Madina1219/ConnectGuinea/docs/Madina Diallo CE Exhibition Text.docx

CE Exhibition Text

Name: Madina Diallo

Project Title: Smart Solar Community Totem: (Lighting and Flood Communication for Rural Guinea)

The Smart Solar Community Totem is a solar-powered light designed for communities in Guinea, West Africa, who often lack reliable power or internet. During the day, a solar panel charges a battery. At night, a light sensor switches the totem on automatically. It also listens for flood warnings sent over long-range radio, no internet needed, and changes colour to signal different conditions: white for normal lighting, and a flashing blue alert if flood risk is detected. The project explores how simple, connected technology can support safety and daily life in remote communities.

Attributions

- MSc Connected Environments, The Bartlett Centre for Advanced Spatial Analysis (CASA), UCL
- Dissertation Supervisor: Duncan Wilson
- Technical support: CE Lab, University College London
- Project developed as part of the MSc Connected Environments programme

QR code:

Work in progress

Keywords (for referencing/promotion):

- Smart Cities
- Connected Environments
- Solar Energy
- Off-Grid Communities
- Flood Warning Systems
- LoRa Communication
- Community Resilience
- Ambient Interfaces
- Human-Centred Design
- Sustainable Infrastructure
