Madina1219/ConnectGuinea/docs/Smart Street Guinea Reference List.odt

Smart Street Guinea Reference List

- https://www.mdpi.com/1424-8220/25/17/5579
- https://www.smartbrighten.com/news/how-the-solar-smart-street-light-improves-the-old-city-district-infrastructure/
- https://www.dusuniot.com/blog/how-to-using-iot-in-smart-lighting/
- https://iot.tatacommunications.com/product/Smart-Light-Controller
- https://www.bimblesolar.com/solar/small-panels
- LoRaWAN® Weather Station | Solar-powered IoT Weather Station | Milesight (https://www.milesight.com/iot/product/lorawan-sensor/wts506?hsa_acc=8292105947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)
- https://www.decentlab.com/products/tipping-bucket-rain-gauge-for-lorawan
- https://envira.global/flood-monitoring-warning-system/
