Madina1219/ConnectGuinea/docs/SmartStreet Guinea Project Narrative.pdf

## Smart Guinea Solar Community Lampost:

Project narrative
In many parts of Guinea, especially informal settlements and rural communities, darkness is still part of daily life after sunset. Many streets are not connected to a reliable grid, and families often depend on torchlights, candles, or oil lamps, which are costly, unsafe, and sometimes deadly because they can cause fires and accidents. At the same time, recent floods in Guinea have shown how quickly heavy rainfall can destroy homes, displace families, flood health facilities, and disrupt everyday life. This project responds to both problems at once:
1. the need for safe light
2. the need for clear weather warning.
The idea is a smart solar streetlight totem that works as more than a lamp. It gives light to the community, but it also becomes a weather awareness point, a social meeting place, a nighttime economy enabler, and a public environmental communicator. Because many communities are off-grid or underserved by stable electricity, solar is the most practical option: it avoids the high cost and complexity of grid extension while reducing dependence on wires, fuel, and inconsistent power supply. In this setting, the light itself is a basic public service, but the totem makes that service visible, shared, and meaningful.
The place and the problem
The project is meant for communities where people already live with unstable or absent electricity, where streets go dark for hours, and where public safety drops sharply at night. In these places, the streetlight is not just infrastructure; it becomes a point of life in the neighbourhood, where people can walk safely, wait for transport, talk, trade, or gather. Guinea’s recent flood events make the need even clearer: heavy rainfall has already caused severe damage in Siguiri and Conakry, affecting tens of thousands of people and destroying homes and services.
The weather problem is not only that rain falls; it is that people often do not receive timely, easyto-understand warnings. When flooding risk rises, many households have little visual communication to tell them what is coming or what to do next. That means people can be caught unprepared, delay evacuation, protect property too late, or move through dangerous flooded areas. A streetlight totem can fill that gap by turning weather information into something people see, hear, and act on immediately.
Meaning of the totem
The totem represents shared protection. It is a familiar object, placed in a place people already pass through, gather around, and trust. For the community, it means safe light at night, but it also means information, caution, and connection. In a cultural sense, it fits how people already use public space in African communities: as a place for conversation, informal meetings, children’s play, board games, transport waiting points, women’s group meetings, announcements, and small evening trade.
Because the totem is solar-powered, it keeps working even when the grid is down. That matters in Guinea, where many households still spend long hours in darkness and rely on unsafe lighting alternatives. The solar system also helps reduce operating costs and maintenance issues associated with conventional street lighting. In simple terms, it is a light that does not wait for the grid before helping the community.

Weather awareness function
The totem can carry a weather awareness system that uses light and sound to communicate heavy rainfall, flood risk, and urgency. For example, normal white light can indicate safe conditions, flashing amber can indicate caution, and red flashing with a sound alert can warn of dangerous rainfall or potential flooding. This makes the warning easy to understand even for people who may not read a text message or who are outside when the weather changes.
This matters because flood damage in Guinea has been severe and widespread, affecting neighbourhoods, households, and health facilities. A public warning system mounted on a streetlight can help people make faster decisions: moving vehicles, protecting goods, avoiding low-lying paths, checking on children, and preparing to evacuate if needed. It turns weather data into action at the community level.
Community value
A smart solar streetlight totem does not only serve emergencies. It can become the center of evening life: a place where people meet, vendors stay open longer, phone charging may be available, local notices can be shared, and children can play safely under light. For women’s groups, neighbourhood associations, and youth activities, it can create a reliable meeting point that does not depend on household electricity. That is important because light changes how a community uses space after dark.
It also supports the night economy. When a street is lit, small businesses can stay open longer, transport becomes easier to manage, and customers feel safer moving around. In this way, the totem is not only a utility object; it is a local economic asset and a sign that the community is seen, valued, and protected.
Closing idea
This project is about turning one point of light into many forms of support. It provides safety, gathering space, local economy, and clear weather communication in one place. In Guinea, where flooding risk is real and electricity remains unreliable in many areas, a smart solar streetlight totem can help communities live with more dignity, more safety, and more readiness. It is a simple idea with a powerful meaning: light that protects, informs, and brings people together.
