Madina1219/ConnectGuinea/Dissertation Support and Additional Information/Design/Figure 3.1-Overall system architecture of the Smart Community Totem.png

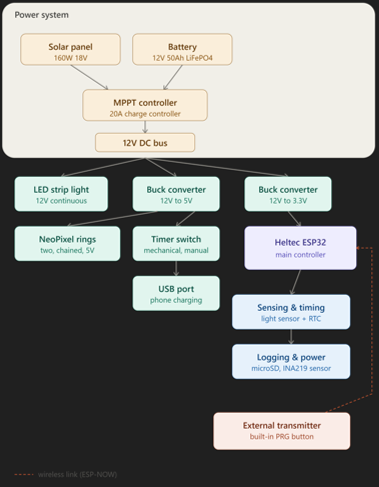
Dissertation Support and Additional Information/Design/Figure 3.1-Overall system architecture of the Smart Community Totem.png
