Madina1219/ConnectGuinea/Dissertation Support and Additional Information/Design/Figure 3.3-Prototype ESP-NOW communication architecture.png

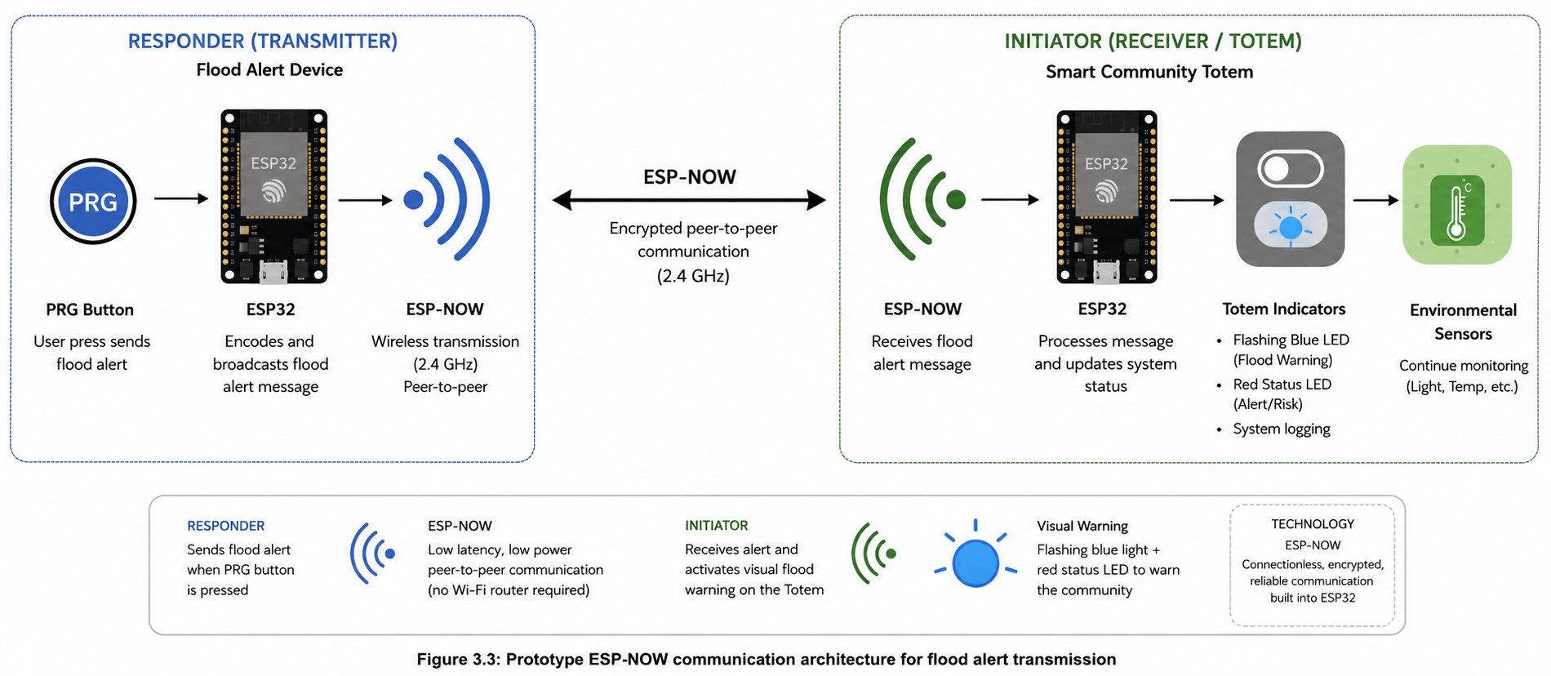
Dissertation Support and Additional Information/Design/Figure 3.3-Prototype ESP-NOW communication architecture.png
