Madina1219/ConnectGuinea/Dissertation Support and Additional Information/Design/Figure 3.4-Conceptual future communication architecture showing how flood warnings generated by meteorological and environmental monitor.png

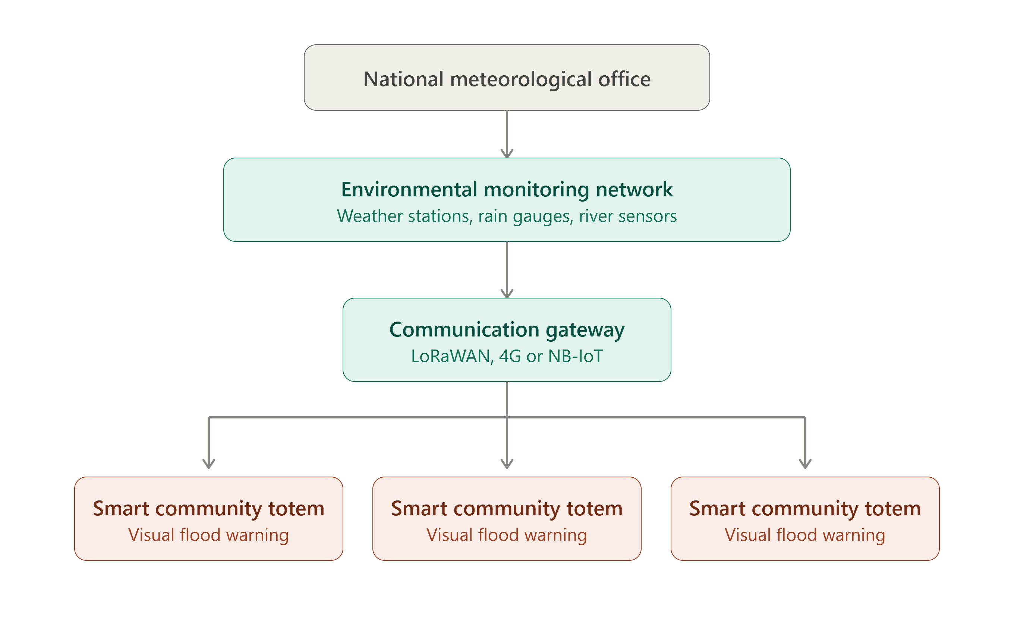
Dissertation Support and Additional Information/Design/Figure 3.4-Conceptual future communication architecture showing how flood warnings generated by meteorological and environmental monitor.png
