Madina1219/ConnectGuinea/Dissertation Support and Additional Information/Design/Figure 3.5-Electrical schematic of the Smart Community Totem.png

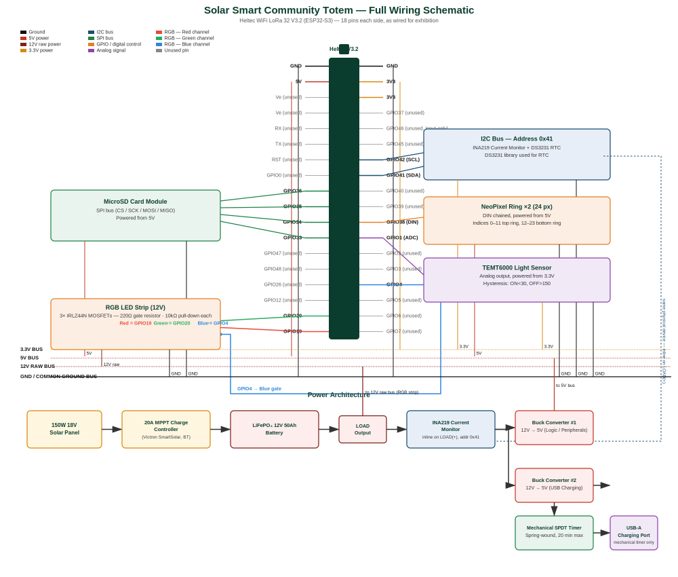
Dissertation Support and Additional Information/Design/Figure 3.5-Electrical schematic of the Smart Community Totem.png
