Madina1219/ConnectGuinea/Dissertation Support and Additional Information/Design/Table 3.1-Design requirements and corresponding implementation.png

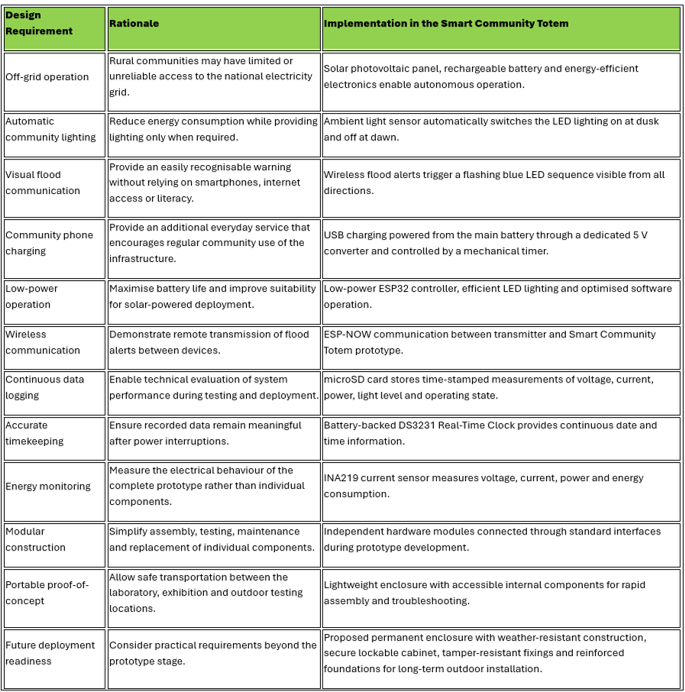
Dissertation Support and Additional Information/Design/Table 3.1-Design requirements and corresponding implementation.png
