Madina1219/ConnectGuinea/Dissertation Support and Additional Information/Design/Table 3.2-Energy Monitoring and Data Collection.png

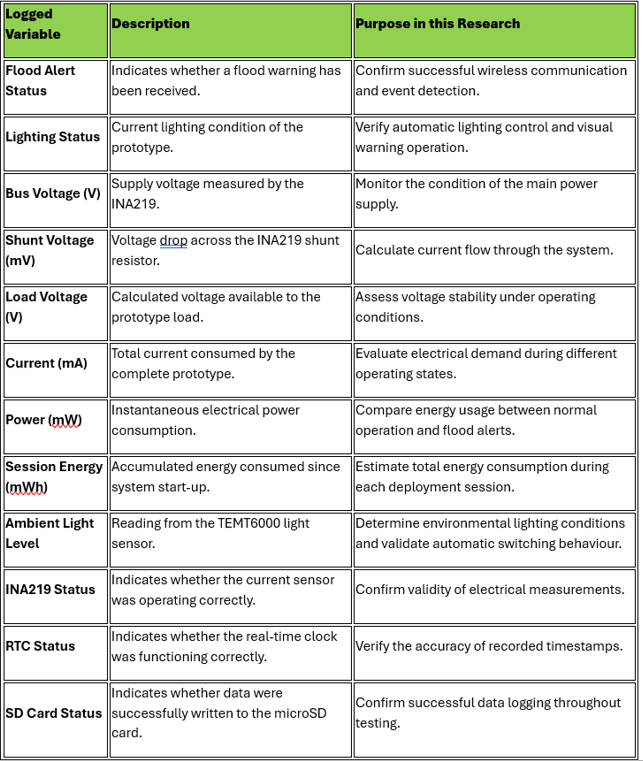
Dissertation Support and Additional Information/Design/Table 3.2-Energy Monitoring and Data Collection.png
