Madina1219/ConnectGuinea/Dissertation Support and Additional Information/Implementation/2 Locations Comparision Summary.png

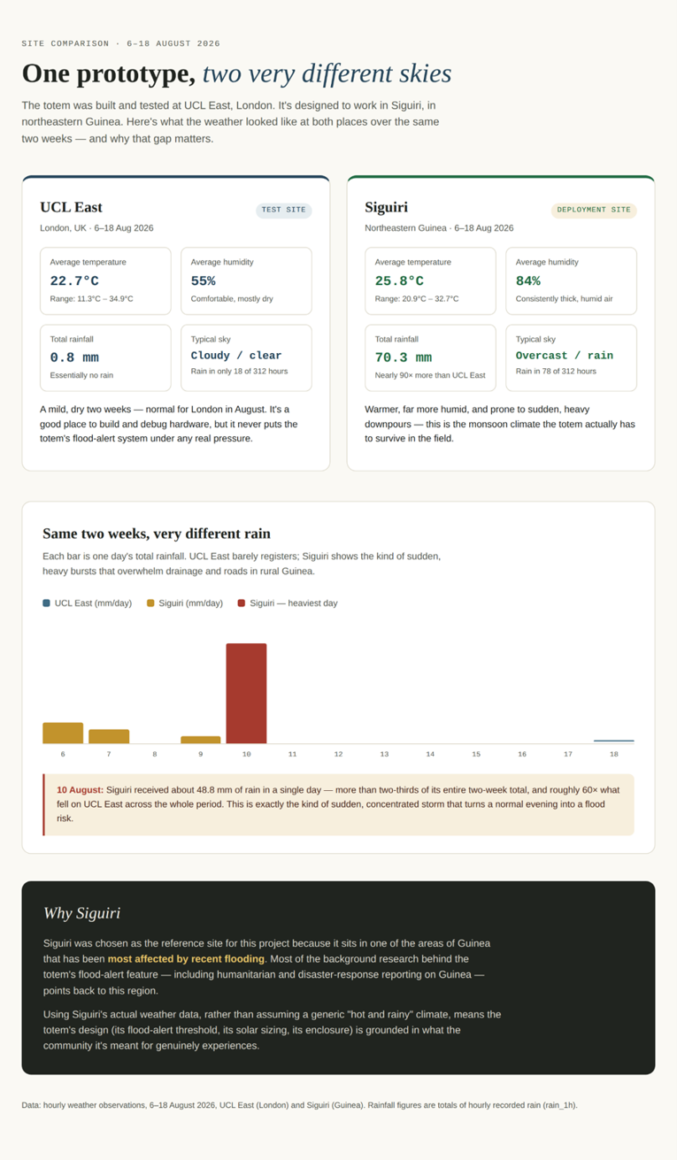
Dissertation Support and Additional Information/Implementation/2 Locations Comparision Summary.png
