Madina1219/ConnectGuinea/Dissertation Support and Additional Information/Implementation/Figure 4.1-Completed Smart Community Totem prototype.png

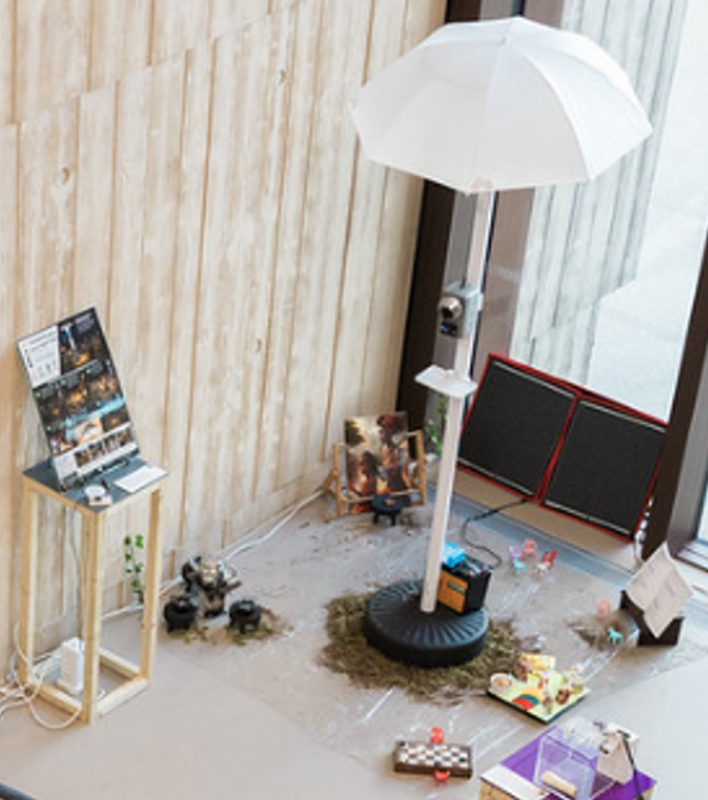
Dissertation Support and Additional Information/Implementation/Figure 4.1-Completed Smart Community Totem prototype.png
