Madina1219/ConnectGuinea/Dissertation Support and Additional Information/Implementation/Final Prototype 2.png

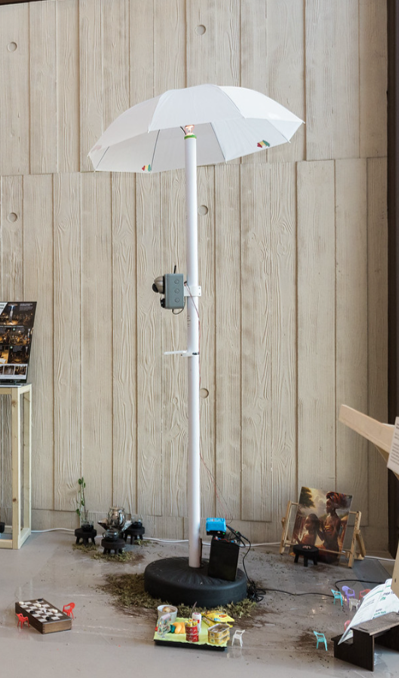
Dissertation Support and Additional Information/Implementation/Final Prototype 2.png
