Madina1219/ConnectGuinea/Dissertation Support and Additional Information/Implementation/Totem Software Detailed Flowchart.png

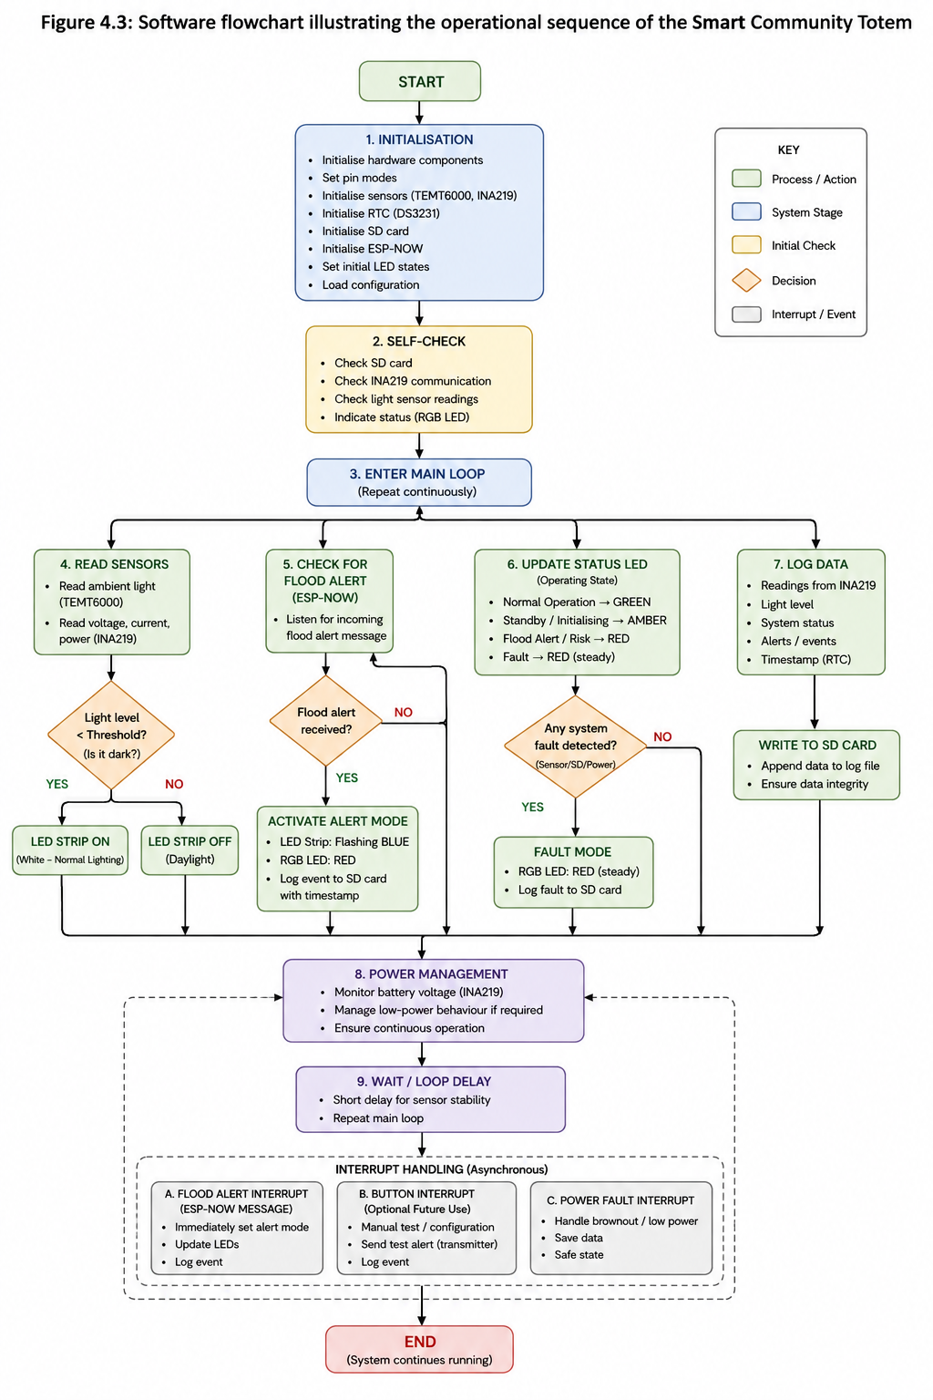
Dissertation Support and Additional Information/Implementation/Totem Software Detailed Flowchart.png
