Madina1219/ConnectGuinea/Dissertation Support and Additional Information/Introduction/Figure 1.1-National Context of Guinea Showing Regional Electricity Access and Flood-Prone Areas..jpg

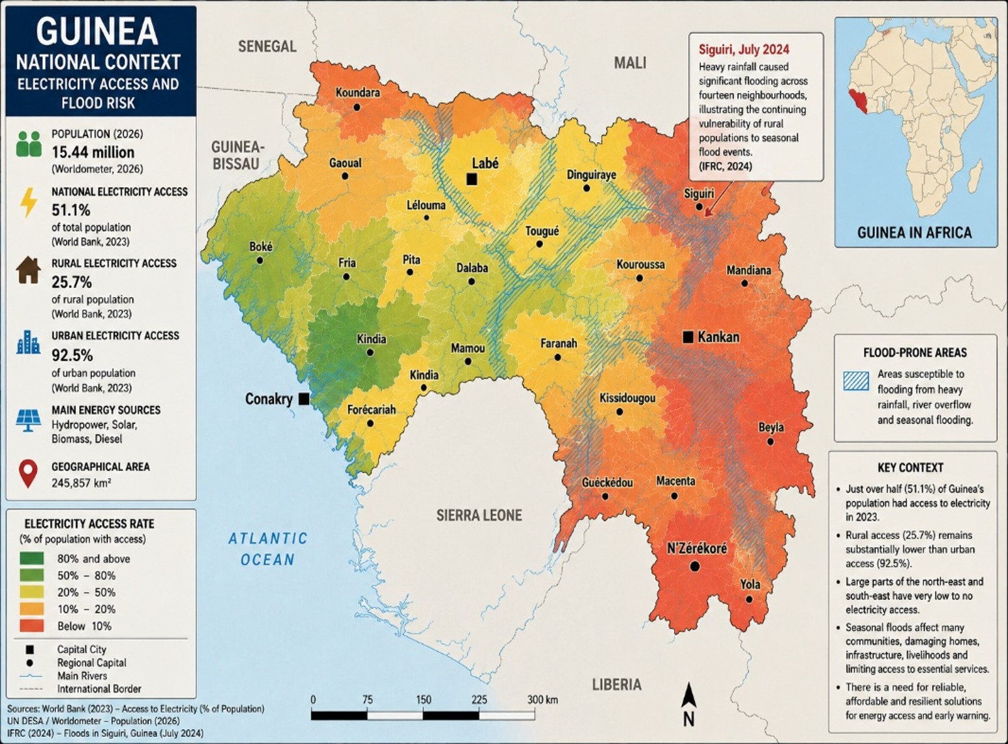
Dissertation Support and Additional Information/Introduction/Figure 1.1-National Context of Guinea Showing Regional Electricity Access and Flood-Prone Areas..jpg
