Madina1219/ConnectGuinea/Dissertation Support and Additional Information/Litterature Review/2.4-Smart Public Lighting from Chiradeja and Yoomak.png

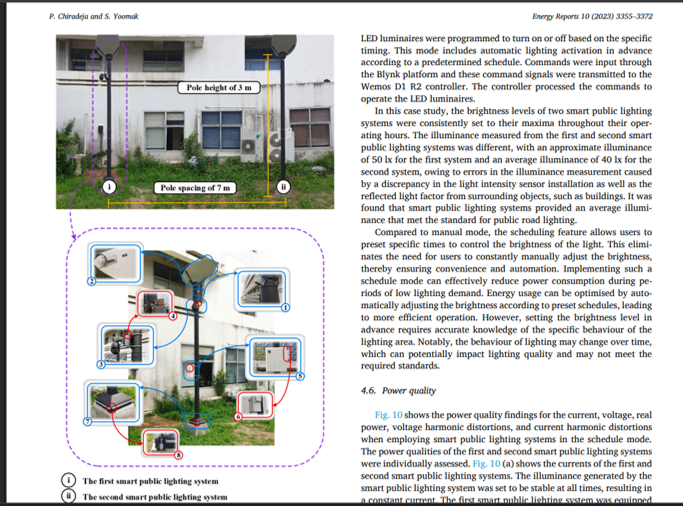
Dissertation Support and Additional Information/Litterature Review/2.4-Smart Public Lighting from Chiradeja and Yoomak.png
