Madina1219/ConnectGuinea/Dissertation Support and Additional Information/Litterature Review/Figure 2.1-Multifunctional lighting architecture LoRaCELL schematics for data collection and processing workflow.jpg

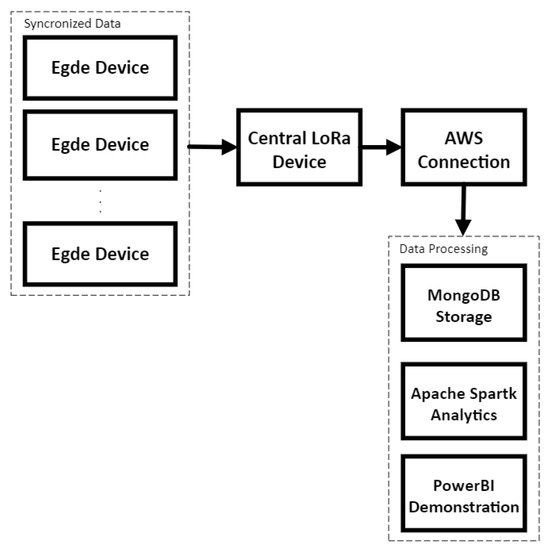
Dissertation Support and Additional Information/Litterature Review/Figure 2.1-Multifunctional lighting architecture LoRaCELL schematics for data collection and processing workflow.jpg
