Madina1219/ConnectGuinea/Dissertation Support and Additional Information/Litterature Review/Figure 2.2-Four-pillar early-warning framework adapted from the WMO..png

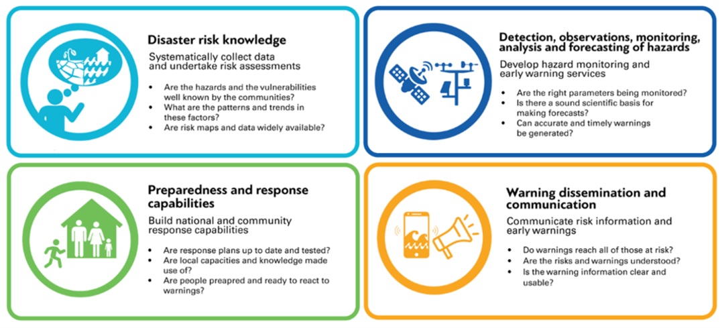
Dissertation Support and Additional Information/Litterature Review/Figure 2.2-Four-pillar early-warning framework adapted from the WMO..png
