Madina1219/ConnectGuinea/Dissertation Support and Additional Information/Litterature Review/Figure 2.3-Community-centred flood-warning framework adapted from Yasmin et al. (2023).png

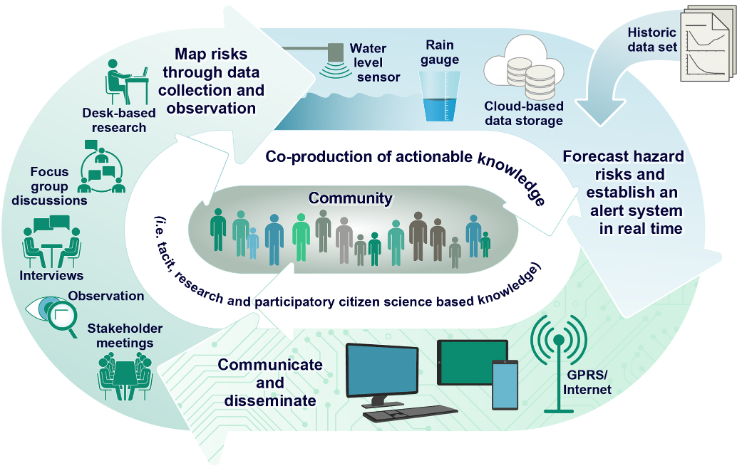
Dissertation Support and Additional Information/Litterature Review/Figure 2.3-Community-centred flood-warning framework adapted from Yasmin et al. (2023).png
