Madina1219/ConnectGuinea/Dissertation Support and Additional Information/Litterature Review/Figure 2.4-Example of a multifunctional smart public lighting system.png

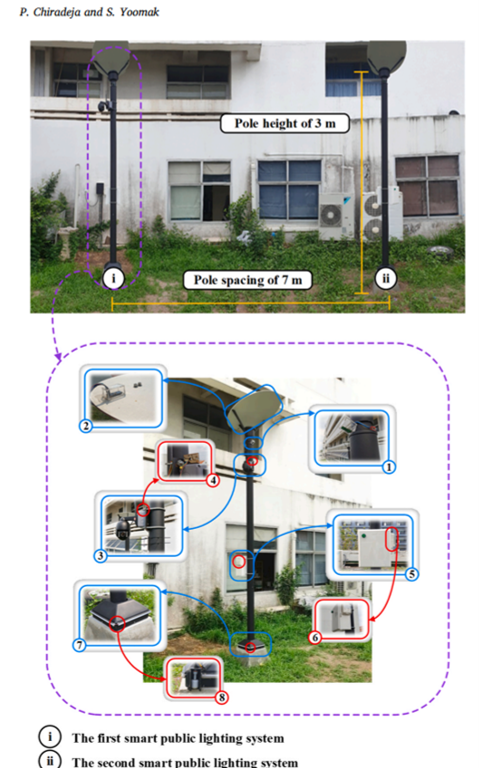
Dissertation Support and Additional Information/Litterature Review/Figure 2.4-Example of a multifunctional smart public lighting system.png
