Madina1219/ConnectGuinea/Dissertation Support and Additional Information/Litterature Review/Figure 2.5-MinebeaMitsumi's smart streetlight with wireless connectivity and environmental sensor module.png

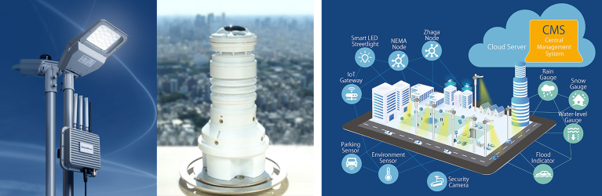
Dissertation Support and Additional Information/Litterature Review/Figure 2.5-MinebeaMitsumi's smart streetlight with wireless connectivity and environmental sensor module.png
