Madina1219/ConnectGuinea/Dissertation Support and Additional Information/Litterature Review/Figure 2.6-Solar-powered LED streetlight system from Gandhimathi et al. (2024)..png

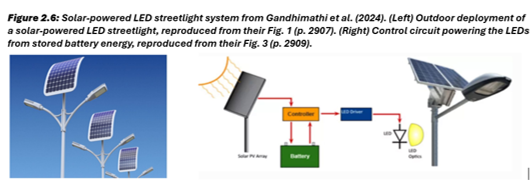
Dissertation Support and Additional Information/Litterature Review/Figure 2.6-Solar-powered LED streetlight system from Gandhimathi et al. (2024)..png
