Madina1219/ConnectGuinea/Dissertation Support and Additional Information/Litterature Review/Table 2.1-Comparison of Flood-Warning Communication Methods..png

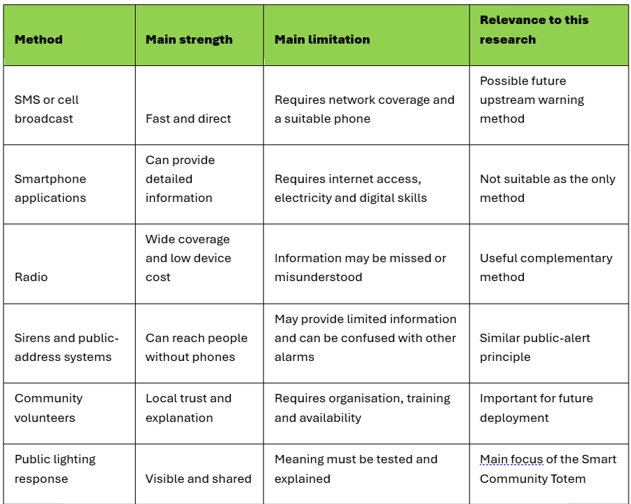
Dissertation Support and Additional Information/Litterature Review/Table 2.1-Comparison of Flood-Warning Communication Methods..png
