Madina1219/ConnectGuinea/Dissertation Support and Additional Information/Litterature Review/Table 2.2-Comparison of communication technologies..png

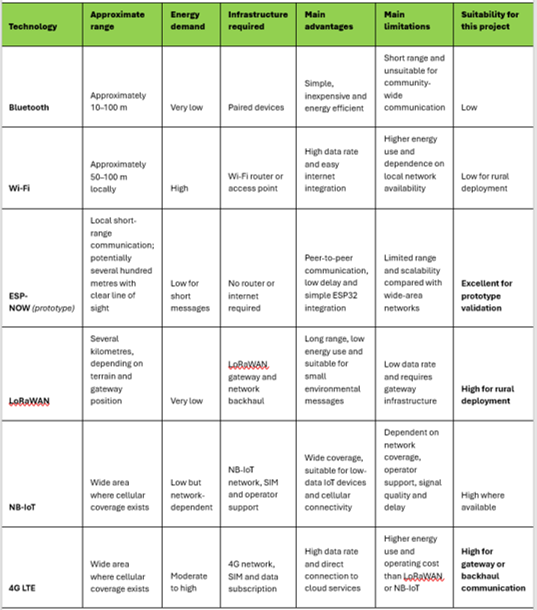
Dissertation Support and Additional Information/Litterature Review/Table 2.2-Comparison of communication technologies..png
