Madina1219/ConnectGuinea/Dissertation Support and Additional Information/Litterature Review/Table 2.3-Comparison of some existing smart public infrastructure approaches and the proposed Smart Community Totem references.png

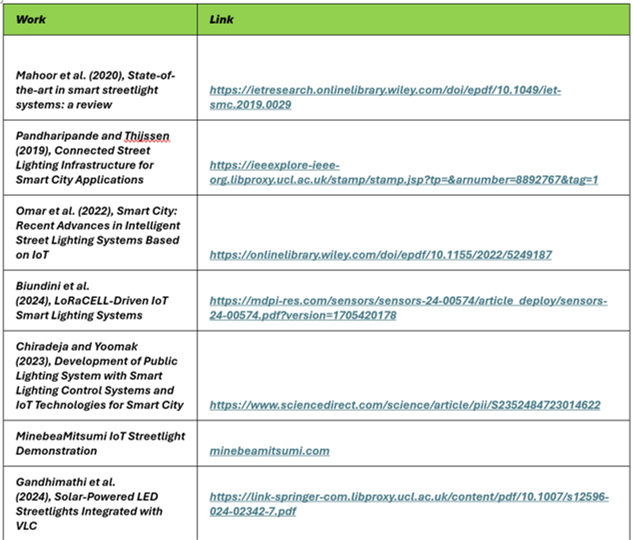
Dissertation Support and Additional Information/Litterature Review/Table 2.3-Comparison of some existing smart public infrastructure approaches and the proposed Smart Community Totem references.png
