Madina1219/ConnectGuinea/docs/Guinea Light Beacon Story Board.png

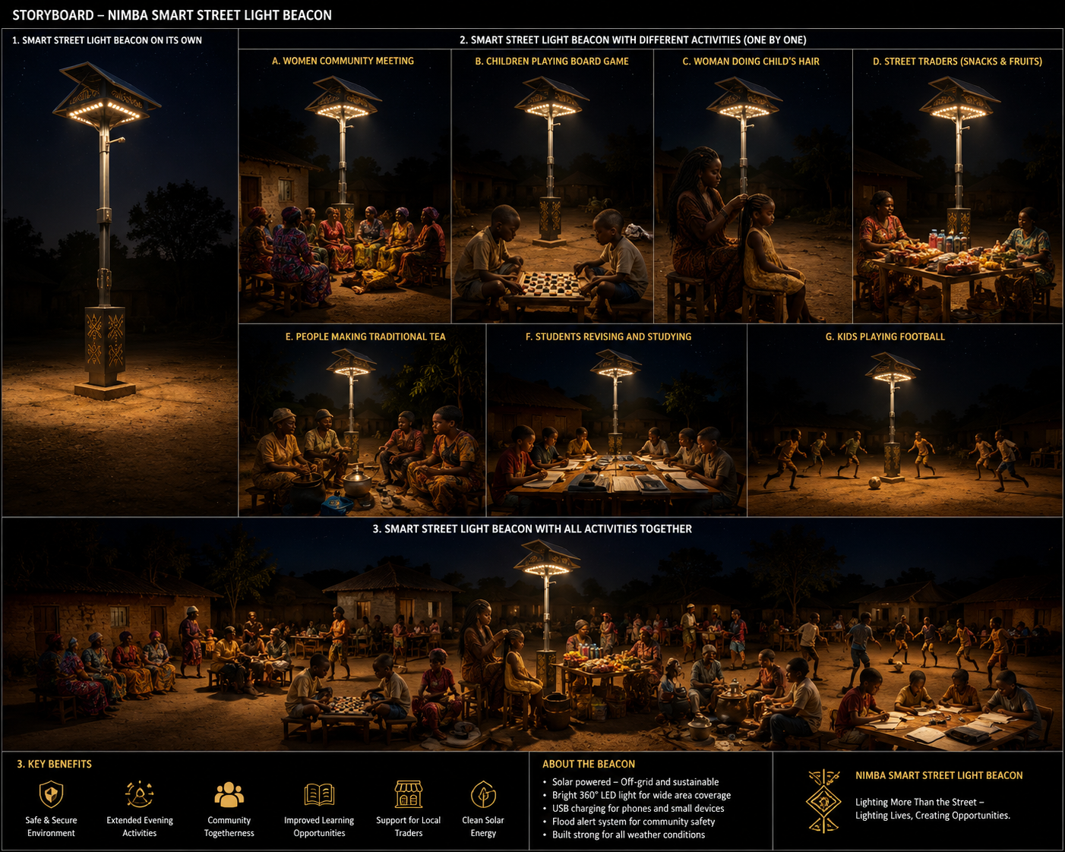
docs/Guinea Light Beacon Story Board.png
