Madina1219/ConnectGuinea/Docs/Images activities around Light and flood in Africa/1d6db9b5-cdf9-40cd-8955-02f7cf92a439.jpeg

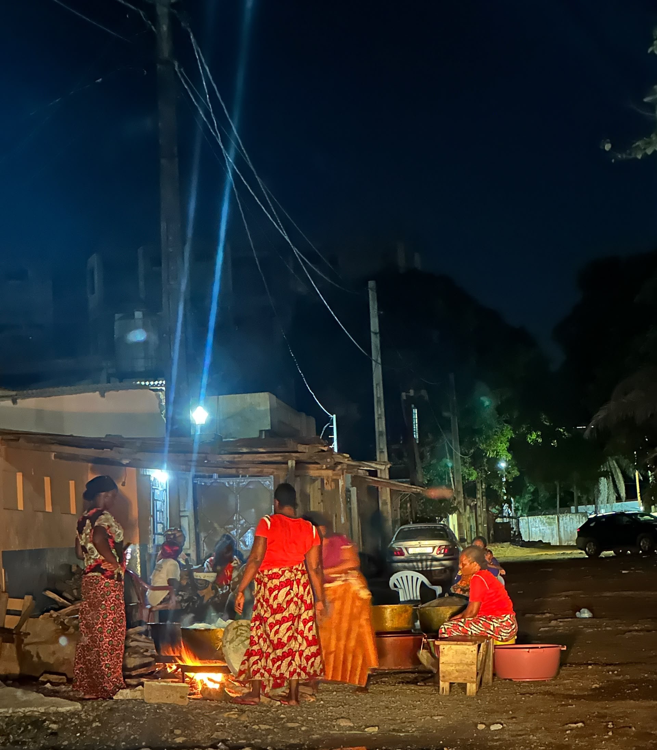
Docs/Images activities around Light and flood in Africa/1d6db9b5-cdf9-40cd-8955-02f7cf92a439.jpeg
