Madina1219/ConnectGuinea/Docs/Images activities around Light and flood in Africa/1e4fc215-ab63-423a-94a4-3ebc819668d7.jpeg

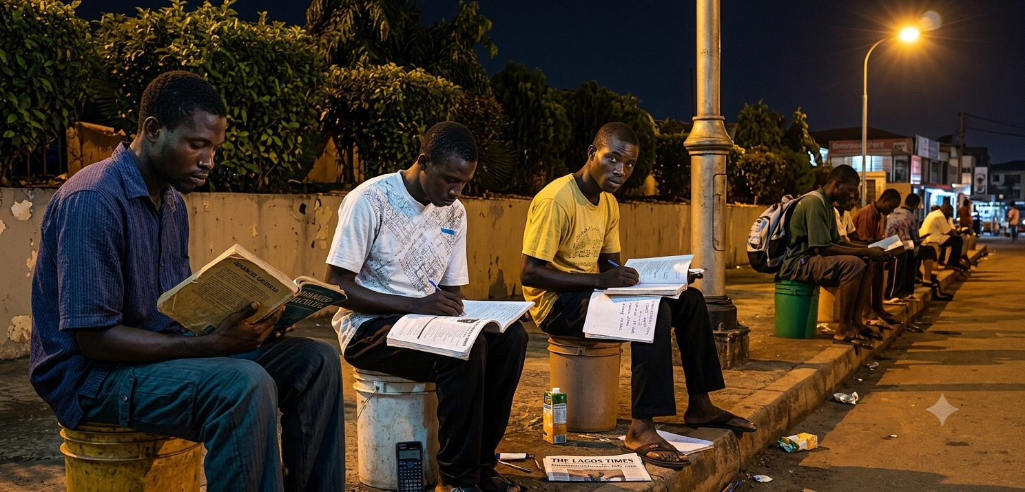
Docs/Images activities around Light and flood in Africa/1e4fc215-ab63-423a-94a4-3ebc819668d7.jpeg
