Madina1219/ConnectGuinea/Docs/Images activities around Light and flood in Africa/2d769b41-d59f-4d8b-b6eb-f62d14bc10e0.jpeg

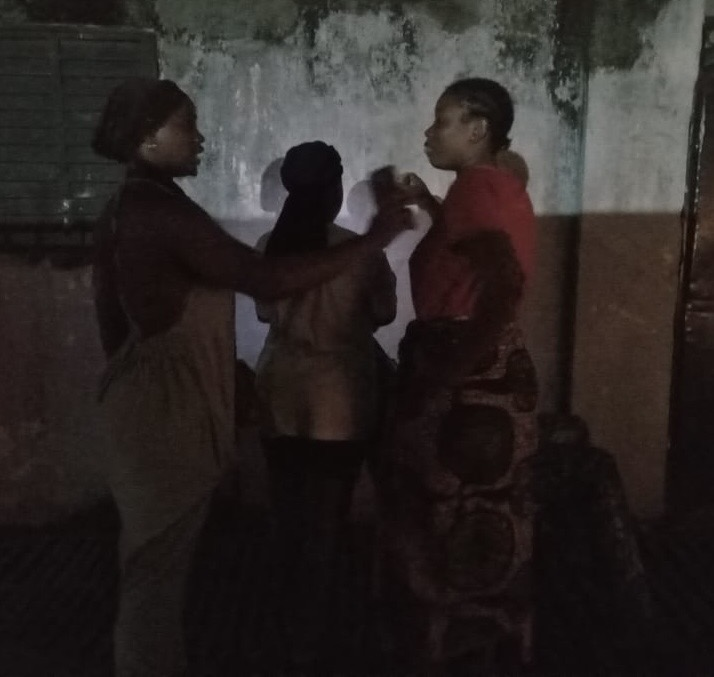
Docs/Images activities around Light and flood in Africa/2d769b41-d59f-4d8b-b6eb-f62d14bc10e0.jpeg
