Madina1219/ConnectGuinea/Docs/Images activities around Light and flood in Africa/2F320DCF-0008-40C8-98FC-AA390BA36029.jpeg

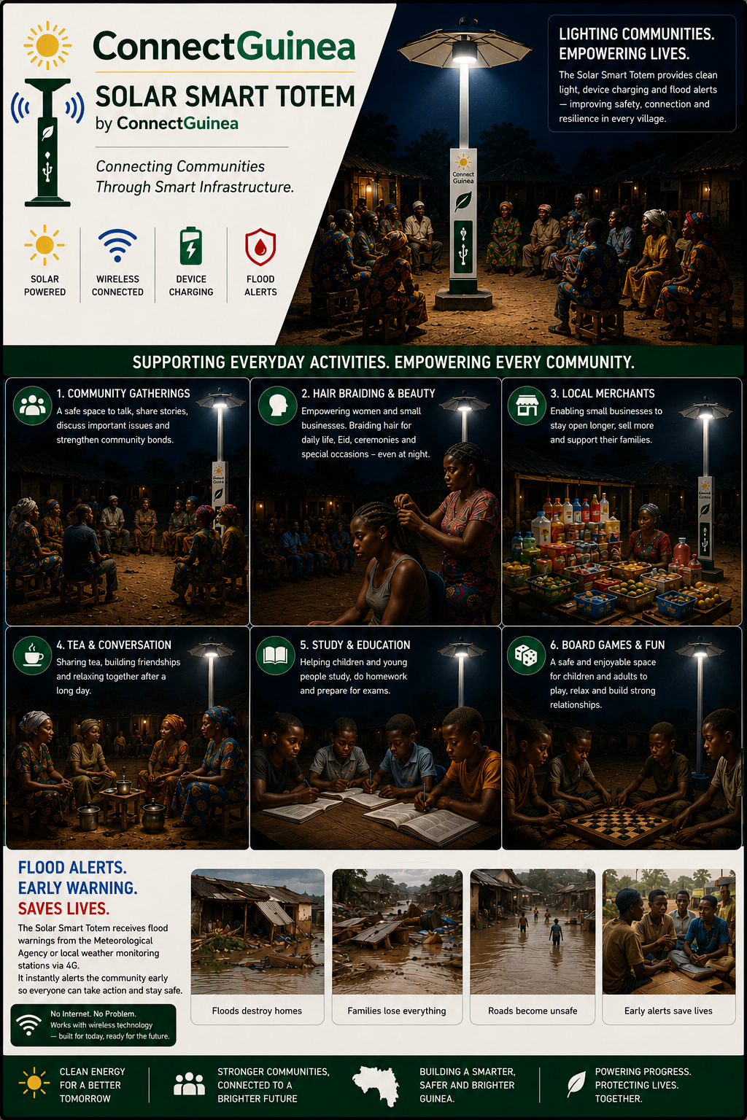
Docs/Images activities around Light and flood in Africa/2F320DCF-0008-40C8-98FC-AA390BA36029.jpeg
