Madina1219/ConnectGuinea/Docs/Images activities around Light and flood in Africa/2f36139e-39d8-4727-b974-38dccddaca19.jpeg

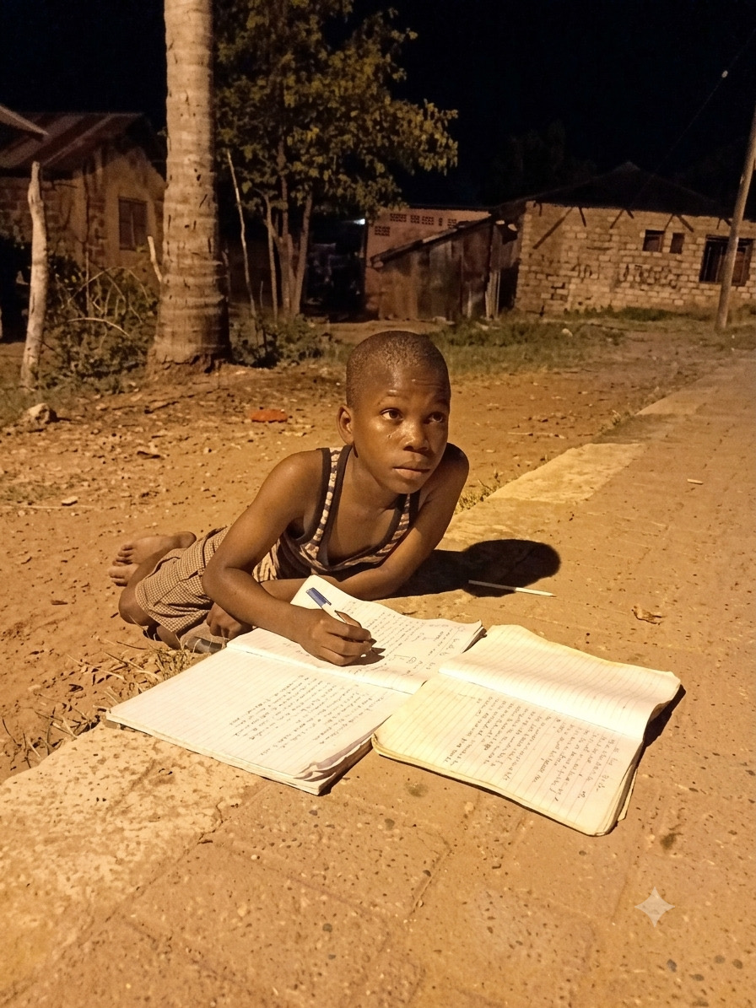
Docs/Images activities around Light and flood in Africa/2f36139e-39d8-4727-b974-38dccddaca19.jpeg
