Madina1219/ConnectGuinea/Docs/Images activities around Light and flood in Africa/3a455760-b7ef-41bf-94f5-ff502b3b23ac.jpeg

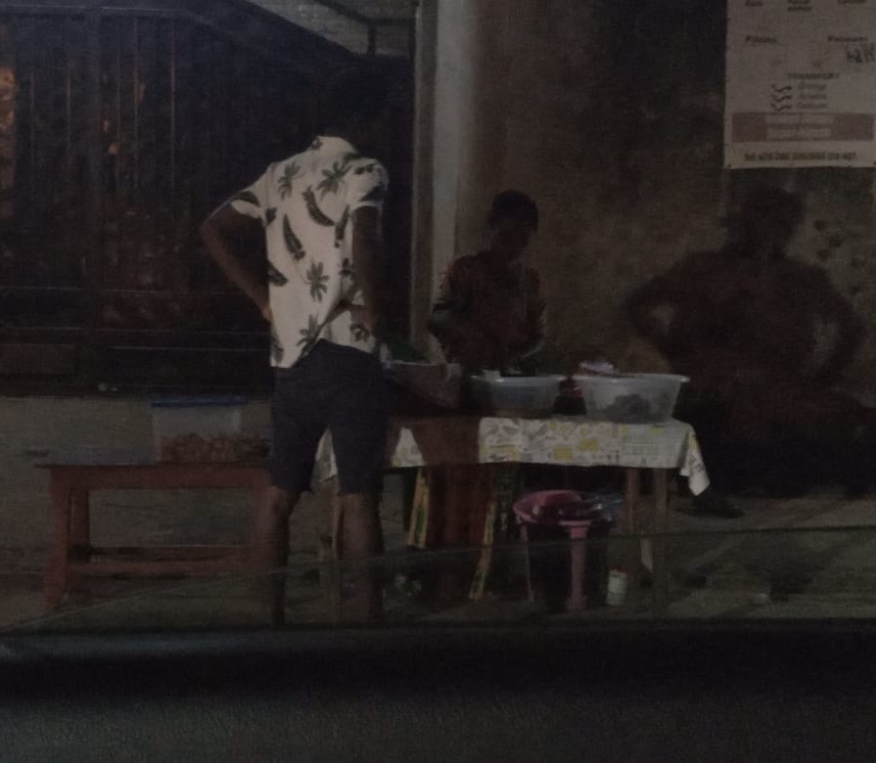
Docs/Images activities around Light and flood in Africa/3a455760-b7ef-41bf-94f5-ff502b3b23ac.jpeg
