Madina1219/ConnectGuinea/Docs/Images activities around Light and flood in Africa/6c3debed-7885-4816-8966-f9a82740eac7.jpeg

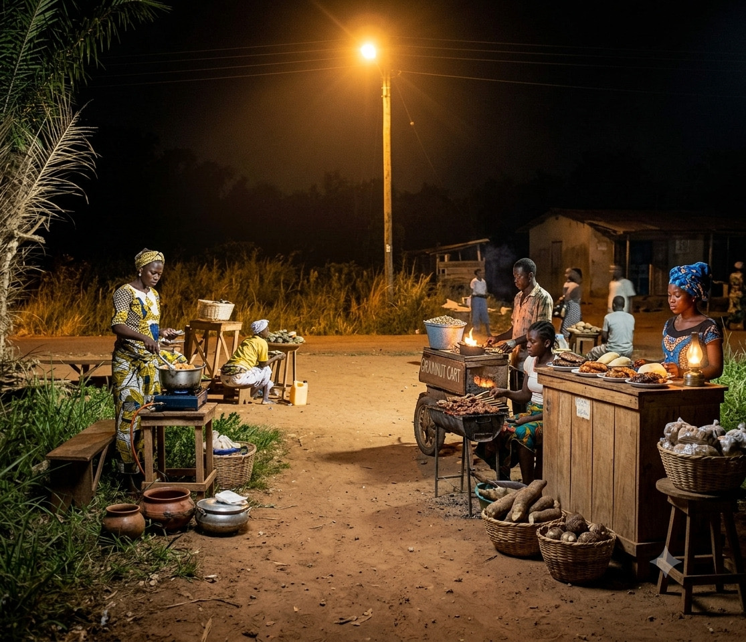
Docs/Images activities around Light and flood in Africa/6c3debed-7885-4816-8966-f9a82740eac7.jpeg
