Madina1219/ConnectGuinea/Docs/Images activities around Light and flood in Africa/61ba1543-ff26-4506-a8ce-71ede015ada2.jpeg

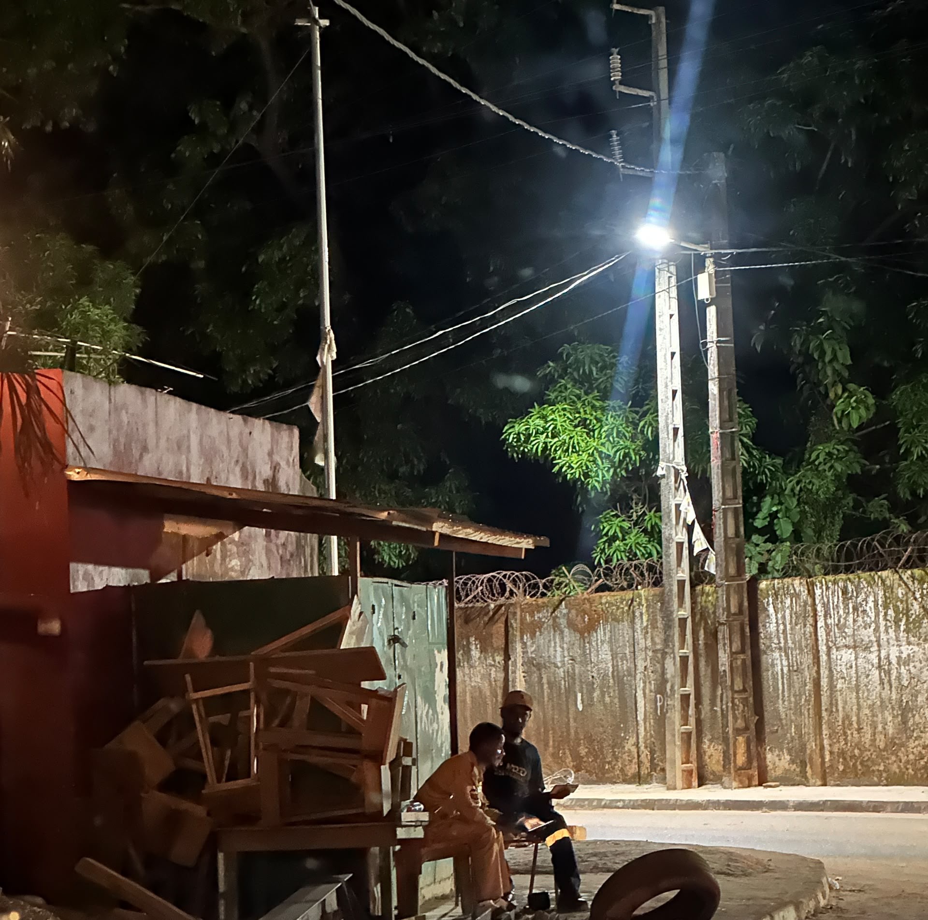
Docs/Images activities around Light and flood in Africa/61ba1543-ff26-4506-a8ce-71ede015ada2.jpeg
