Madina1219/ConnectGuinea/Docs/Images activities around Light and flood in Africa/82fd1342-5b22-4227-8be3-a6ea16fd619c.jpeg

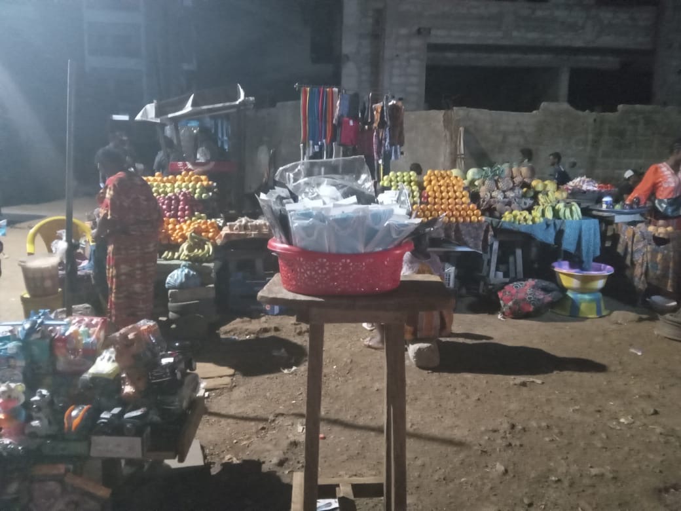
Docs/Images activities around Light and flood in Africa/82fd1342-5b22-4227-8be3-a6ea16fd619c.jpeg
