Madina1219/ConnectGuinea/Docs/Images activities around Light and flood in Africa/596cdd42-40c7-4db4-a2c8-0992c0a601c7.jpeg

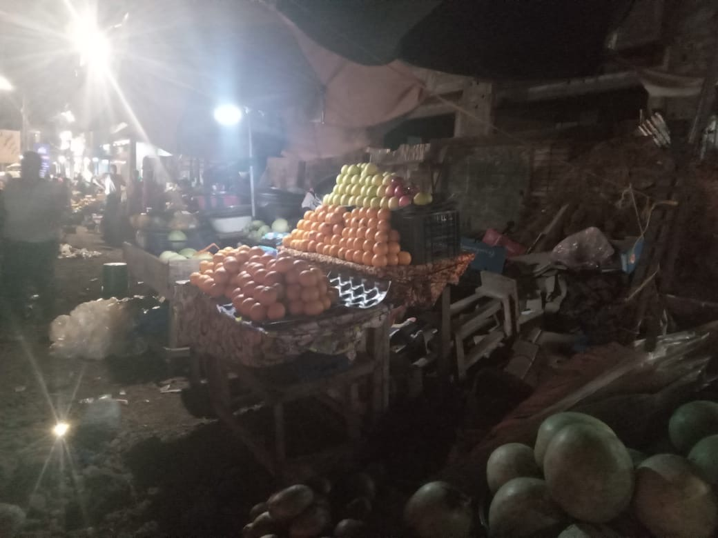
Docs/Images activities around Light and flood in Africa/596cdd42-40c7-4db4-a2c8-0992c0a601c7.jpeg
