Madina1219/ConnectGuinea/Docs/Images activities around Light and flood in Africa/774be893-710d-47c0-bfa4-2e0c8f74c482.jpeg

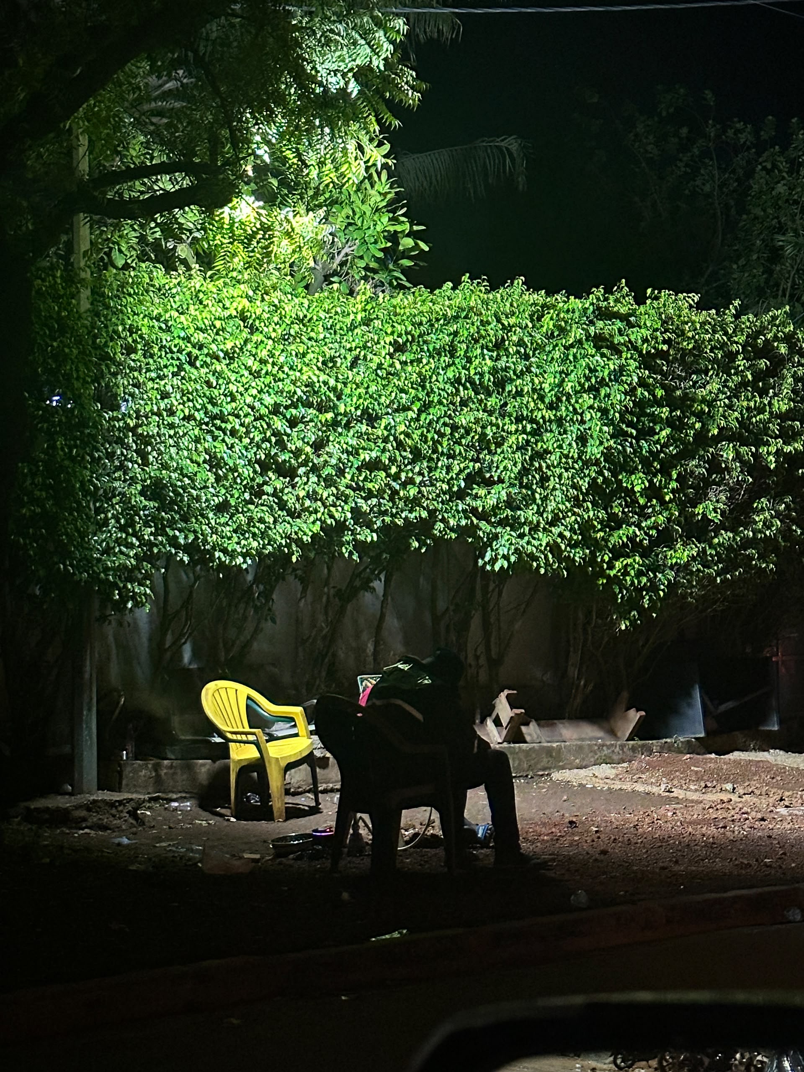
Docs/Images activities around Light and flood in Africa/774be893-710d-47c0-bfa4-2e0c8f74c482.jpeg
