Madina1219/ConnectGuinea/Docs/Images activities around Light and flood in Africa/36078f53-b5a4-4d5a-8d34-38b70161ff1b.jpeg

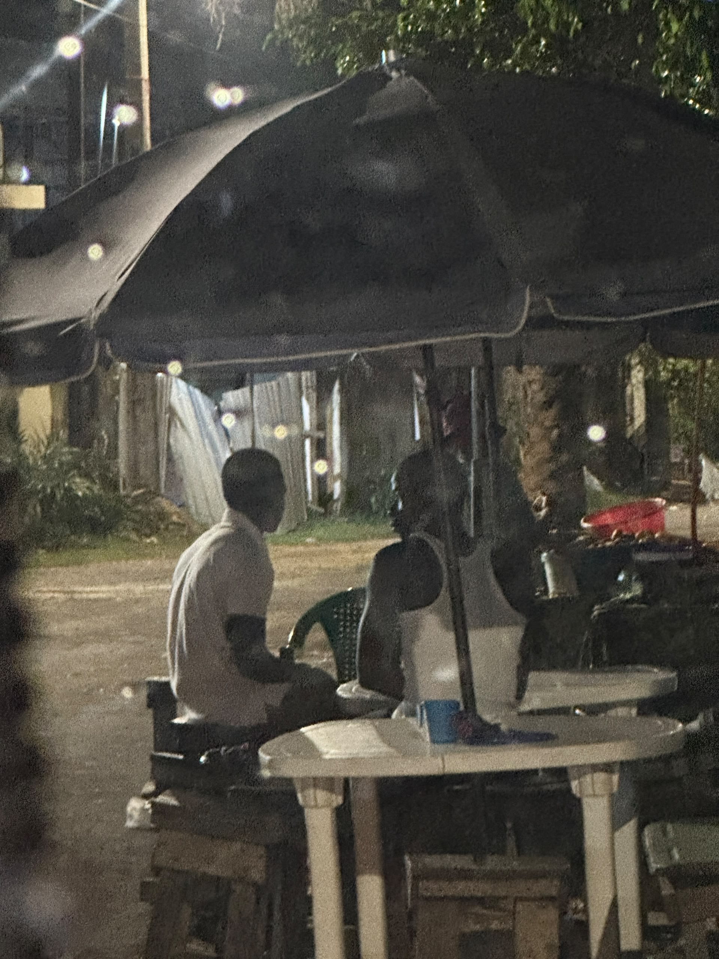
Docs/Images activities around Light and flood in Africa/36078f53-b5a4-4d5a-8d34-38b70161ff1b.jpeg
