Madina1219/ConnectGuinea/Docs/Images activities around Light and flood in Africa/Africa- Meeting.jpg

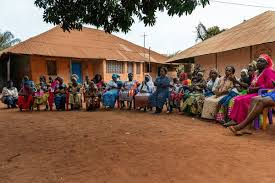
Docs/Images activities around Light and flood in Africa/Africa- Meeting.jpg
