Madina1219/ConnectGuinea/Docs/Images activities around Light and flood in Africa/ancient benin city.png

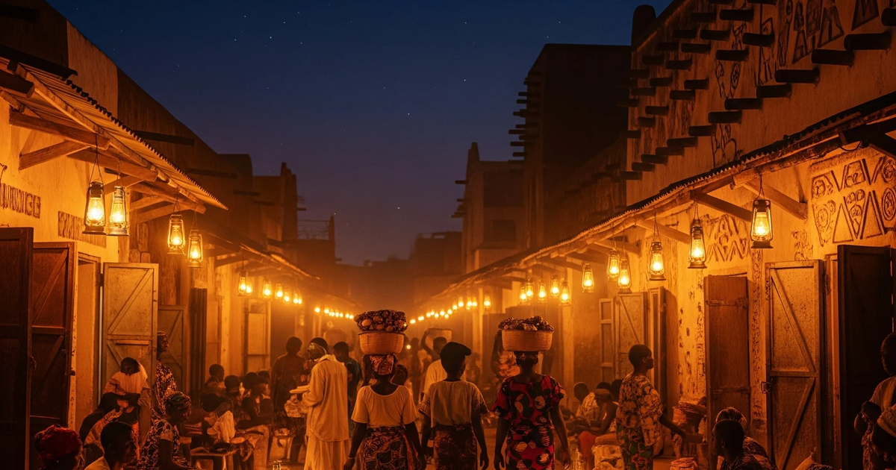
Docs/Images activities around Light and flood in Africa/ancient benin city.png
