Madina1219/ConnectGuinea/Docs/Images activities around Light and flood in Africa/baro-village-guinea-1st-may-2015-solar-powered-street-lighting-very-HFJDXH.jpg

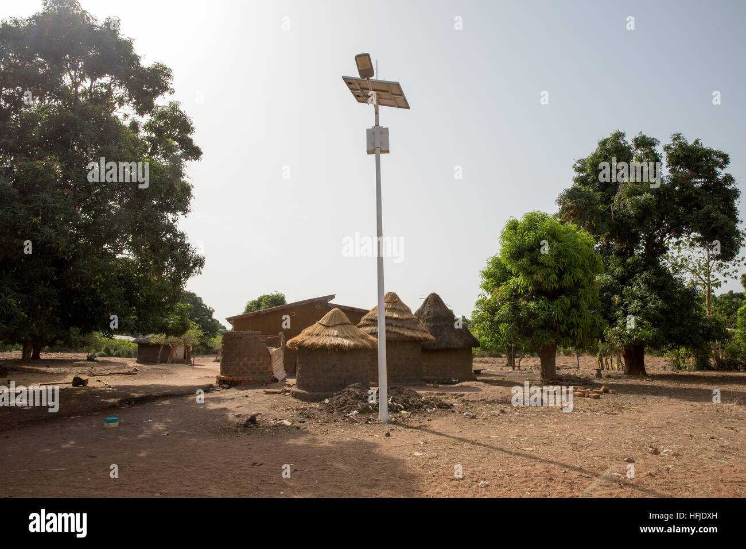
Docs/Images activities around Light and flood in Africa/baro-village-guinea-1st-may-2015-solar-powered-street-lighting-very-HFJDXH.jpg
