Madina1219/ConnectGuinea/Docs/Images activities around Light and flood in Africa/beacon_hope_celebration-10.jpg

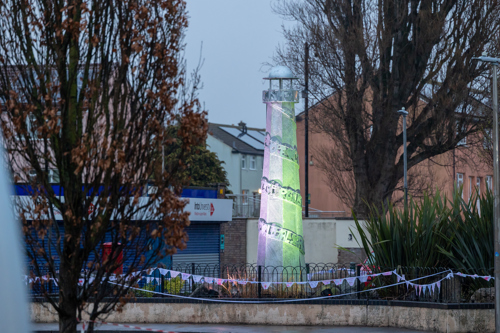
Docs/Images activities around Light and flood in Africa/beacon_hope_celebration-10.jpg
