Madina1219/ConnectGuinea/Docs/Images activities around Light and flood in Africa/cc9a9a20-ef2d-41a2-8da0-5b08c528a5b7.jpeg

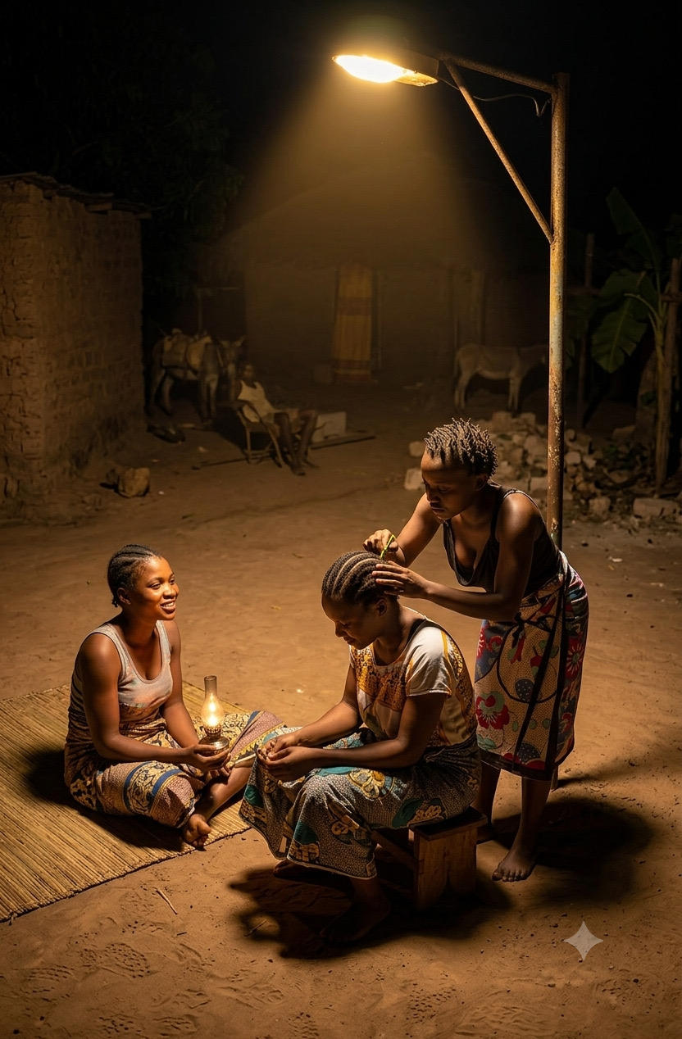
Docs/Images activities around Light and flood in Africa/cc9a9a20-ef2d-41a2-8da0-5b08c528a5b7.jpeg
