Madina1219/ConnectGuinea/Docs/Images activities around Light and flood in Africa/Community Streetlight in Guinea Bissau.jpg

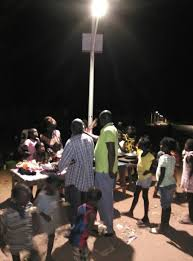
Docs/Images activities around Light and flood in Africa/Community Streetlight in Guinea Bissau.jpg
