Madina1219/ConnectGuinea/Docs/Images activities around Light and flood in Africa/d56e163e-9028-4112-8386-d6369d639b61.jpeg

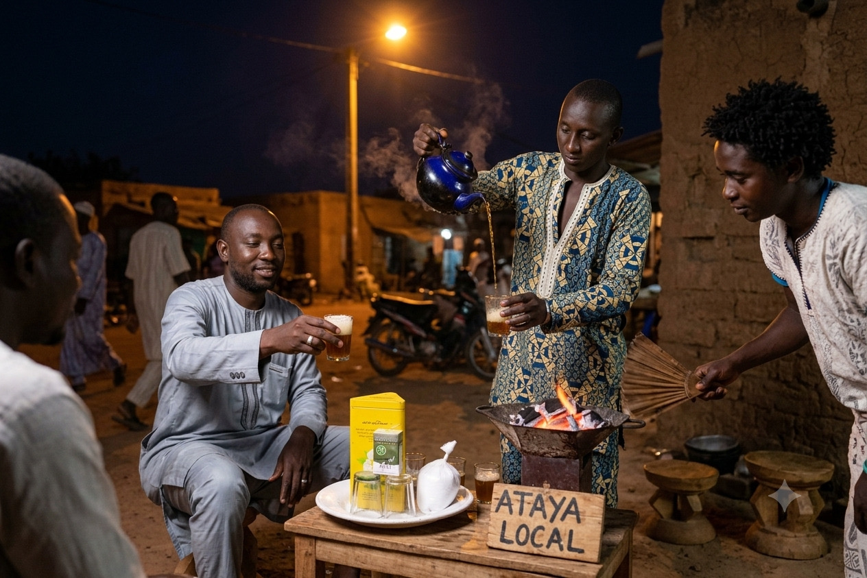
Docs/Images activities around Light and flood in Africa/d56e163e-9028-4112-8386-d6369d639b61.jpeg
