Madina1219/ConnectGuinea/Docs/Images activities around Light and flood in Africa/electricity4.jpg

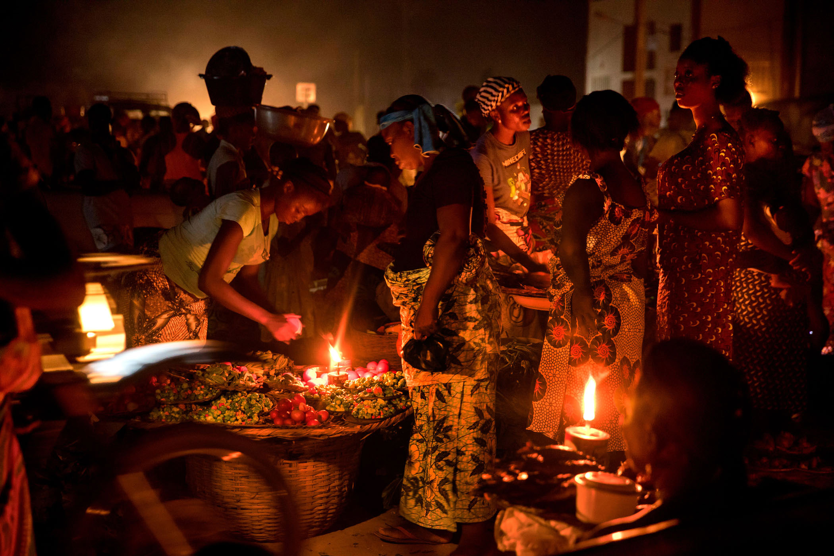
Docs/Images activities around Light and flood in Africa/electricity4.jpg
