Madina1219/ConnectGuinea/Docs/Images activities around Light and flood in Africa/fb815843-b1f0-40e1-8b14-04abdf92451a.jpeg

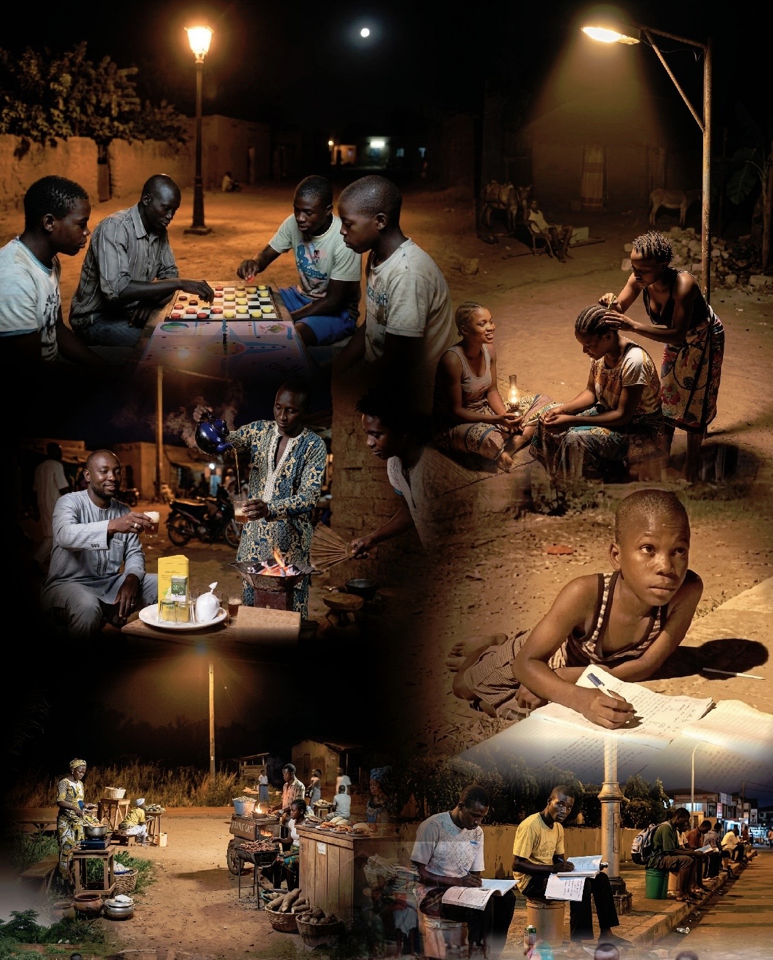
Docs/Images activities around Light and flood in Africa/fb815843-b1f0-40e1-8b14-04abdf92451a.jpeg
