Madina1219/ConnectGuinea/Docs/Images activities around Light and flood in Africa/fd02f179-1437-40e7-9ca2-8993442fec3b.jpeg

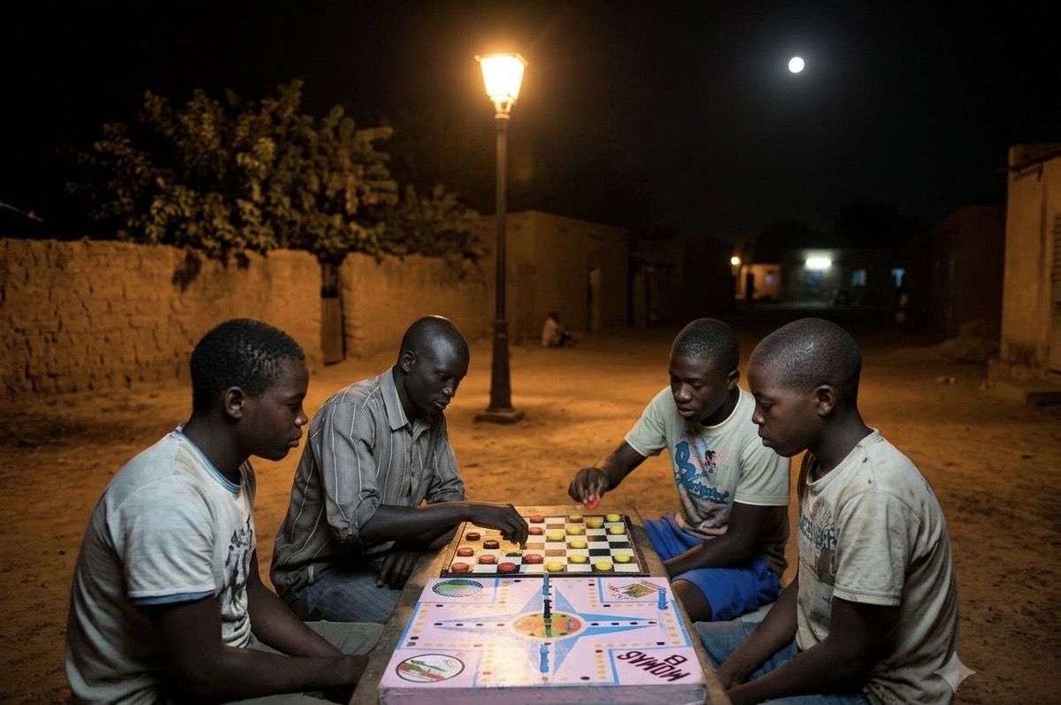
Docs/Images activities around Light and flood in Africa/fd02f179-1437-40e7-9ca2-8993442fec3b.jpeg
