Madina1219/ConnectGuinea/Docs/Images activities around Light and flood in Africa/ffe39a26-c8c4-4763-aad1-17dcdf1dcbb6.jpeg

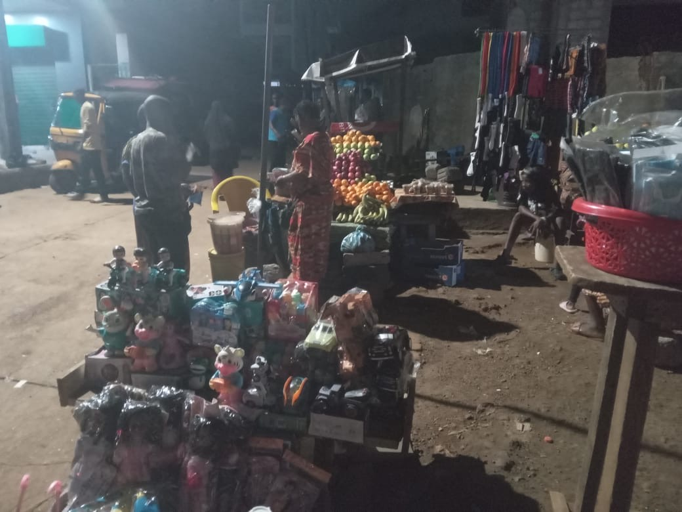
Docs/Images activities around Light and flood in Africa/ffe39a26-c8c4-4763-aad1-17dcdf1dcbb6.jpeg
