Madina1219/ConnectGuinea/Docs/Images activities around Light and flood in Africa/images.jpg

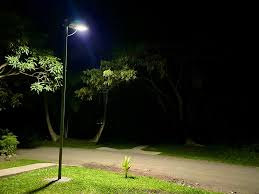
Docs/Images activities around Light and flood in Africa/images.jpg
