Madina1219/ConnectGuinea/Docs/Images activities around Light and flood in Africa/IMG_8392.jpeg

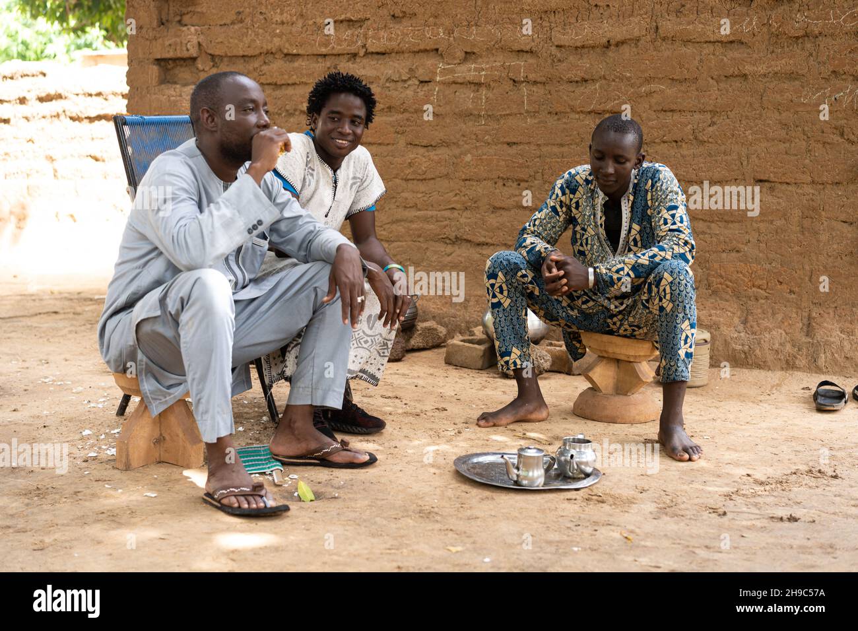
Docs/Images activities around Light and flood in Africa/IMG_8392.jpeg
