Madina1219/ConnectGuinea/Docs/Images activities around Light and flood in Africa/IMG_8408.jpeg

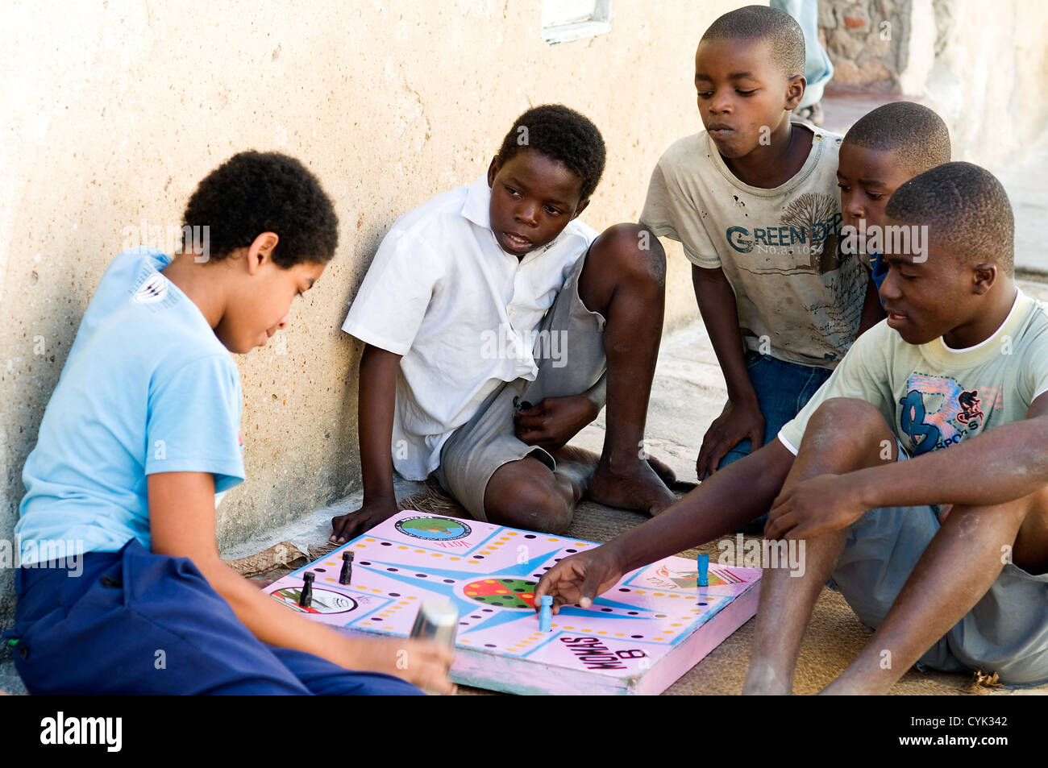
Docs/Images activities around Light and flood in Africa/IMG_8408.jpeg
