Madina1219/ConnectGuinea/Docs/Images activities around Light and flood in Africa/kids games.jpg

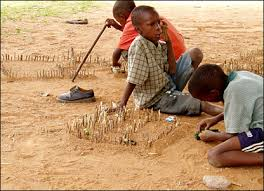
Docs/Images activities around Light and flood in Africa/kids games.jpg
