Madina1219/ConnectGuinea/Docs/Images activities around Light and flood in Africa/Lighting_Africa_Students-.jpg

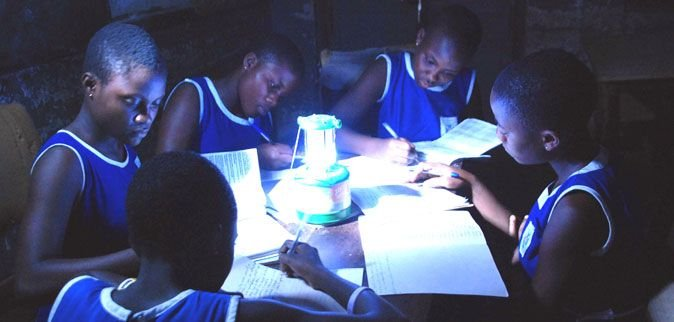
Docs/Images activities around Light and flood in Africa/Lighting_Africa_Students-.jpg
