Madina1219/ConnectGuinea/Docs/Images activities around Light and flood in Africa/national Guinea Symbol.jpg

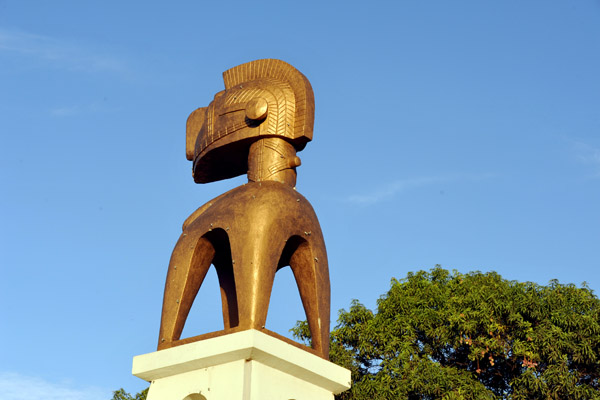
Docs/Images activities around Light and flood in Africa/national Guinea Symbol.jpg
