Madina1219/ConnectGuinea/Docs/Images activities around Light and flood in Africa/revision.jpg

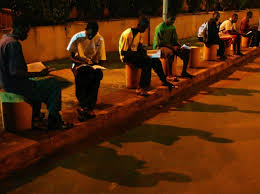
Docs/Images activities around Light and flood in Africa/revision.jpg
