Madina1219/ConnectGuinea/Docs/Images activities around Light and flood in Africa/Solar Powered Totem.jpg

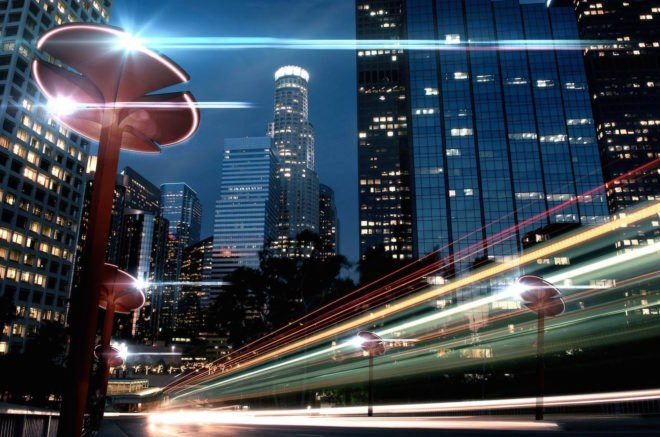
Docs/Images activities around Light and flood in Africa/Solar Powered Totem.jpg
