Madina1219/ConnectGuinea/Docs/Images activities around Light and flood in Africa/Traditional checkers outside.jpg

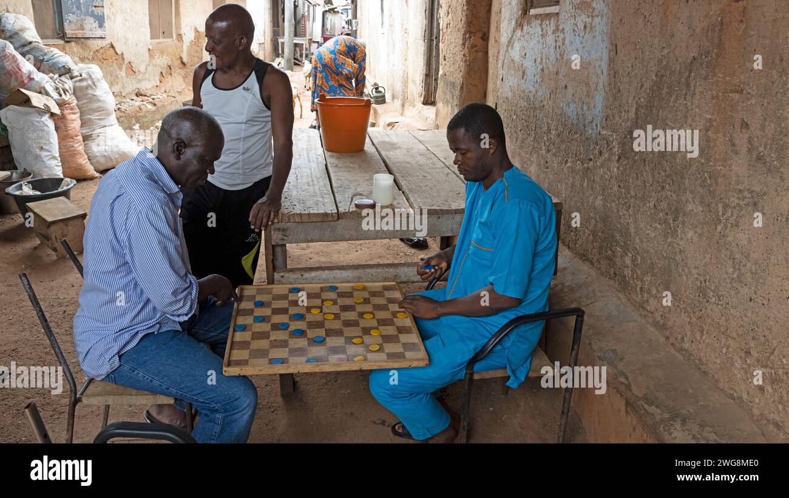
Docs/Images activities around Light and flood in Africa/Traditional checkers outside.jpg
