Madina1219/ConnectGuinea/Docs/Images activities around Light and flood in Africa/women meeting.jpg

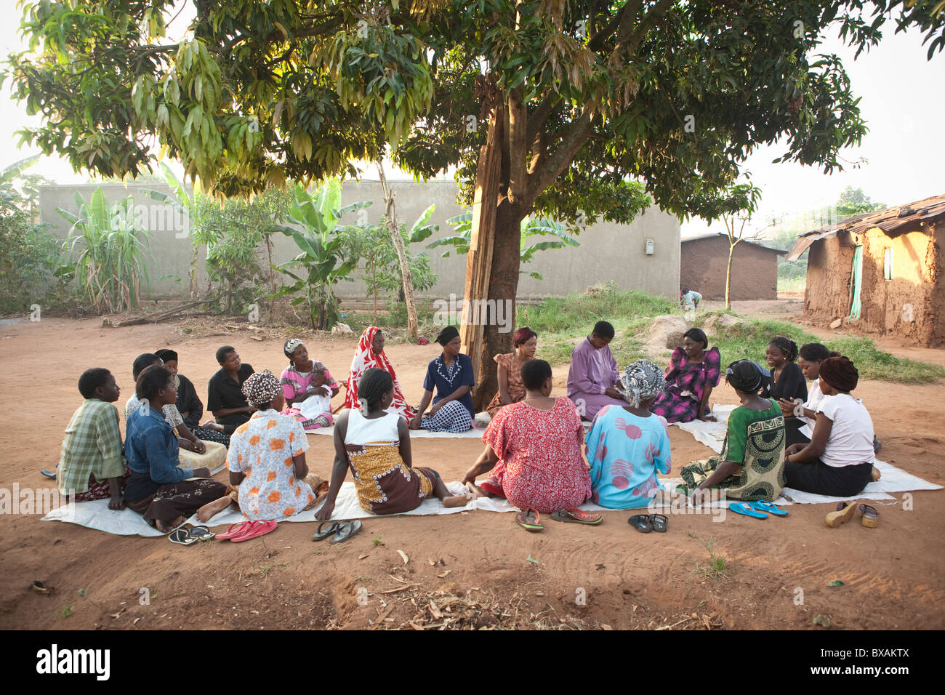
Docs/Images activities around Light and flood in Africa/women meeting.jpg
