Madina1219/ConnectGuinea/Docs/IMG_8451.jpeg

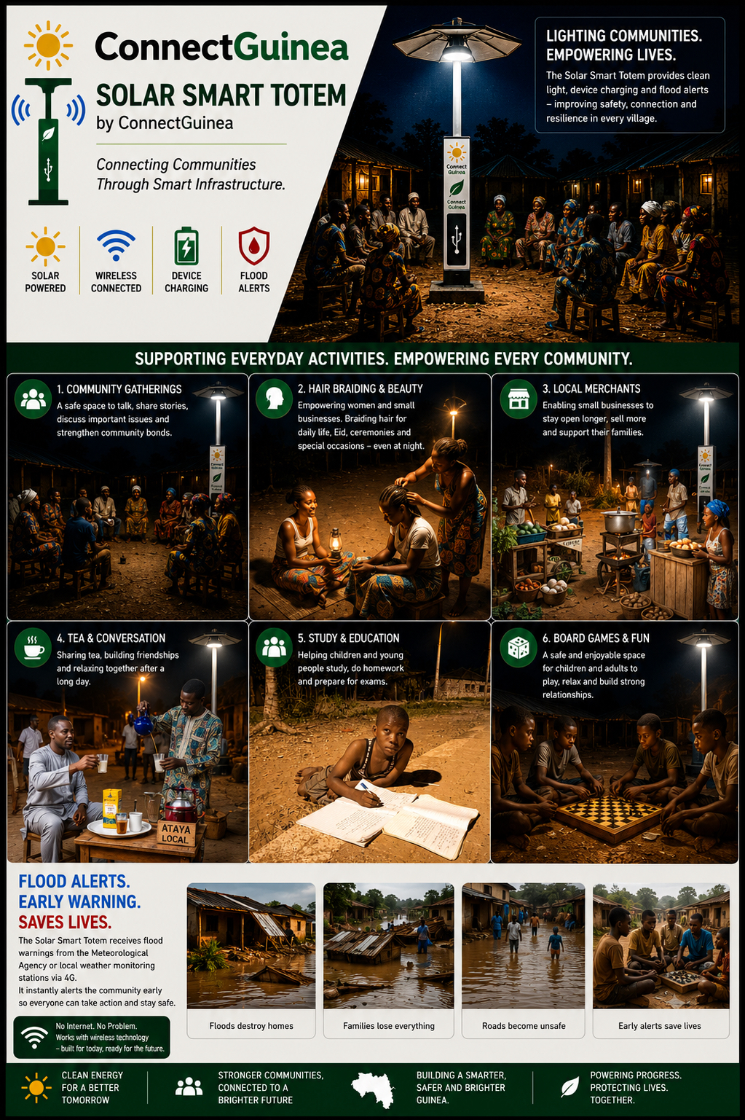
Docs/IMG_8451.jpeg
