Madina1219/ConnectGuinea/docs/smartlight_totem_system_diagram_v1.1.png

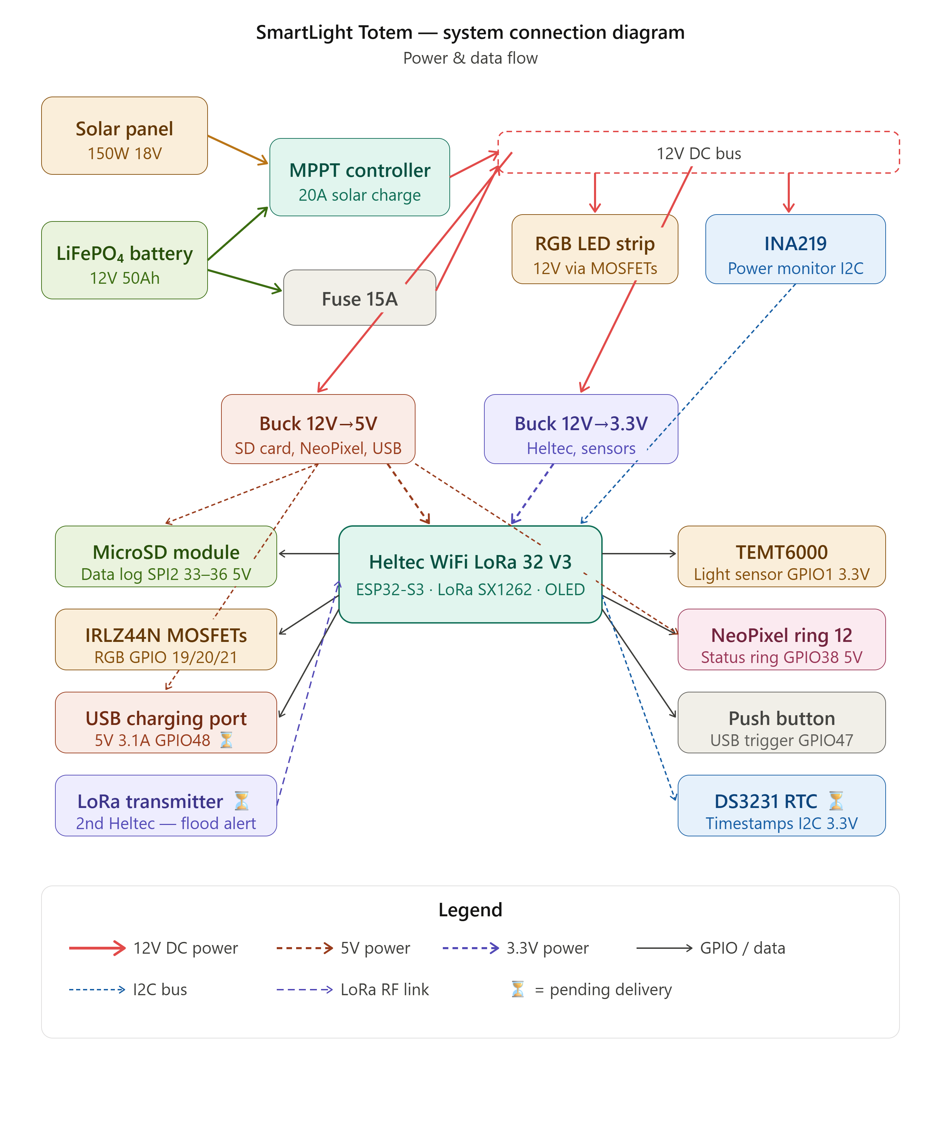
docs/smartlight_totem_system_diagram_v1.1.png
