Madina1219/ConnectGuinea/Docs/Totem Schematics/IMG_8894.jpeg

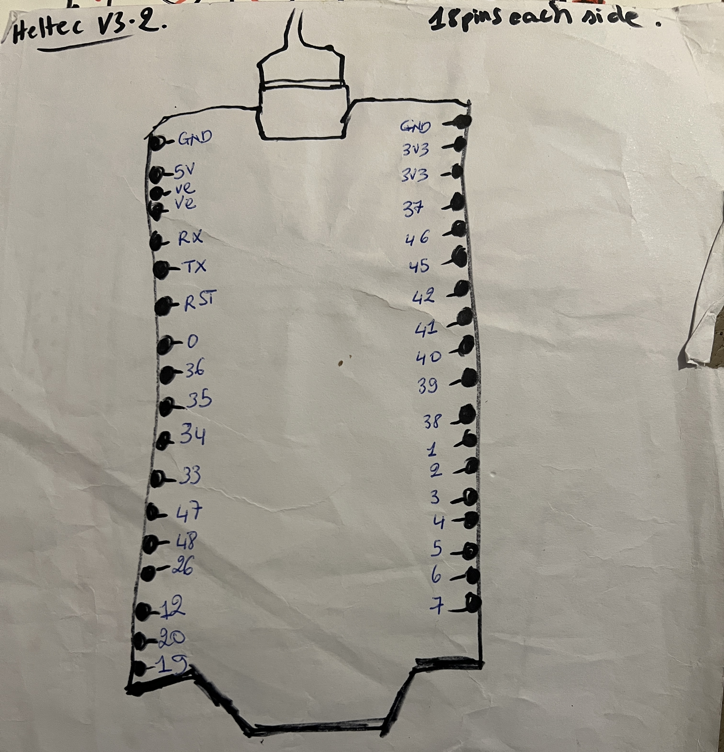
Docs/Totem Schematics/IMG_8894.jpeg
