Madina1219/ConnectGuinea/Docs/Totem Schematics/IMG_8895.jpeg

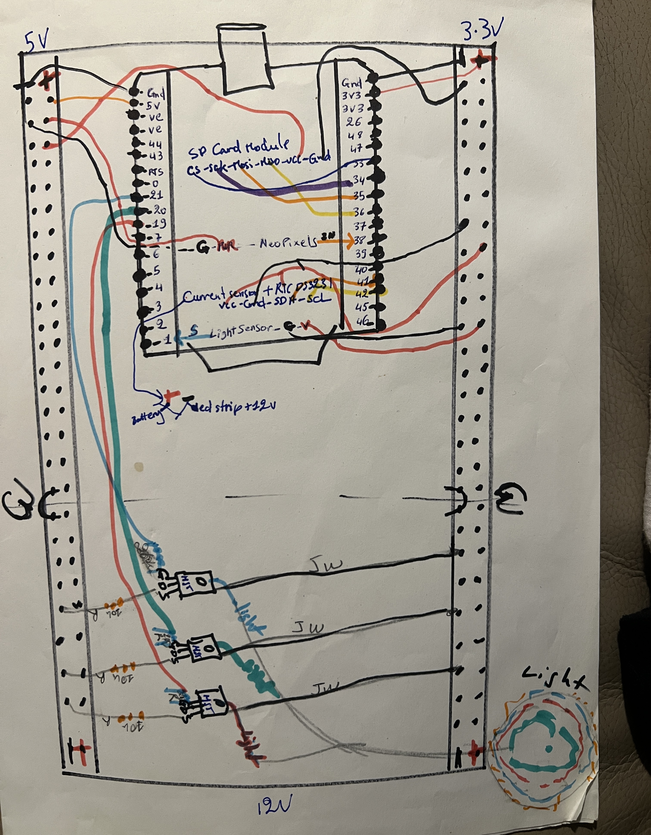
Docs/Totem Schematics/IMG_8895.jpeg
