Madina1219/ConnectGuinea/Final Prototype and Exhibition/IMG_8384.jpeg

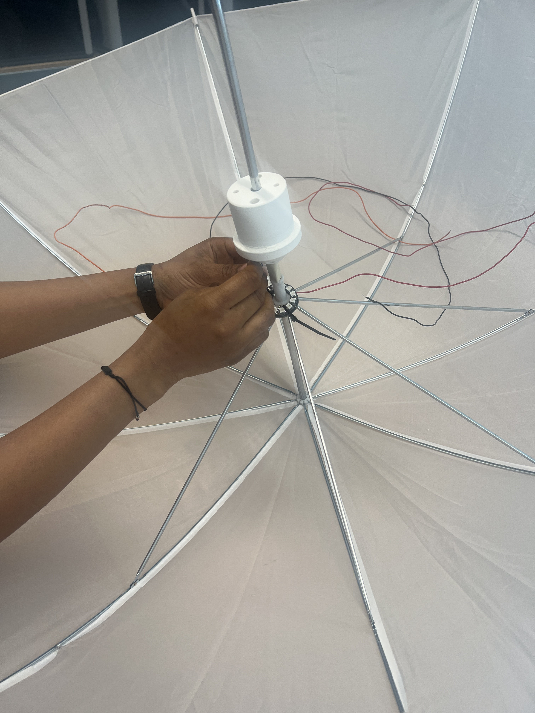
Final Prototype and Exhibition/IMG_8384.jpeg
