Madina1219/ConnectGuinea/Final Prototype and Exhibition/IMG_8727 (1).jpeg

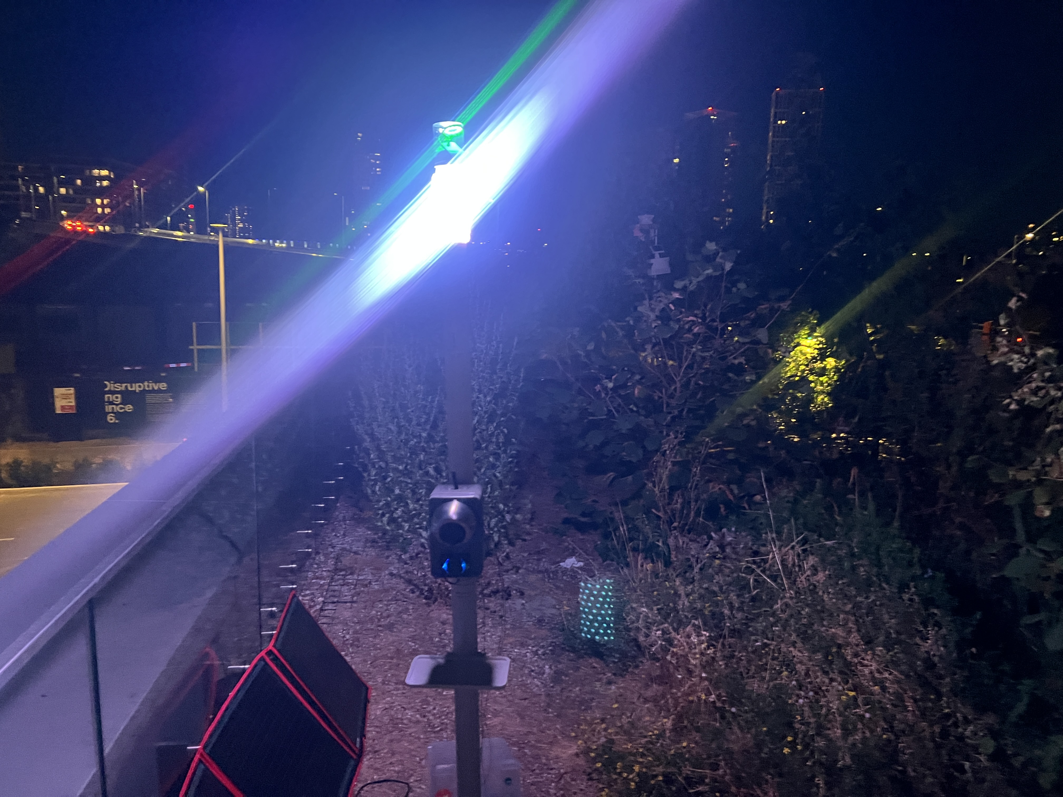
Final Prototype and Exhibition/IMG_8727 (1).jpeg
