Madina1219/ConnectGuinea/Final Prototype and Exhibition/IMG_8728.jpeg

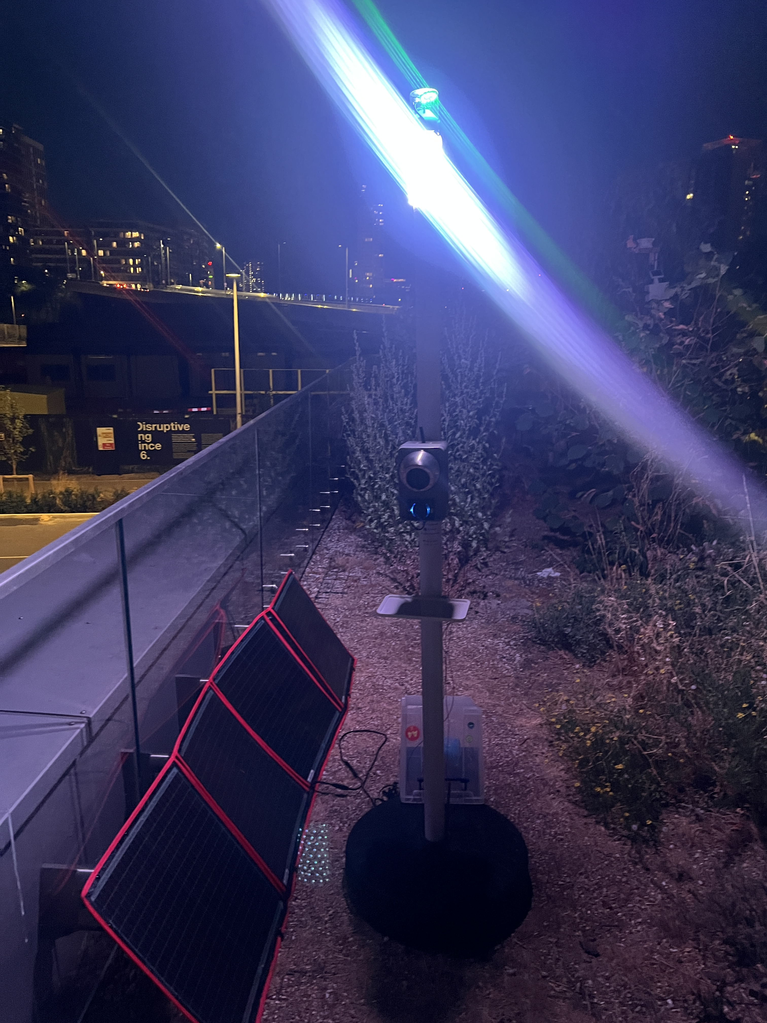
Final Prototype and Exhibition/IMG_8728.jpeg
