Madina1219/ConnectGuinea/Final Prototype and Exhibition/IMG_8729.jpeg

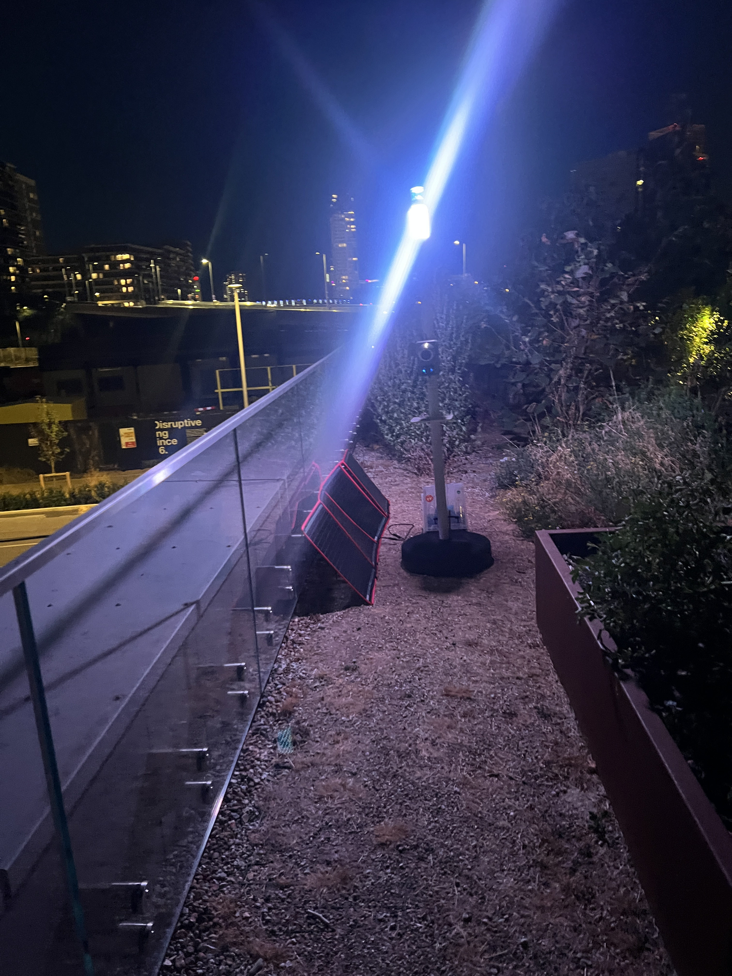
Final Prototype and Exhibition/IMG_8729.jpeg
