Madina1219/ConnectGuinea/Final Prototype and Exhibition/IMG_8730.jpeg

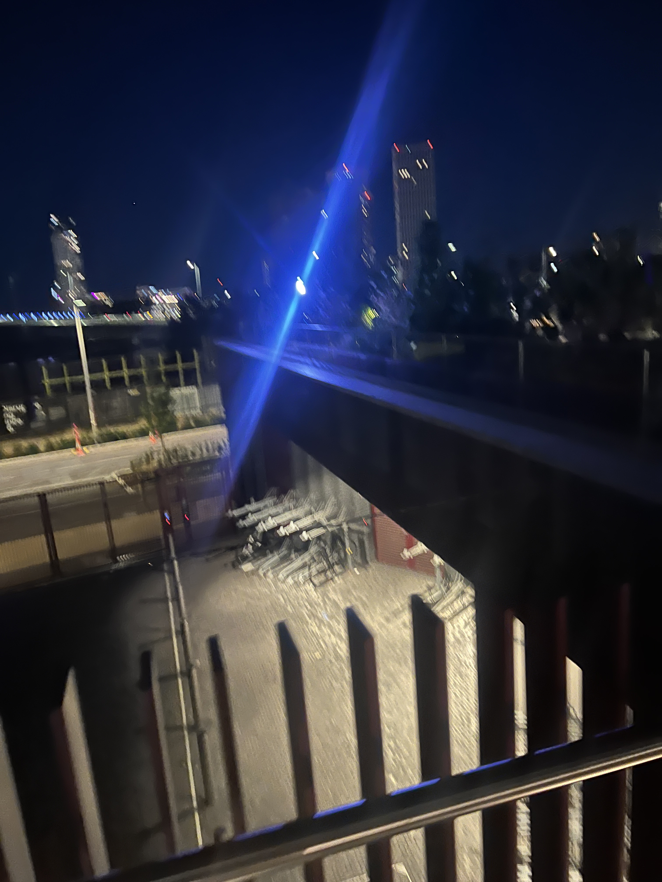
Final Prototype and Exhibition/IMG_8730.jpeg
