Madina1219/ConnectGuinea/Final Prototype and Exhibition/IMG_8731.jpeg

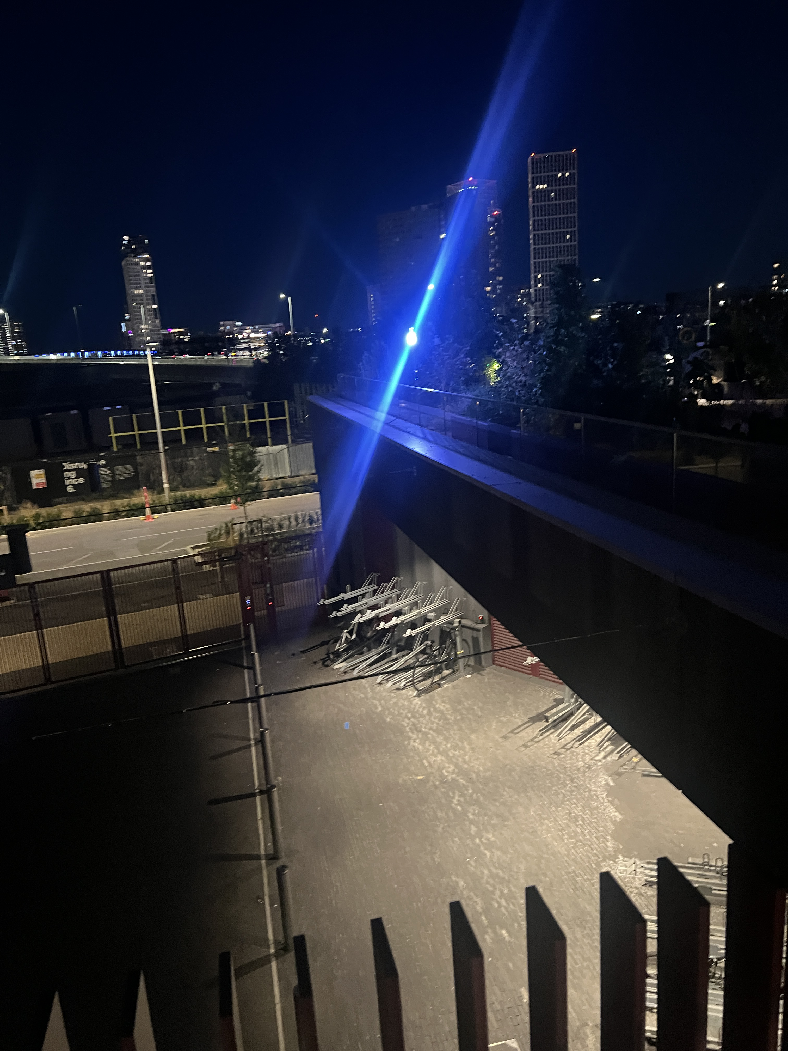
Final Prototype and Exhibition/IMG_8731.jpeg
