Madina1219/ConnectGuinea/Final Prototype and Exhibition/IMG_8739.jpeg

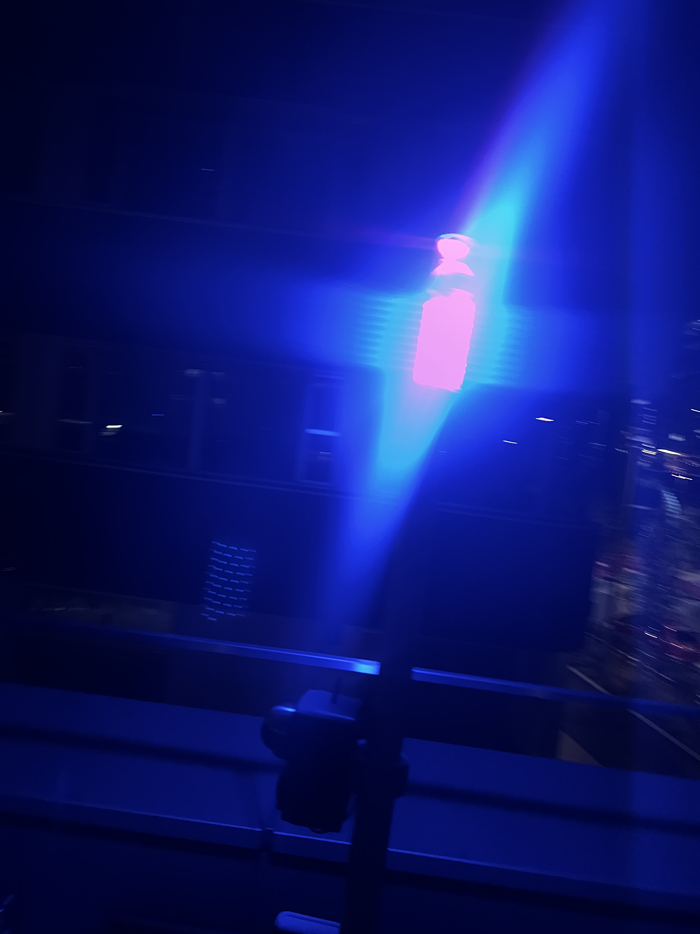
Final Prototype and Exhibition/IMG_8739.jpeg
