Madina1219/ConnectGuinea/Final Prototype and Exhibition/IMG_8740.jpeg

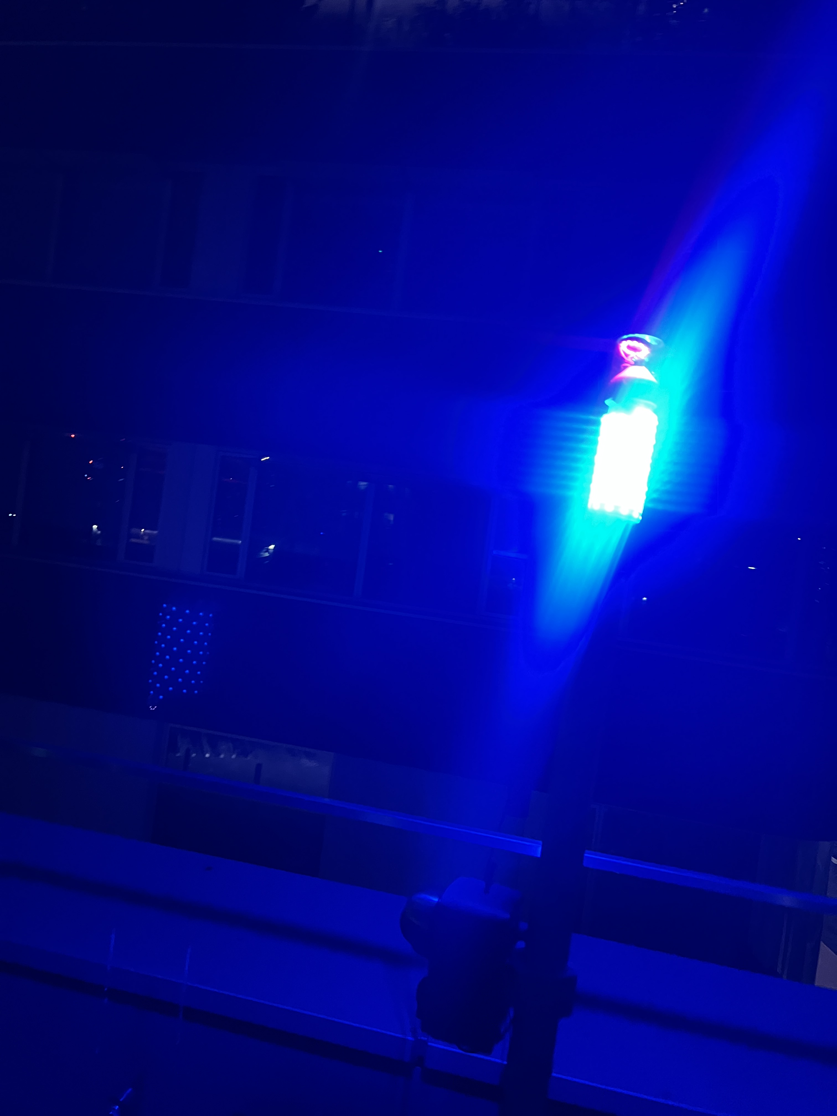
Final Prototype and Exhibition/IMG_8740.jpeg
