Madina1219/ConnectGuinea/Final Prototype and Exhibition/IMG_8846 (1).jpeg

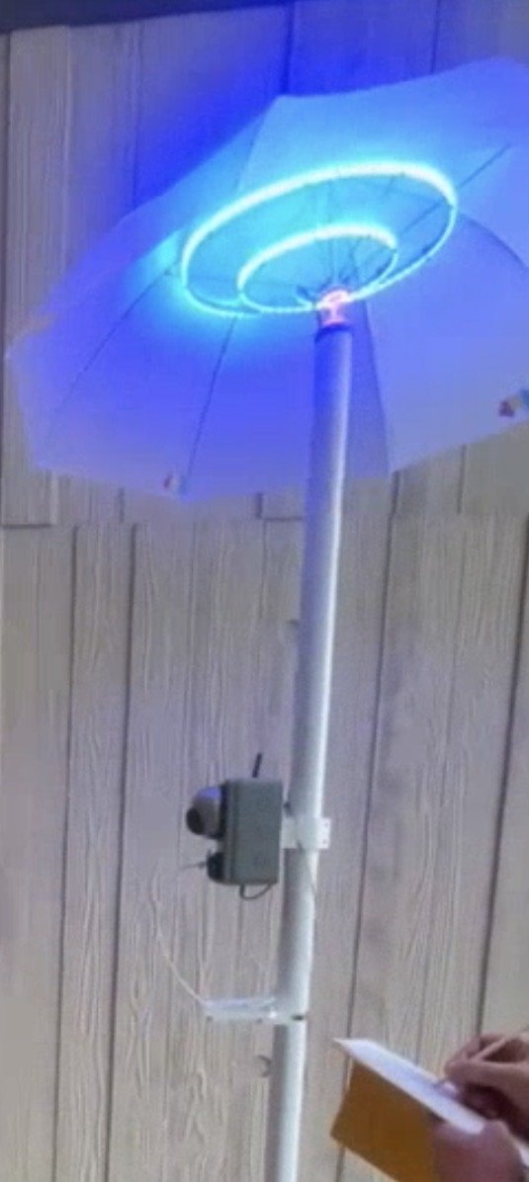
Final Prototype and Exhibition/IMG_8846 (1).jpeg
