Madina1219/ConnectGuinea/Final Prototype and Exhibition/IMG_8847 (1).jpeg

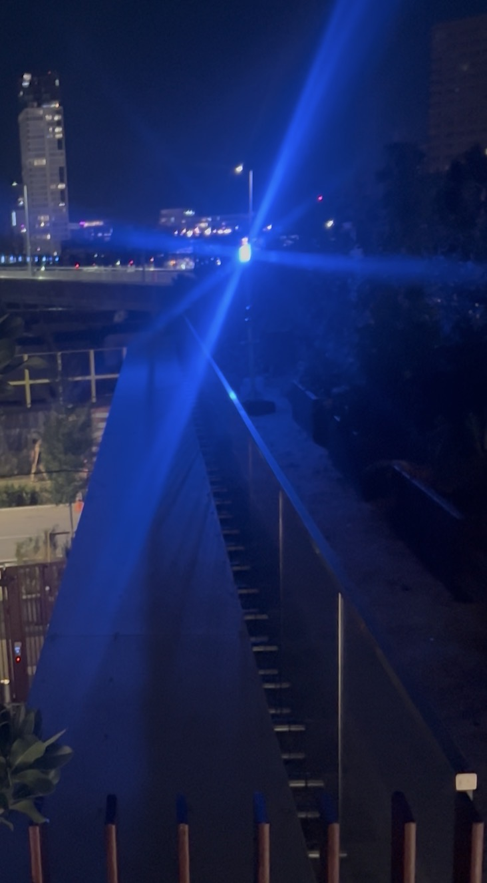
Final Prototype and Exhibition/IMG_8847 (1).jpeg
