Madina1219/ConnectGuinea/Final Prototype and Exhibition/IMG_8848 (1).jpeg

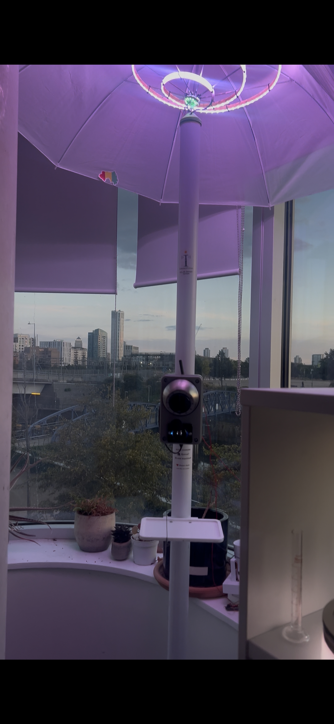
Final Prototype and Exhibition/IMG_8848 (1).jpeg
