Madina1219/ConnectGuinea/Final Prototype and Exhibition/IMG_8849.jpeg

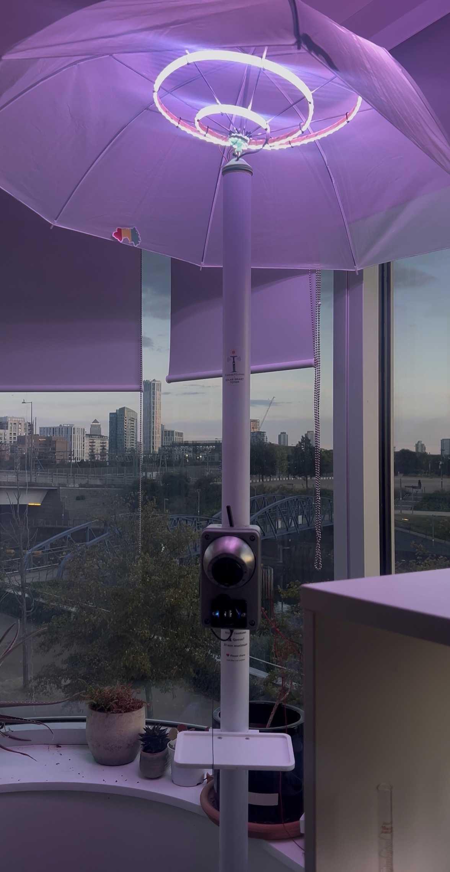
Final Prototype and Exhibition/IMG_8849.jpeg
