Madina1219/ConnectGuinea/Final Prototype and Exhibition/IMG_8850.jpeg

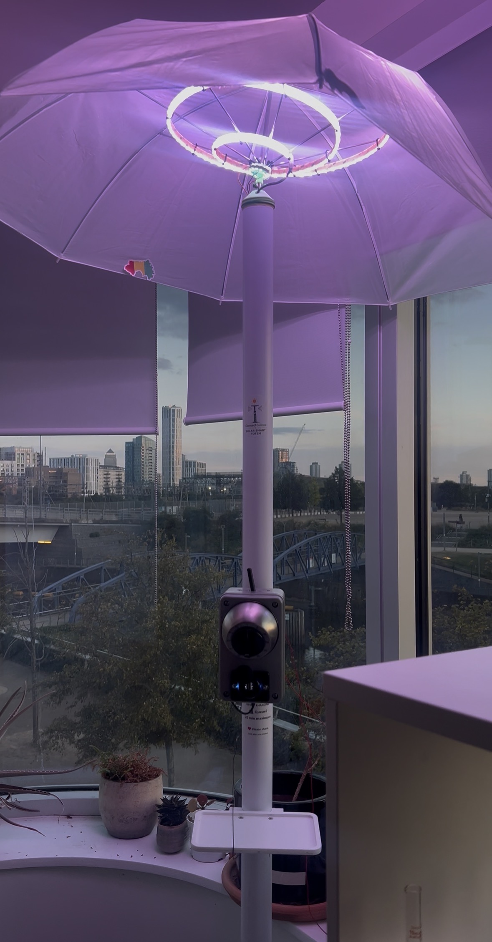
Final Prototype and Exhibition/IMG_8850.jpeg
