Madina1219/ConnectGuinea/Final Prototype and Exhibition/IMG_8851.jpeg

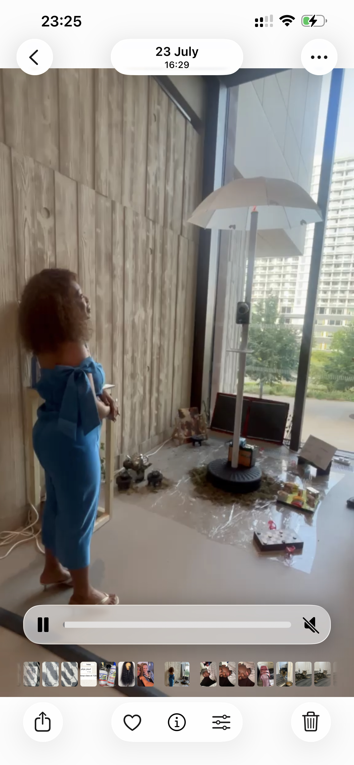
Final Prototype and Exhibition/IMG_8851.jpeg
