Madina1219/ConnectGuinea/Final Prototype and Exhibition/IMG_8852.jpeg

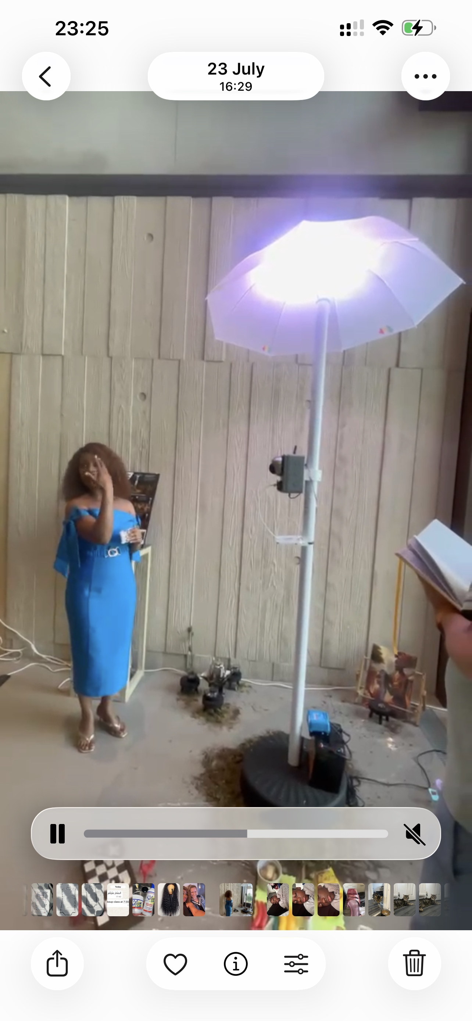
Final Prototype and Exhibition/IMG_8852.jpeg
