Madina1219/ConnectGuinea/Final Prototype and Exhibition/IMG_8853.jpeg

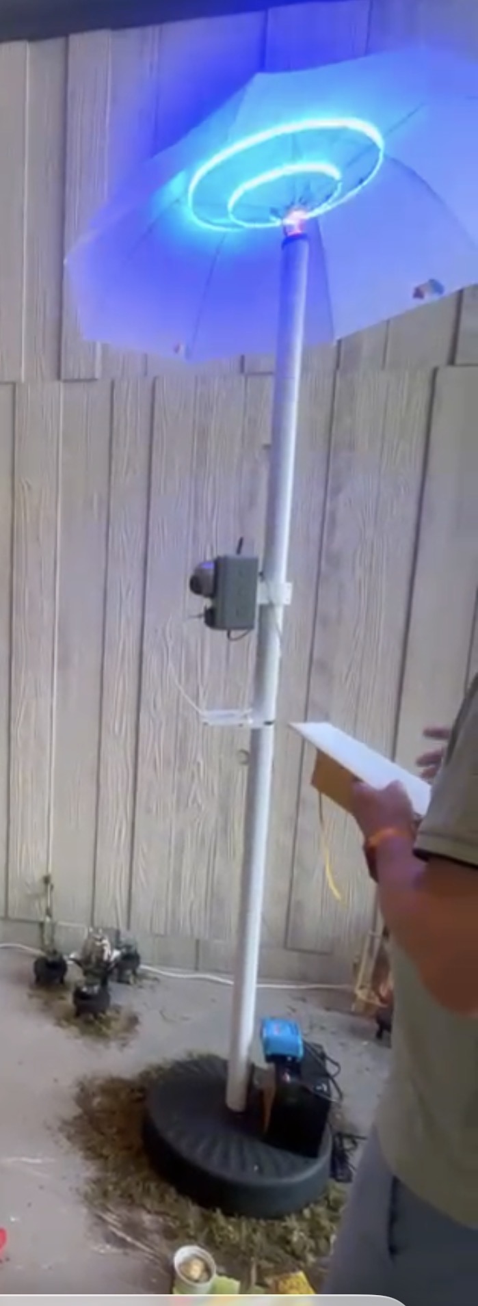
Final Prototype and Exhibition/IMG_8853.jpeg
