Madina1219/ConnectGuinea/Final Prototype and Exhibition/IMG_8855.jpeg

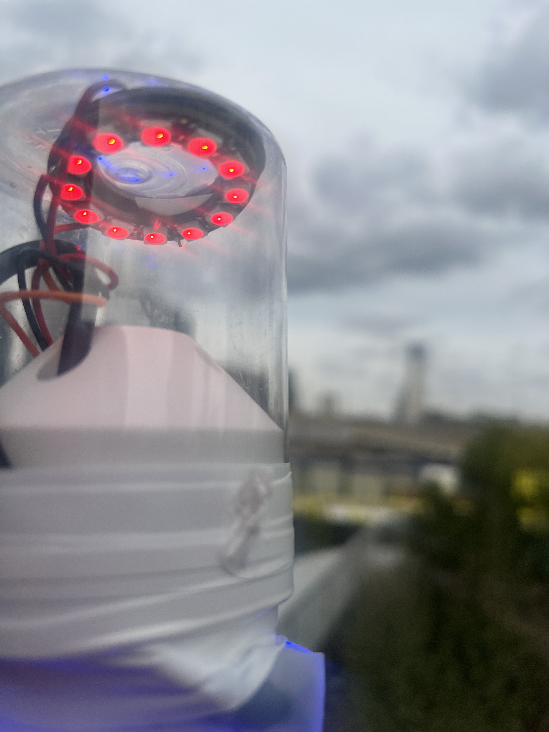
Final Prototype and Exhibition/IMG_8855.jpeg
