Madina1219/ConnectGuinea/Final Prototype and Exhibition/IMG_8856.jpeg

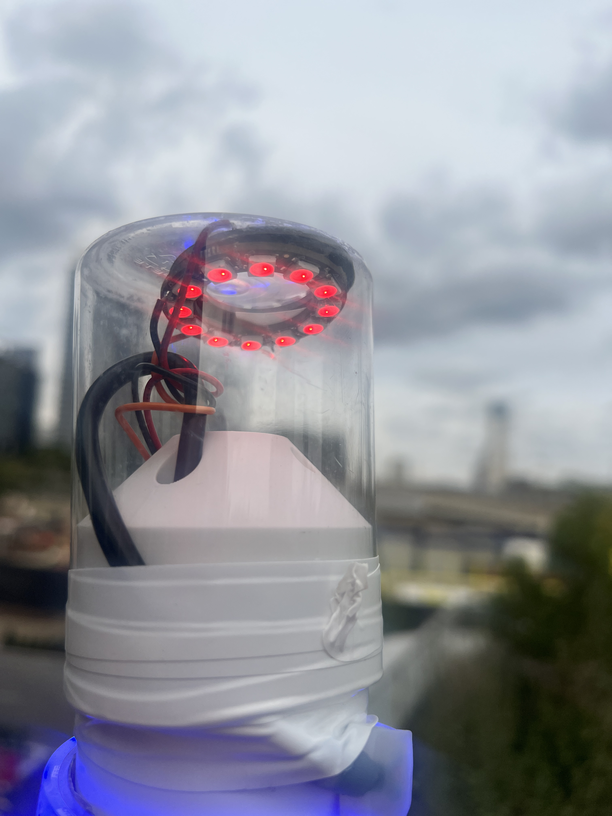
Final Prototype and Exhibition/IMG_8856.jpeg
