Madina1219/ConnectGuinea/Final Prototype and Exhibition/IMG_8857.jpeg

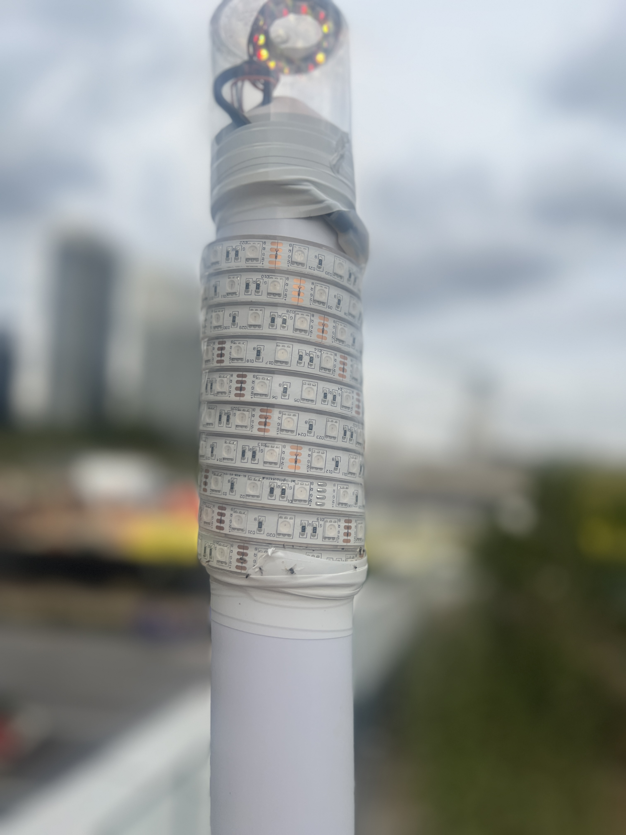
Final Prototype and Exhibition/IMG_8857.jpeg
