Madina1219/ConnectGuinea/Final Prototype and Exhibition/IMG_8858.jpeg

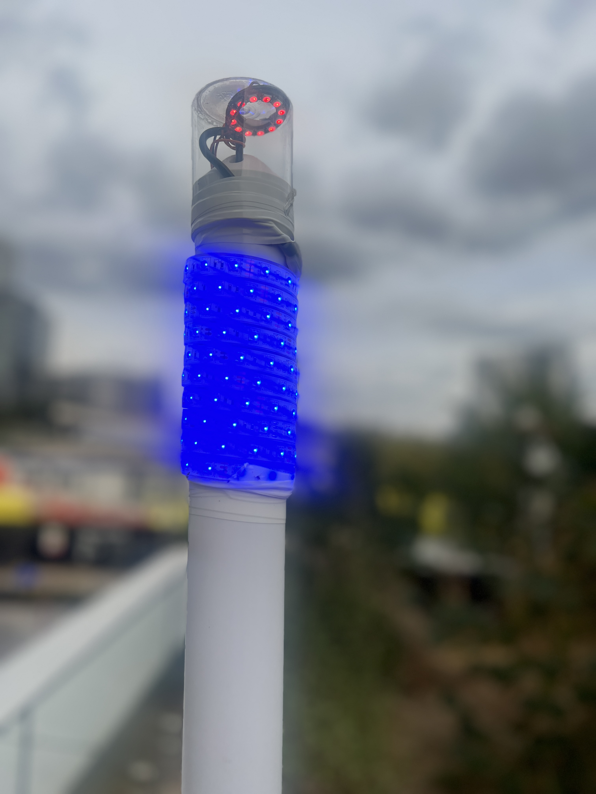
Final Prototype and Exhibition/IMG_8858.jpeg
