Madina1219/ConnectGuinea/Final Prototype and Exhibition/IMG_8859.jpeg

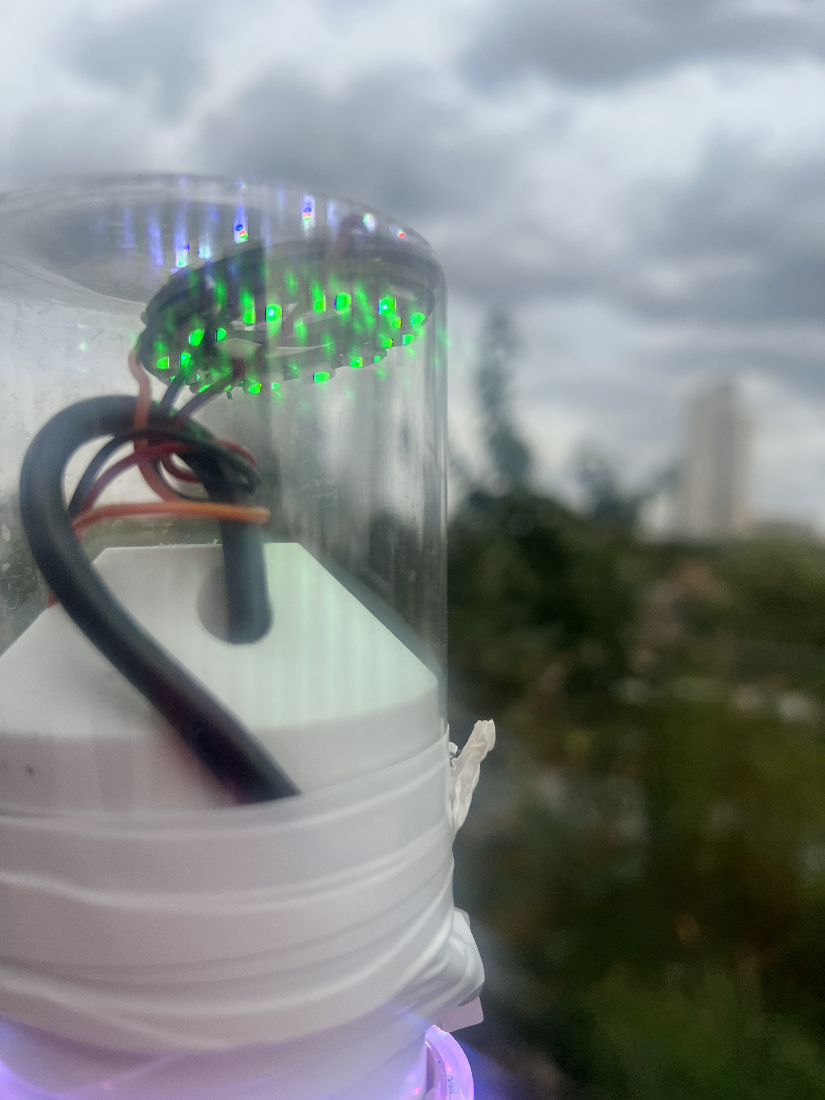
Final Prototype and Exhibition/IMG_8859.jpeg
