Madina1219/ConnectGuinea/Final Prototype and Exhibition/IMG_8860.jpeg

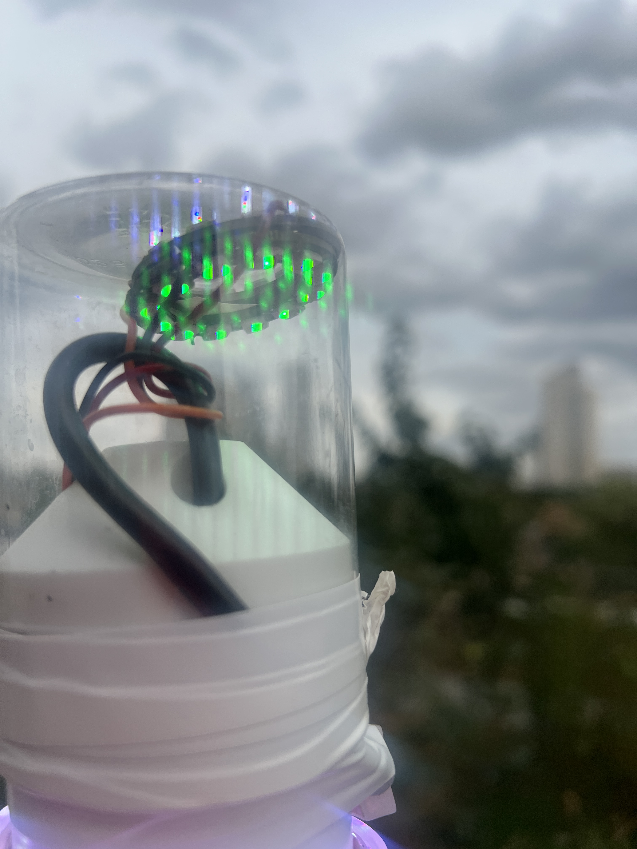
Final Prototype and Exhibition/IMG_8860.jpeg
