Madina1219/ConnectGuinea/Final Prototype and Exhibition/IMG_8861.jpeg

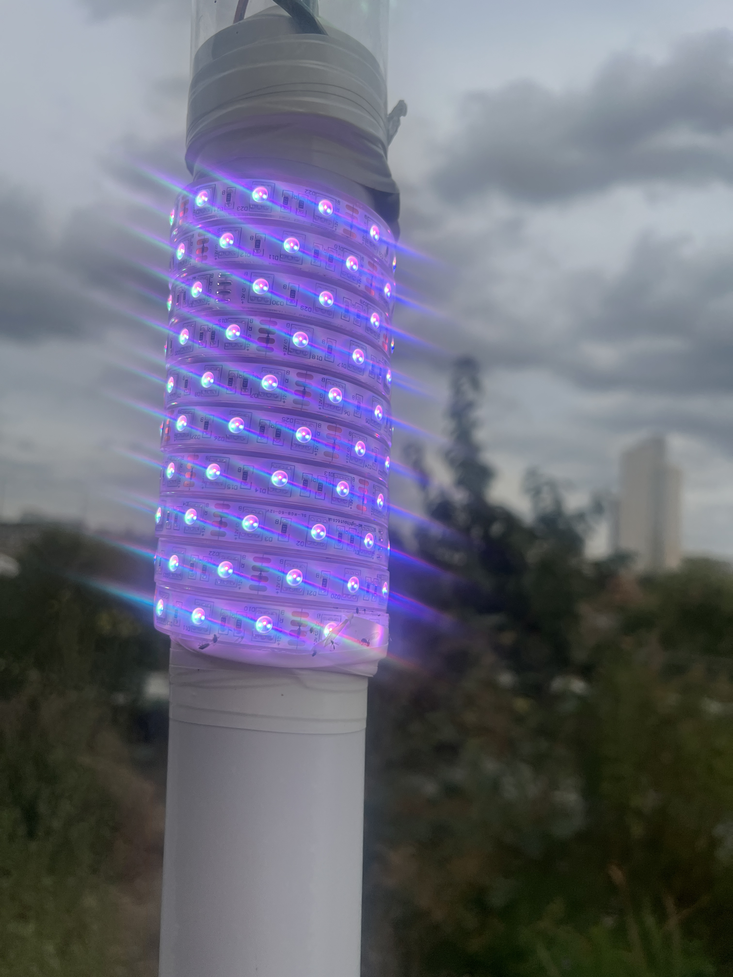
Final Prototype and Exhibition/IMG_8861.jpeg
