Madina1219/ConnectGuinea/Final Prototype and Exhibition/IMG_8862.jpeg

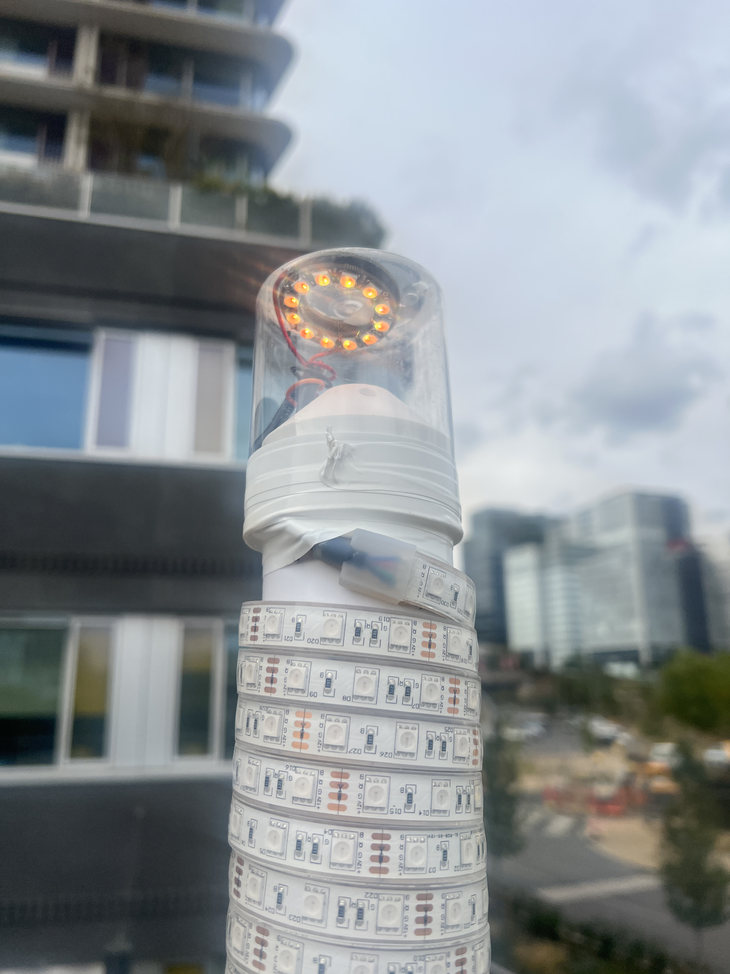
Final Prototype and Exhibition/IMG_8862.jpeg
