Madina1219/ConnectGuinea/Final Prototype and Exhibition/IMG_8879.jpeg

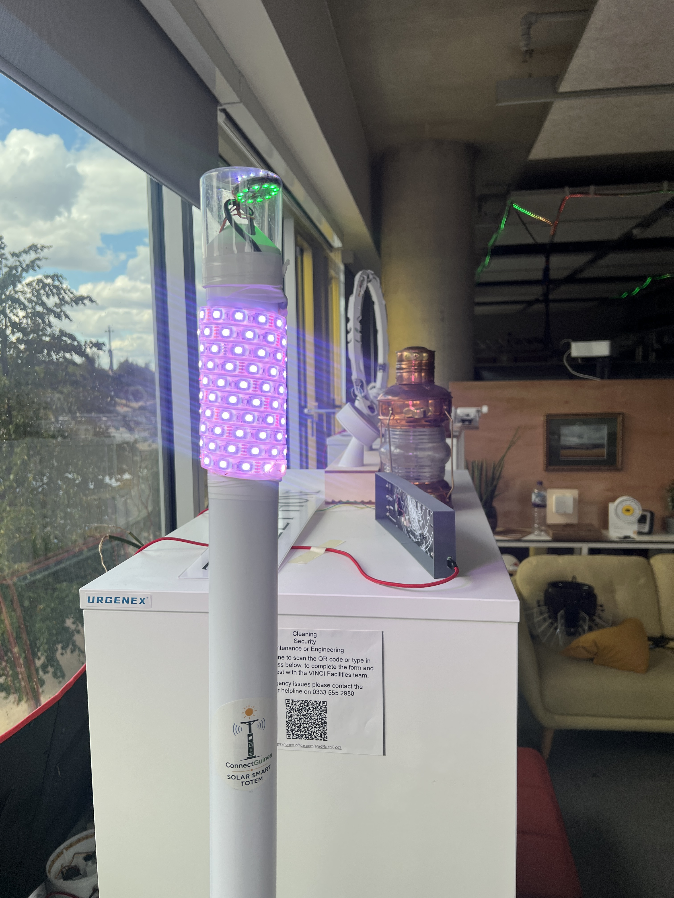
Final Prototype and Exhibition/IMG_8879.jpeg
