Madina1219/ConnectGuinea/Final Prototype and Exhibition/IMG_8882.jpeg

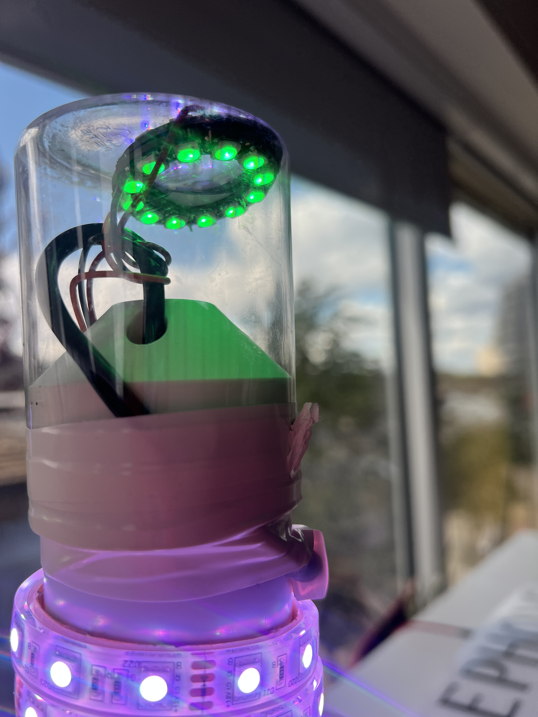
Final Prototype and Exhibition/IMG_8882.jpeg
