Madina1219/ConnectGuinea/Final Prototype and Exhibition/IMG_8884.jpeg

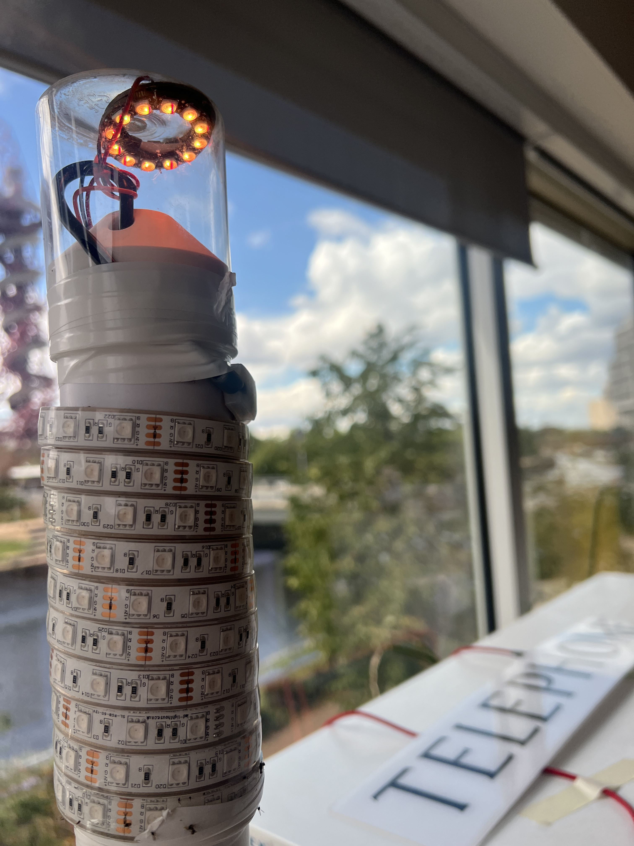
Final Prototype and Exhibition/IMG_8884.jpeg
