Madina1219/ConnectGuinea/Totem Components/Designer.png

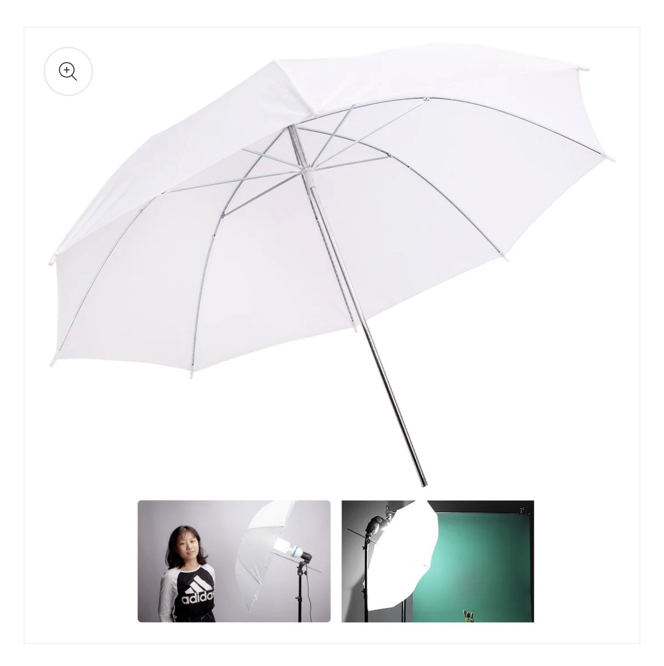
Totem Components/Designer.png
