Madina1219/ConnectGuinea/Totem Components/Mechanical Kitchen.jpg

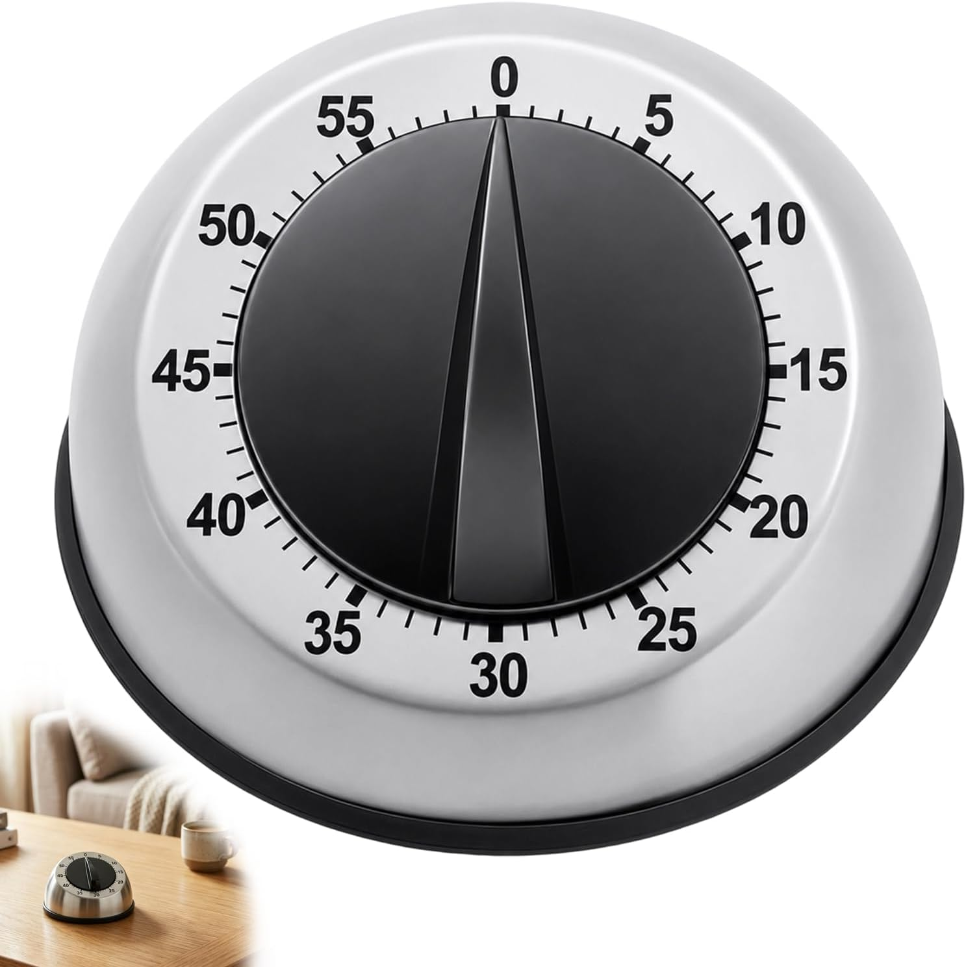
Totem Components/Mechanical Kitchen.jpg
