Madina1219/ConnectGuinea/docs/Solar-Battery-Components Interface.pptx

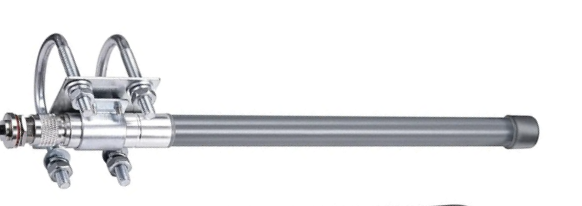
[picture p130: figure]
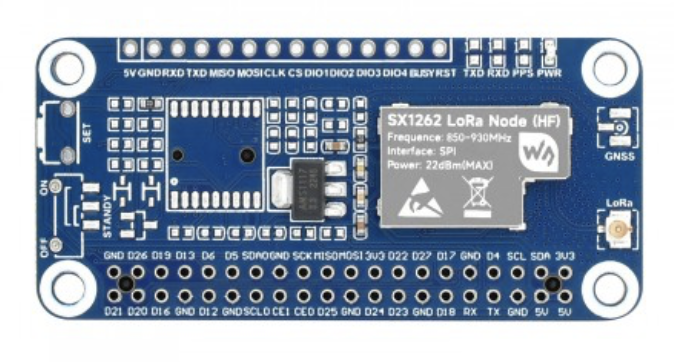
[picture p131: figure]
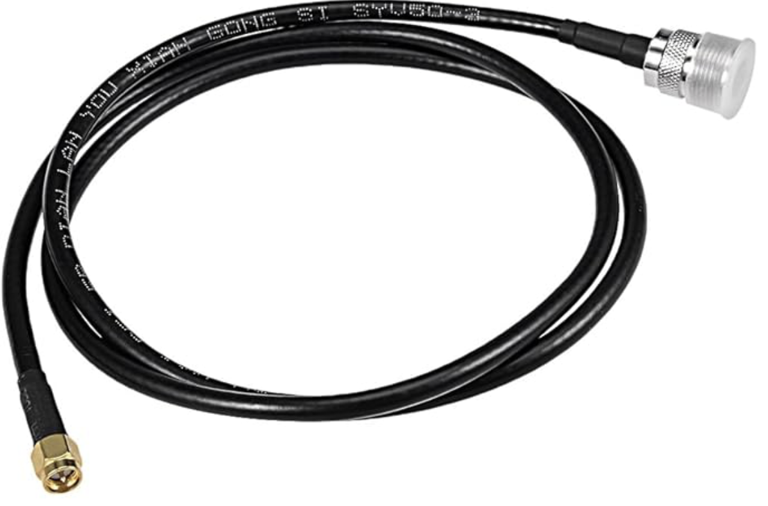
[picture p132: figure]
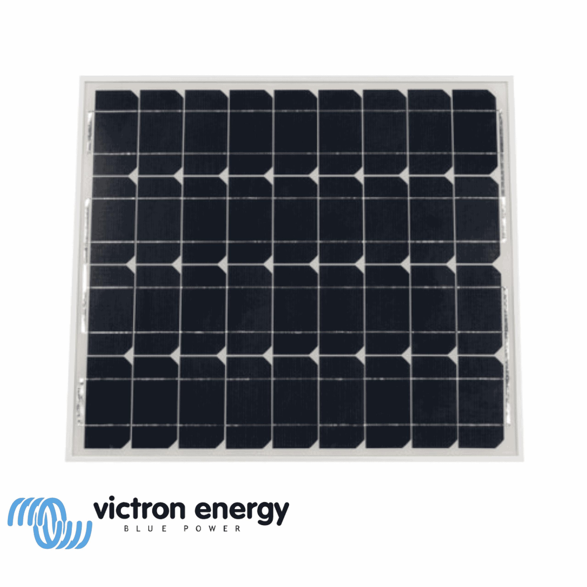
[picture p133: figure]
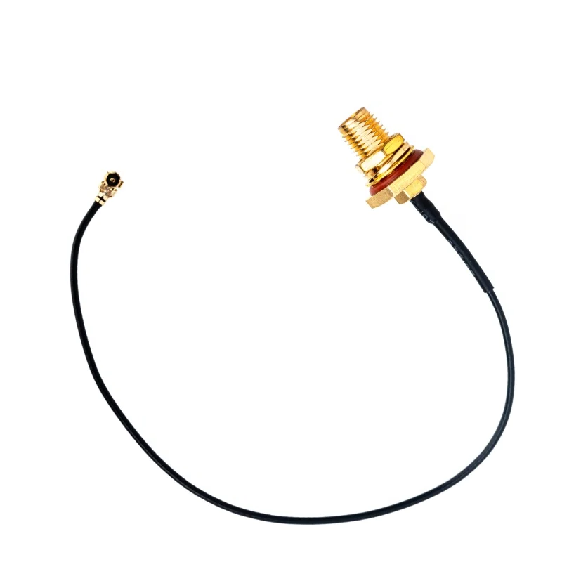
[picture p134: figure]
Sma Cable SMA To UFL/u.FL/IPX/IPEX RF Adapter Sma Adapter Kit
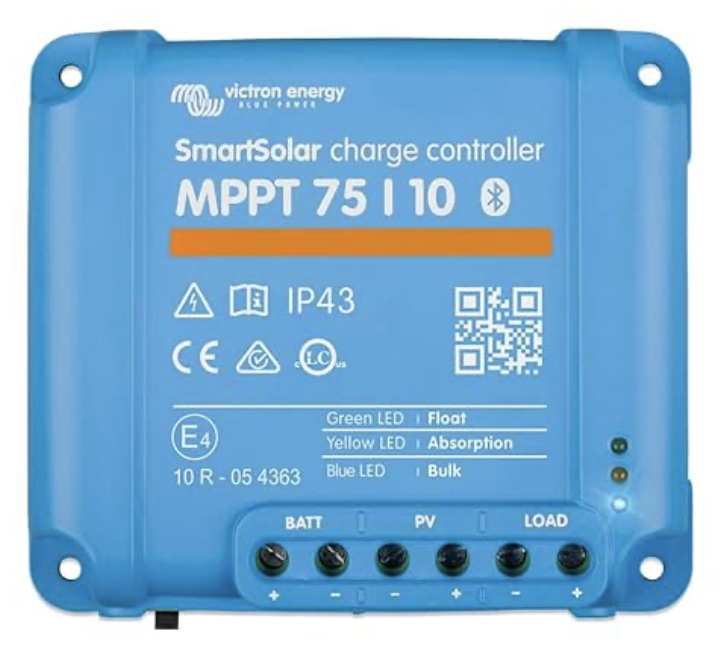
[picture p135: figure]
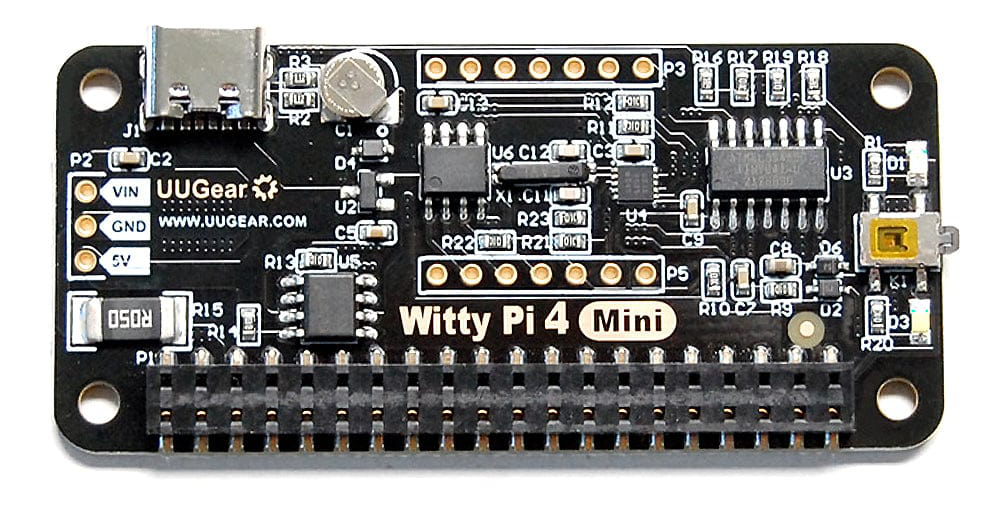
[picture p136: figure]
Witty Pi 4 Mini - Realtime Clock and Power Management for Raspberry Pi by UUGear - The Pi Hut
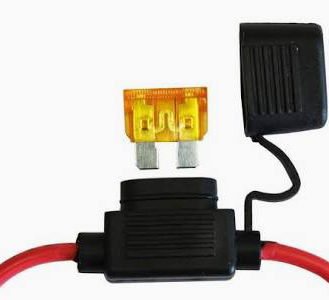
[picture p137: figure]
All Trade Direct Standard Blade Fuse Holder
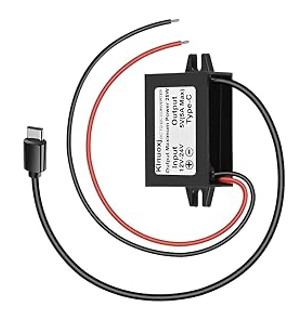
[picture p138: figure]
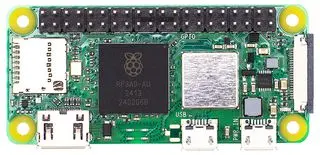
[picture p139: figure]
SC0721 - Raspberry Pi Zero 2 W (With Headers)
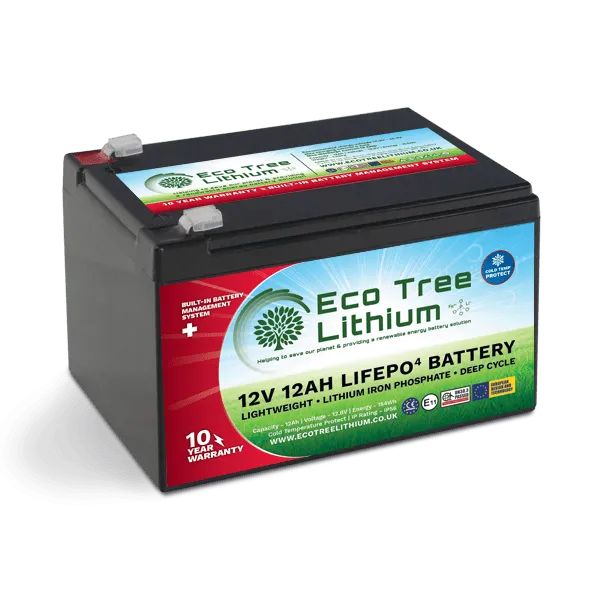
[picture p140: figure]

Cables
Panel to MPPT: 4mm² Solar Cable (for UV resistance)
MPPT to Battery: 6mm² or 10mm² (to minimize voltage drop)
Battery to DC Jack: 1.5mm² or 2.5mm² (standard thin wall auto wire)
Fuse
5A or 10A to protect board in case of short / cows chewing cables
Ensure all negative wires meet at the battery post or a common bus bar. This prevents ground loops which can interfere with LoRa radio.

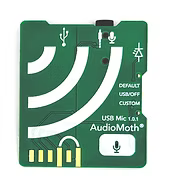
[picture p141: figure]
AudioMoth | Open Acoustic Devices
