Madina1219/ConnectGuinea/Dissertation Support and Additional Information/Implementation/Figure 4.2-Subsystem grouping of totem hardware components..png

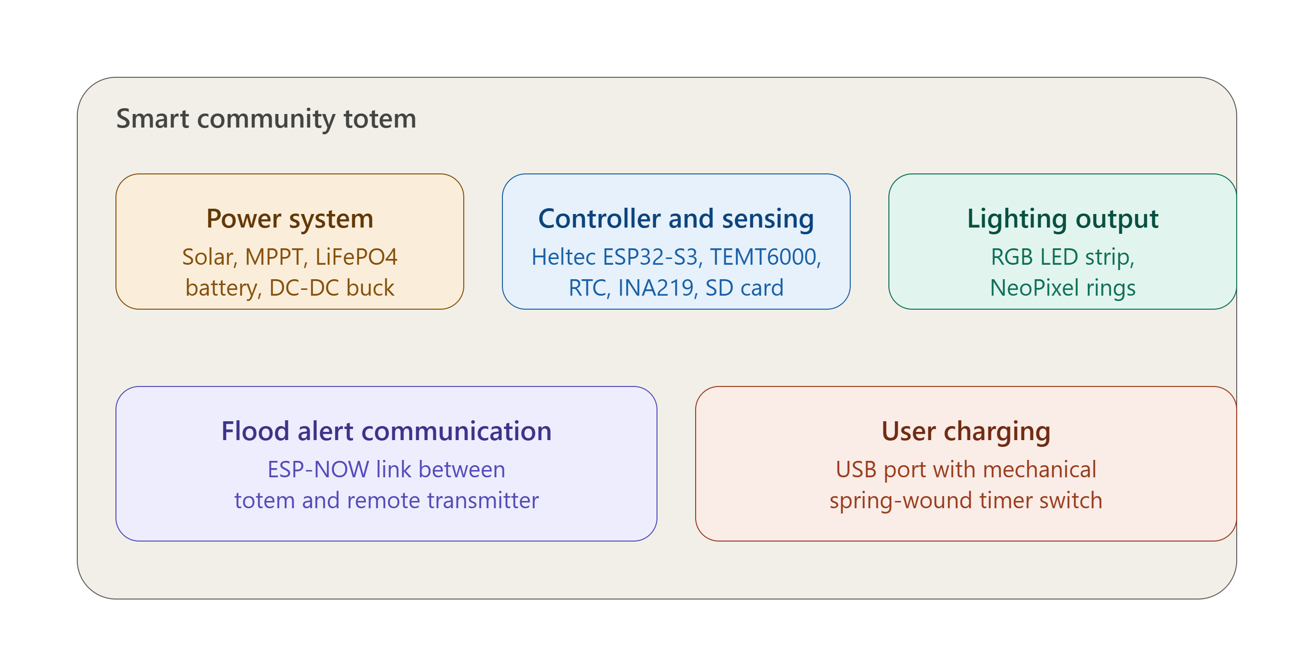
Dissertation Support and Additional Information/Implementation/Figure 4.2-Subsystem grouping of totem hardware components..png
