Madina1219/ConnectGuinea/Dissertation Support and Additional Information/Implementation/Rest of Integrated Hardware Components for the Prototype.png

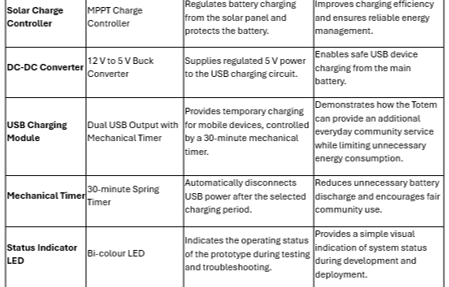
Dissertation Support and Additional Information/Implementation/Rest of Integrated Hardware Components for the Prototype.png
