Madina1219/ConnectGuinea/Dissertation Support and Additional Information/Implementation/Table 4.1-Hardware components integrated into the Smart Community Totem prototype..png

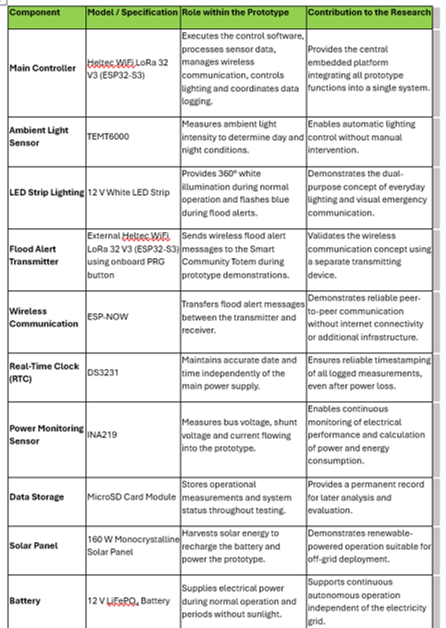
Dissertation Support and Additional Information/Implementation/Table 4.1-Hardware components integrated into the Smart Community Totem prototype..png
