Madina1219/ConnectGuinea/Totem Components/2 in 1 USB 3.0 Card Reader Micro TF sd card Reader usb adapter High Speed Reader.webp

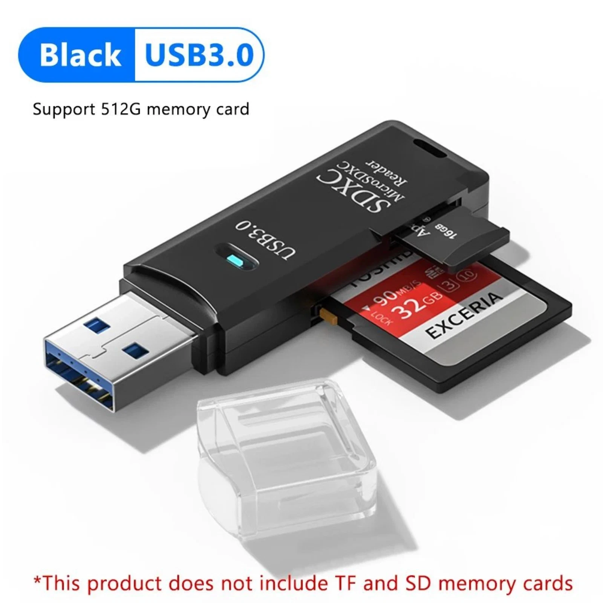
Totem Components/2 in 1 USB 3.0 Card Reader Micro TF sd card Reader usb adapter High Speed Reader.webp
