Madina1219/ConnectGuinea/Totem Components/12V 3.1A Dual USB Car Charger 2 Port Adapter Power Socket Charging Panel Mount.webp

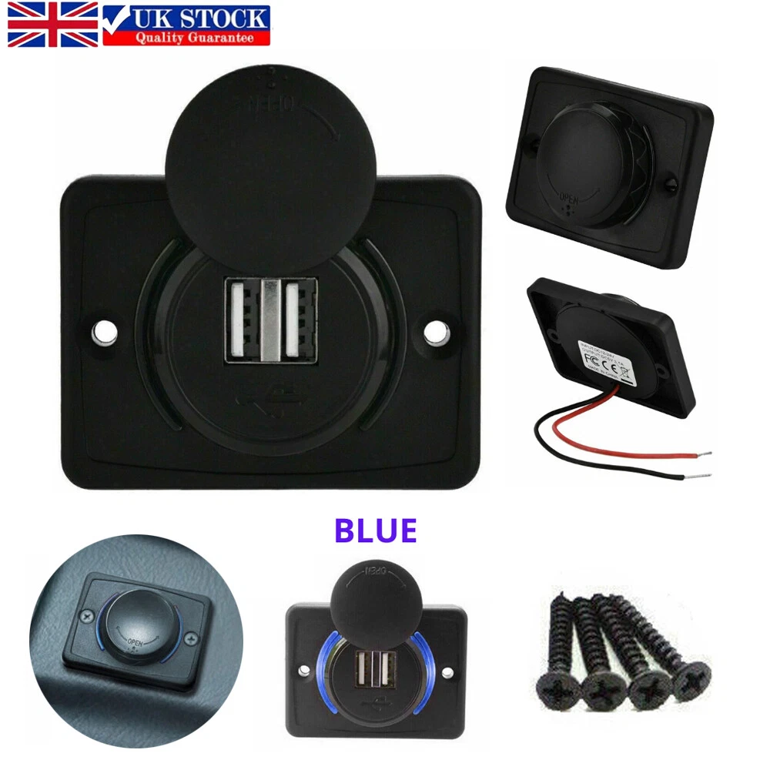
Totem Components/12V 3.1A Dual USB Car Charger 2 Port Adapter Power Socket Charging Panel Mount.webp
