Madina1219/ConnectGuinea/Totem Components/DC 12V24V to 5V 3A USB C Buck Converter Type-C.jpg

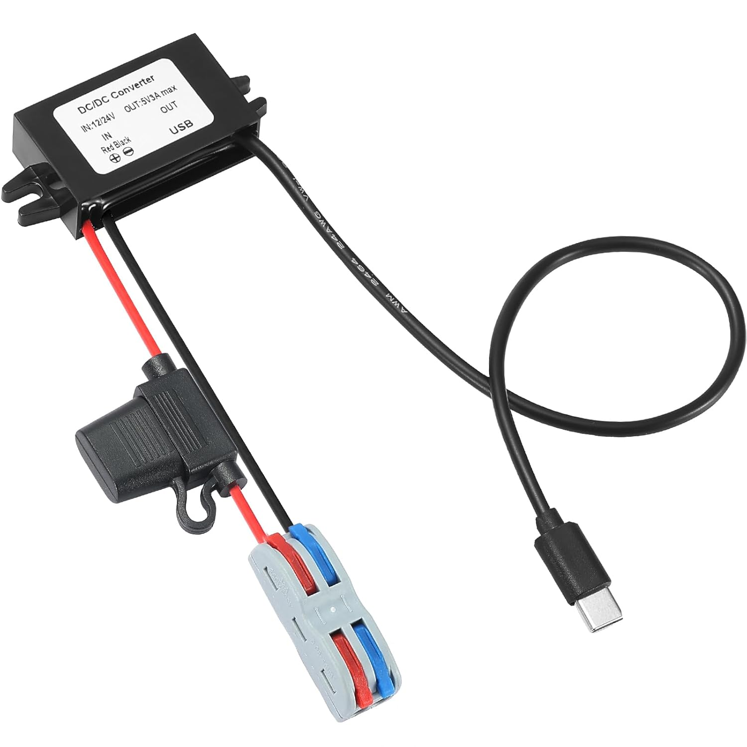
Totem Components/DC 12V24V to 5V 3A USB C Buck Converter Type-C.jpg
