Madina1219/ConnectGuinea/Totem Components/DOKIO Foldable 160W 18V Solar Panel for 12V Battery.webp

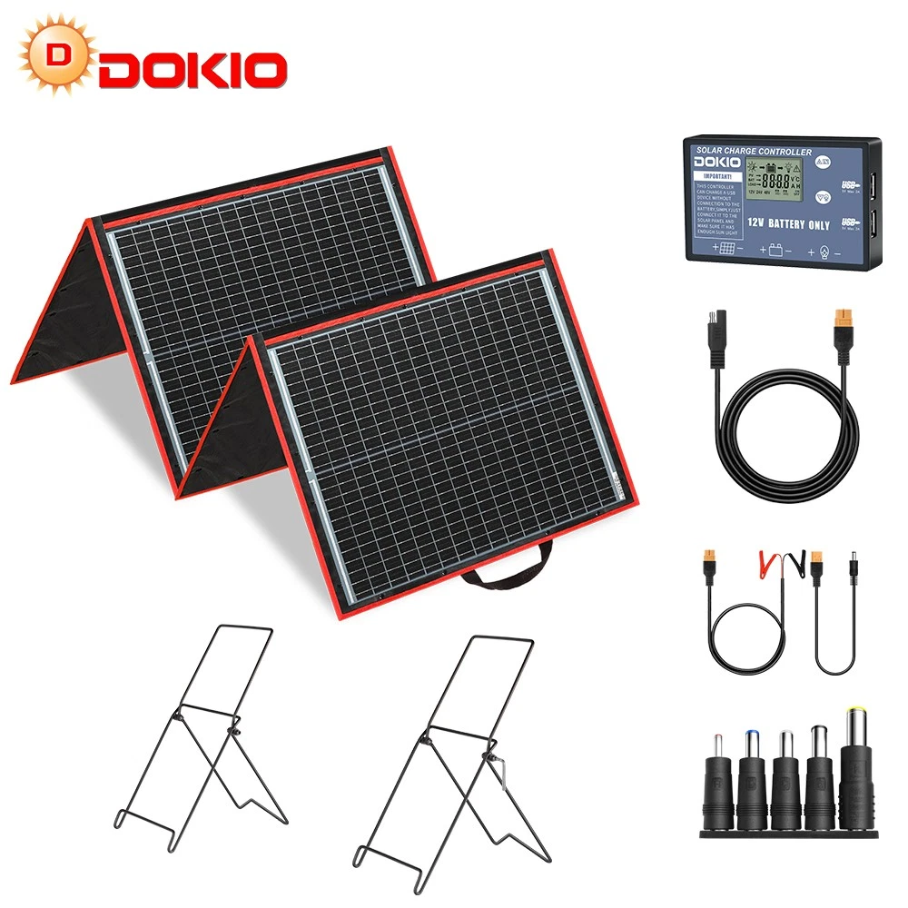
Totem Components/DOKIO Foldable 160W 18V Solar Panel for 12V Battery.webp
