Madina1219/ConnectGuinea/Totem Components/DS3231 AT24C32 I2C Module Precision Real Time Clock Module.jpg

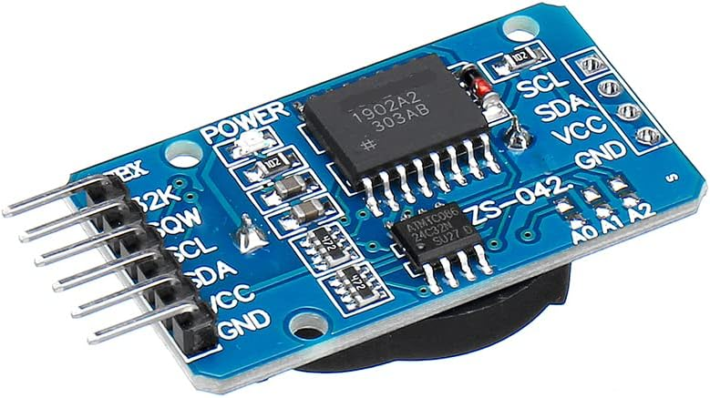
Totem Components/DS3231 AT24C32 I2C Module Precision Real Time Clock Module.jpg
