Madina1219/ConnectGuinea/Totem Components/DS3231 RTC AT24C32 IIC I2C Module Precision Real Time Clock & LIR2032 Battery.webp

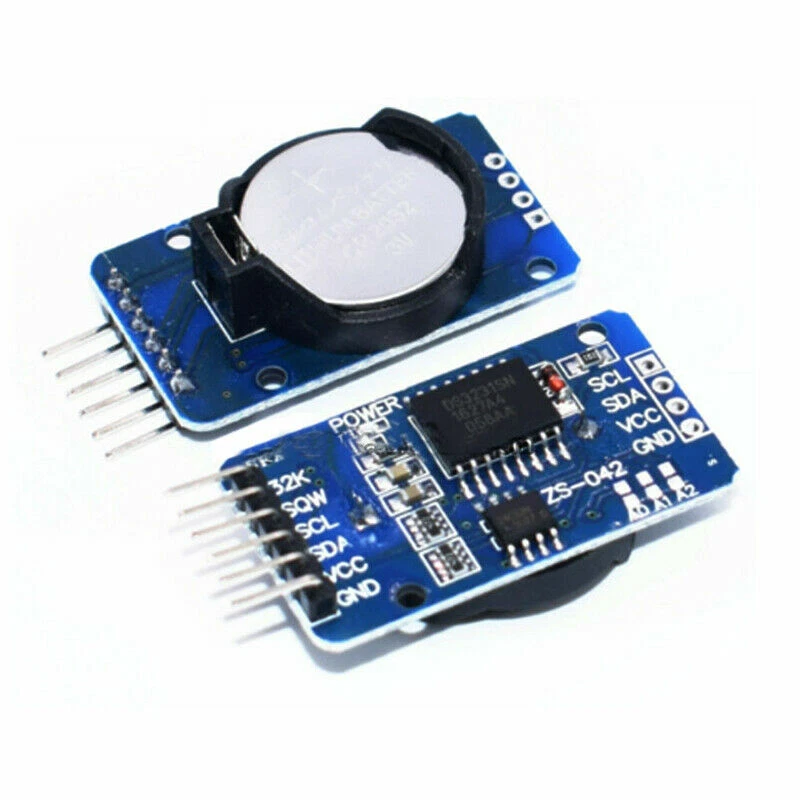
Totem Components/DS3231 RTC AT24C32 IIC I2C Module Precision Real Time Clock & LIR2032 Battery.webp
