Madina1219/ConnectGuinea/Totem Components/DS3231 RTC Module.jpg

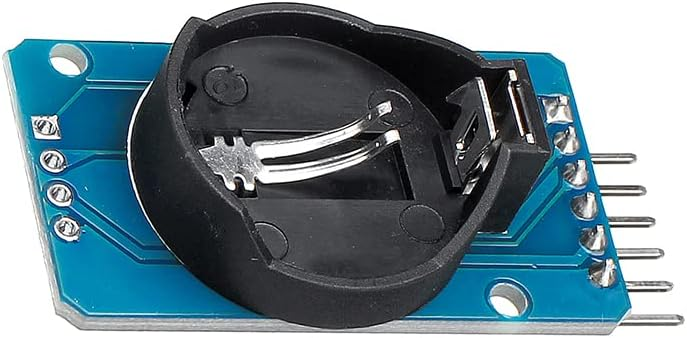
Totem Components/DS3231 RTC Module.jpg
