Madina1219/ConnectGuinea/Totem Components/ECO-WORTHY 12V 50Ah Lithium Battery LiFePO4 4000.webp

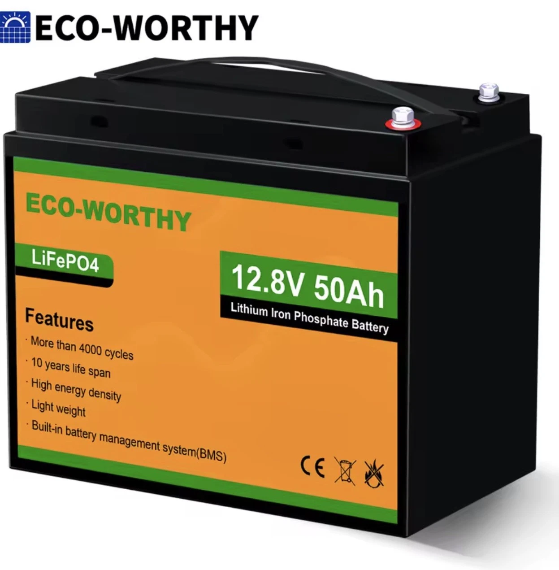
Totem Components/ECO-WORTHY 12V 50Ah Lithium Battery LiFePO4 4000.webp
