Madina1219/ConnectGuinea/Totem Components/Hailege 2Pcs INA226 I2C IIC Bi-Directional Current Monitoring Sensor Power.webp

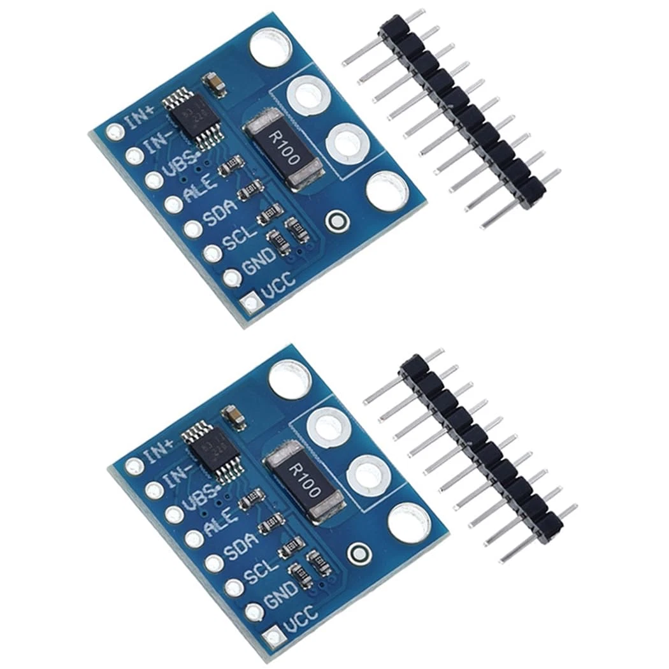
Totem Components/Hailege 2Pcs INA226 I2C IIC Bi-Directional Current Monitoring Sensor Power.webp
