Madina1219/ConnectGuinea/Totem Components/IMG_8061.jpeg

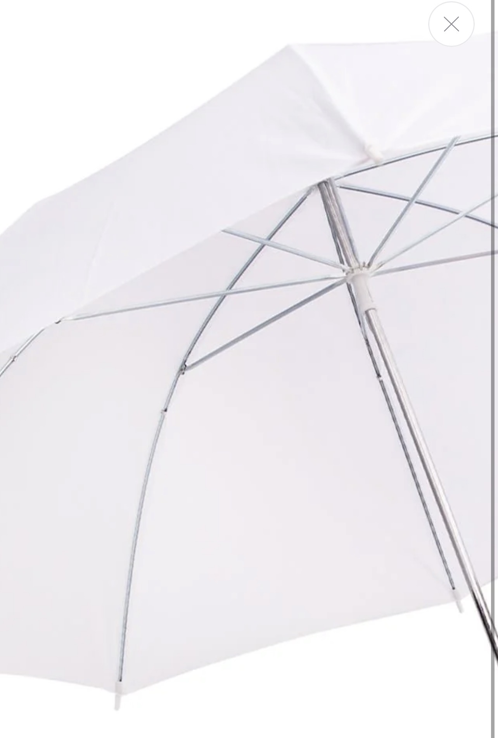
Totem Components/IMG_8061.jpeg
