Madina1219/ConnectGuinea/Totem Components/IMG_8063.jpeg

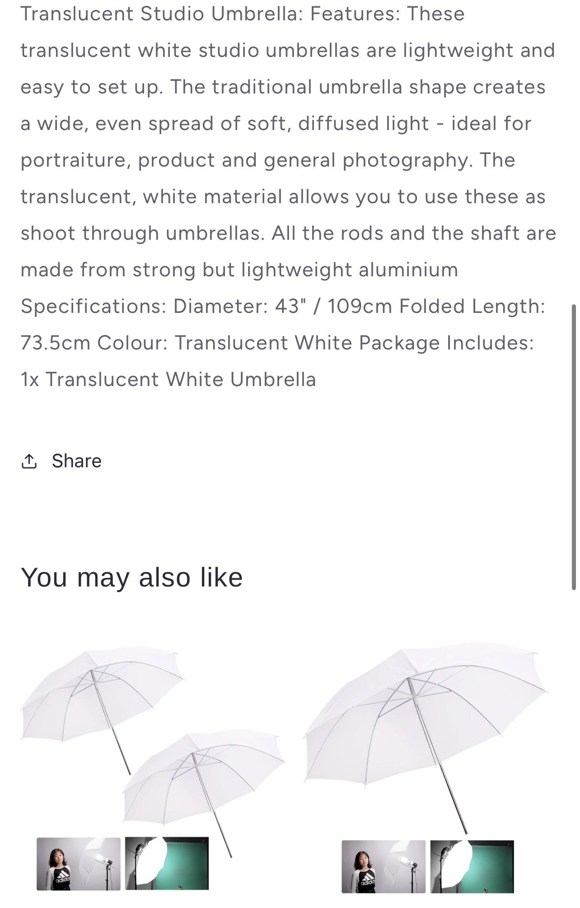
Totem Components/IMG_8063.jpeg
