Madina1219/ConnectGuinea/Totem Components/IMG_8112.jpeg

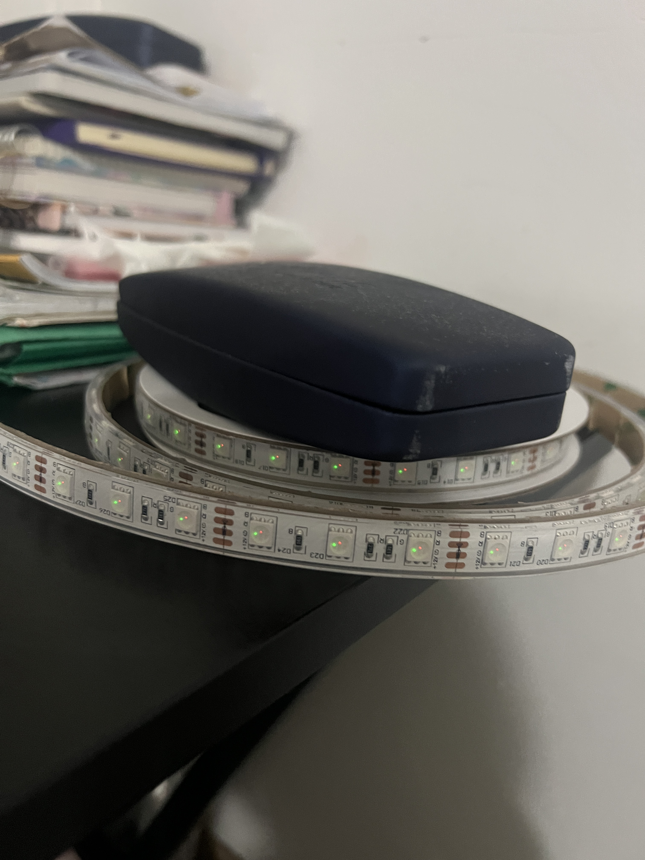
Totem Components/IMG_8112.jpeg
