Madina1219/ConnectGuinea/Totem Components/IMG_8382.jpeg

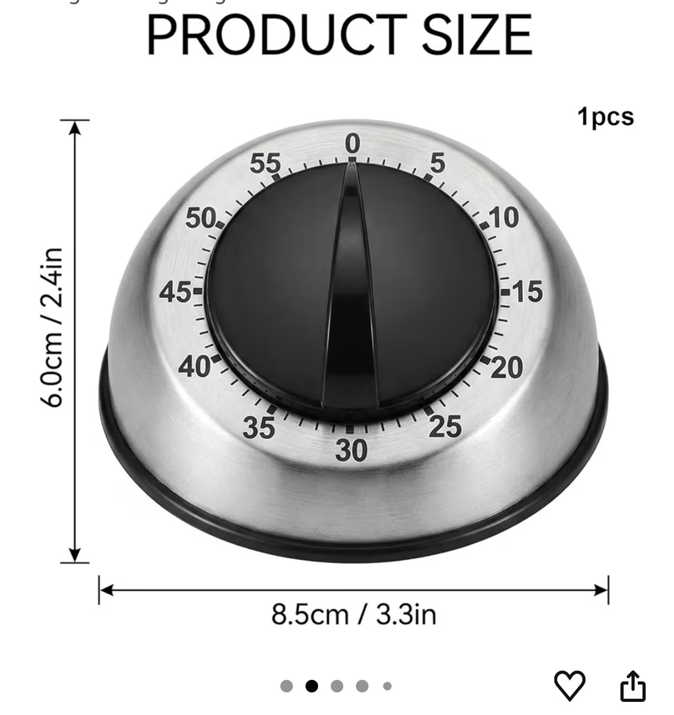
Totem Components/IMG_8382.jpeg
