Madina1219/ConnectGuinea/Totem Components/IMG_8453.jpeg

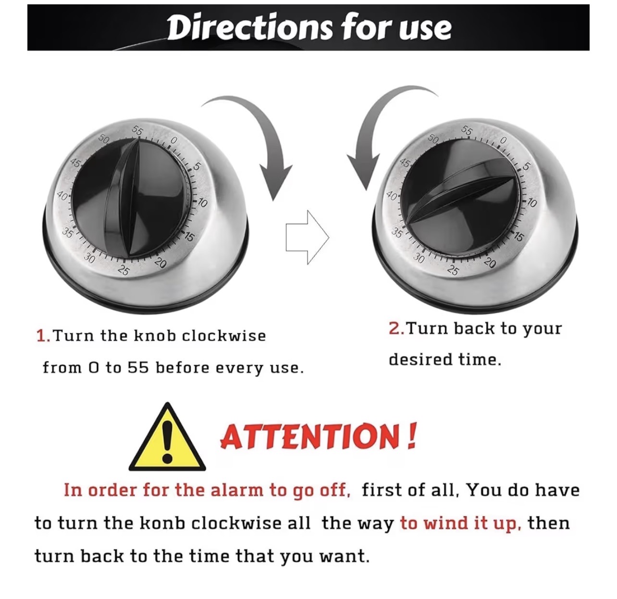
Totem Components/IMG_8453.jpeg
