Madina1219/ConnectGuinea/Totem Components/IP68-Waterproof-Flexible-RGB-LED-Strip-12V_LRG-150x150.jpg

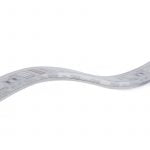
Totem Components/IP68-Waterproof-Flexible-RGB-LED-Strip-12V_LRG-150x150.jpg
