Madina1219/ConnectGuinea/Totem Components/IRFZ44N Power MOSFET N-Channel 49A 55V HEXFET Transistor.webp

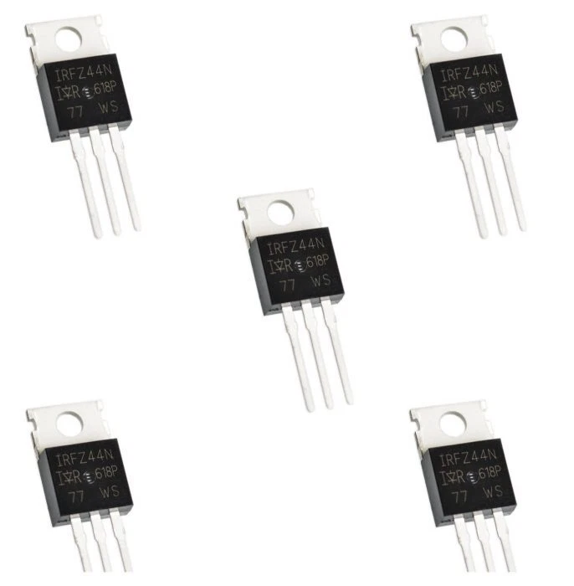
Totem Components/IRFZ44N Power MOSFET N-Channel 49A 55V HEXFET Transistor.webp
