Madina1219/ConnectGuinea/Totem Components/PARASOL BASE.C.JPG

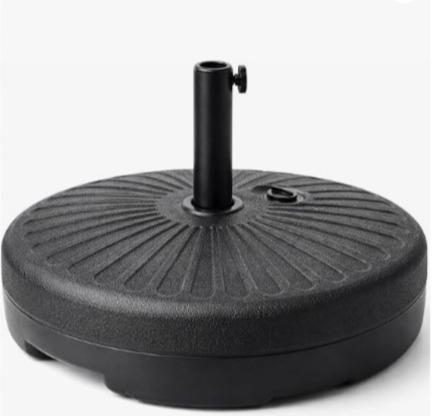
Totem Components/PARASOL BASE.C.JPG
