Madina1219/ConnectGuinea/Totem Components/PARASOL BASE.jpg

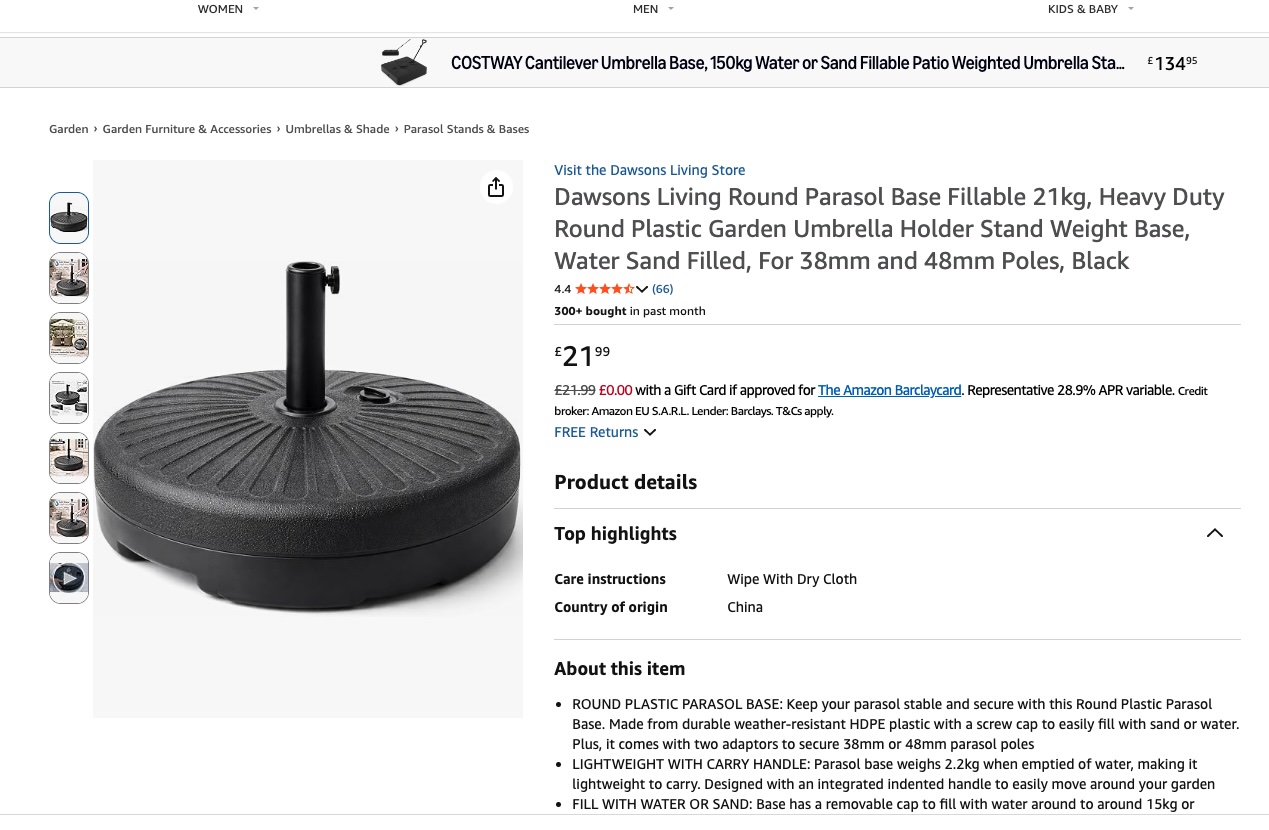
Totem Components/PARASOL BASE.jpg
