Madina1219/ConnectGuinea/Totem Components/Picture1.png

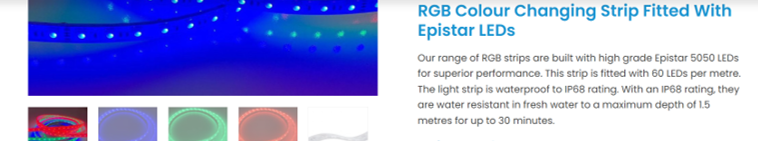
Totem Components/Picture1.png
