Madina1219/ConnectGuinea/Totem Components/Pole.C.JPG

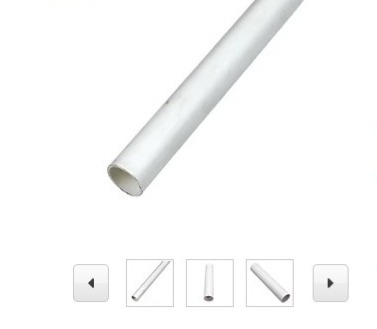
Totem Components/Pole.C.JPG
