Madina1219/ConnectGuinea/Totem Components/Pole.jpg

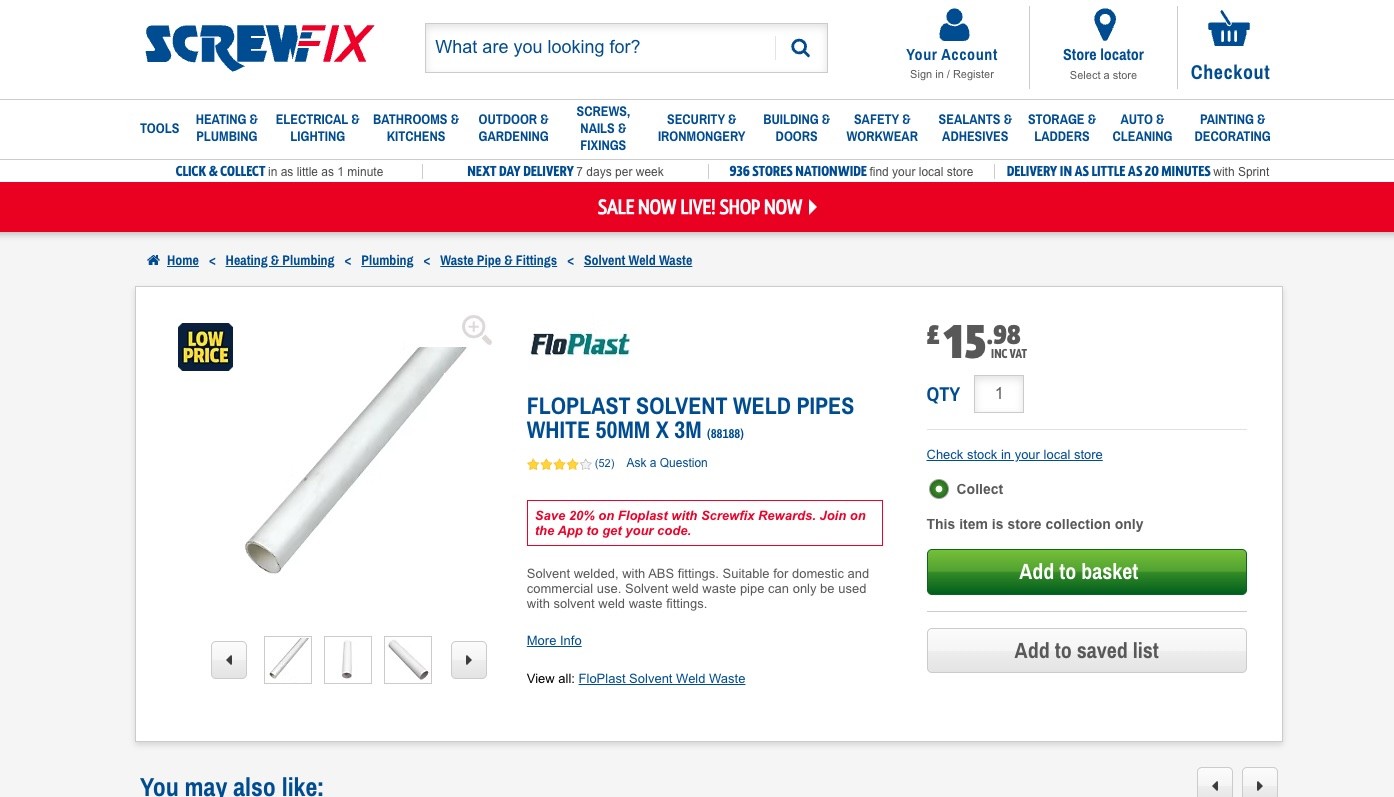
Totem Components/Pole.jpg
