Madina1219/ConnectGuinea/Totem Components/RGB-full-range-IP68-12v.jpg

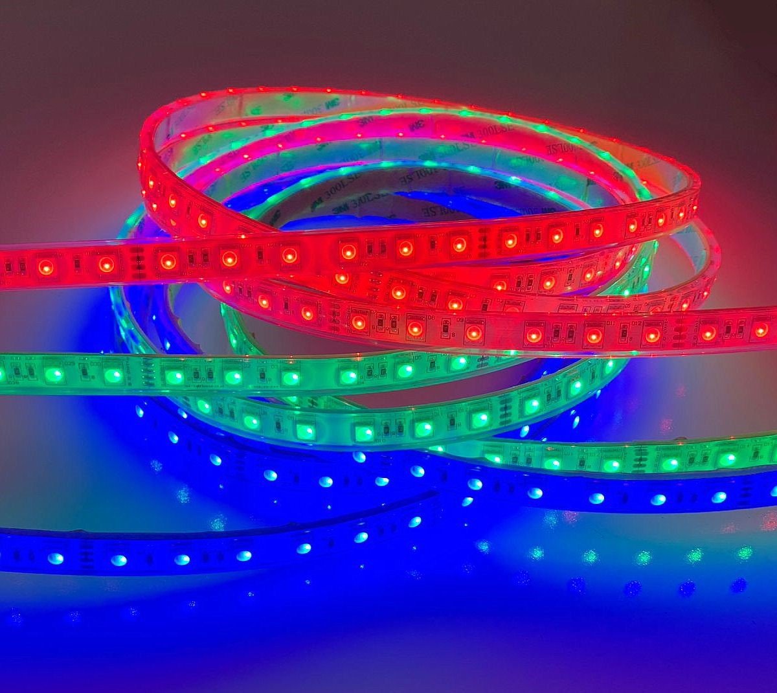
Totem Components/RGB-full-range-IP68-12v.jpg
