Madina1219/ConnectGuinea/Totem Components/Ring Led.JPG

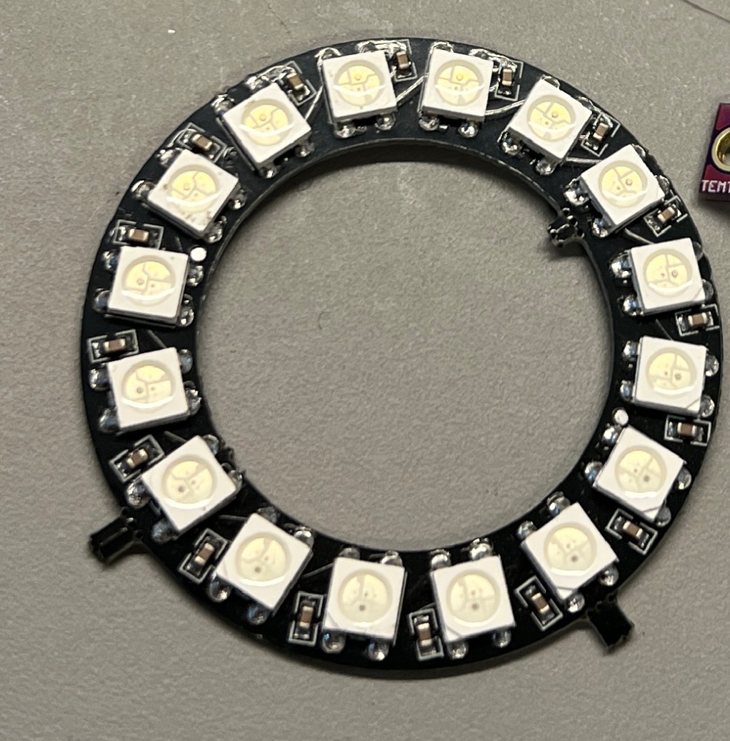
Totem Components/Ring Led.JPG
