Madina1219/ConnectGuinea/Totem Components/TEMT6000 Ambient Light Sensor.webp

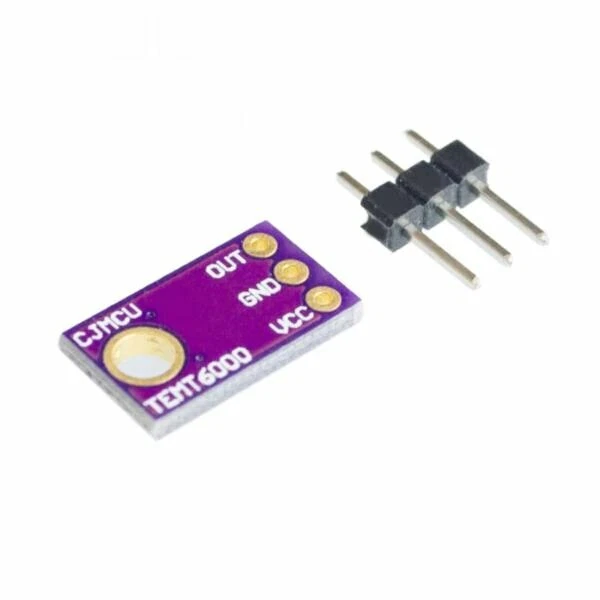
Totem Components/TEMT6000 Ambient Light Sensor.webp
