Madina1219/ConnectGuinea/Totem Components/Victron Energy SmartSolar MPPT 100-20 Solar Charge Controller.webp

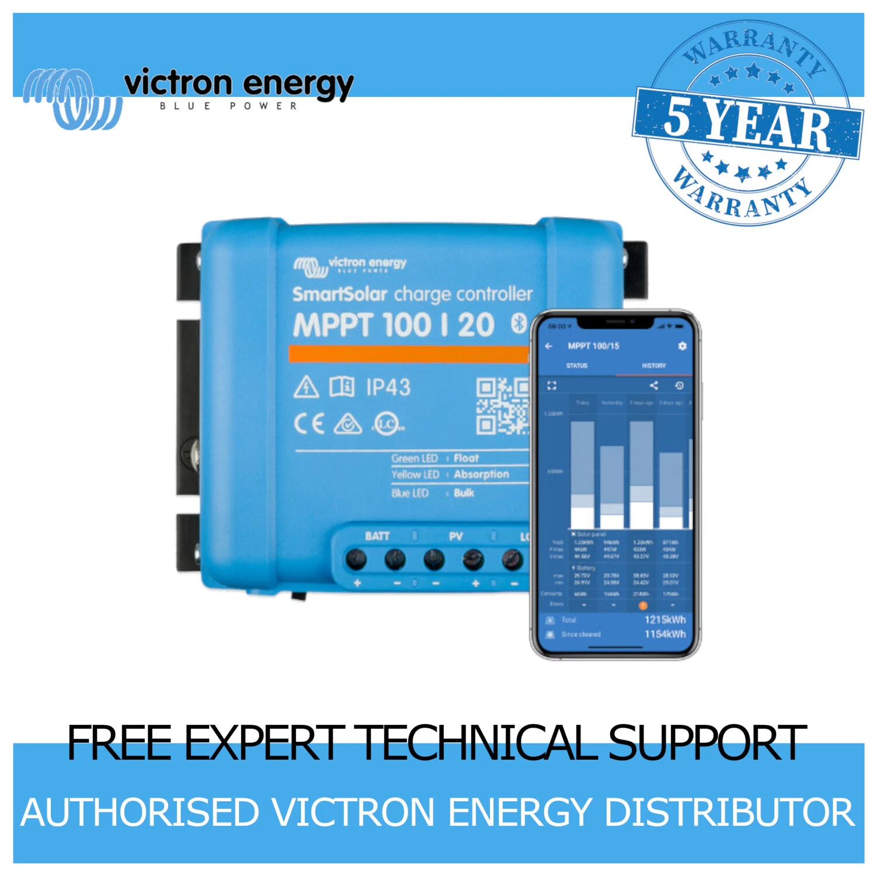
Totem Components/Victron Energy SmartSolar MPPT 100-20 Solar Charge Controller.webp
