Madina1219/ConnectGuinea/docs/SmartLight Totem Wiring Reference_v3.docx

SmartLight Totem -Wiring Reference

# Stage 1- Heltec WiFi LoRa 32 V3.2 on the PCB Matrix Board

Layout strategy: 3.3V logic components sit on the left matrix columns, 5V devices (NeoPixel rings, SD card) sit on the right columns, with one empty buffer column left between the two zones. The ground rail is bridged and tied at a single point near the Heltec , two separate GND wires run from two different Heltec GND pins (one per voltage domain), which is safe because all GND pins share the same internal ground plane.

Component Pin | Connects To | Notes
Heltec 3.3V pin | Left‑zone + rail | Powers 3.3V logic components (TEMT6000, INA219, DS3231)
Heltec GND pin (1 of 2) | Left‑zone – rail | Tied to the single ground point near the Heltec
Heltec 5V / VEXT pin | Right‑zone + rail | Powers 5V devices - NeoPixel rings, SD card module
Heltec GND pin (2 of 2) | Right‑zone – rail | Bridged back to the same single ground point

# Stage 2 - TEMT6000 Ambient Light Sensor (GPIO1)

The TEMT6000 is a small 3‑leg sensor that looks like a transistor. With the flat face towards you: left leg is Emitter, middle is Base (signal), right is Collector.

Component Pin | Connects To | Notes
Left leg (Emitter) | GND rail (left zone) | Ground
Middle leg (Base) | GPIO1 | Analog signal to Heltec
Right leg (Collector) | 3.3V rail (left zone) | Power

Firmware thresholds use hysteresis to avoid flicker at the crossover point:

- TURN_ON threshold: 30 (below this, treated as dark - night mode)
- TURN_OFF threshold: 150 (above this, treated as daylight - standby mode)

# Stage 3 - NeoPixel Status Rings (GPIO38)

Two 24‑LED NeoPixel rings are chained together and act as both the flood‑alert indicator and the overall system status light. Each ring has three pads: 5V DC Power, GND, and Data (DIN/DOUT).

Component Pin | Connects To | Notes
Ring 1 — 5V DC Power | VEXT (5V, right zone) | Power for both rings
Ring 1 — GND | GND rail (right zone) | Ground
Ring 1 — DIN | GPIO38 | Signal from Heltec
Ring 1 — DOUT | Ring 2 - DIN | Chains the second ring off the first
Ring 2 — 5V / GND | Same 5V / GND rail as Ring 1 | Shared power with Ring 1

Status colour states:

- Ambar - daytime standby
- Green - active at night
- Blue - flood alert

# Stage 4 -12V RGB LED Strip + MOSFET Driver (GPIO19 / 20 / 21)

Three IRLZ44N MOSFETs switch the red, green and blue channels of the 12V LED strip. Each MOSFET has three legs : Gate (G), Drain (D), Source (S) , left to right when the flat face is towards you.

## MOSFET - Red channel (GPIO19)

Component Pin | Connects To | Notes
Gate (G) | GPIO19 via 220Ω resistor | Signal from Heltec
Gate (G) | GND rail via 10kΩ resistor | Pull‑down to prevent floating
Drain (D) | LED strip Red wire | Switches the red channel
Source (S) | GND rail | Common ground

## MOSFET- Green channel (GPIO20)

Component Pin | Connects To | Notes
Gate (G) | GPIO20 via 220Ω resistor | Signal from Heltec
Gate (G) | GND rail via 10kΩ resistor | Pull‑down to prevent floating
Drain (D) | LED strip Green wire | Switches the green channel
Source (S) | GND rail | Common ground

## MOSFET - Blue channel (GPIO21)

Component Pin | Connects To | Notes
Gate (G) | GPIO21 via 220Ω resistor | Signal from Heltec
Gate (G) | GND rail via 10kΩ resistor | Pull‑down to prevent floating
Drain (D) | LED strip Blue wire | Switches the blue channel
Source (S) | GND rail | Common ground

# Stage 5 - LED Strip Power: Battery to Strip

The 12V RGB strip is powered directly from the battery's 12V bus, not from a standalone wall adapter. Power comes from the Victron SmartSolar MPPT charge controller, which charges and discharges the LiFePO4 battery onto a shared 12V bus.

Component Pin | Connects To | Notes
LiFePO4 battery +12V (via Victron 12V bus) | LED strip +12V wire | Direct connection - not switched
LiFePO4 battery GND / 12V bus – | GND rail (single ground point) | Shared ground with Heltec and all logic
LED strip +12V wire | All three MOSFET Drain (D) legs | Common +12V rail feeding all three channels; each channel's return path is switched independently at its own MOSFET Source

# Stage 6 - INA219 Power Monitor (I2C + In‑line Current Sense)

The INA219 measures voltage, current and power on the 12V supply line. It connects via I2C for readout and sits in series on the positive 12V wire so that load current physically flows through it. This module appears at I2C address 0x41 (not the default 0x40).

## I2C connections

Component Pin | Connects To | Notes
VCC | 3.3V rail (left zone) | Power
GND | GND rail | Ground
SDA | GPIO41 | I2C data - shared bus with DS3231
SCL | GPIO42 | I2C clock - shared bus with DS3231

## In‑line current measurement

Component Pin | Connects To | Notes
VIN+ | Battery / Victron 12V bus, positive | Current flows in here, from the battery side
VIN– | LED strip +12V wire (load side) | Current flows out to the load being measured

# Stage 7 - DS3231 RTC Module (shares I2C bus with INA219)

The DS3231 Real Time Clock provides accurate timestamps for SD card data logging. It shares the same I2C bus as the INA219 (GPIO41/42) and keeps time via its own CR2032 coin battery when main power is off. Firmware uses the DS3231 library directly, not RTClib.

Component Pin | Connects To | Notes
VCC | 3.3V rail (left zone) | Power
GND | GND rail | Ground
SDA | GPIO41 | I2C data — shared bus with INA219
SCL | GPIO42 | I2C clock — shared bus with INA219

# Stage 8 - SD Card Module (SPI2, GPIO33–36)

The SD card module uses the second SPI bus on GPIO33–36, kept separate from the LoRa radio's SPI pins. VCC must come from the 5V (VEXT) rail — 3.3V is not sufficient for this module. SPI runs at 1MHz and the card is formatted FAT32, logging CSV data.

Component Pin | Connects To | Notes
CS | GPIO33 | Chip select
SCK | GPIO34 | SPI clock (1MHz)
MOSI | GPIO35 | Data to SD card
MISO | GPIO36 | Data from SD card
VCC | VEXT (5V, right zone) | Power — must be 5V, not 3.3V
GND | GND rail (right zone) | Ground

# Stage 9- Power Architecture: Battery to Every Rail

Everything on the board is ultimately powered from a single chain: solar input → charge controller → battery → 12V bus → buck converters. There is no separate wall adapter in the exhibition build.

- Victron SmartSolar MPPT charge controller manages charge/discharge of the LiFePO4 battery.
- The LiFePO4 battery sits on a shared 12V bus, feeding the LED strip directly and both buck converters.
- Buck Converter #1 steps the 12V bus down to 5V for the Heltec and its onboard logic/sensor rail.
- Buck Converter #2 is a dedicated, separate unit that steps the 12V bus down to 5V for USB phone charging only , fed from the Victron LOAD terminals, kept electrically apart from Buck Converter #1 so a phone‑charging load can't sag the Heltec's own supply (and disturb LoRa radio operation).
- For the exhibition itself, the battery will be pre‑charged in advance and run standalone, no live solar panel connected on the day. The Victron's Bluetooth interface is read separately (phone app) for solar‑harvest and battery data for the thesis energy‑balance calculations and isn't wired into the Heltec.

The two buck converters- Heltec/logic supply (left) kept physically and electrically separate from the dedicated USB‑charging supply (right).

# Stage 10- USB Charging Port: Battery to Port

The USB charging port draws from Buck Converter #2 (Stage 9), not from Buck Converter #1 or directly from the Heltec's own supply.

Component Pin | Connects To | Notes
Victron LOAD terminal + | Buck Converter #2, input + | 12V bus in
Victron LOAD terminal – | Buck Converter #2, input – / shared GND | Common ground with the rest of the board
Buck Converter #2, output (5V) | USB port power input | Confirmed working under real phone‑charging load
USB port GND | GND rail (single ground point) | Shared ground

The timer mechanism that cuts USB power after a session is still under review between three options:

- A GPIO40 MOSFET switching the Buck Converter #2 output, controlled by firmware timer logic (leading prototype below).
- A mechanical spring‑wound timer switch, paired with an SPDT selector so only one of two USB ports can draw power at a time , currently the favoured option, to physically prevent simultaneous dual‑port charging.
- A standalone 555‑timer circuit as a non‑microcontroller fallback.

## Reference: GPIO40 MOSFET timer sketch (firmware option, pending final decision)

const int buttonPin = 2; const int mosfetPin = 40; bool lastButtonState = HIGH; bool charging = false; unsigned long chargeStart = 0; const unsigned long chargeDuration = 5UL * 60UL * 1000UL; // 5 minutes void setup() { pinMode(buttonPin, INPUT_PULLUP); pinMode(mosfetPin, OUTPUT); digitalWrite(mosfetPin, LOW); // off by default Serial.begin(115200); } void loop() { bool reading = digitalRead(buttonPin); if (reading == LOW && lastButtonState == HIGH && !charging) { charging = true; chargeStart = millis(); digitalWrite(mosfetPin, HIGH); } lastButtonState = reading; if (charging && (millis() - chargeStart >= chargeDuration)) { charging = false; digitalWrite(mosfetPin, LOW); } delay(10); }

USB charging port hardware.

# GPIO Assignment Summary

Component Pin | Connects To | Notes
GPIO1 | TEMT6000 signal | Analog input - ambient light sensor
GPIO19 | MOSFET Red gate | 12V LED strip - red channel
GPIO20 | MOSFET Green gate | 12V LED strip - green channel
GPIO21 | MOSFET Blue gate | 12V LED strip - blue channel
GPIO33 | SD card CS | SPI2 chip selects
GPIO34 | SD card SCK | SPI2 clock (1MHz)
GPIO35 | SD card MOSI | SPI2 data out
GPIO36 | SD card MISO | SPI2 data in
GPIO38 | NeoPixel ring DIN | Status / flood‑alert indicator, chained rings
GPIO40 | MOSFET USB gate (leading option) | USB charging timer switch - decision pending, see Stage 10
GPIO41 | I2C SDA | Shared bus - INA219 + DS3231
GPIO42 | I2C SCL | Shared bus - INA219 + DS3231
VEXT (5V) | SD card VCC + NeoPixel rings 5V | 5V output pin on Heltec -right‑zone rail

# Active PCB Issues (Working Log)

Four issues are open on the current solderable PCB. Debugging approach for all of them: isolate with a minimal single‑subsystem sketch, confirm with a multimeter, then reintroduce components one at a time, never test everything together while something is broken.

- SD card not initialising - SPI loopback test returns 0x00 instead of 0xA5. Suspected GPIO or solder issue on the SPI2 lines.
- NeoPixel VCC reads 3.2V at the ring despite 5V at the board - suspected resistive cold solder joint on the VCC wire.
- 12V LED strip stopped working after more components were soldered in - suspected ground loop from a separate 12V feed not sharing the single ground point.
- LoRa receiver on the totem board returns error ‑2 whenever all peripherals are wired together -suspected power instability under combined LoRa + peripheral load. Next test: run from battery via the buck converter rather than USB, to see whether USB‑supply instability is the cause.

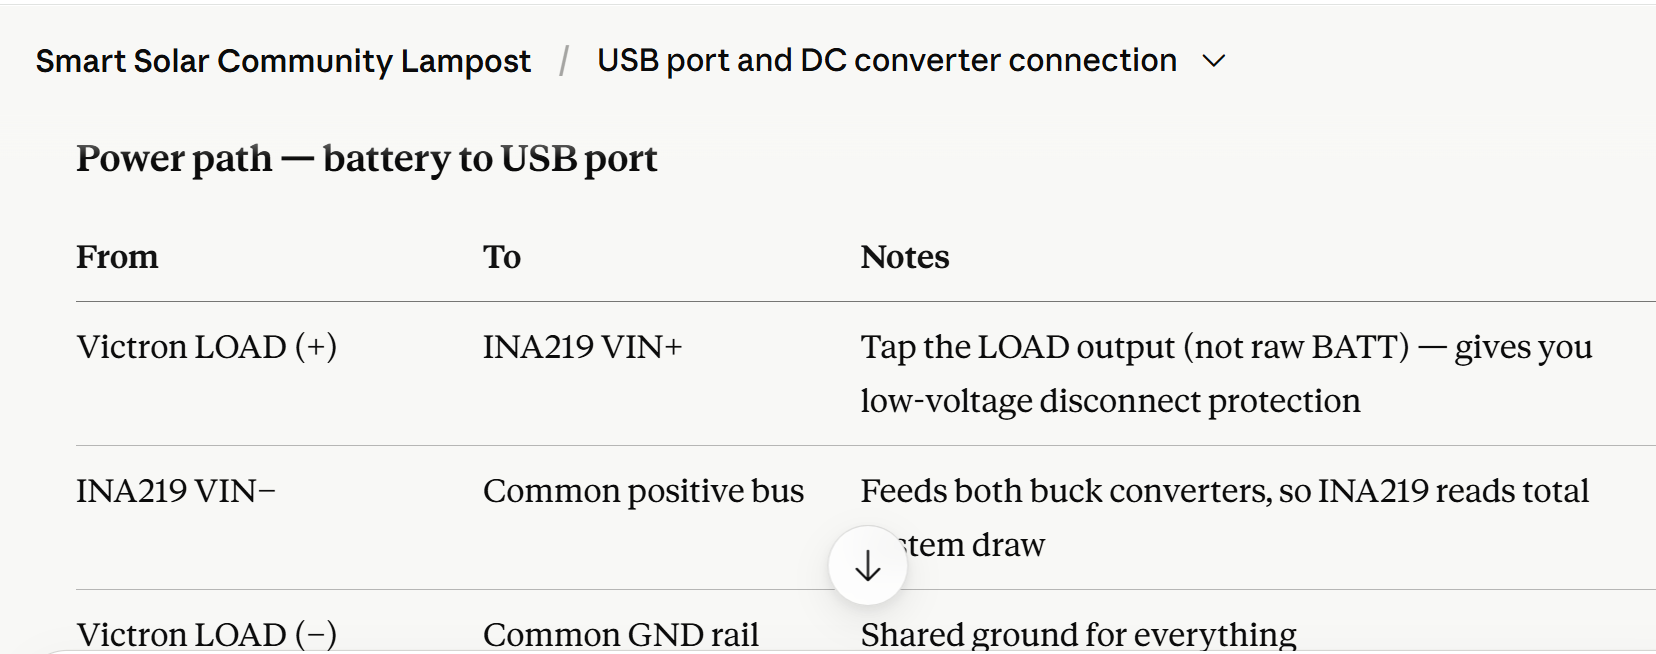
[picture p171: figure]
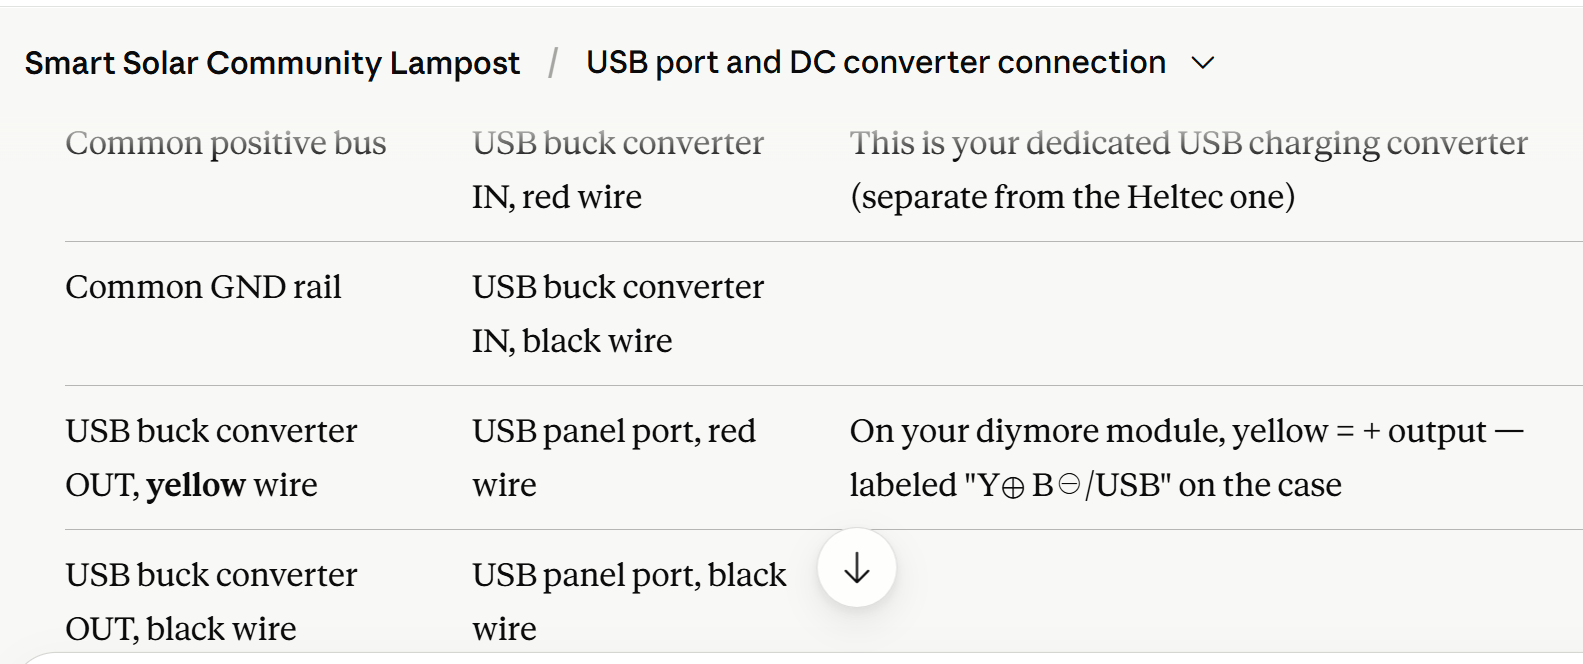
[picture p172: figure]
