Madina1219/ConnectGuinea/Building Phases/IMG_7936.jpeg

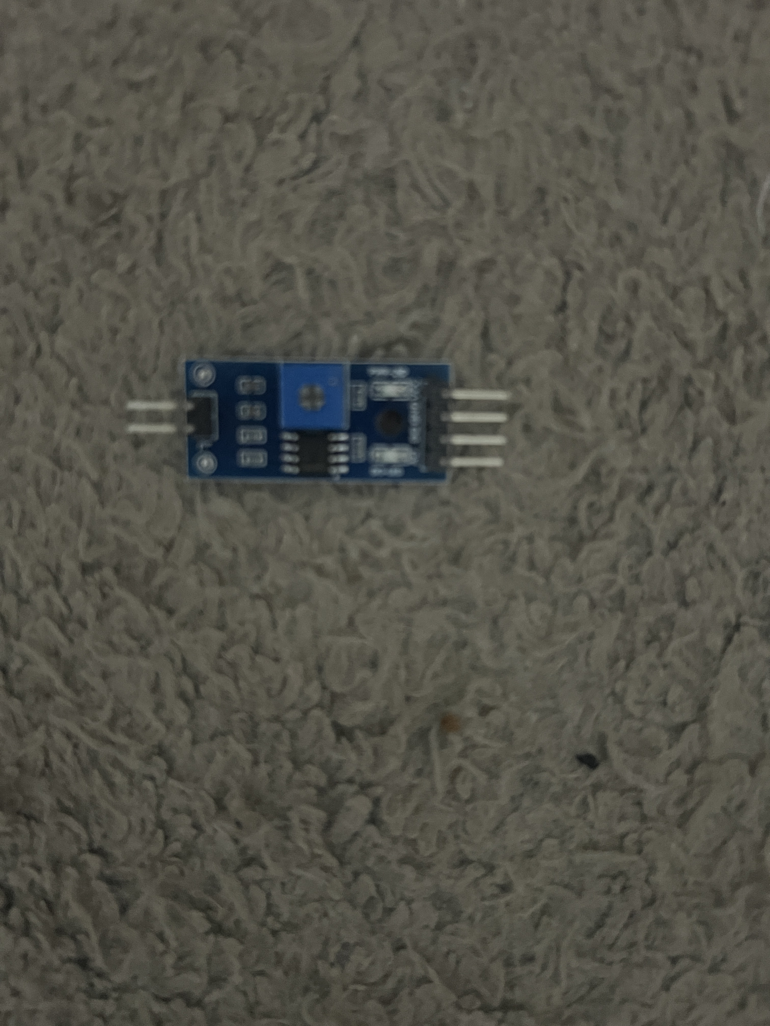
Building Phases/IMG_7936.jpeg
