Madina1219/ConnectGuinea/Building Phases/IMG_7943.jpeg

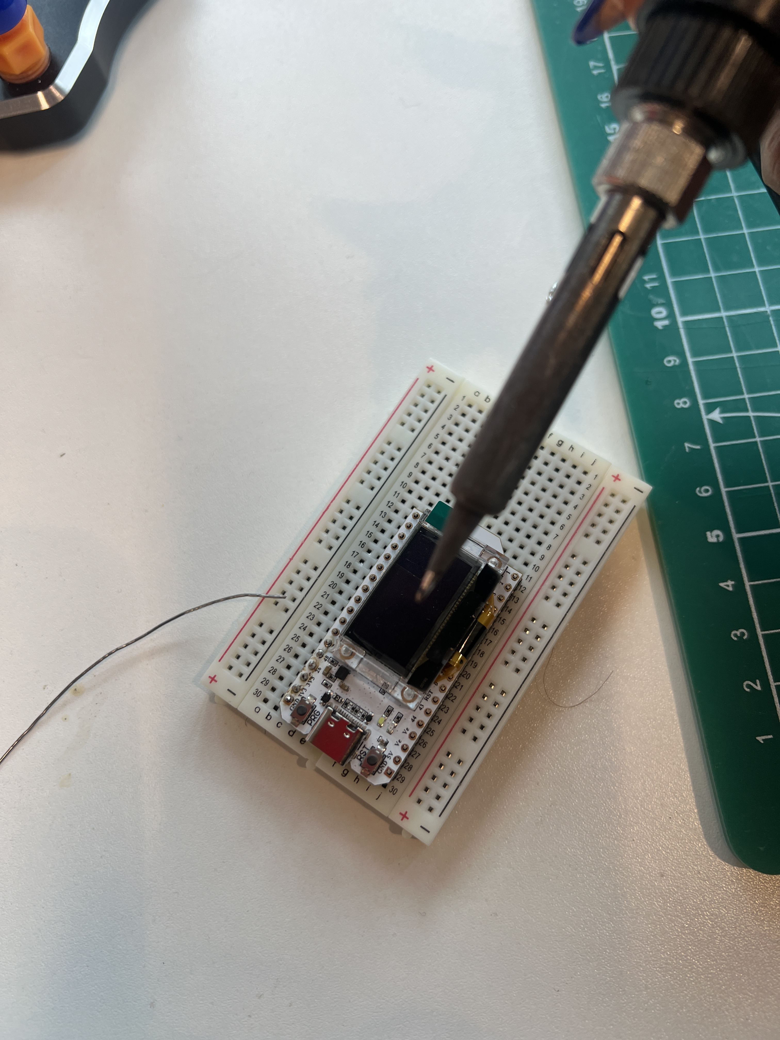
Building Phases/IMG_7943.jpeg
