Madina1219/ConnectGuinea/Building Phases/IMG_8074.jpeg

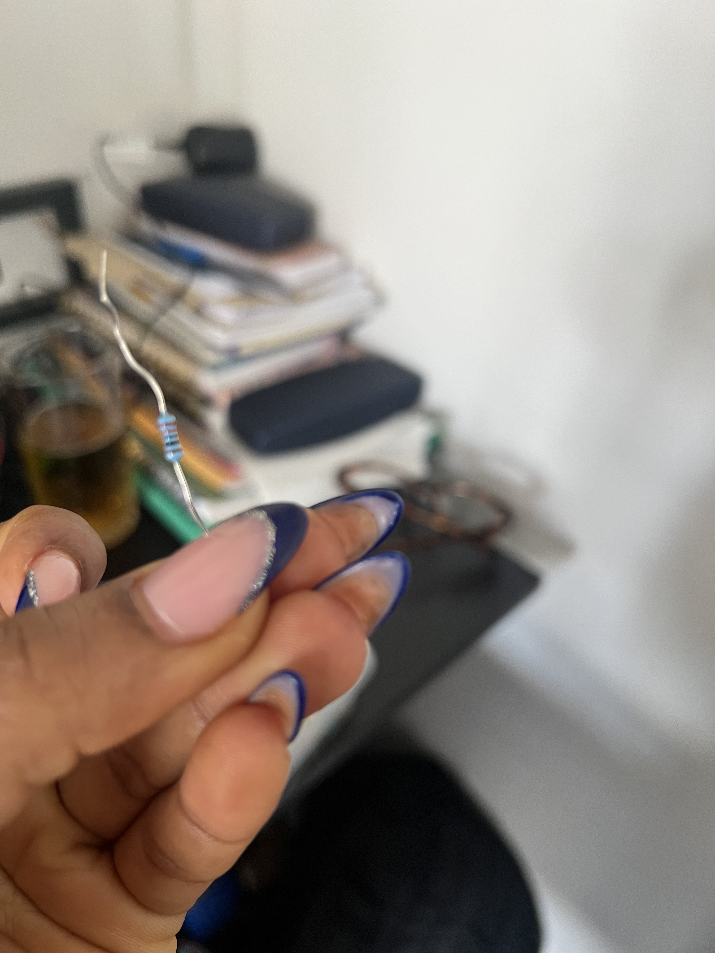
Building Phases/IMG_8074.jpeg
