Madina1219/ConnectGuinea/Building Phases/IMG_8076.jpeg

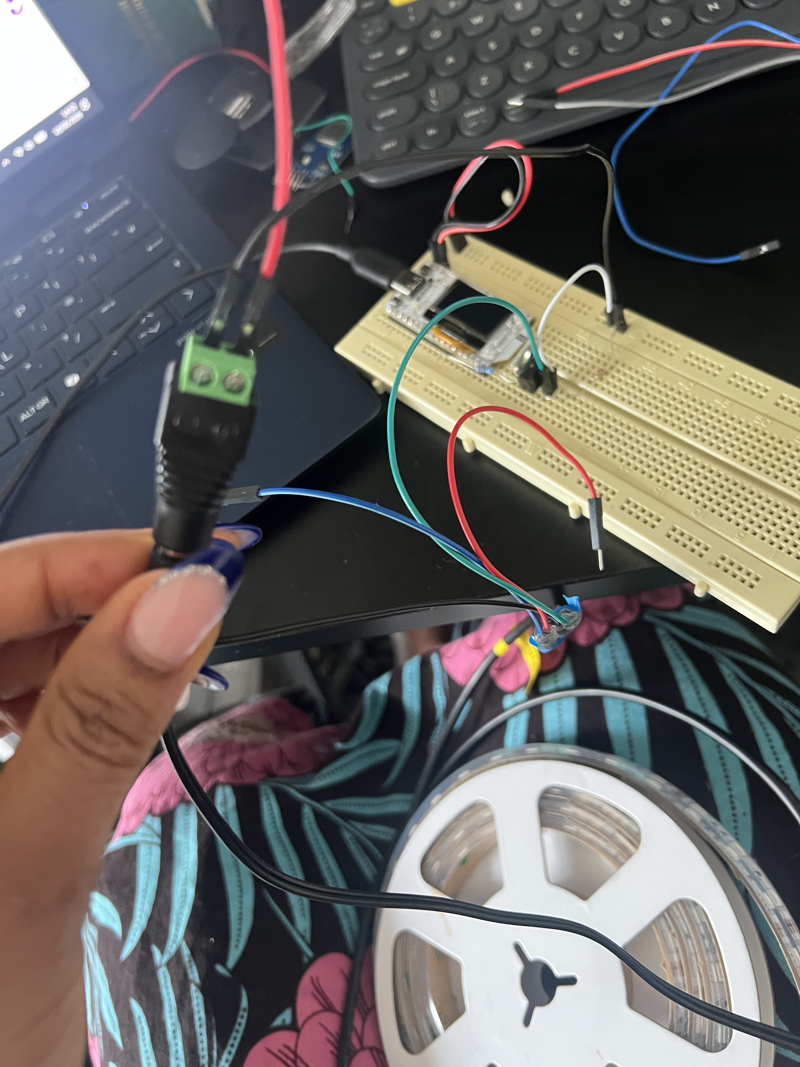
Building Phases/IMG_8076.jpeg
