Madina1219/ConnectGuinea/Building Phases/IMG_8078.jpeg

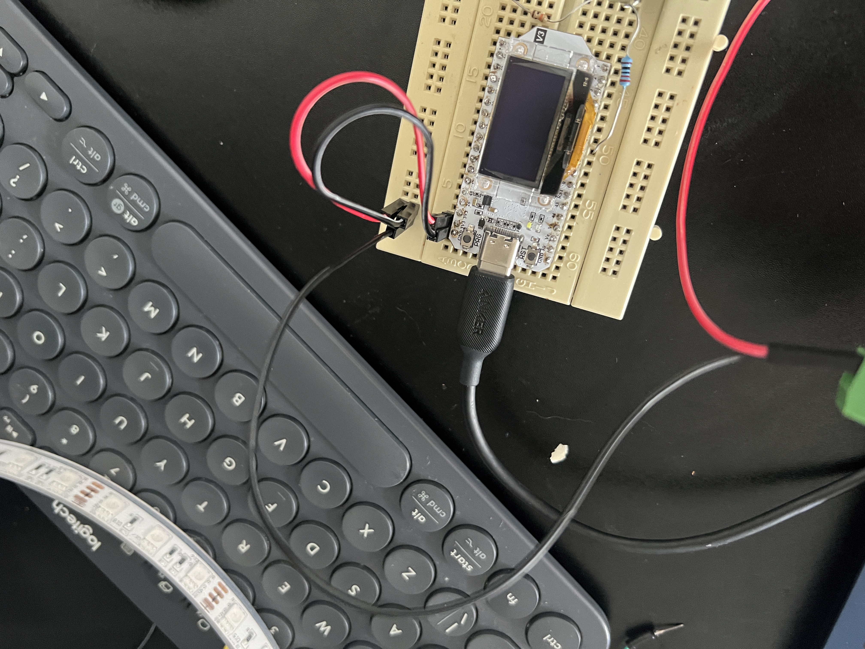
Building Phases/IMG_8078.jpeg
