Madina1219/ConnectGuinea/Building Phases/IMG_8080.jpeg

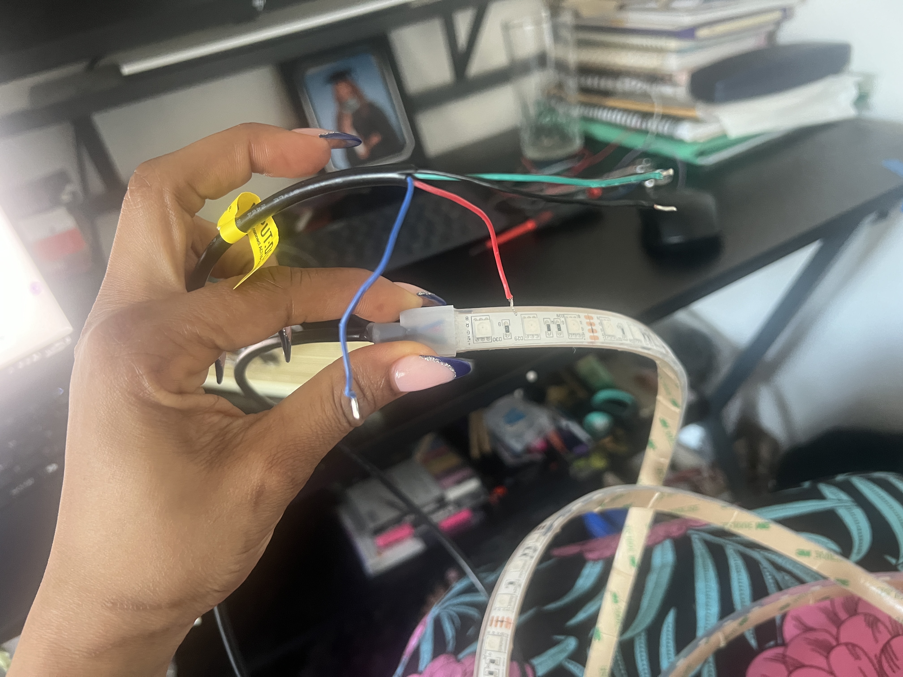
Building Phases/IMG_8080.jpeg
