Madina1219/ConnectGuinea/Building Phases/IMG_8081.jpeg

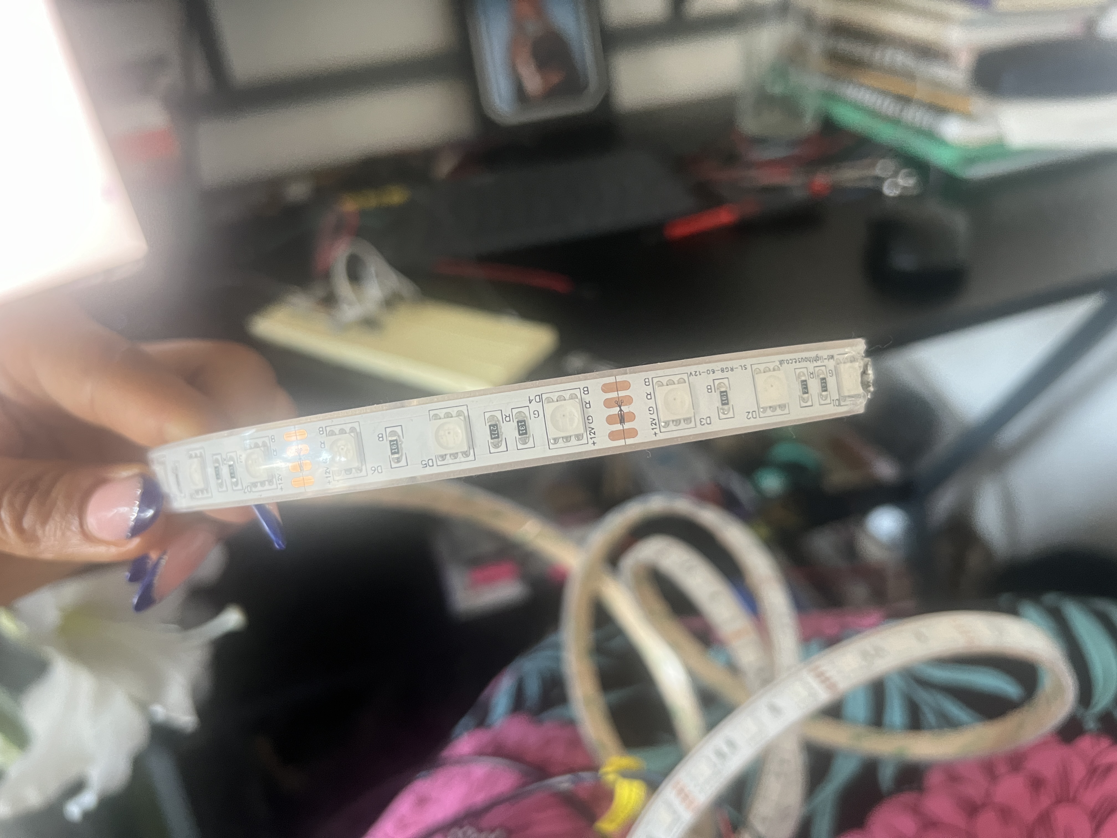
Building Phases/IMG_8081.jpeg
