Madina1219/ConnectGuinea/Building Phases/IMG_8086.jpeg

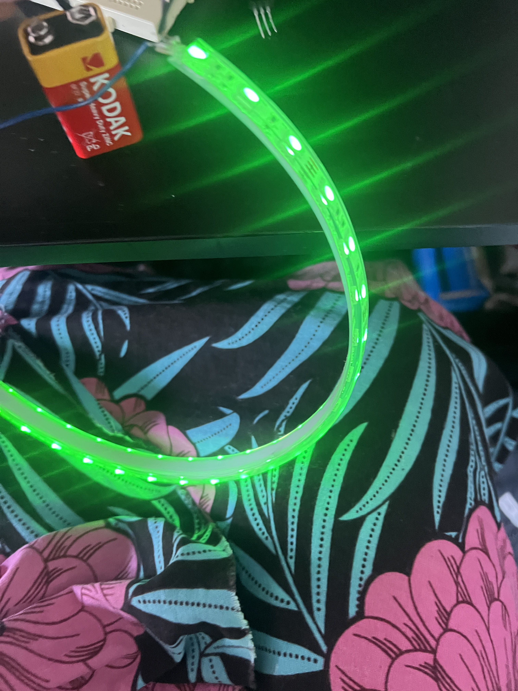
Building Phases/IMG_8086.jpeg
