Madina1219/ConnectGuinea/Building Phases/IMG_8087.jpeg

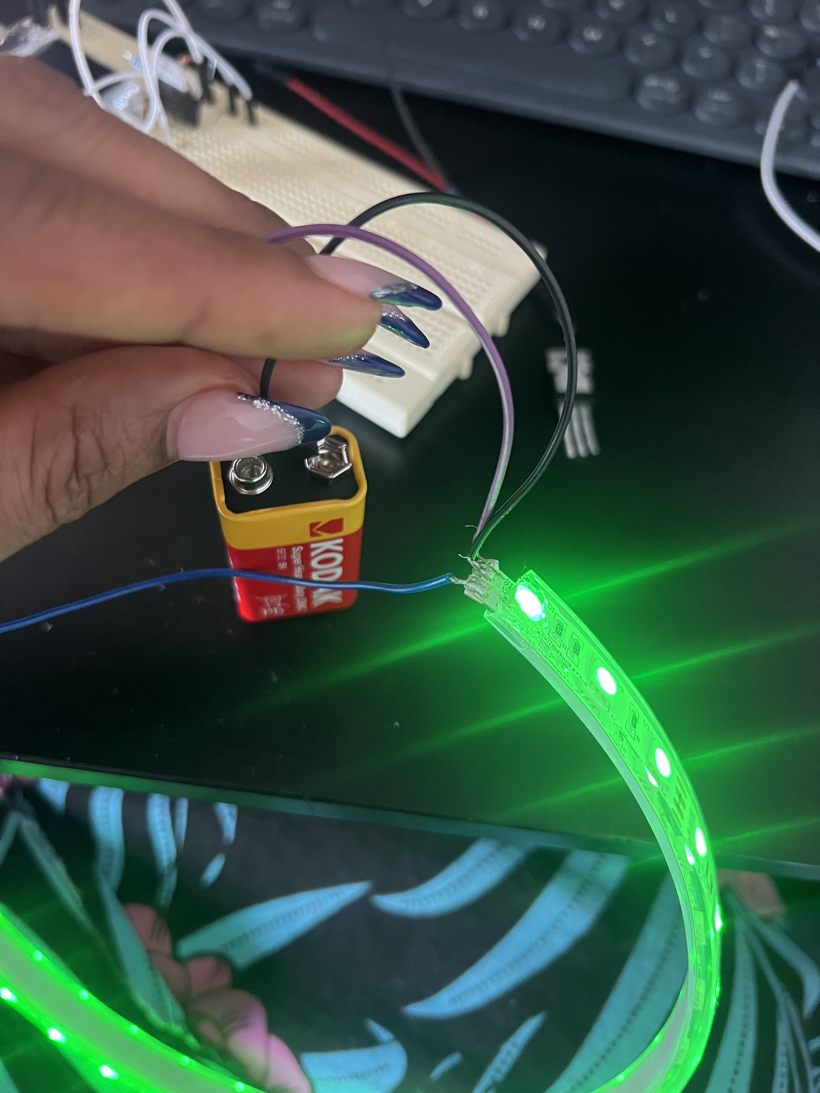
Building Phases/IMG_8087.jpeg
