Madina1219/ConnectGuinea/Building Phases/IMG_8097.jpeg

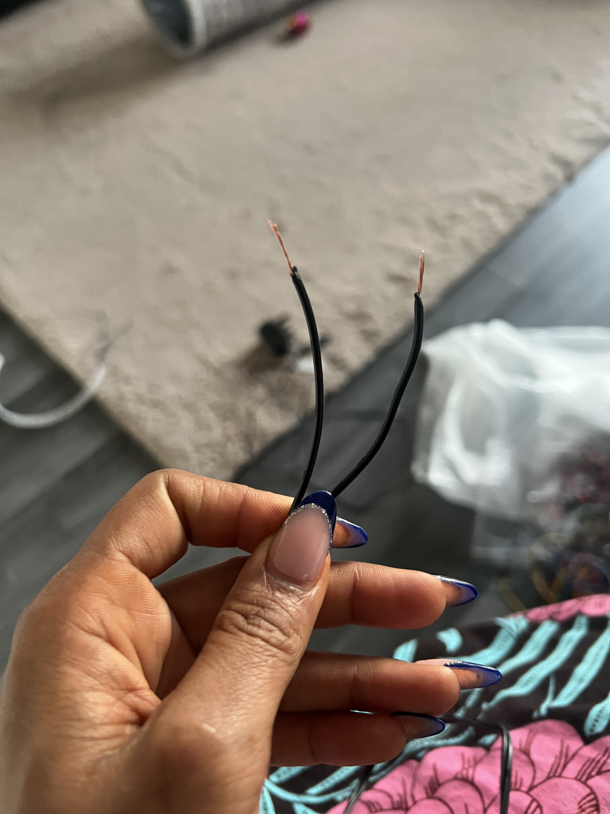
Building Phases/IMG_8097.jpeg
