Madina1219/ConnectGuinea/Building Phases/IMG_8098.jpeg

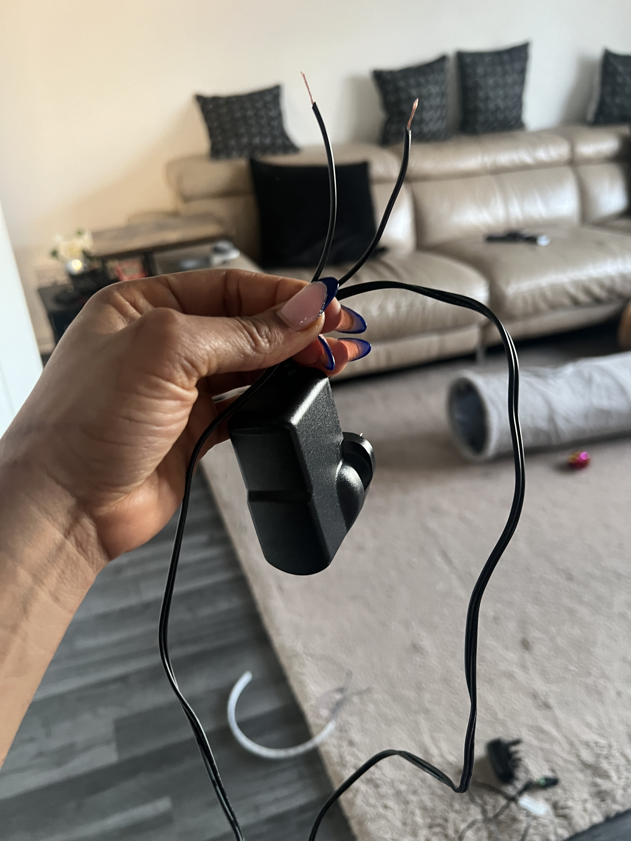
Building Phases/IMG_8098.jpeg
