Madina1219/ConnectGuinea/Building Phases/IMG_8100.jpeg

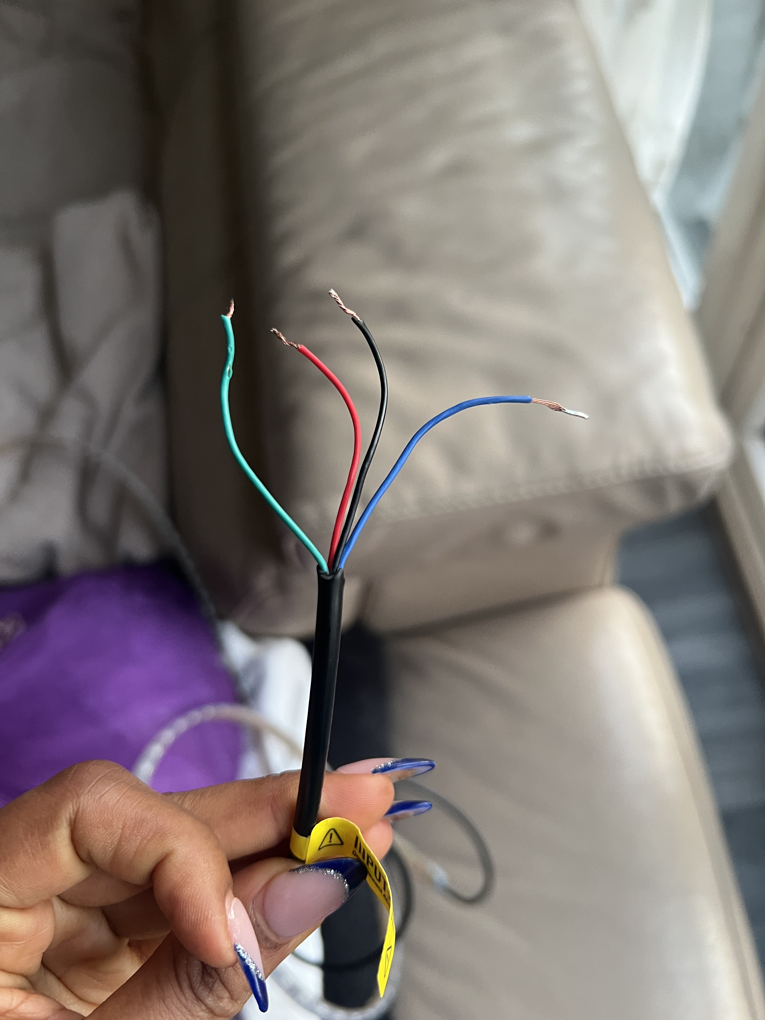
Building Phases/IMG_8100.jpeg
