Madina1219/ConnectGuinea/Building Phases/IMG_8101.jpeg

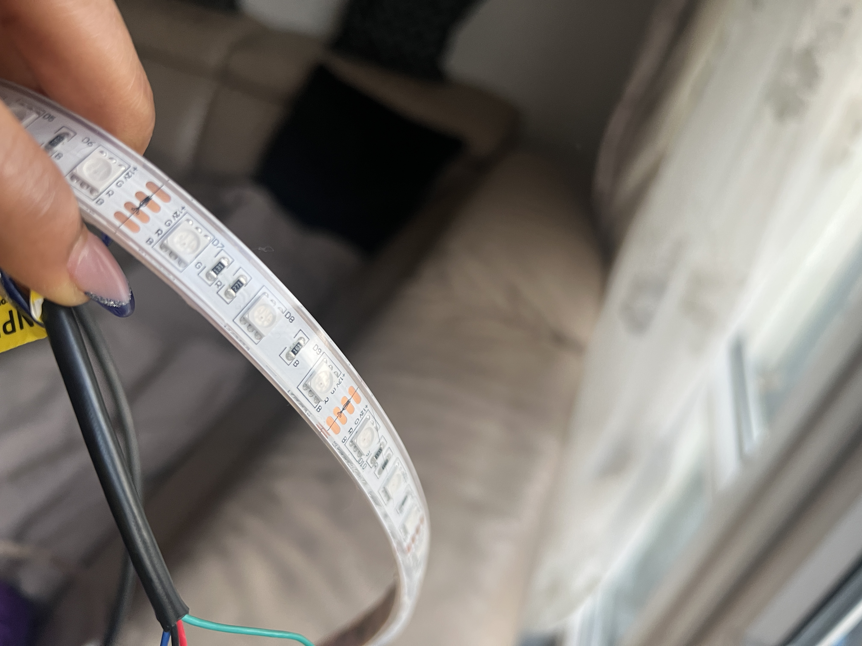
Building Phases/IMG_8101.jpeg
