Madina1219/ConnectGuinea/Building Phases/IMG_8102.jpeg

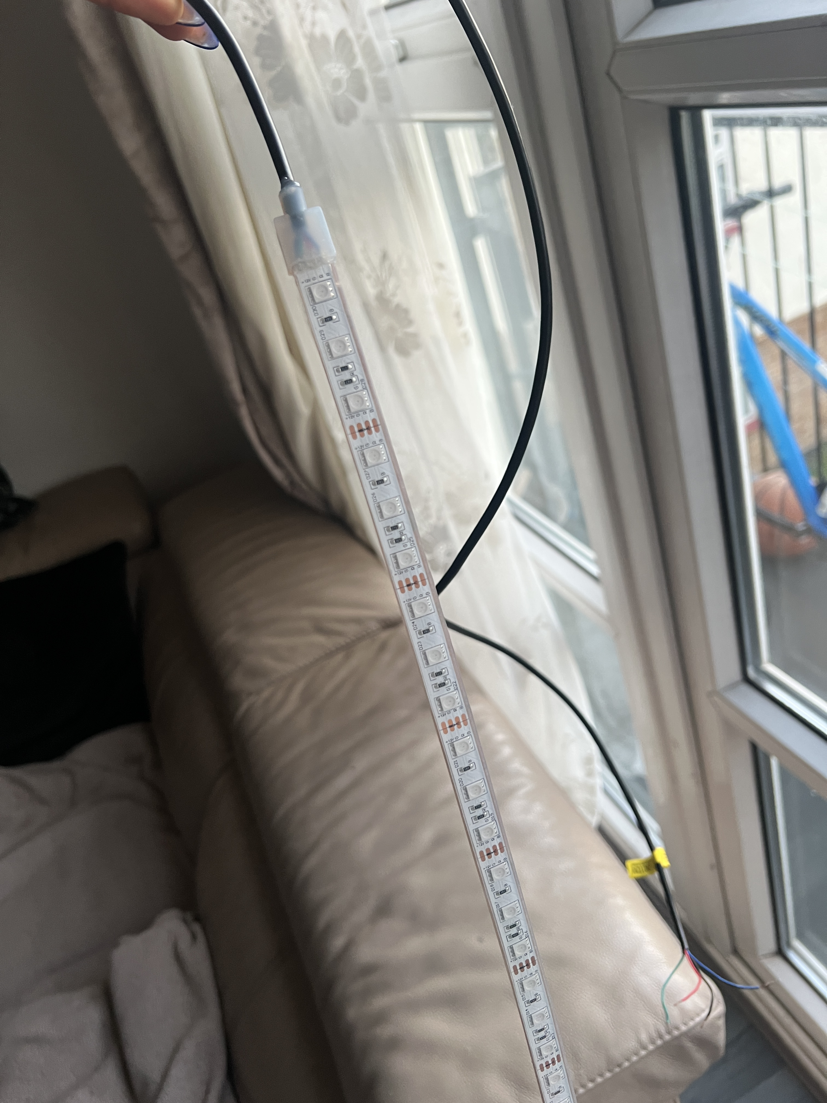
Building Phases/IMG_8102.jpeg
