Madina1219/ConnectGuinea/Building Phases/IMG_8103.jpeg

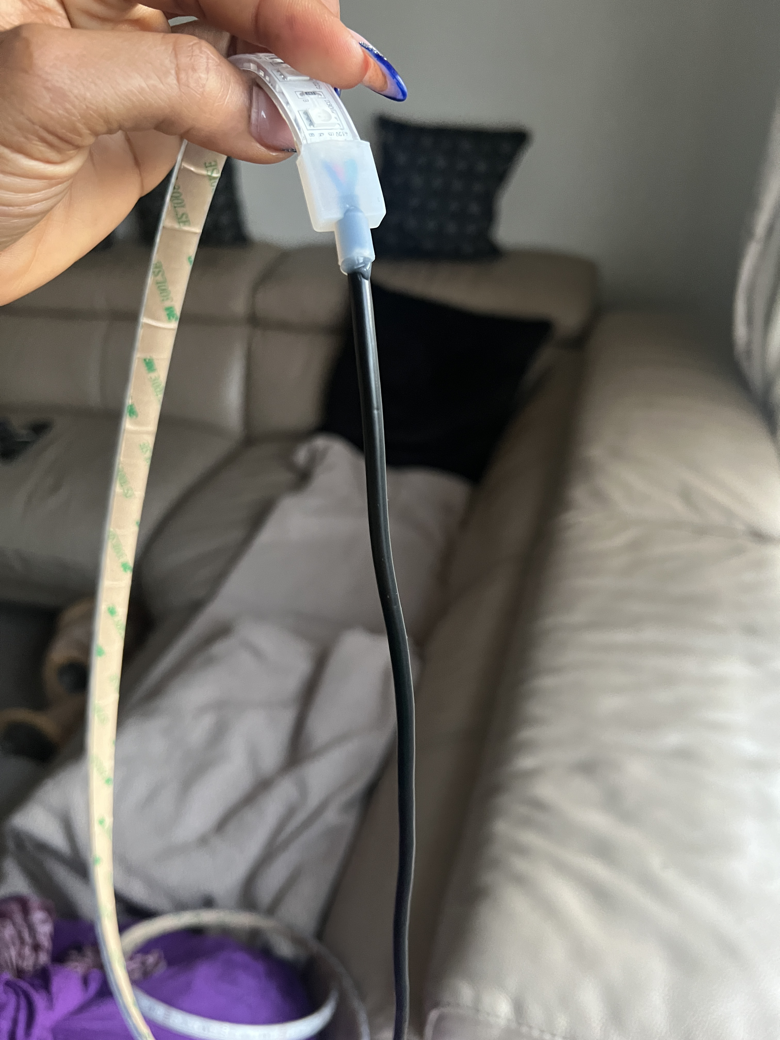
Building Phases/IMG_8103.jpeg
