Madina1219/ConnectGuinea/Building Phases/IMG_8109.jpeg

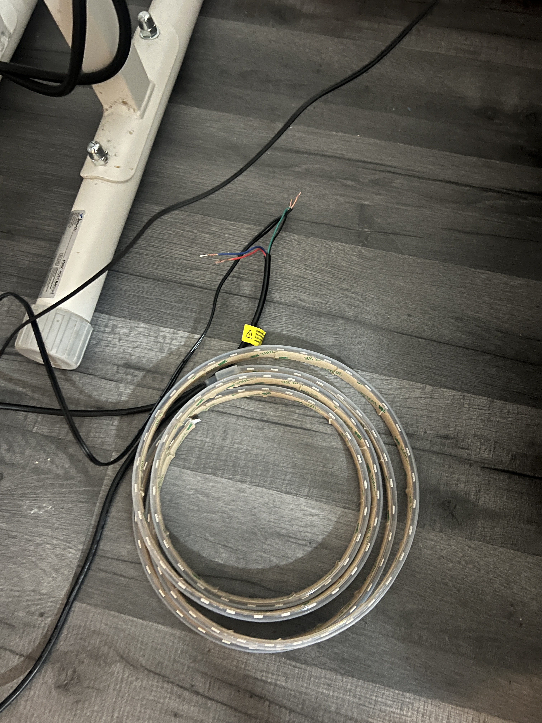
Building Phases/IMG_8109.jpeg
