Madina1219/ConnectGuinea/Building Phases/IMG_8118.jpeg

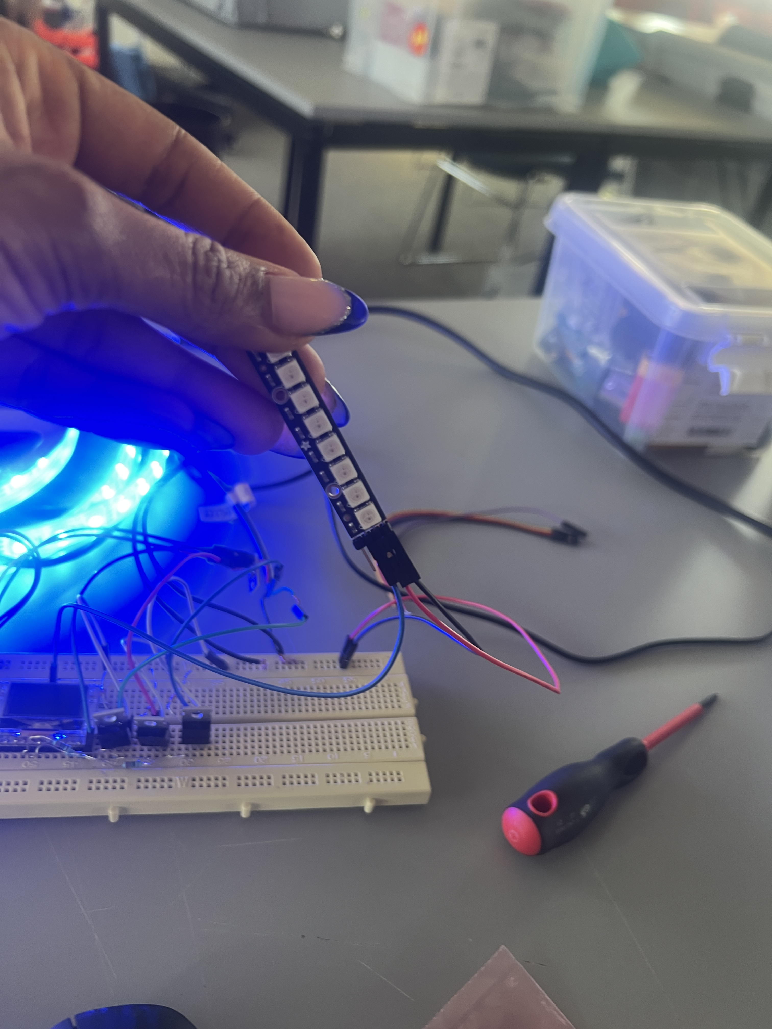
Building Phases/IMG_8118.jpeg
