Madina1219/ConnectGuinea/Building Phases/IMG_8119.jpeg

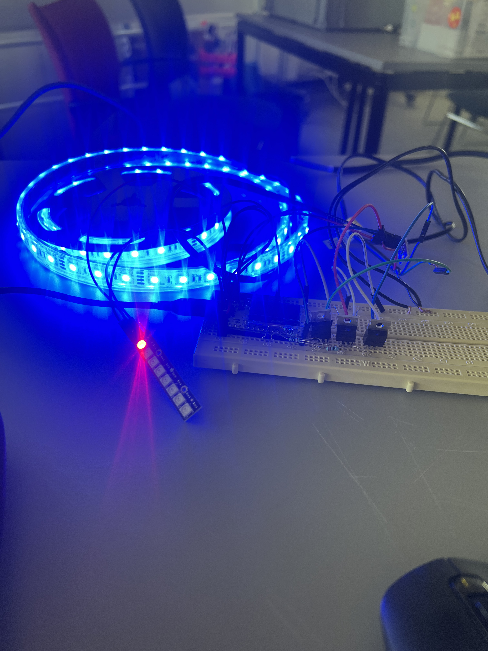
Building Phases/IMG_8119.jpeg
