Madina1219/ConnectGuinea/Building Phases/IMG_8121.jpeg

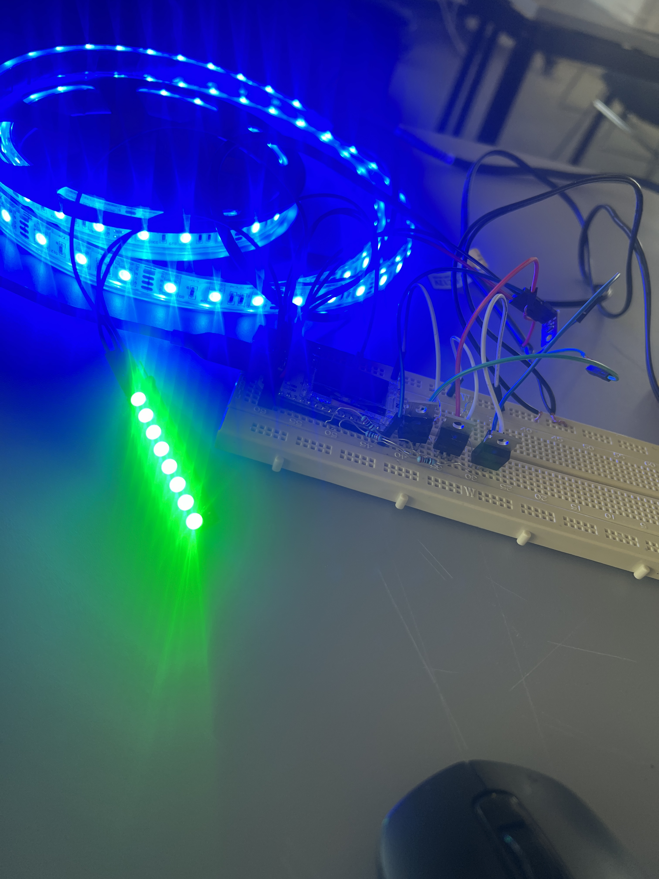
Building Phases/IMG_8121.jpeg
