Madina1219/ConnectGuinea/Building Phases/IMG_8124.jpeg

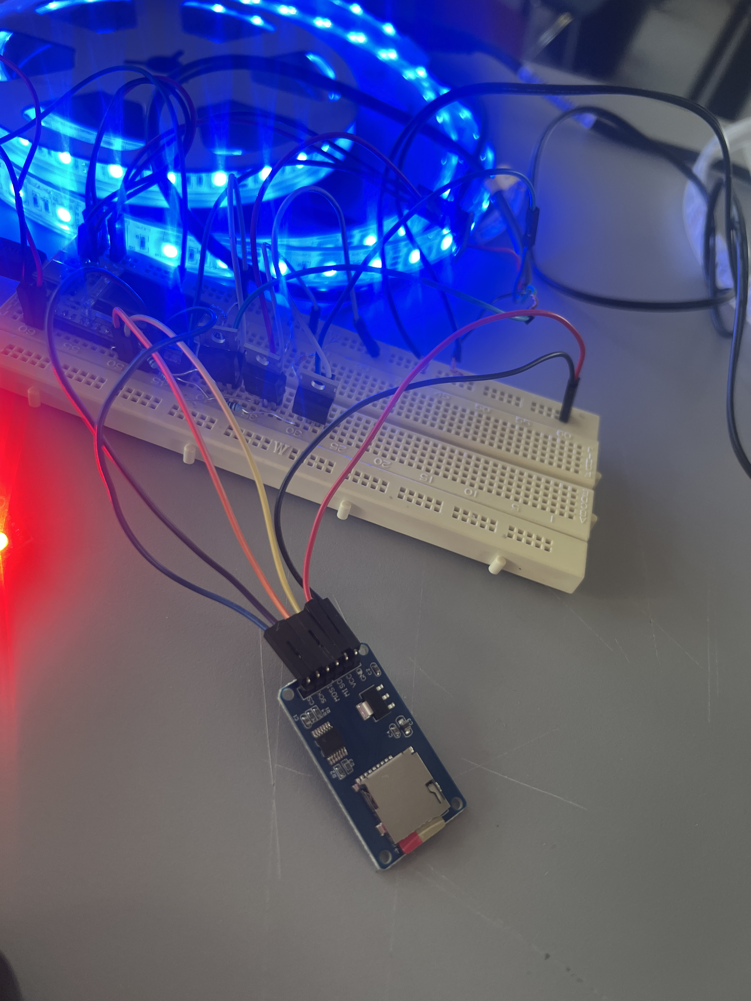
Building Phases/IMG_8124.jpeg
