Madina1219/ConnectGuinea/Building Phases/IMG_8130 (1).jpeg

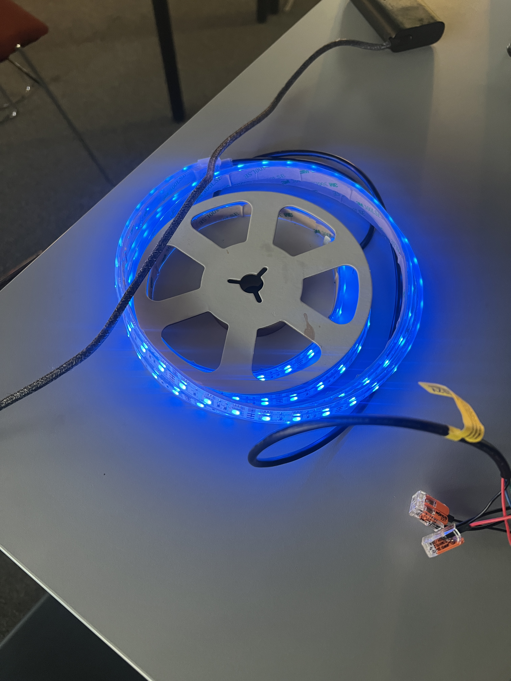
Building Phases/IMG_8130 (1).jpeg
