Madina1219/ConnectGuinea/Building Phases/IMG_8131.jpeg

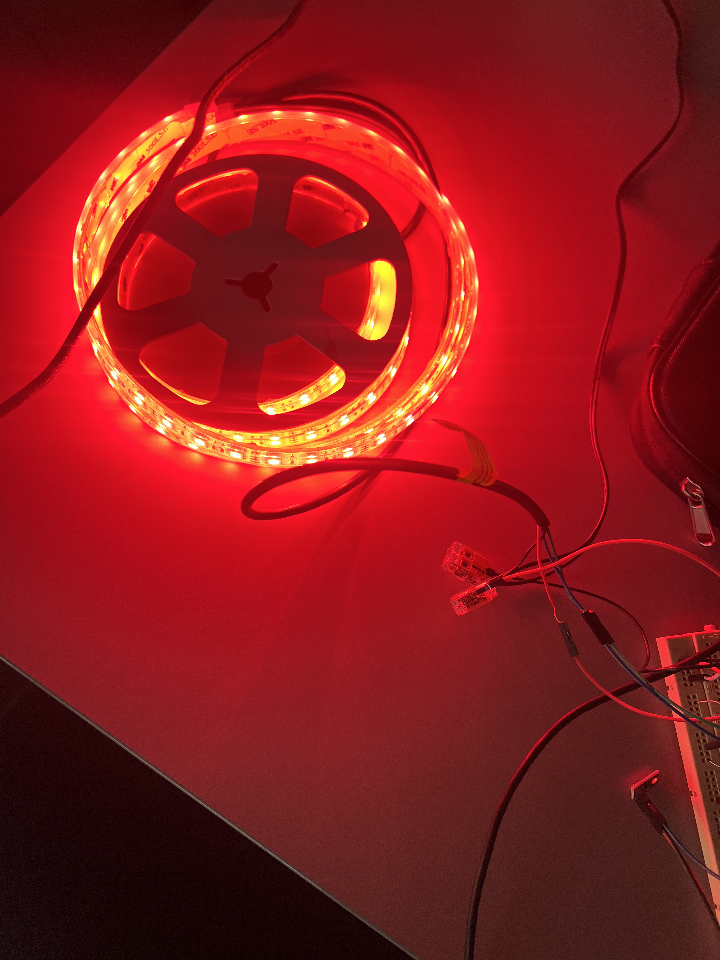
Building Phases/IMG_8131.jpeg
