Madina1219/ConnectGuinea/Building Phases/IMG_8135.jpeg

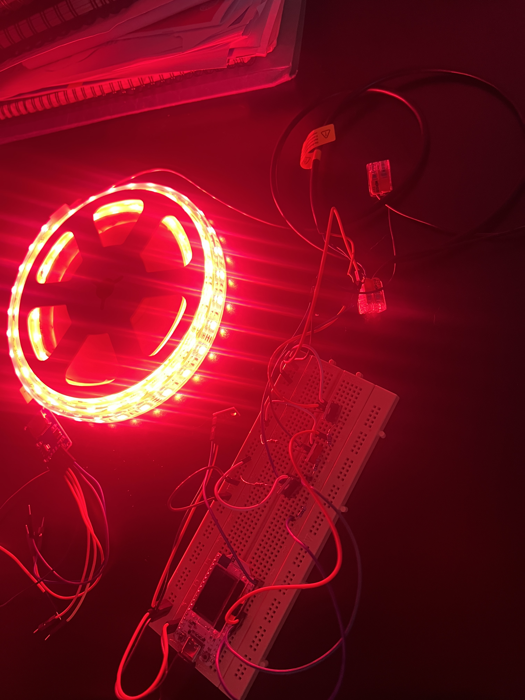
Building Phases/IMG_8135.jpeg
