Madina1219/ConnectGuinea/Building Phases/IMG_8137.jpeg

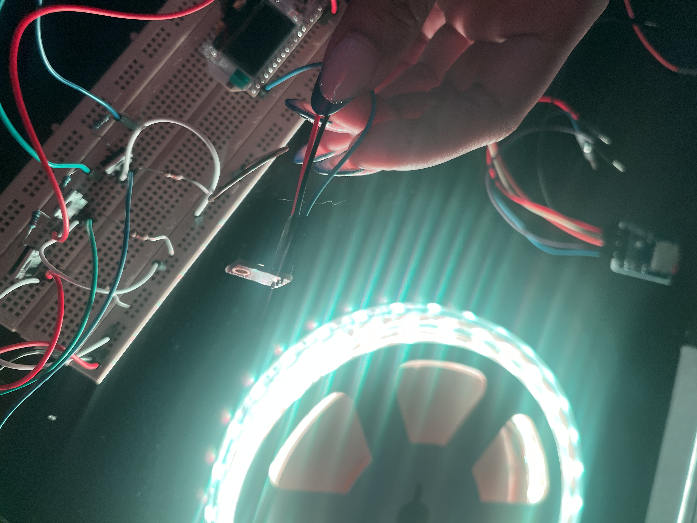
Building Phases/IMG_8137.jpeg
