Madina1219/ConnectGuinea/Building Phases/IMG_8141.jpeg

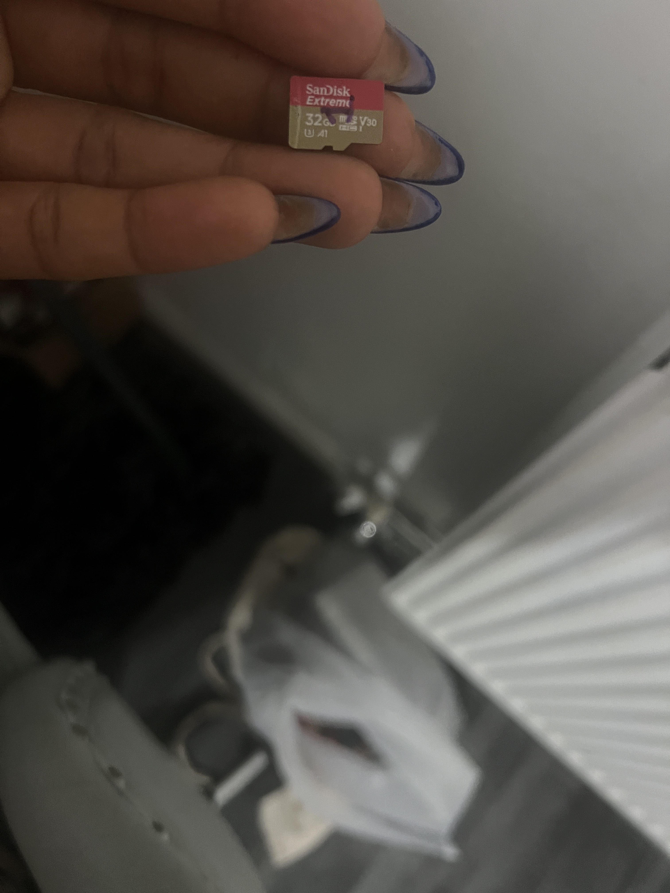
Building Phases/IMG_8141.jpeg
