Madina1219/ConnectGuinea/Building Phases/IMG_8149.jpeg

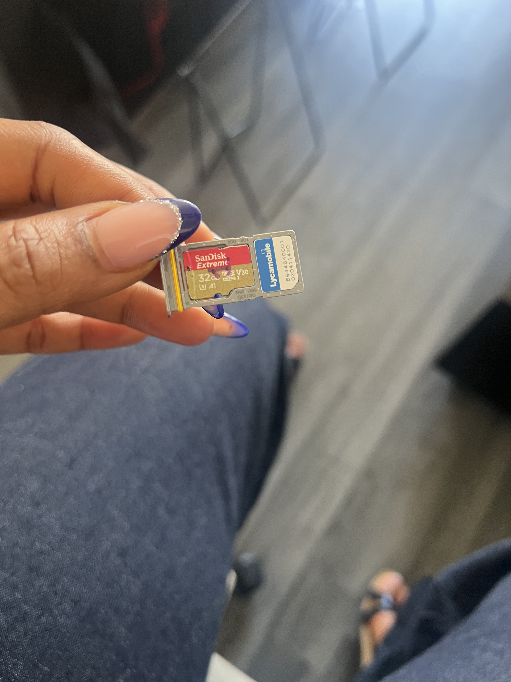
Building Phases/IMG_8149.jpeg
