Madina1219/ConnectGuinea/Building Phases/IMG_8153.jpeg

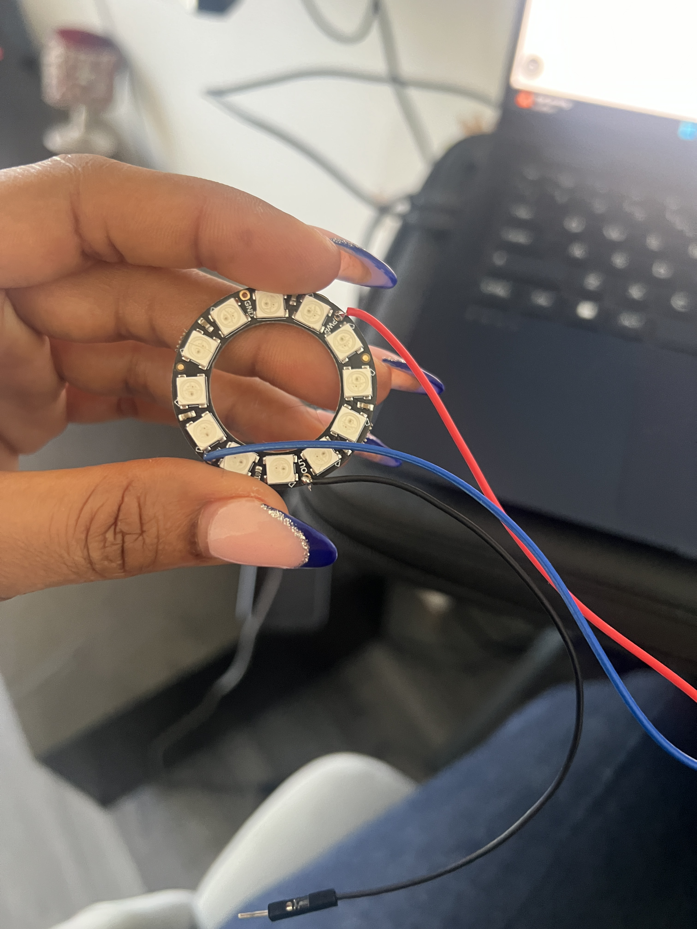
Building Phases/IMG_8153.jpeg
