Madina1219/ConnectGuinea/Building Phases/IMG_8154.jpeg

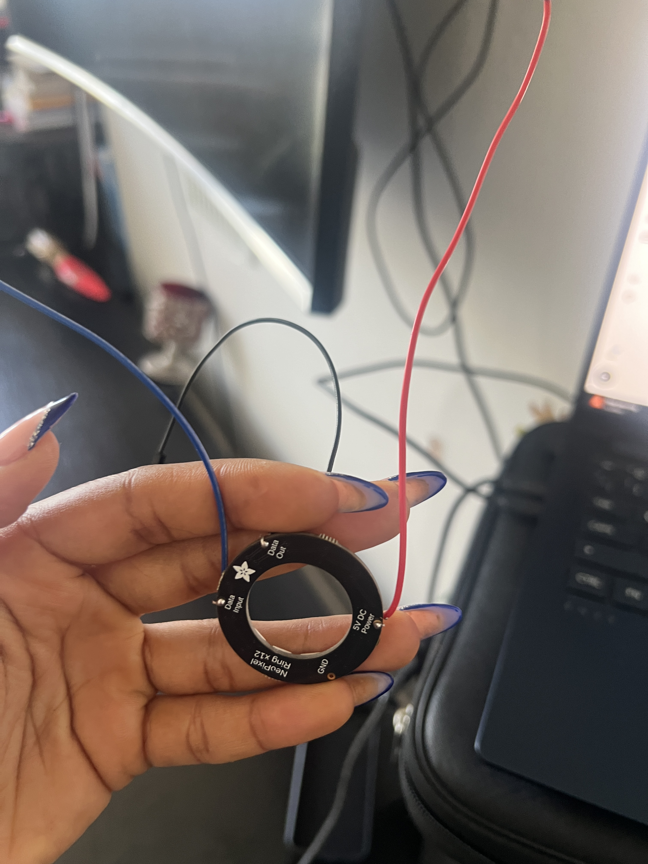
Building Phases/IMG_8154.jpeg
