Madina1219/ConnectGuinea/Building Phases/IMG_8155.jpeg

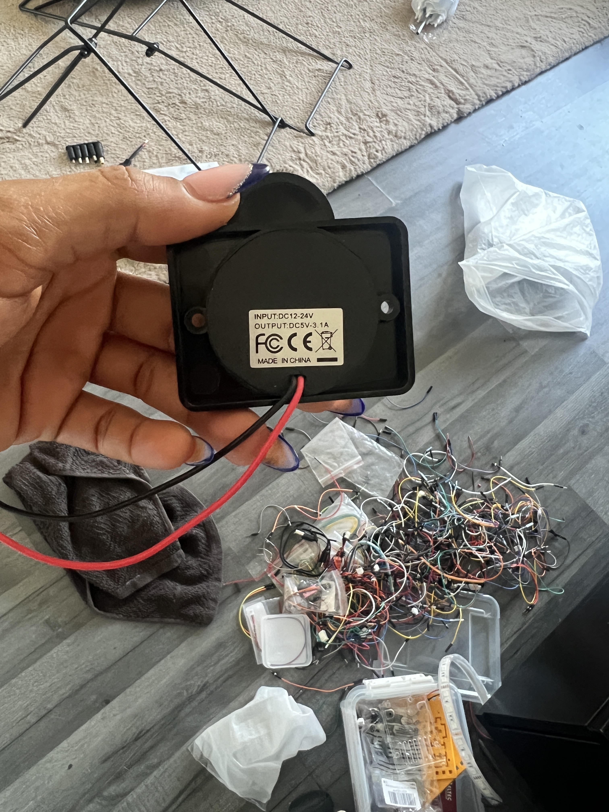
Building Phases/IMG_8155.jpeg
