Madina1219/ConnectGuinea/Building Phases/IMG_8156.jpeg

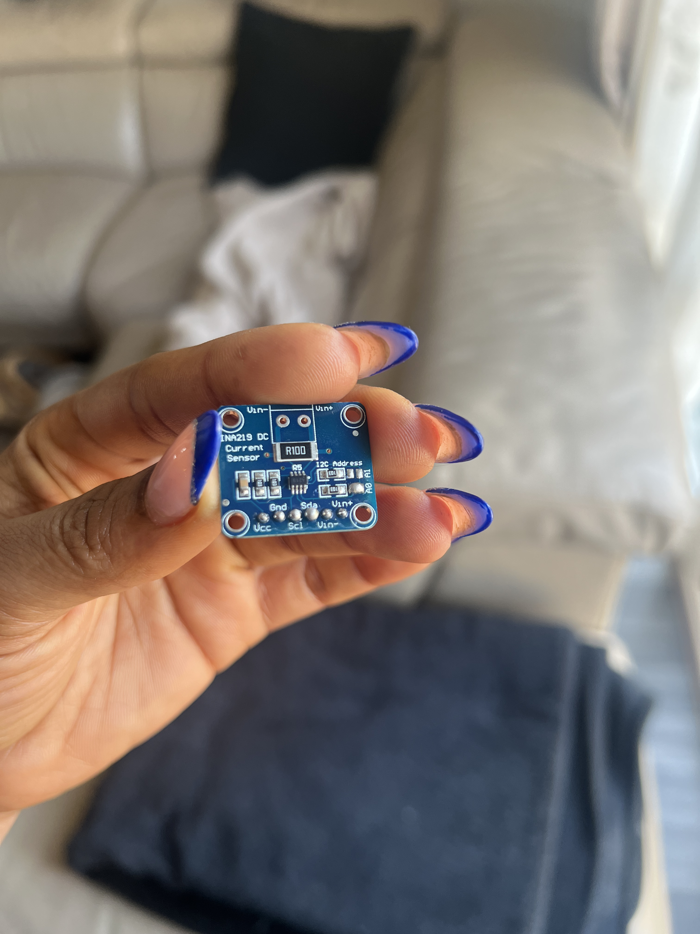
Building Phases/IMG_8156.jpeg
