Madina1219/ConnectGuinea/Building Phases/IMG_8157.jpeg

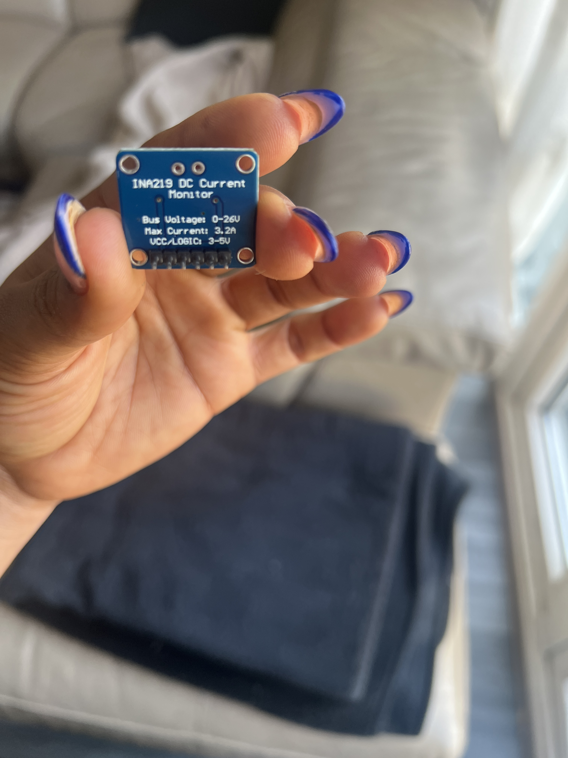
Building Phases/IMG_8157.jpeg
