Madina1219/ConnectGuinea/Building Phases/IMG_8163.jpeg

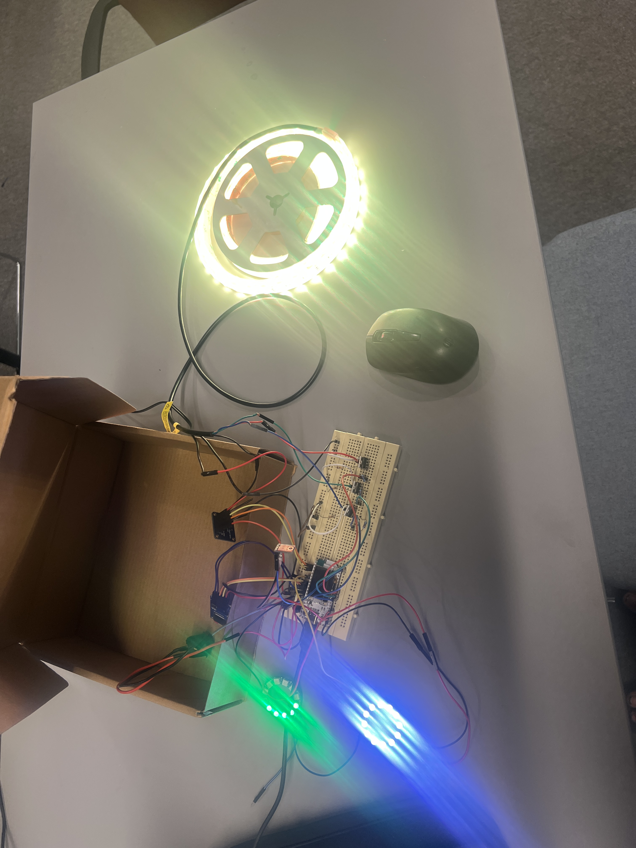
Building Phases/IMG_8163.jpeg
