Madina1219/ConnectGuinea/Building Phases/IMG_8167.jpeg

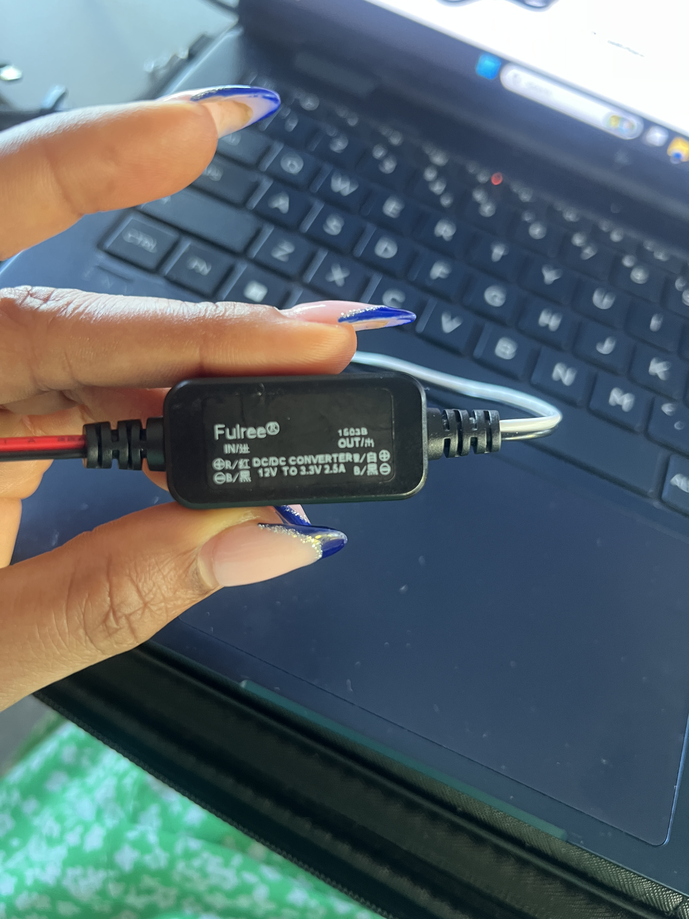
Building Phases/IMG_8167.jpeg
