Madina1219/ConnectGuinea/Building Phases/IMG_8220.jpeg

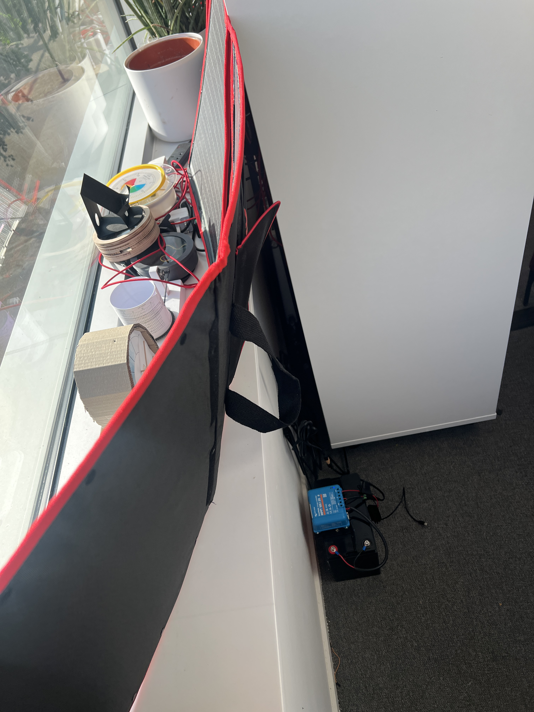
Building Phases/IMG_8220.jpeg
