Madina1219/ConnectGuinea/Building Phases/IMG_8246.jpeg

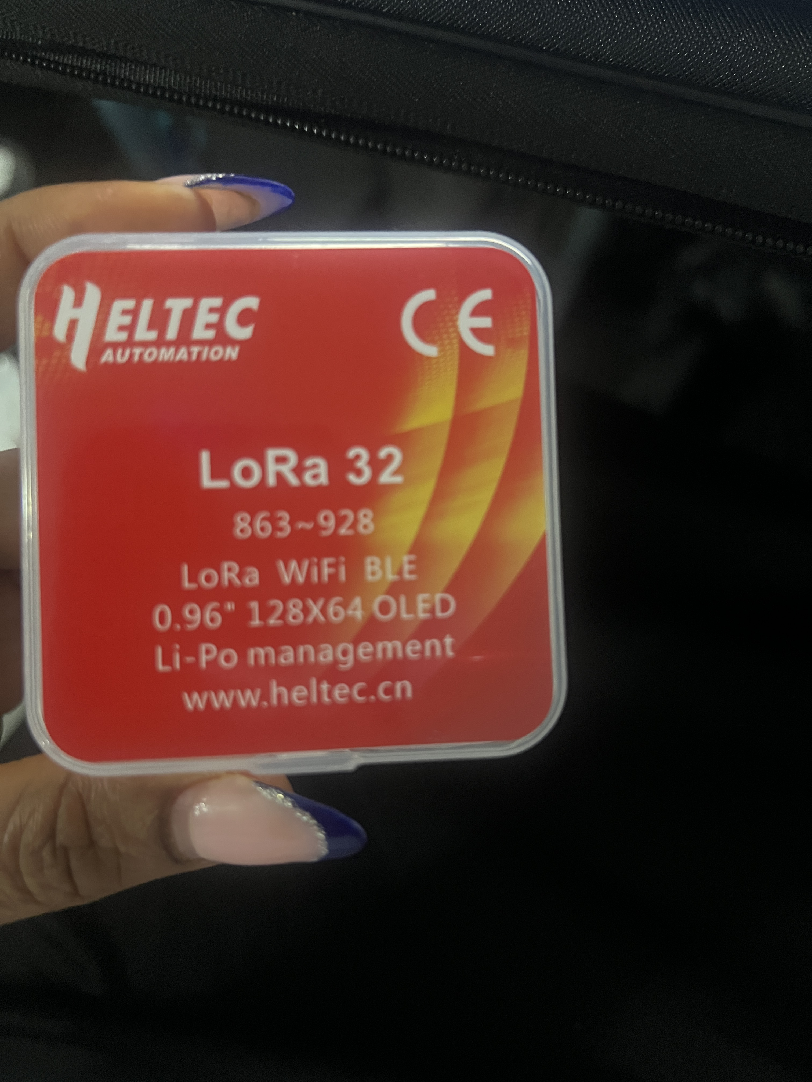
Building Phases/IMG_8246.jpeg
