Madina1219/ConnectGuinea/Building Phases/IMG_8249.jpeg

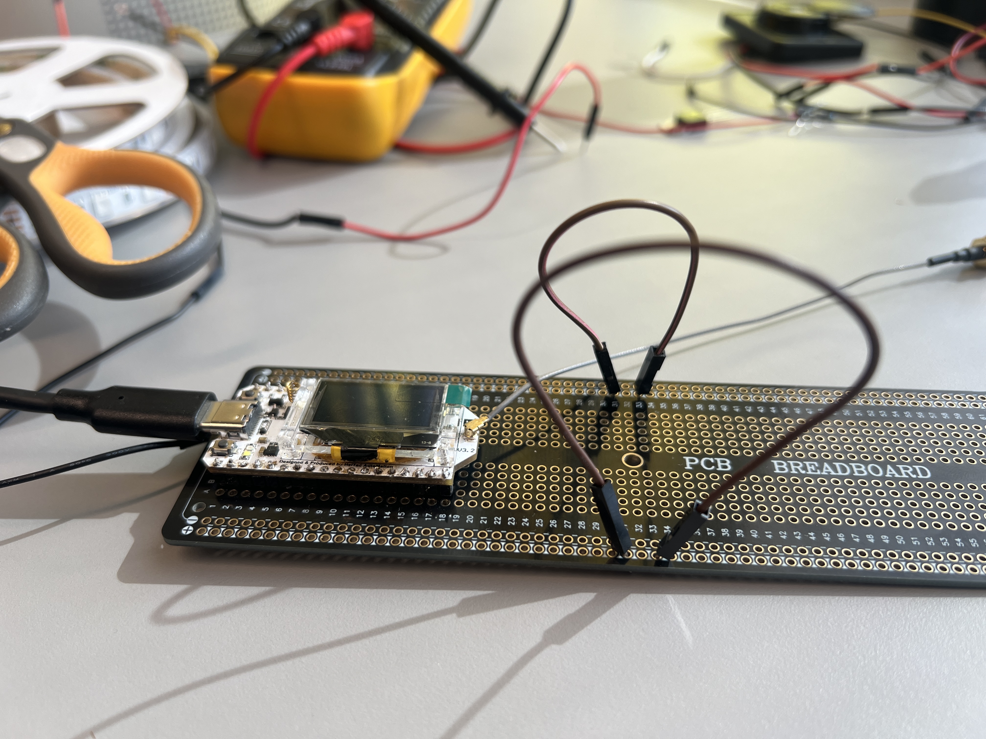
Building Phases/IMG_8249.jpeg
