Madina1219/ConnectGuinea/Building Phases/IMG_8259.jpeg

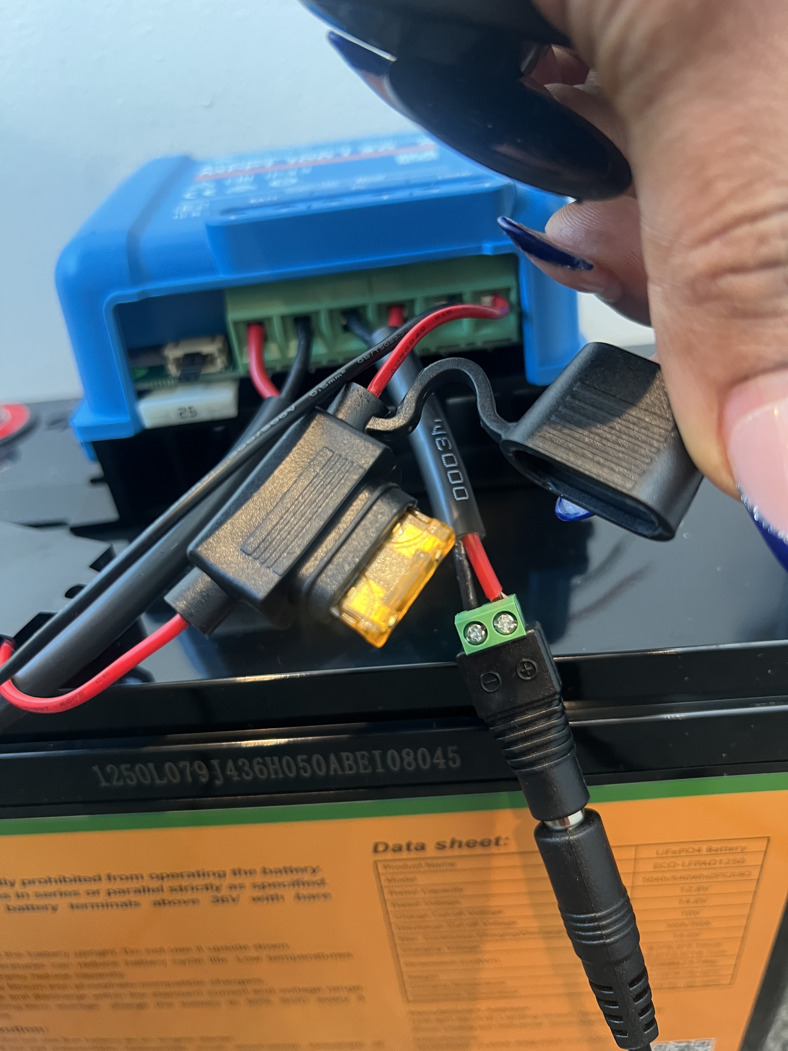
Building Phases/IMG_8259.jpeg
