Madina1219/ConnectGuinea/Building Phases/IMG_8268.jpeg

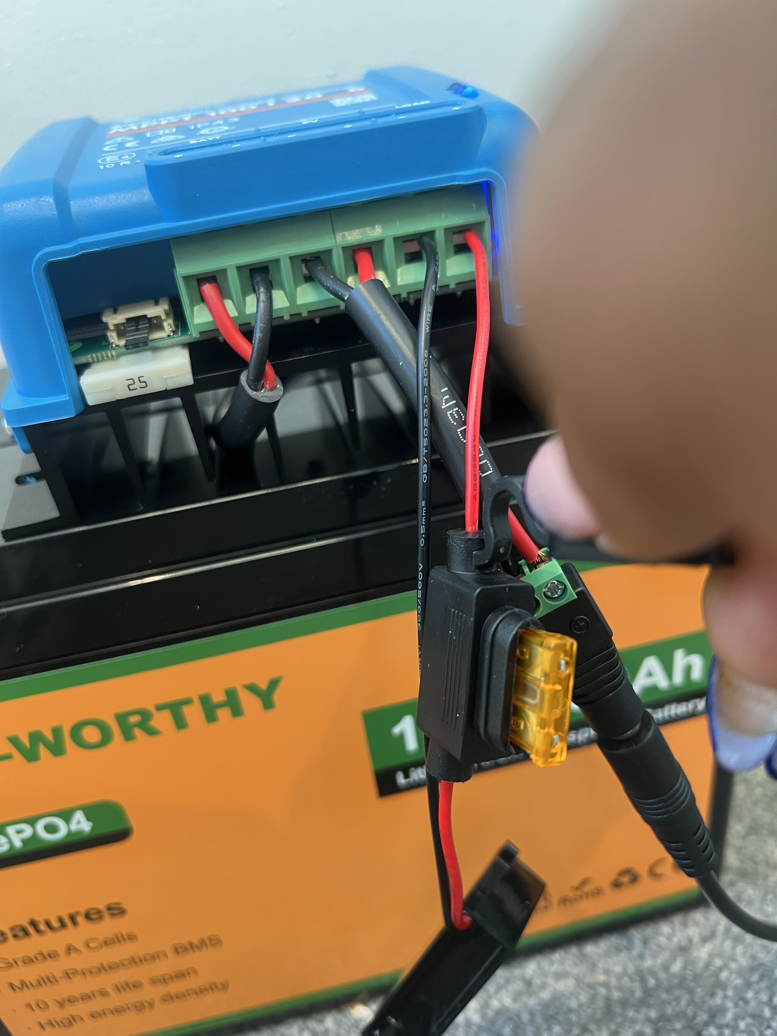
Building Phases/IMG_8268.jpeg
