Madina1219/ConnectGuinea/Building Phases/IMG_8269.jpeg

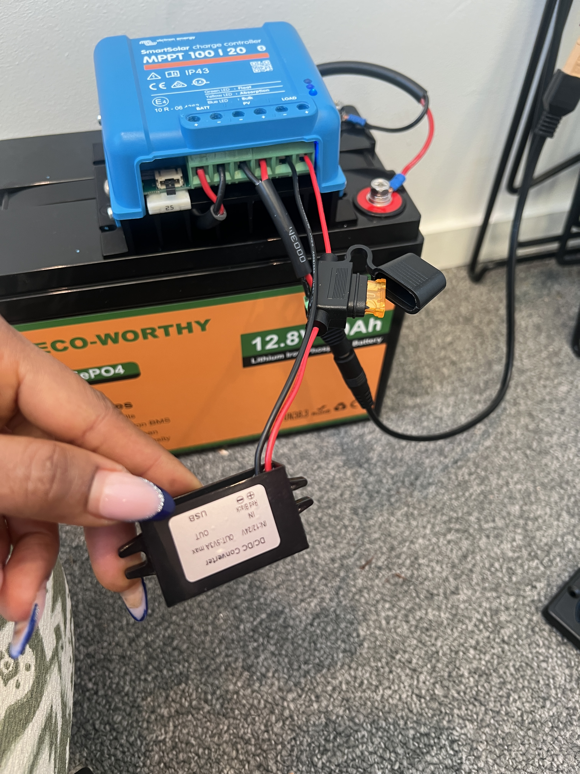
Building Phases/IMG_8269.jpeg
