Madina1219/ConnectGuinea/Building Phases/IMG_8278.jpeg

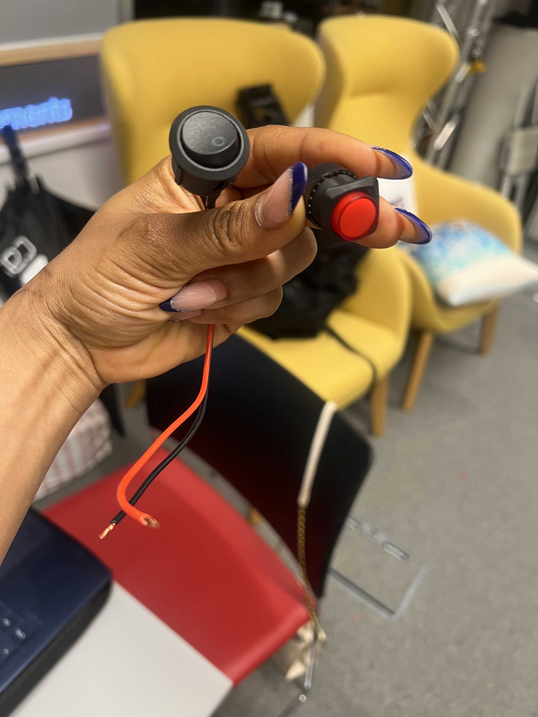
Building Phases/IMG_8278.jpeg
