Madina1219/ConnectGuinea/Building Phases/IMG_8308.jpeg

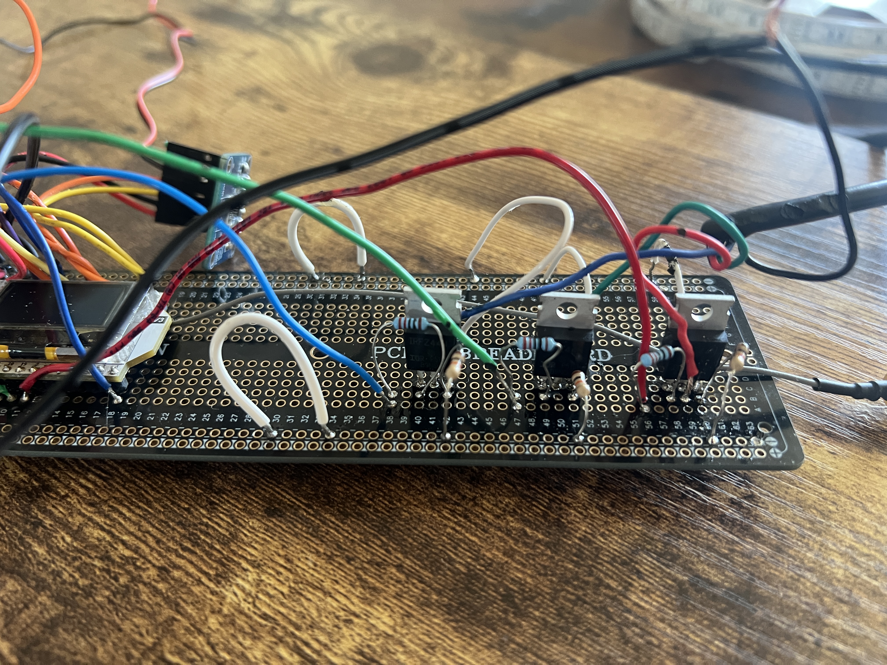
Building Phases/IMG_8308.jpeg
