Madina1219/ConnectGuinea/Building Phases/IMG_8312.jpeg

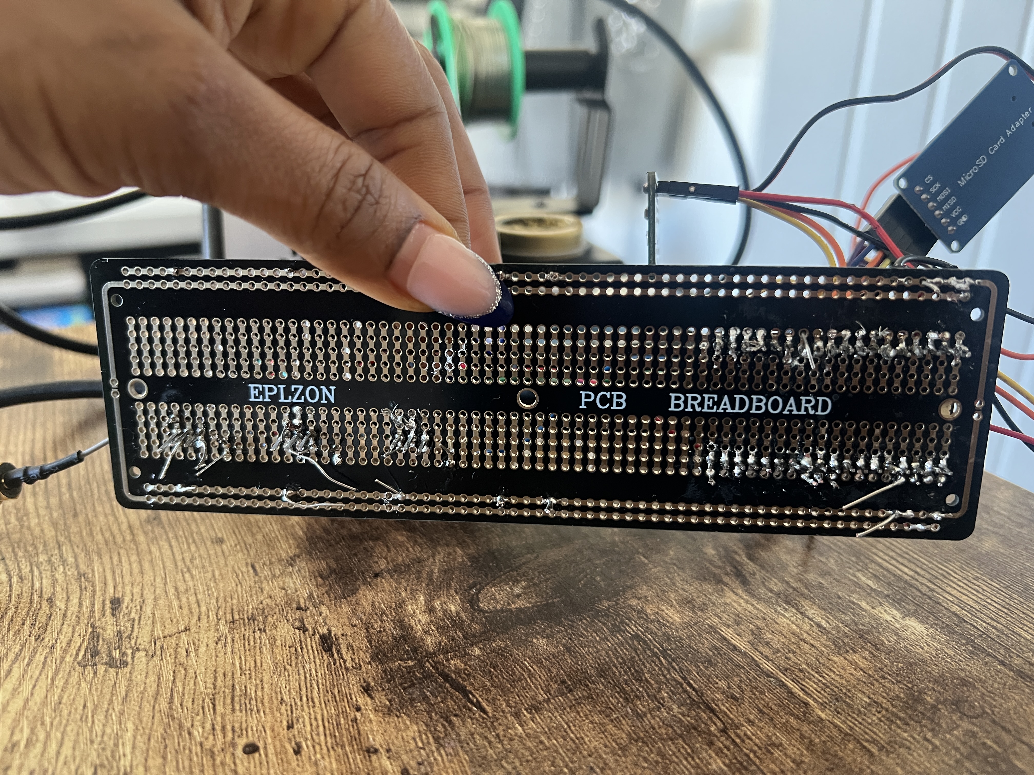
Building Phases/IMG_8312.jpeg
