Madina1219/ConnectGuinea/Building Phases/IMG_8313.jpeg

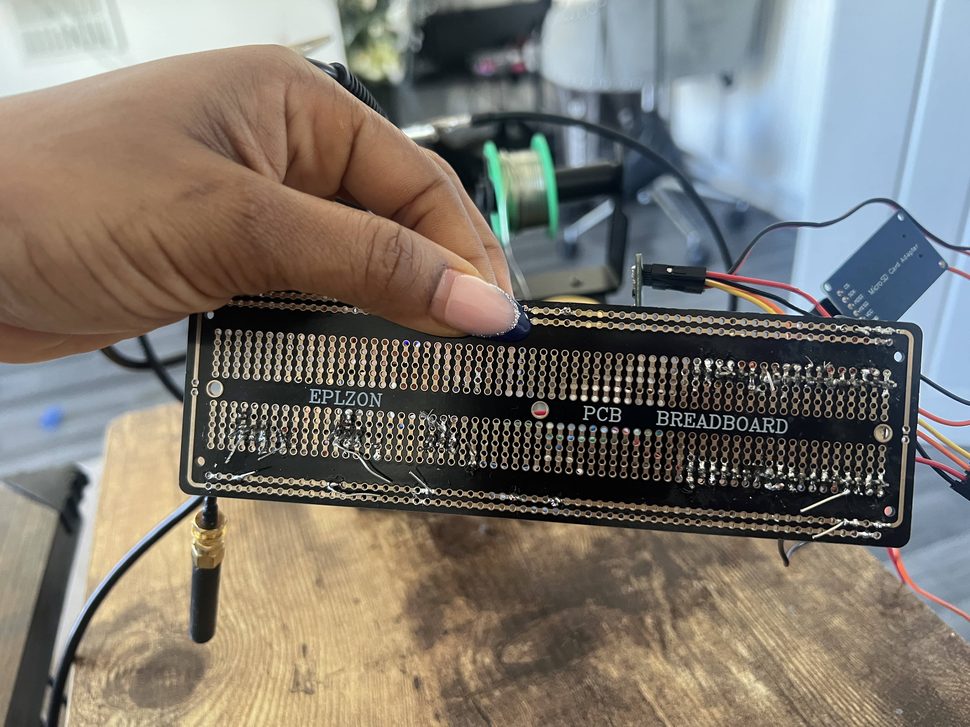
Building Phases/IMG_8313.jpeg
