Madina1219/ConnectGuinea/Building Phases/IMG_8320.jpeg

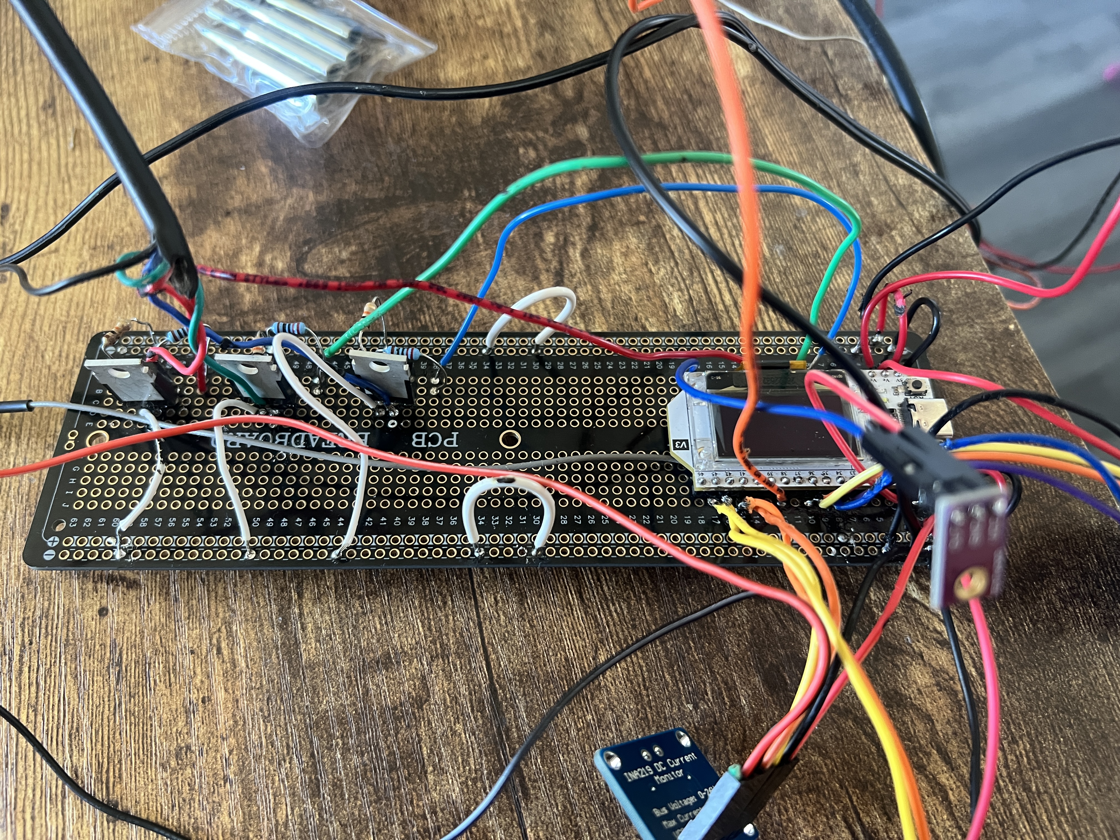
Building Phases/IMG_8320.jpeg
