Madina1219/ConnectGuinea/Building Phases/IMG_8353.jpeg

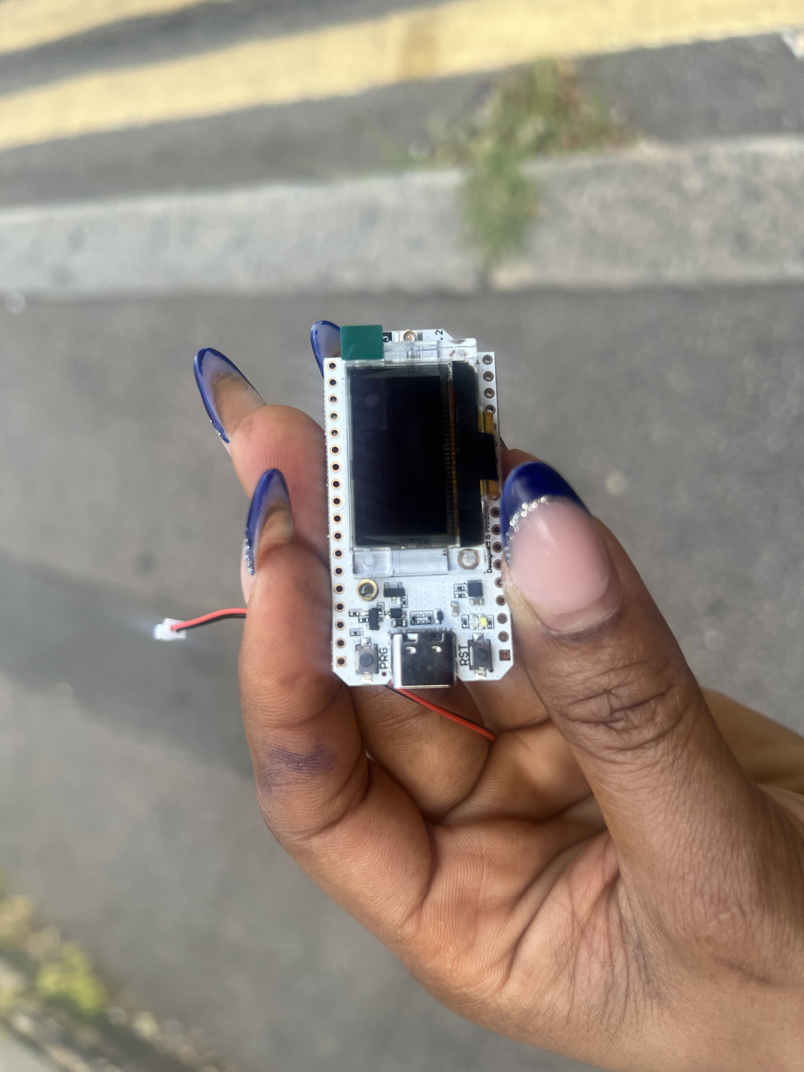
Building Phases/IMG_8353.jpeg
