Madina1219/ConnectGuinea/Building Phases/IMG_8363.jpeg

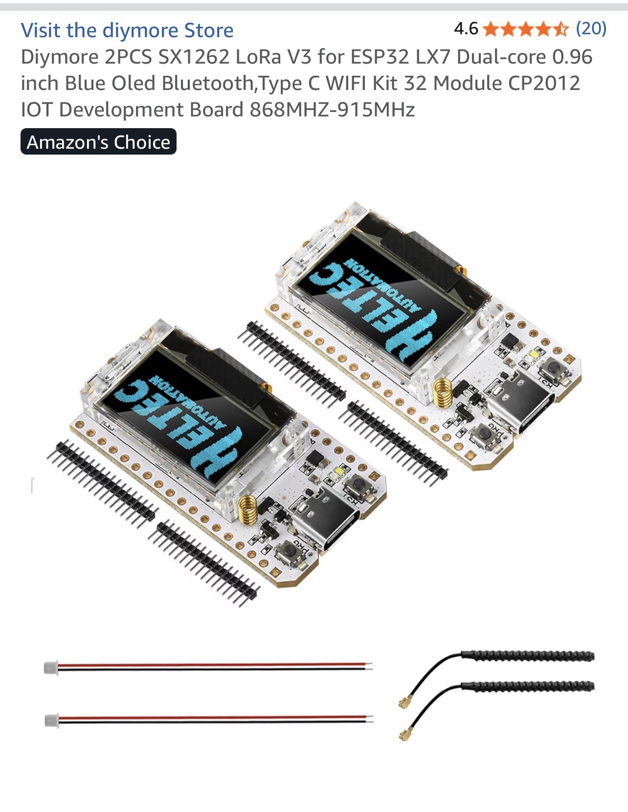
Building Phases/IMG_8363.jpeg
