Madina1219/ConnectGuinea/Building Phases/IMG_8364.jpeg

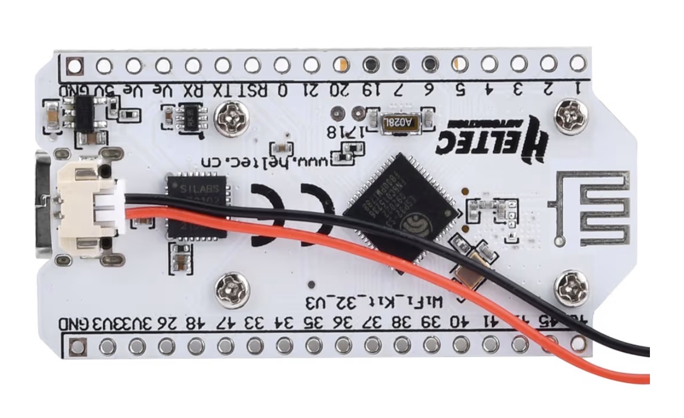
Building Phases/IMG_8364.jpeg
