Madina1219/ConnectGuinea/Building Phases/IMG_8365.jpeg

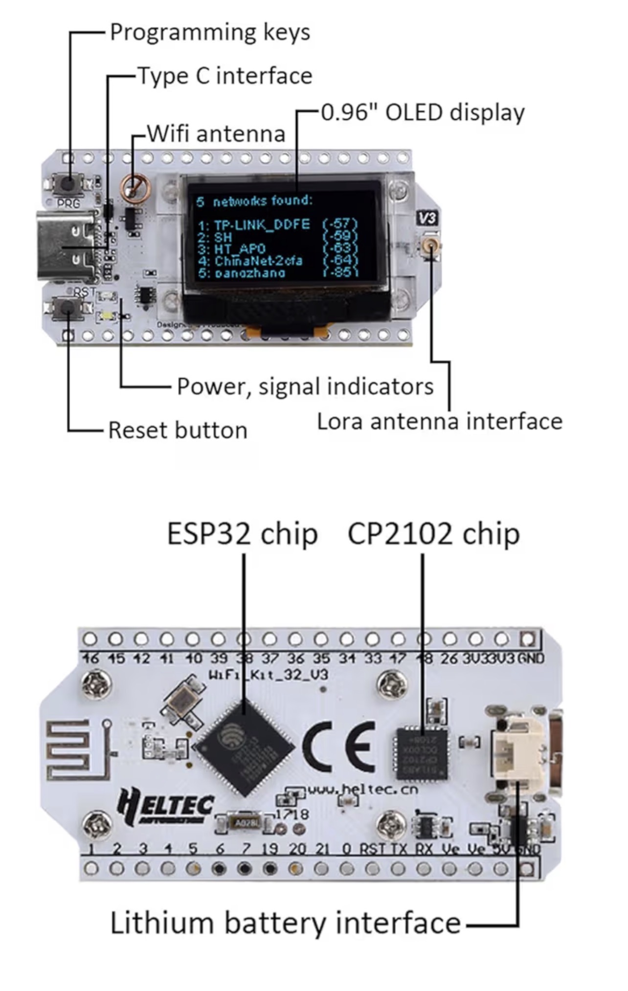
Building Phases/IMG_8365.jpeg
