Madina1219/ConnectGuinea/Building Phases/IMG_8366.jpeg

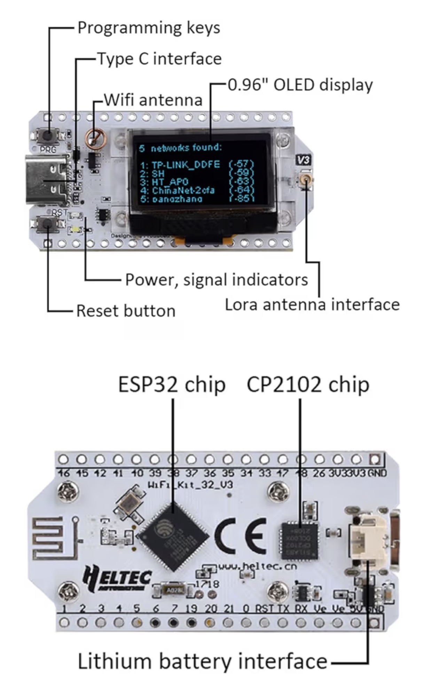
Building Phases/IMG_8366.jpeg
