Madina1219/ConnectGuinea/Building Phases/IMG_8367.jpeg

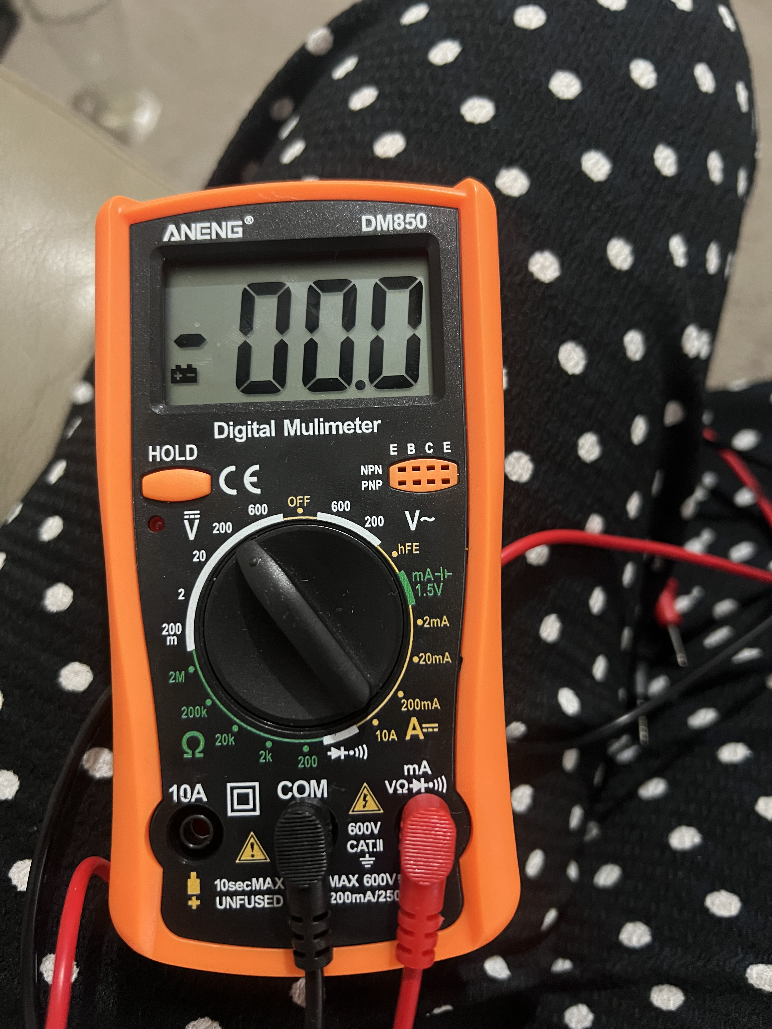
Building Phases/IMG_8367.jpeg
