Madina1219/ConnectGuinea/Building Phases/IMG_8368.jpeg

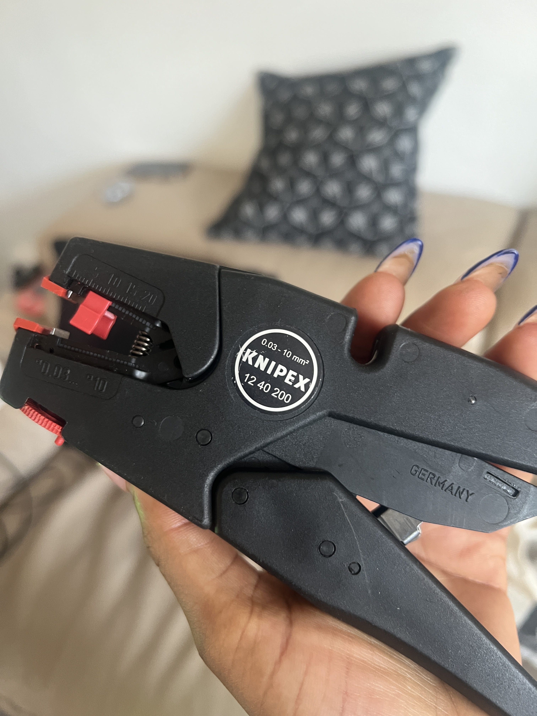
Building Phases/IMG_8368.jpeg
