Madina1219/ConnectGuinea/Building Phases/IMG_8378.jpeg

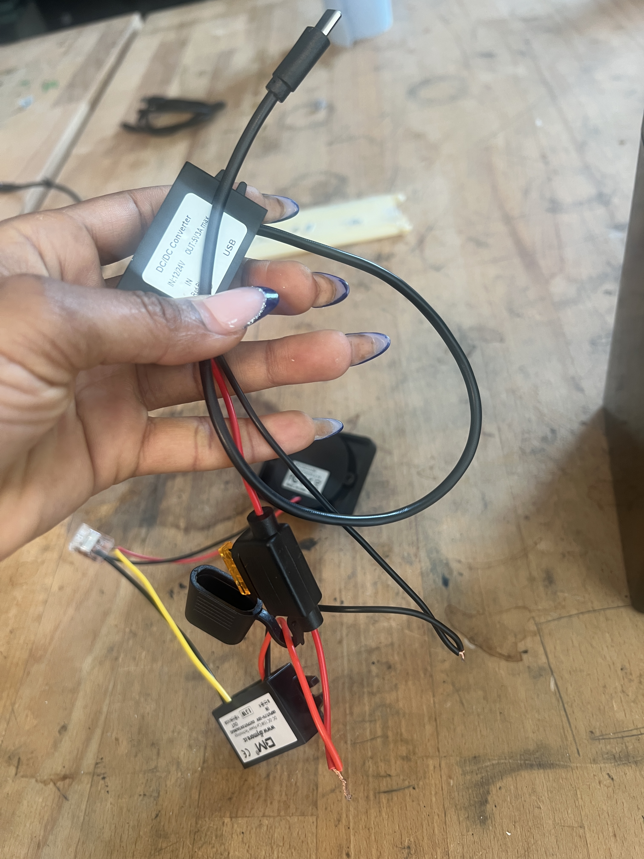
Building Phases/IMG_8378.jpeg
