Madina1219/ConnectGuinea/Building Phases/IMG_8381.jpeg

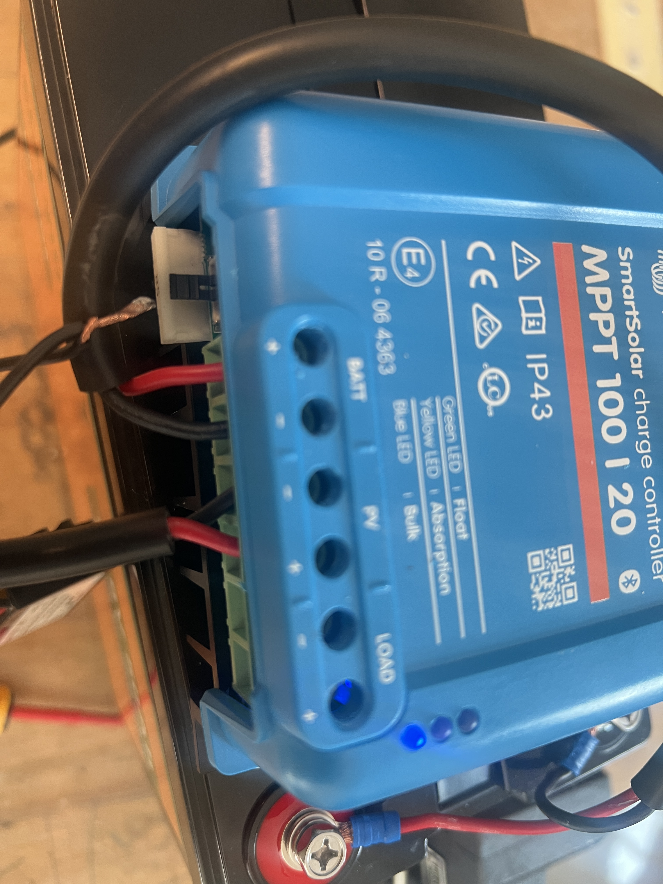
Building Phases/IMG_8381.jpeg
