Madina1219/ConnectGuinea/Building Phases/IMG_8456.jpeg

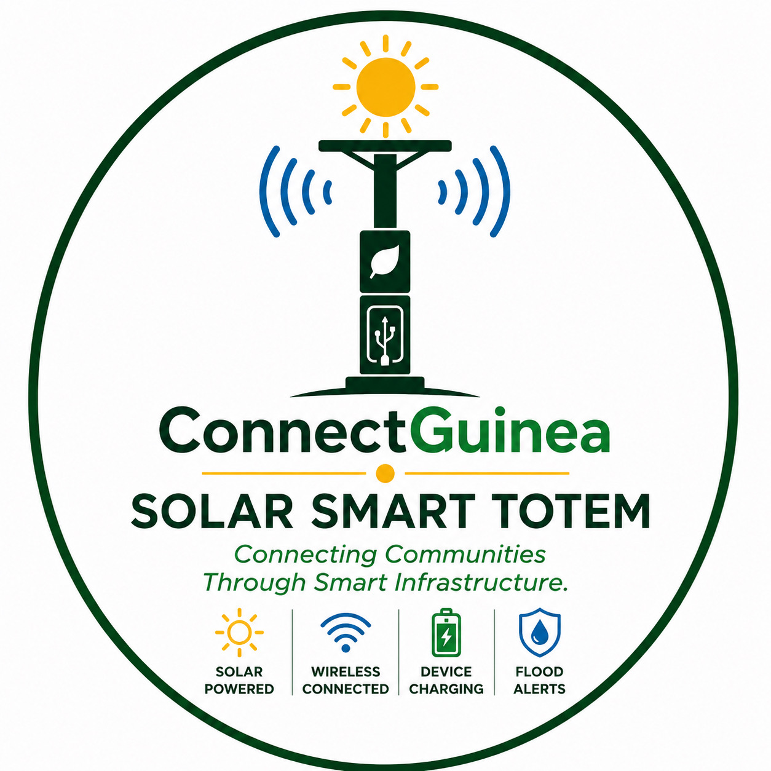
Building Phases/IMG_8456.jpeg
