Madina1219/ConnectGuinea/Building Phases/IMG_8458.jpeg

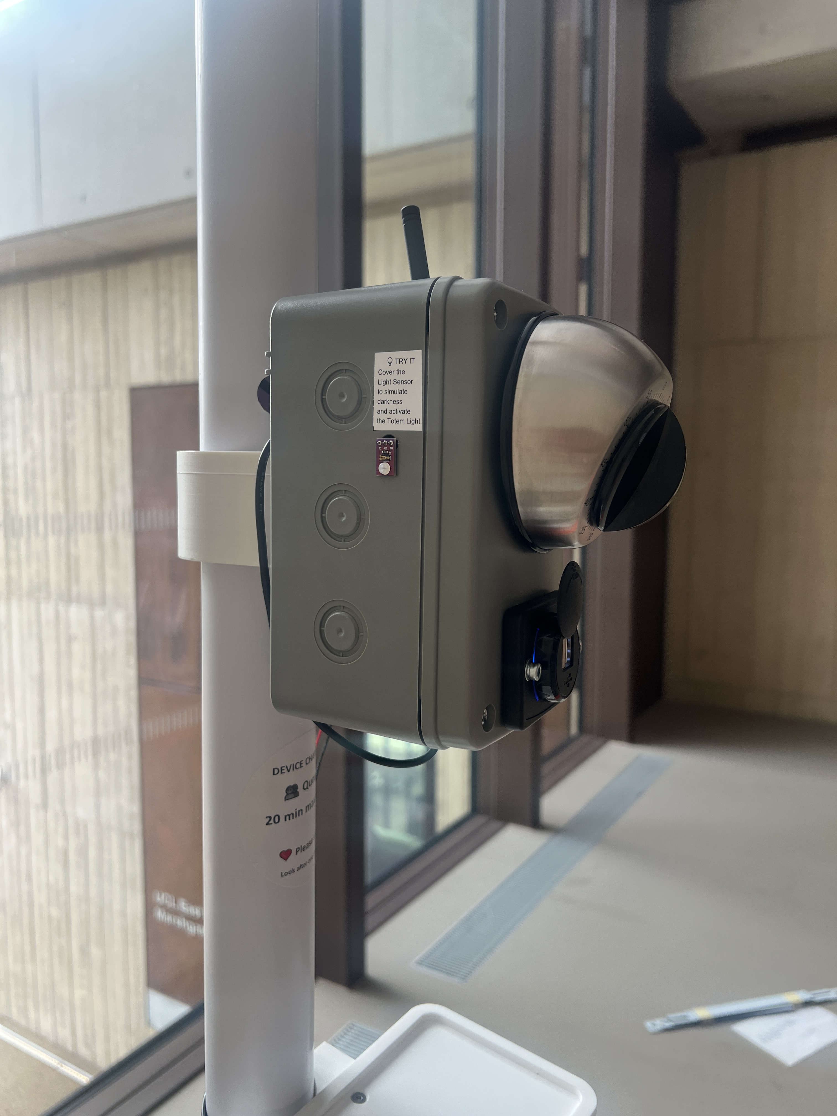
Building Phases/IMG_8458.jpeg
