Madina1219/ConnectGuinea/Building Phases/IMG_8614.jpeg

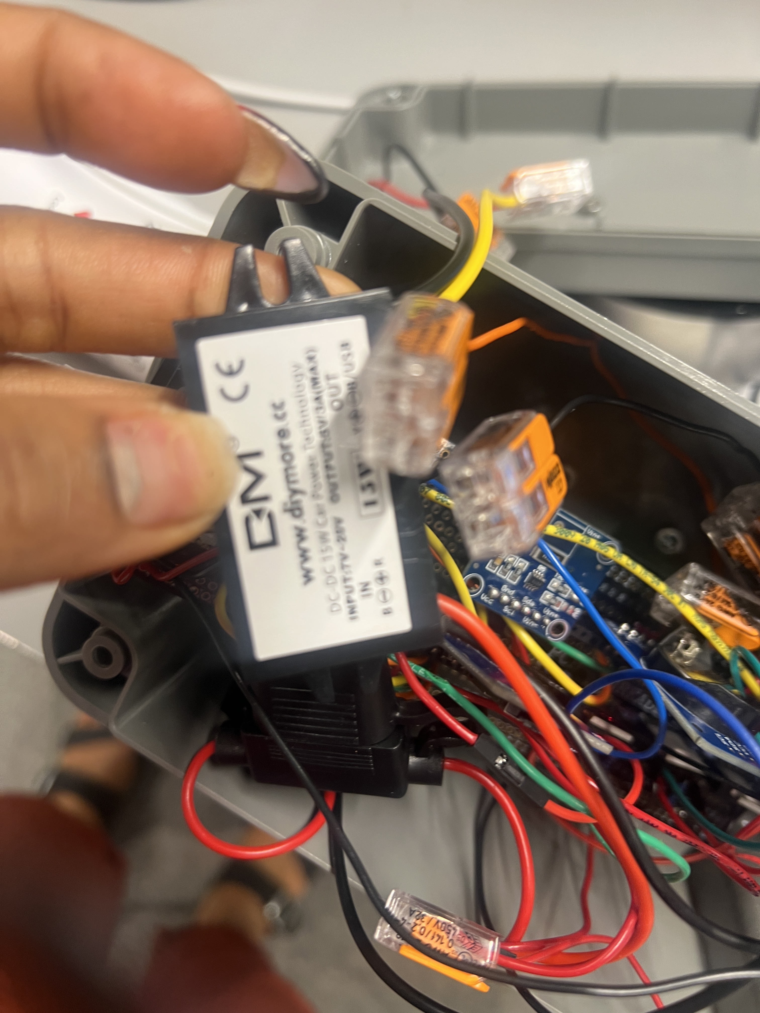
Building Phases/IMG_8614.jpeg
