Madina1219/ConnectGuinea/Building Phases/IMG_8615.jpeg

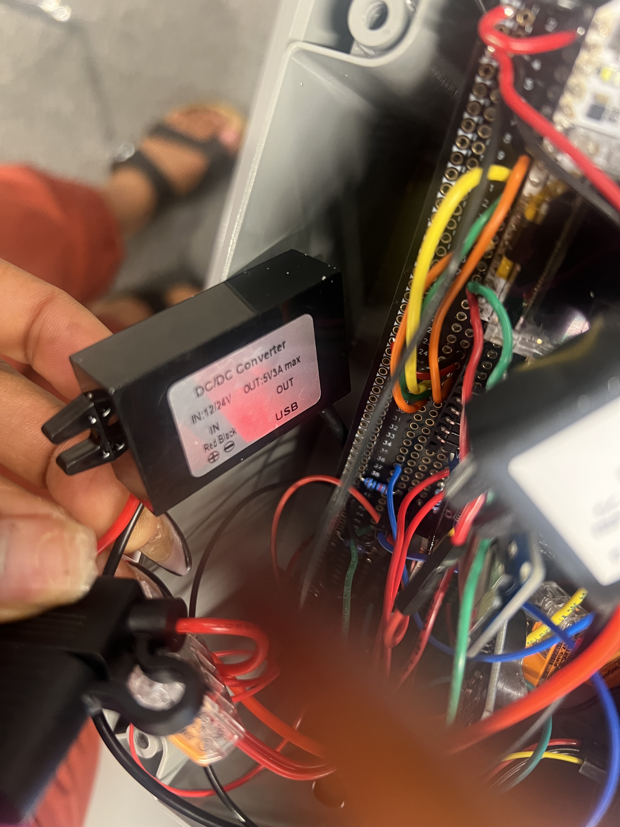
Building Phases/IMG_8615.jpeg
