Madina1219/ConnectGuinea/Building Phases/IMG_8619.jpeg

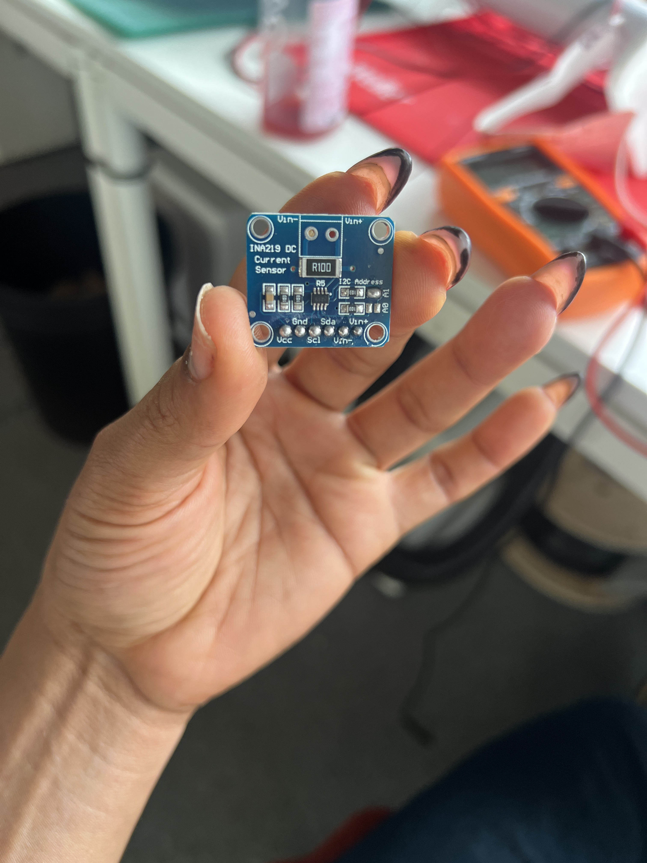
Building Phases/IMG_8619.jpeg
