Madina1219/ConnectGuinea/Building Phases/IMG_8620.jpeg

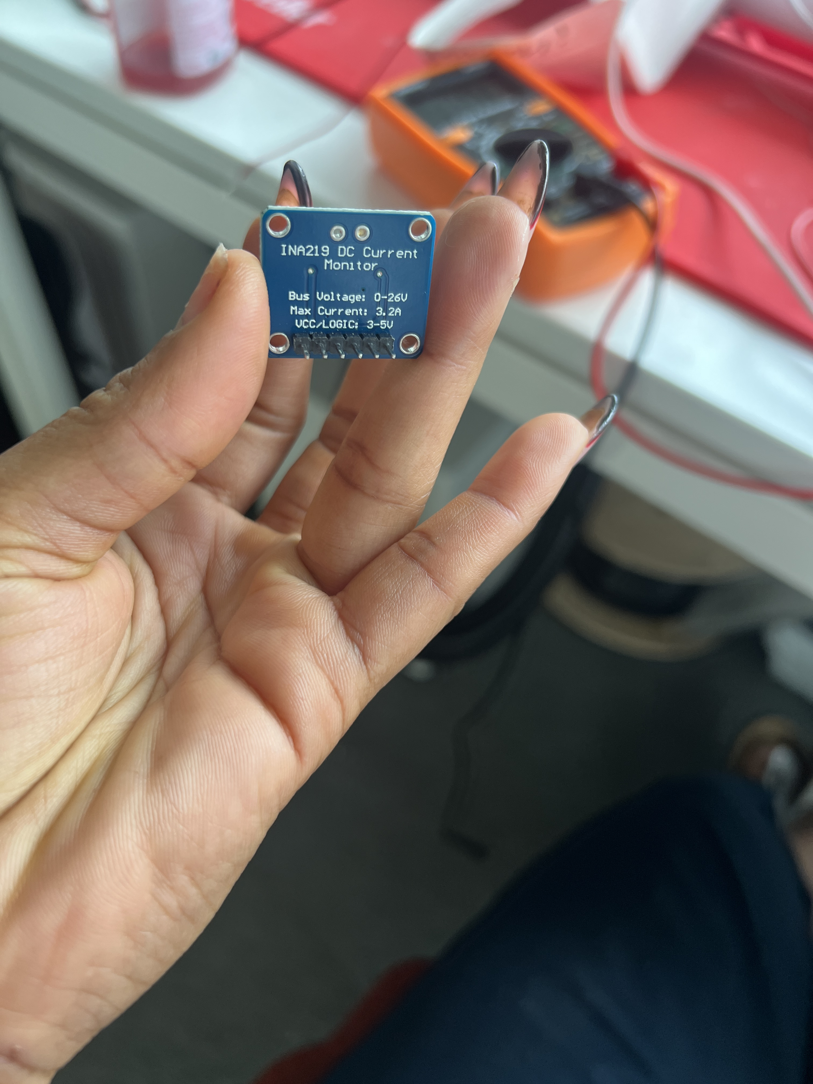
Building Phases/IMG_8620.jpeg
