Madina1219/ConnectGuinea/Building Phases/IMG_8621.jpeg

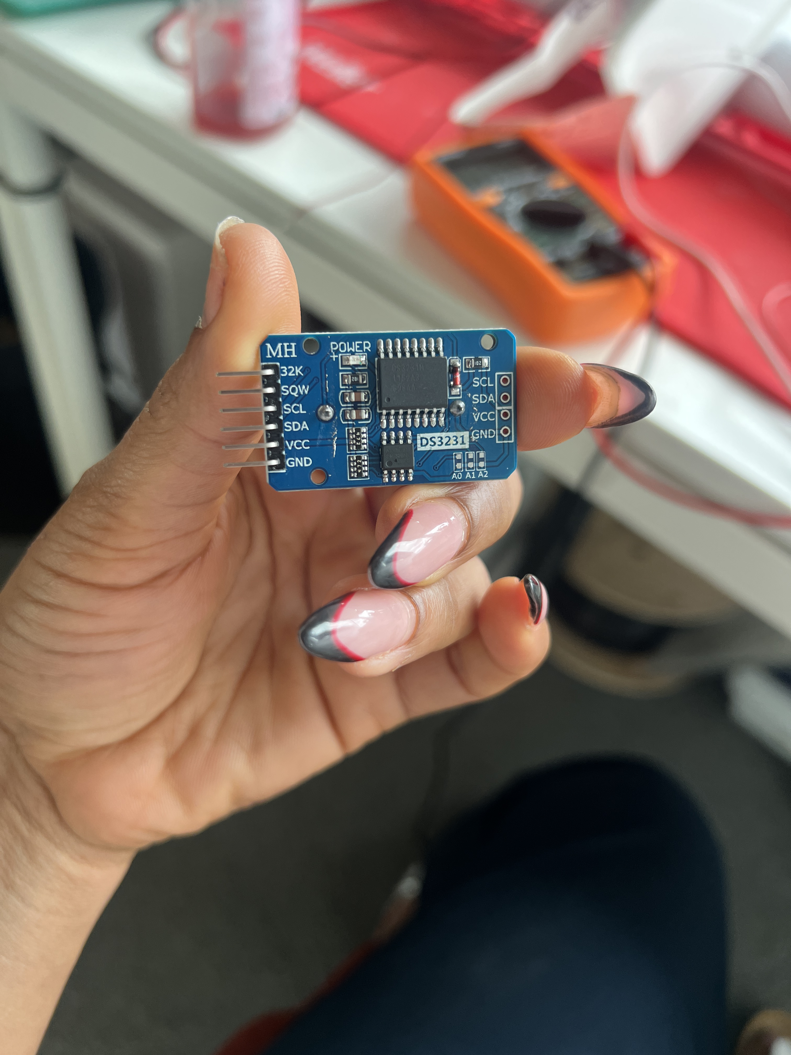
Building Phases/IMG_8621.jpeg
