Madina1219/ConnectGuinea/Building Phases/IMG_8622.jpeg

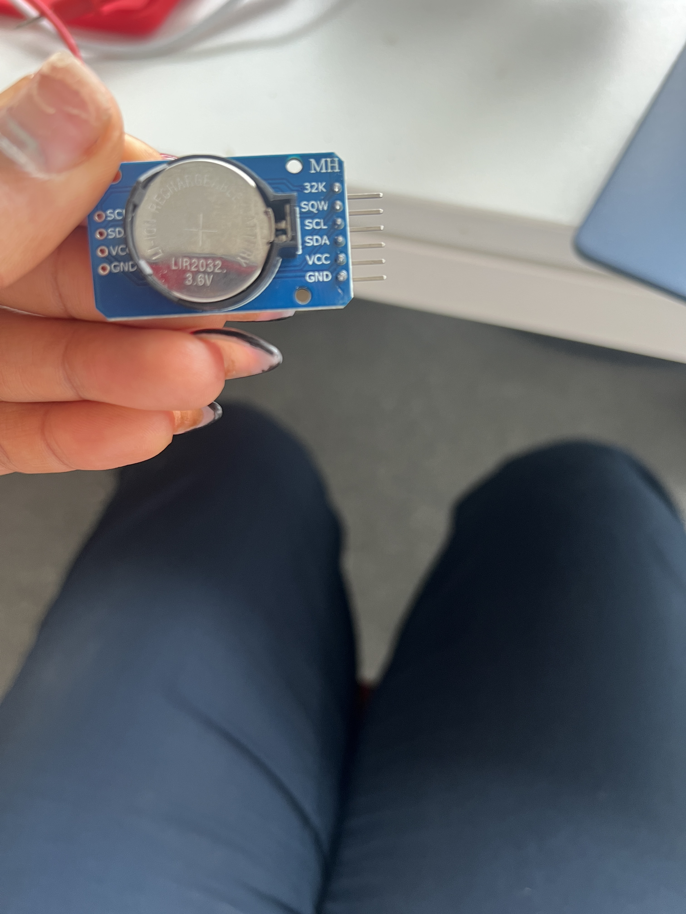
Building Phases/IMG_8622.jpeg
