Madina1219/ConnectGuinea/Dissertation Support and Additional Information/Design/Totem Wiring Schematic 2.png

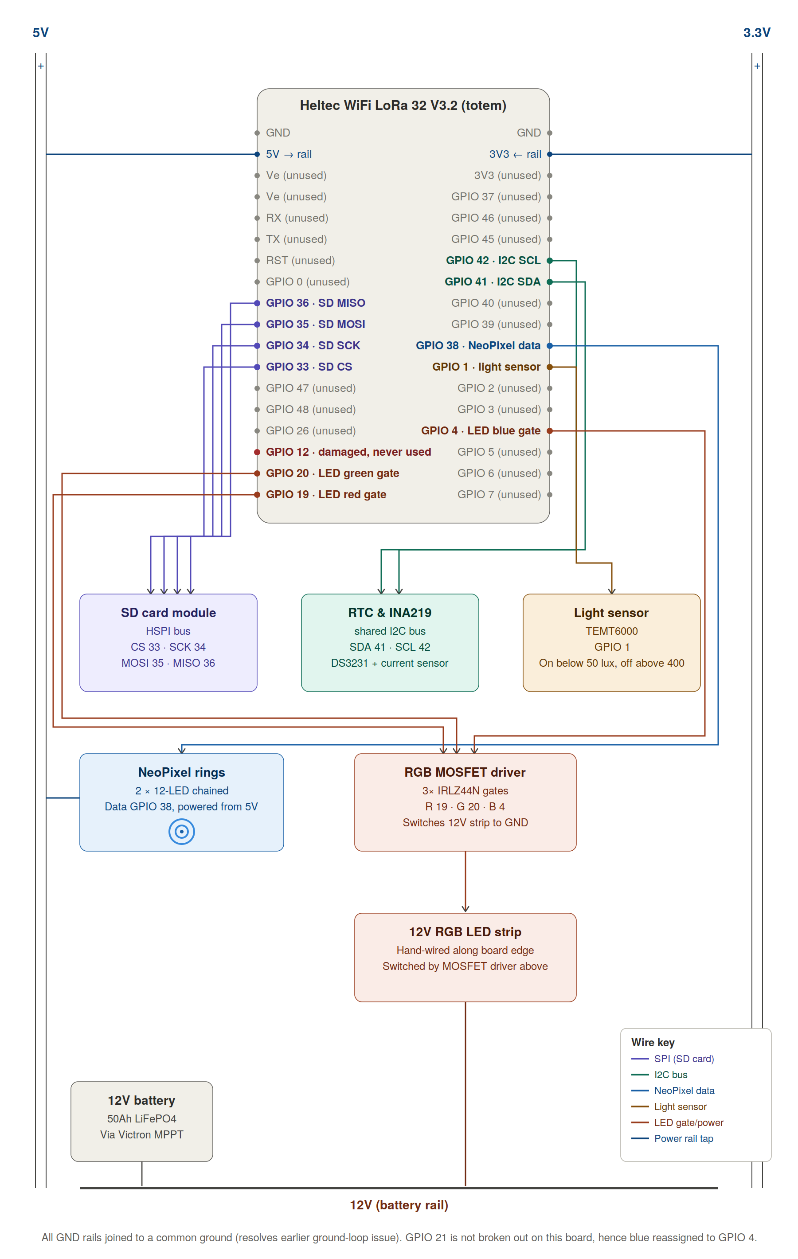
Dissertation Support and Additional Information/Design/Totem Wiring Schematic 2.png
