Madina1219/ConnectGuinea/Dissertation Support and Additional Information/Implementation/Figure 4.3-Software flowchart illustrating the operational sequence of the Smart Community Totem..png

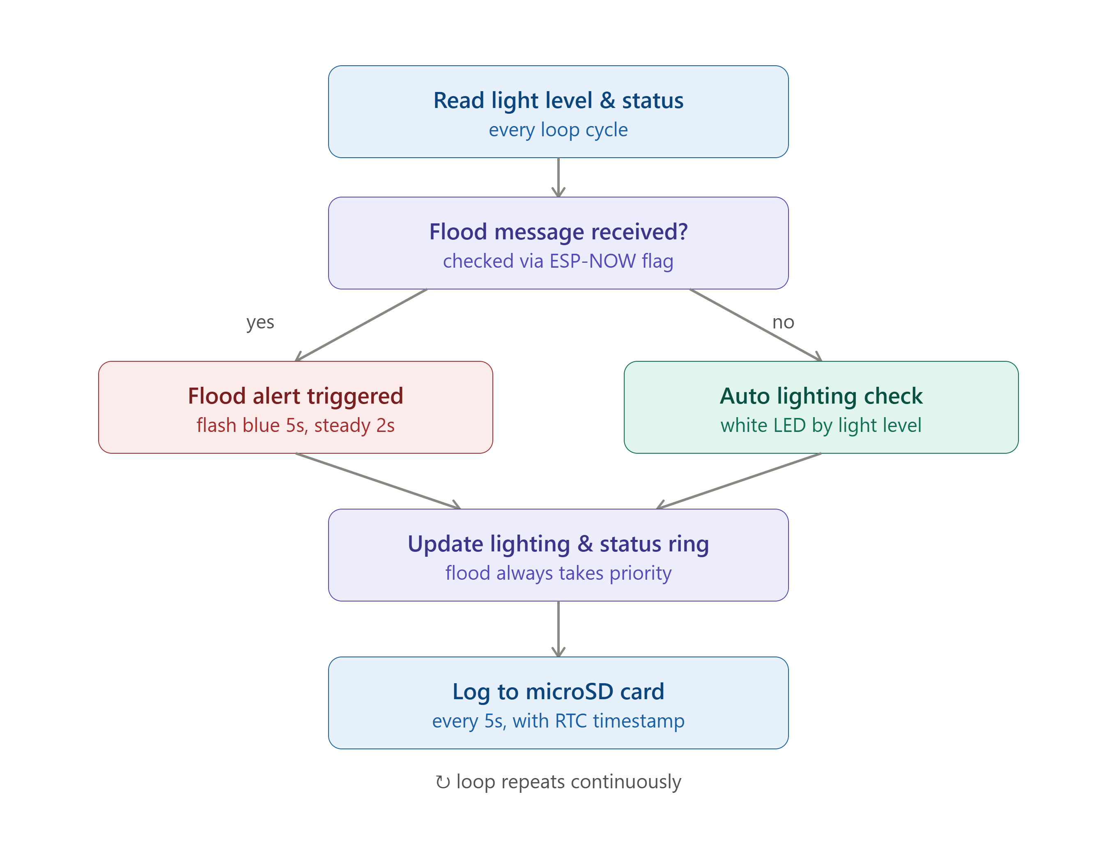
Dissertation Support and Additional Information/Implementation/Figure 4.3-Software flowchart illustrating the operational sequence of the Smart Community Totem..png
