Madina1219/ConnectGuinea/Dissertation Support and Additional Information/Result/Table 5.4-Summary of Smart Community Totem operational and electrical performance..png

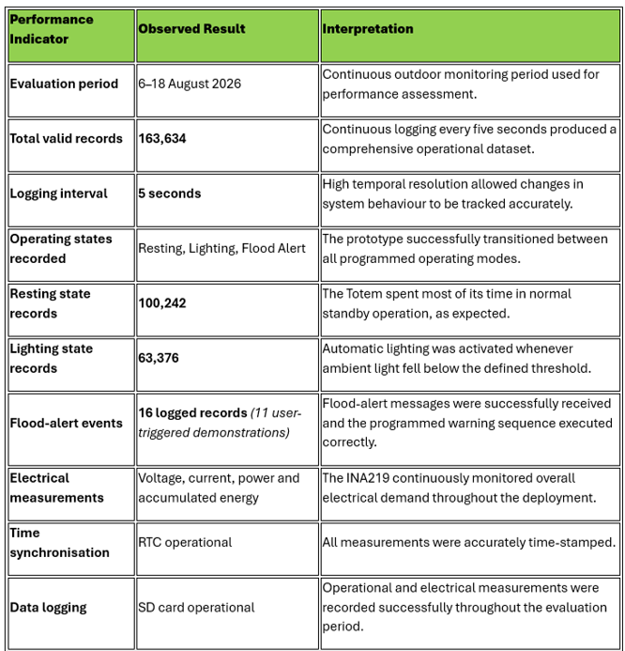
Dissertation Support and Additional Information/Result/Table 5.4-Summary of Smart Community Totem operational and electrical performance..png
