Madina1219/ConnectGuinea/Docs/Images activities around Light and flood in Africa/Tea making 2.jpg

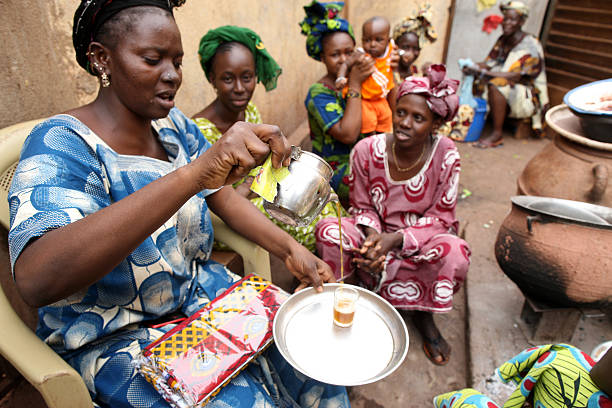
Docs/Images activities around Light and flood in Africa/Tea making 2.jpg
