Madina1219/ConnectGuinea/Totem Components/Breadboard Kit Solderable Breadboards for Electronics Projects Compatible for DIY Soldering Circuits.jpg

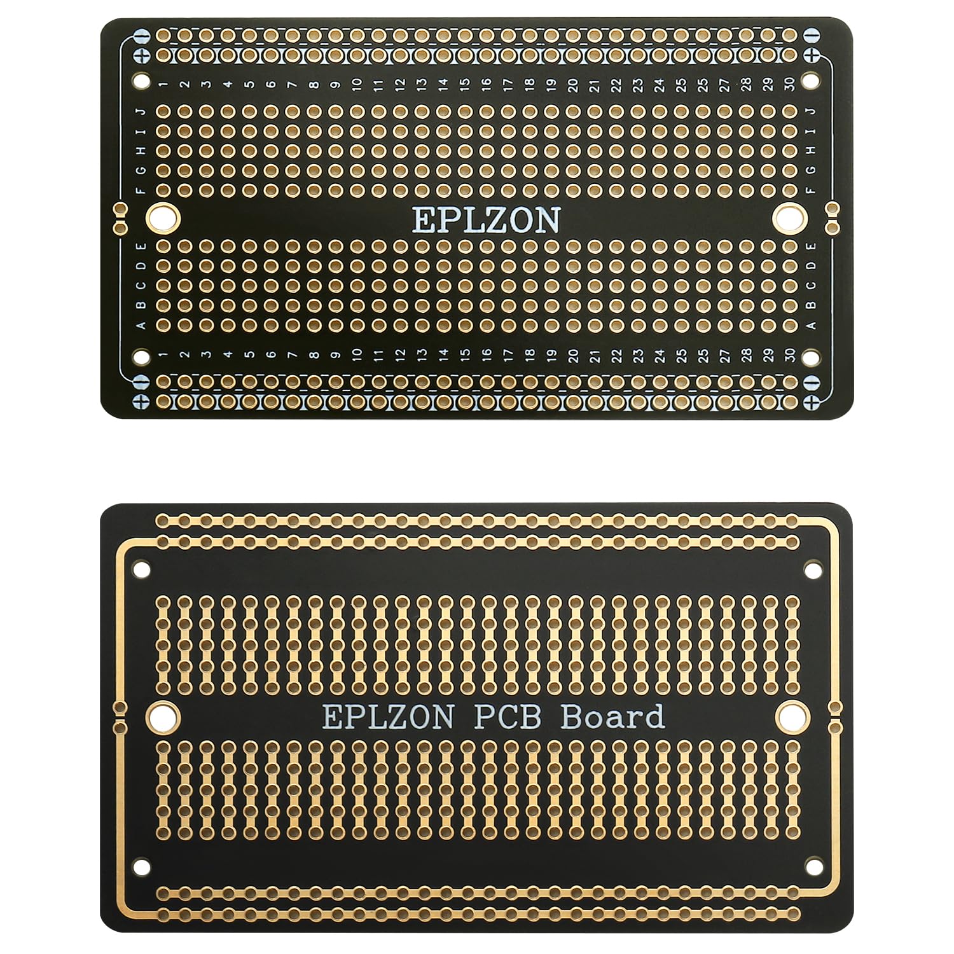
Totem Components/Breadboard Kit Solderable Breadboards for Electronics Projects Compatible for DIY Soldering Circuits.jpg
