Madina1219/ConnectGuinea/Totem Components/DCDC Volt Step Down Converter 12V to 5V 3A 15W Regulator Buck Car Power Supply.webp

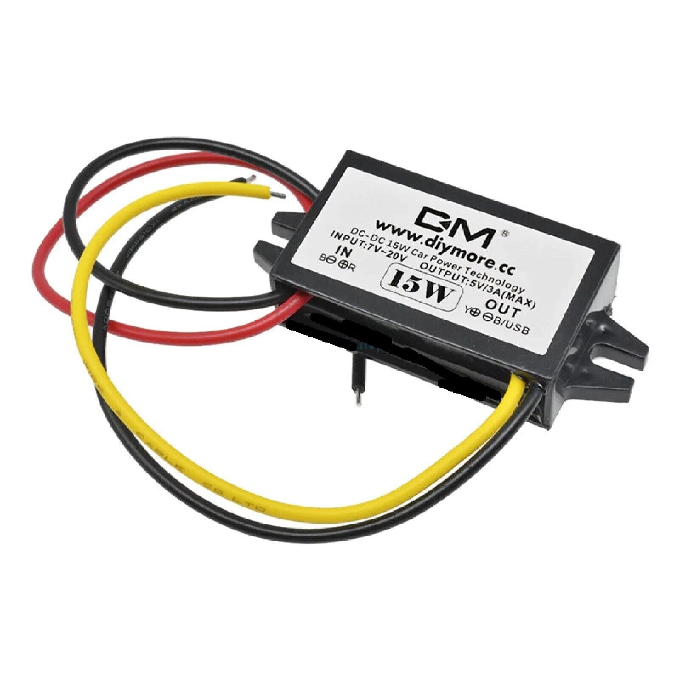
Totem Components/DCDC Volt Step Down Converter 12V to 5V 3A 15W Regulator Buck Car Power Supply.webp
