Madina1219/ConnectGuinea/Data/SmartCommunityTotem_Results_Dashboard.xlsx

Sheet: Dashboard
Smart Community Totem – Integrated Deployment Results Dashboard |  |  |  |  |  |  |  |  |  |  | Date | MPPT Yield | MPPT Consumption | Totem Energy | UCL Cloud | Siguiri Cloud | Siguiri Rain | Lighting Hours
 |  |  |  |  |  |  |  |  |  |  | 6 Aug | 40 | 110 | 25.14642958 | 45.47826087 | 49.16666667 | 10.62 | 4.624375877
Outdoor deployment at UCL East, One Pool Street | 6–18 August 2026 | Totem logs + MPPT solar history + OpenWeather historical data |  |  |  |  |  |  |  |  |  |  | 7 Aug | 40 | 110 | 26.21328891 | 8.166666667 | 83.75 | 7.18 | 4.356666667
 |  |  |  |  |  |  |  |  |  |  | 8 Aug | 470 | 0 |  | 41.08333333 | 80.79166667 | 0
Valid Totem records |  |  | Full logging days |  |  | Mean full-day energy |  |  | Mean full-day lighting | Flood test events | 9 Aug | 270 | 80 | 25.72210385 | 26.08333333 | 88.45833333 | 3.72 | 3.167176647
163632 |  |  | 8 |  |  | 70.8 Wh/day |  |  | 9.06 h/day | 11 | 10 Aug | 330 | 200 | 68.55768911 | 61.75 | 96.83333333 | 48.79 | 8.817083513
 |  |  |  |  |  |  |  |  |  |  | 11 Aug | 320 | 200 | 69.09071286 | 13.625 | 73.91666667 | 0 | 8.819472449
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
