Madina1219/ConnectGuinea/Dissertation Support and Additional Information/Result/Guinea-Sigguiri Historical Weather Data.csv

dt | dt_iso | timezone | city_name | lat | lon | temp | visibility | dew_point | feels_like | temp_min | temp_max | pressure | sea_level | grnd_level | humidity | wind_speed | wind_deg | wind_gust | rain_1h | rain_3h | snow_1h | snow_3h | clouds_all | weather_id | weather_main | weather_description | weather_icon
1785974400 | 2026-08-06 00:00:00 +0000 UTC | 0 | Siguiri | 11.414811 | -9.17883 | 298.29 |  | 296.72 | 299.24 | 298.12 | 298.42 | 1015 |  |  | 91 | 2.04 | 313 |  | 0.15 |  |  |  | 72 | 500 | Rain | light rain | 10n
1785978000 | 2026-08-06 01:00:00 +0000 UTC | 0 | Siguiri | 11.414811 | -9.17883 | 298.36 |  | 296.78 | 299.31 | 298.24 | 298.52 | 1014 |  |  | 91 | 1.67 | 305 |  | 0.14 |  |  |  | 38 | 500 | Rain | light rain | 10n
1785981600 | 2026-08-06 02:00:00 +0000 UTC | 0 | Siguiri | 11.414811 | -9.17883 | 298.15 |  | 296.94 | 299.13 | 298.01 | 298.31 | 1013 |  |  | 93 | 1.41 | 293 |  | 0.33 |  |  |  | 24 | 500 | Rain | light rain | 10n
1785985200 | 2026-08-06 03:00:00 +0000 UTC | 0 | Siguiri | 11.414811 | -9.17883 | 298.03 |  | 297 | 299.03 | 297.85 | 298.17 | 1012 |  |  | 94 | 1.36 | 283 |  |  |  |  |  | 21 | 801 | Clouds | few clouds | 02n
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
