Madina1219/ConnectGuinea/Dissertation Support and Additional Information/Result/UCL East Historical Weather Data.csv

dt | dt_iso | timezone | city_name | lat | lon | temp | visibility | dew_point | feels_like | temp_min | temp_max | pressure | sea_level | grnd_level | humidity | wind_speed | wind_deg | wind_gust | rain_1h | rain_3h | snow_1h | snow_3h | clouds_all | weather_id | weather_main | weather_description | weather_icon
1785974400 | 2026-08-06 00:00:00 +0000 UTC | 3600 | UCL East - One Pool Street | 51.538265 | -0.009753 | 290.49 |  | 283.39 | 289.92 | 289.14 | 290.94 | 1019 |  |  | 63 | 3.13 | 231 | 4.02 |  |  |  |  | 10 | 800 | Clear | sky is clear | 01n
1785978000 | 2026-08-06 01:00:00 +0000 UTC | 3600 | UCL East - One Pool Street | 51.538265 | -0.009753 | 289.62 |  | 283.26 | 289.05 | 288.02 | 289.83 | 1019 |  |  | 66 | 0.89 | 313 | 1.79 |  |  |  |  | 5 | 800 | Clear | sky is clear | 01n
1785981600 | 2026-08-06 02:00:00 +0000 UTC | 3600 | UCL East - One Pool Street | 51.538265 | -0.009753 | 289.01 |  | 283.12 | 288.43 | 287.47 | 289.27 | 1020 |  |  | 68 | 2.68 | 186 | 3.58 |  |  |  |  | 2 | 800 | Clear | sky is clear | 01n
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
