Madina1219/ConnectGuinea/Arduino Codes/SmartGuineaLight_Totem/FloodAlertReceivedTest.png

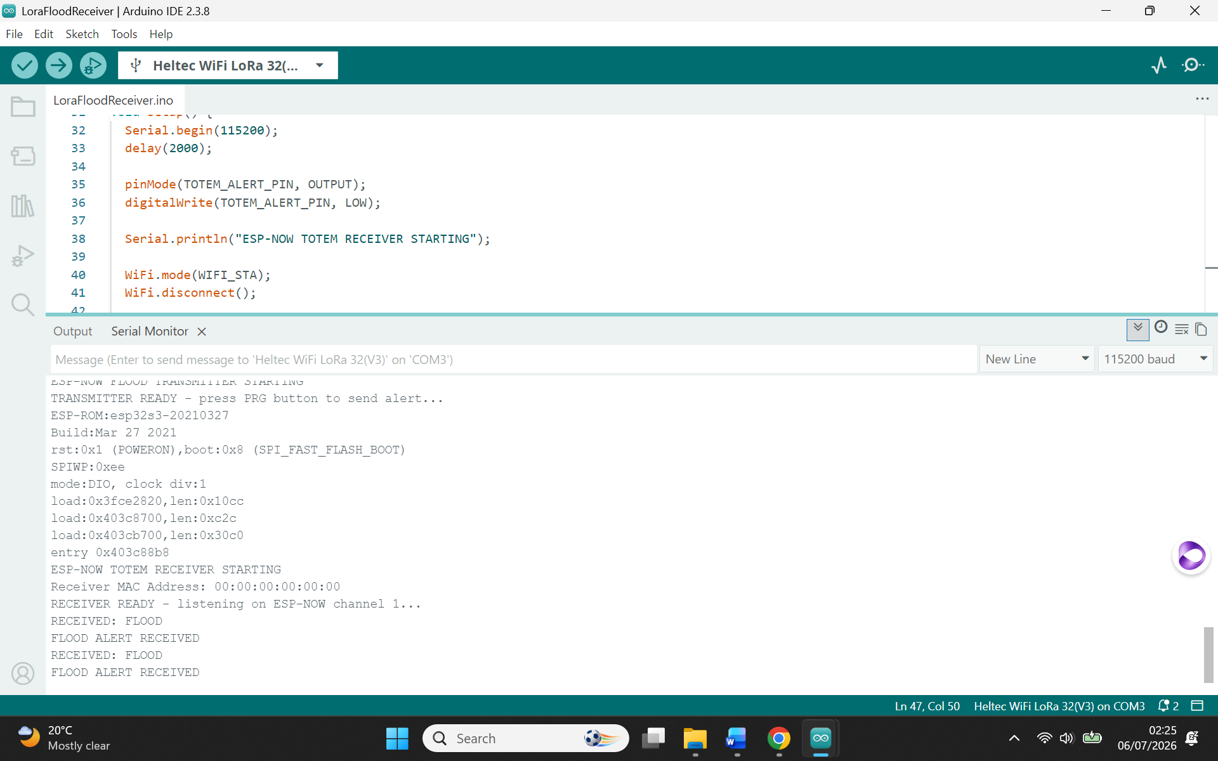
Arduino Codes/SmartGuineaLight_Totem/FloodAlertReceivedTest.png
