Madina1219/ConnectGuinea/Arduino Codes/SmartGuineaLight_Totem/FloodAlertSentResult.png

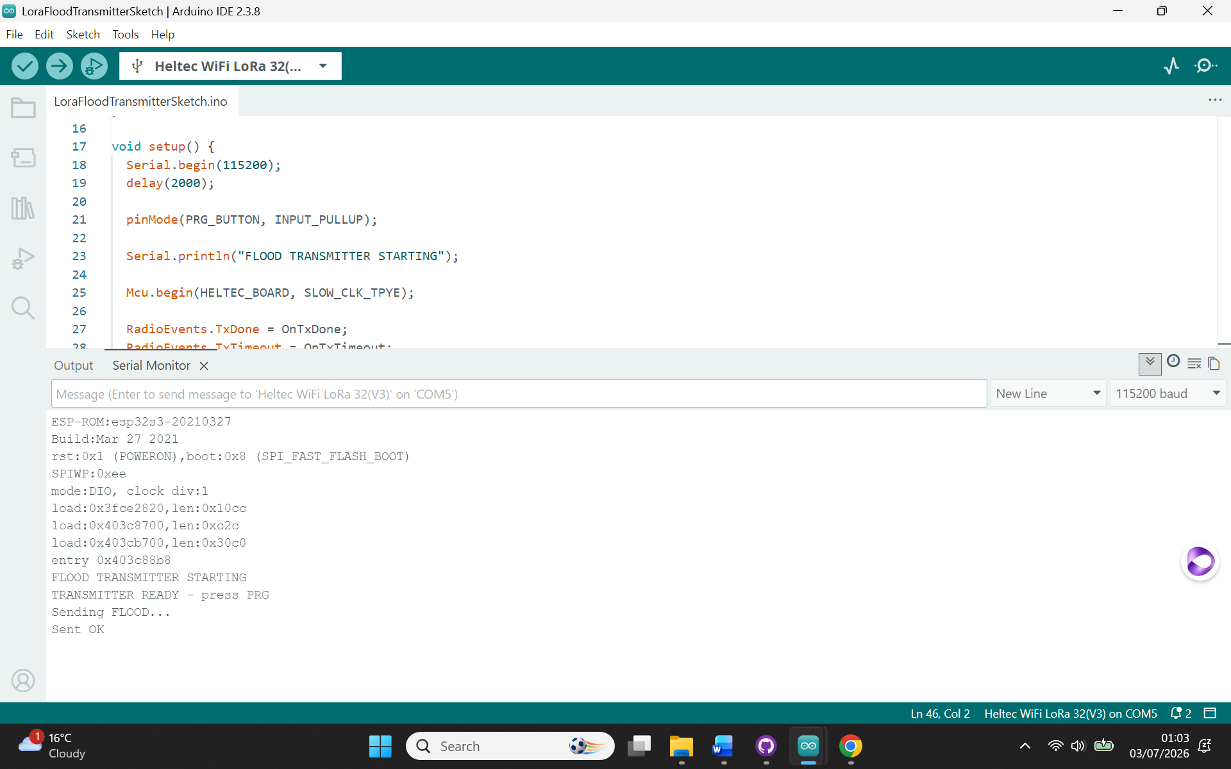
Arduino Codes/SmartGuineaLight_Totem/FloodAlertSentResult.png
