Madina1219/ConnectGuinea/Dissertation Support and Additional Information/Implementation/Figure 4.4- laboratory testing, public exhibition and outdoor deployment..png

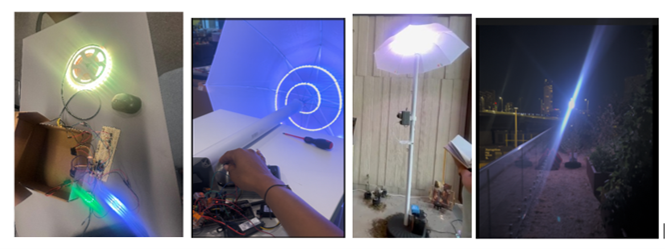
Dissertation Support and Additional Information/Implementation/Figure 4.4- laboratory testing, public exhibition and outdoor deployment..png
