Madina1219/ConnectGuinea/Dissertation Support and Additional Information/Implementation/Table 5.2-Historical weather conditions at UCL East during the Smart Community Totem outdoor evaluation, 6–18 August 2026..png

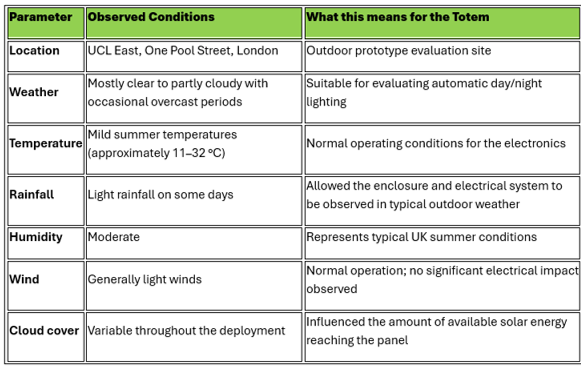
Dissertation Support and Additional Information/Implementation/Table 5.2-Historical weather conditions at UCL East during the Smart Community Totem outdoor evaluation, 6–18 August 2026..png
