Madina1219/ConnectGuinea/Dissertation Support and Additional Information/Introduction/able 1.1-Research Framework Showing the Research Aim, Objectives and Evaluation Approach.png

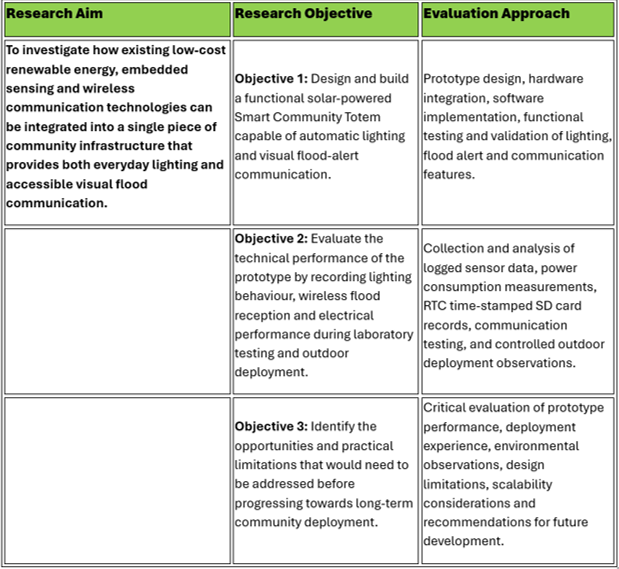
Dissertation Support and Additional Information/Introduction/able 1.1-Research Framework Showing the Research Aim, Objectives and Evaluation Approach.png
