Madina1219/ConnectGuinea/Dissertation Support and Additional Information/Result/Battery Behaviour.png

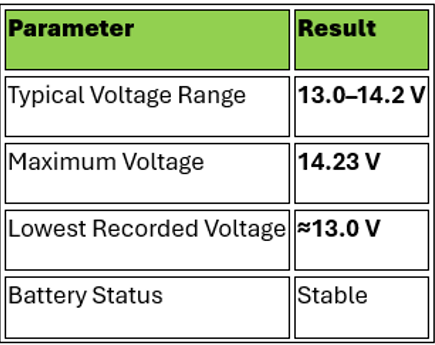
Dissertation Support and Additional Information/Result/Battery Behaviour.png
