Madina1219/ConnectGuinea/Dissertation Support and Additional Information/Result/Electrical Performance.png

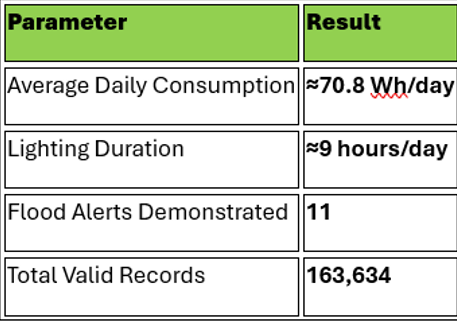
Dissertation Support and Additional Information/Result/Electrical Performance.png
