Madina1219/ConnectGuinea/Dissertation Support and Additional Information/Result/SmartCommunityTotem_Figure5_2_IntegratedDashboard (2).png

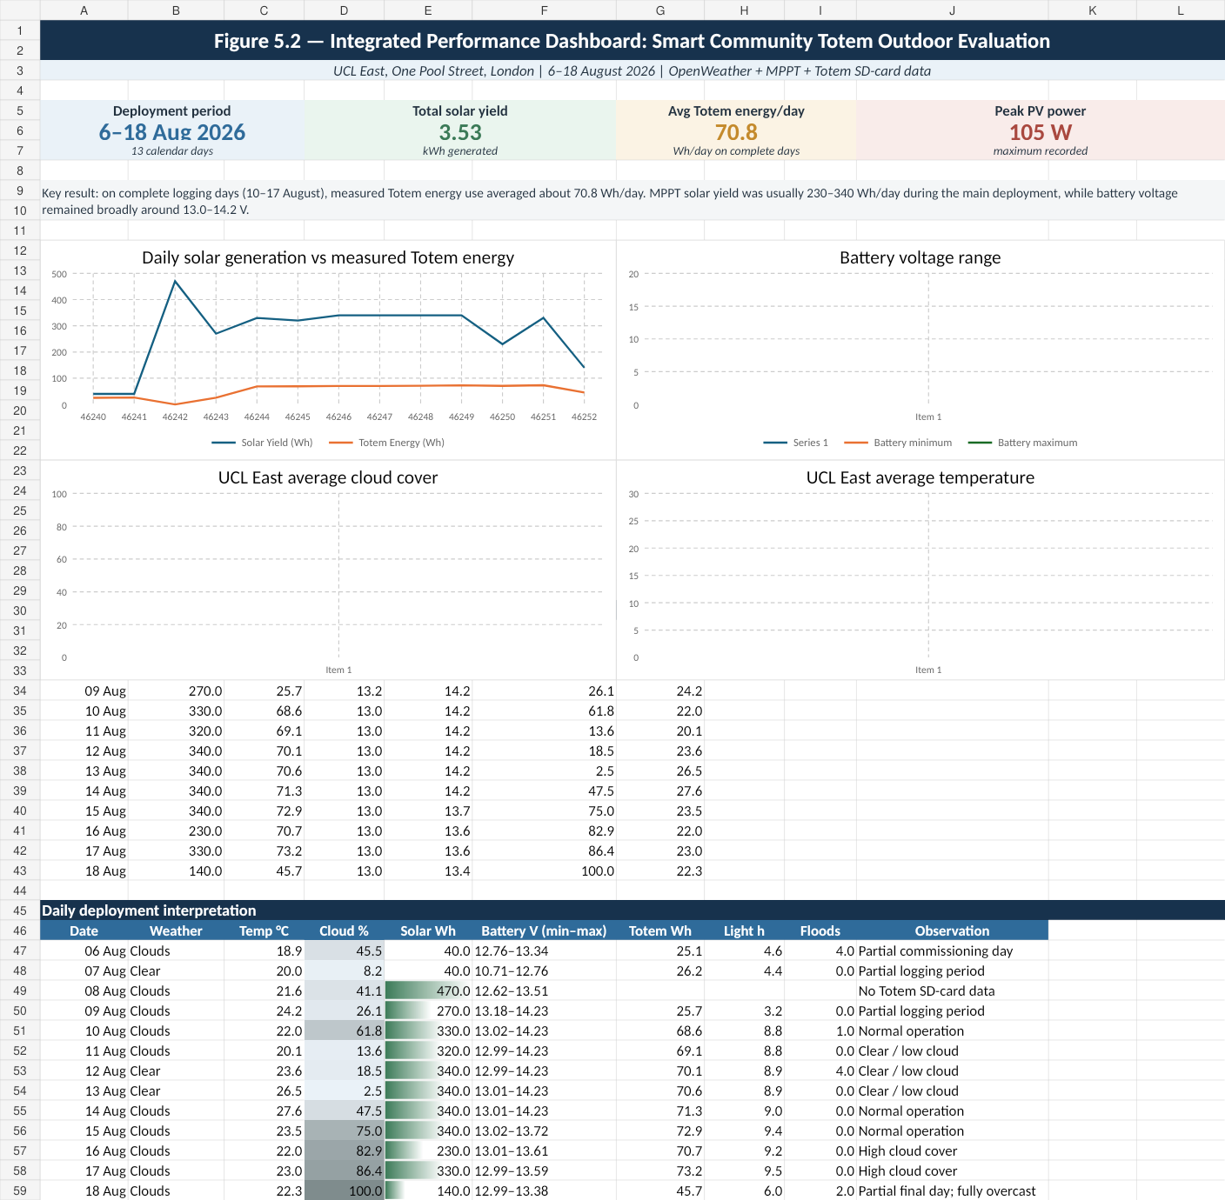
Dissertation Support and Additional Information/Result/SmartCommunityTotem_Figure5_2_IntegratedDashboard (2).png
