Madina1219/ConnectGuinea/Dissertation Support and Additional Information/Result/Table 5.3-Daily MPPT solar-energy generation and battery-voltage range during deployment.png

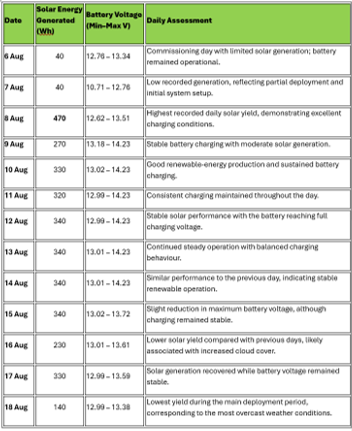
Dissertation Support and Additional Information/Result/Table 5.3-Daily MPPT solar-energy generation and battery-voltage range during deployment.png
