Madina1219/ConnectGuinea/Dissertation Support and Additional Information/Result/Table 6.Comparison of environmental conditions at the London prototype evaluation site and Siguiri, Guinea, during 6–18 August 2026..png

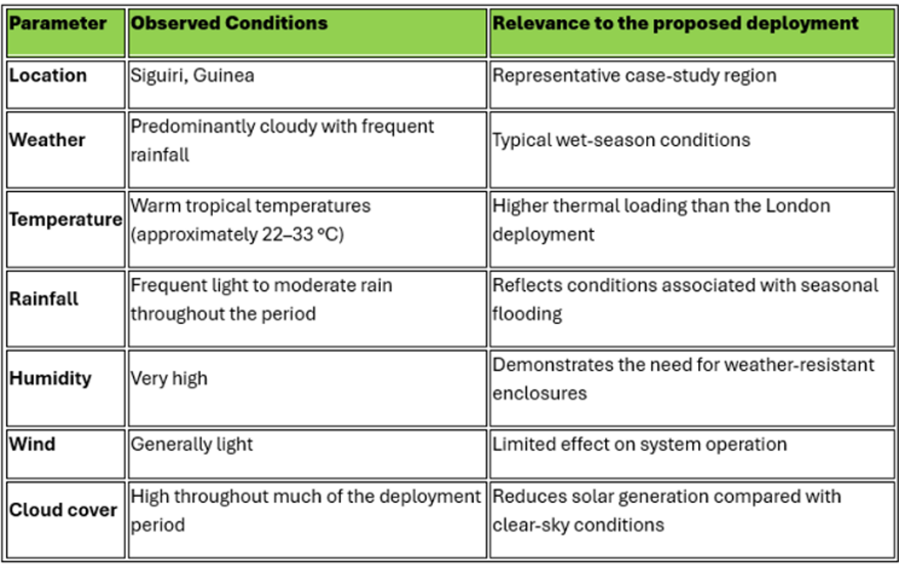
Dissertation Support and Additional Information/Result/Table 6.Comparison of environmental conditions at the London prototype evaluation site and Siguiri, Guinea, during 6–18 August 2026..png
