Madina1219/ConnectGuinea/Docs/Totem Schematics/totem_full_wiring_schematic.pdf

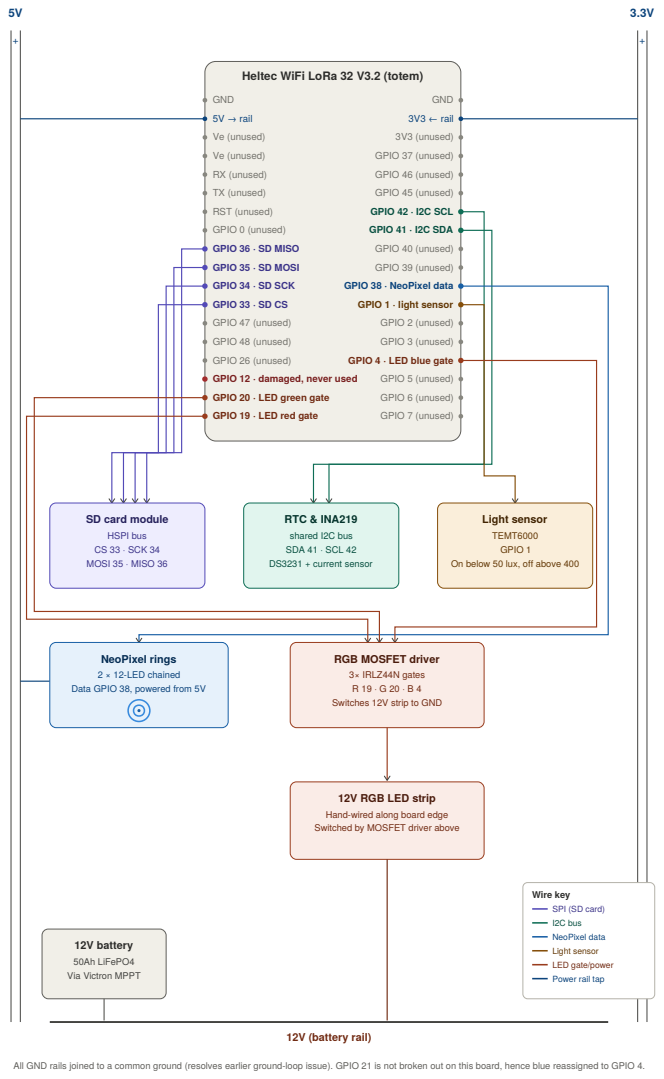
[picture p298: page 1]
12V (battery rail); RTC & INA219 shared I2C bus SDA 41 · SCL 42 DS3231 + current sensor; Light sensor TEMT6000 GPIO 1; 12V battery 50Ah LiFePO4 Via Victron MPPT

Heltec WiFi LoRa 32 V3.2 (totem)
GND
5V → rail
Ve (unused)
RX (unused)
TX (unused)
RST (unused)
GPIO 0 (unused)
GPIO 36 · SD MISO
GPIO 35 · SD MOSI
GPIO 34 · SD SCK
GPIO 33 · SD CS
GPIO 47 (unused)
GPIO 48 (unused)
GPIO 26 (unused)
GPIO 12 · damaged, never used
GPIO 20 · LED green gate
GPIO 19 · LED red gate

3V3 ← rail
3V3 (unused)
GPIO 37 (unused)
GPIO 46 (unused)
GPIO 45 (unused)
GPIO 42 · I2C SCL
GPIO 41 · I2C SDA
GPIO 40 (unused)
GPIO 39 (unused)
GPIO 38 · NeoPixel data
GPIO 1 · light sensor
GPIO 2 (unused)
GPIO 3 (unused)
GPIO 4 · LED blue gate
GPIO 5 (unused)
GPIO 6 (unused)
GPIO 7 (unused)

SD card module
HSPI bus
CS 33 · SCK 34
MOSI 35 · MISO 36

On below 50 lux, off above 400

NeoPixel rings
2 × 12-LED chained
Data GPIO 38, powered from 5V

RGB MOSFET driver
3× IRLZ44N gates
Switches 12V strip to GND

12V RGB LED strip
Hand-wired along board edge
Switched by MOSFET driver above

Wire key
SPI (SD card)
I2C bus
NeoPixel data
Light sensor
LED gate/power
Power rail tap

All GND rails joined to a common ground (resolves earlier ground-loop issue). GPIO 21 is not broken out on this board, hence blue reassigned to GPIO 4.
