Madina1219/ConnectGuinea/(commit log)

2026-06-23 Rename project to SmartLight Totem and update README
    Updated project name and expanded description with hardware details and current status.
2026-07-20 Revise README
    Updated project name and description, added detailed sections about project functions, hardware components, and prototype status.
2026-07-21 Revise README
    Updated the README to clarify the project structure, enhance descriptions of the devices, and improve the status section.
2026-07-21 Improve README
    Revised the intended alert flow section for clarity and formatting.
2026-08-24 Dissertation Support
    [Guinea-Sigguiri Historical Weather Data.csv, MPPT SolarHistory.xlsx, UCL East Historical Weather Data.csv]
2026-08-24 Enhance README with detailed project overview and features
    Expanded project description and clarified functionalities of the Guinea Smart Community Totem, including automatic lighting, flood warning, and USB charging capabilities. Updated sections on prototype status, hardware components, and future development plans.
2026-08-24 Update image and video links in README
    Updated image source for the final prototype and added a link for the flood-warning demonstration video.
2026-08-24 Fix image syntax in README for final prototype
2026-08-24 Update final prototype image and caption
    Updated image reference and description for the final prototype.
2026-08-24 Final Prototype Image
2026-08-24 Change image source for final prototype display
    Updated image reference for the final prototype in README.
