Madina1219/ConnectGuinea/Final Prototype and Exhibition/IMG_8650.jpeg

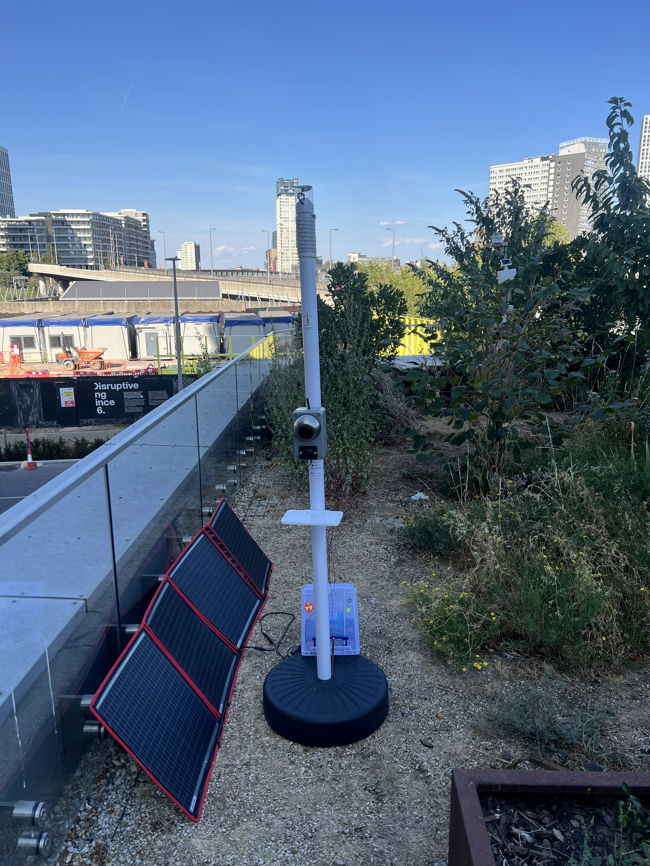
Final Prototype and Exhibition/IMG_8650.jpeg
