Madina1219/ConnectGuinea/Final Prototype and Exhibition/IMG_8651 (1).jpeg

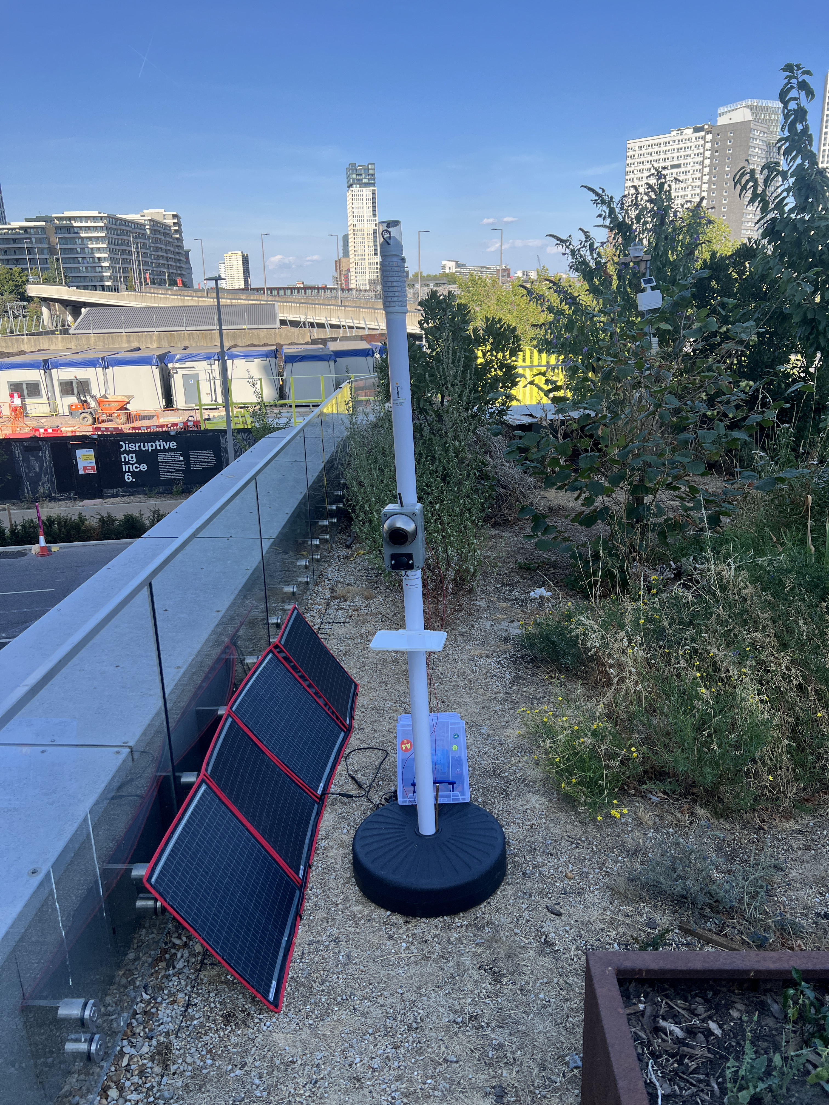
Final Prototype and Exhibition/IMG_8651 (1).jpeg
