Madina1219/ConnectGuinea/Final Prototype and Exhibition/IMG_8652.jpeg

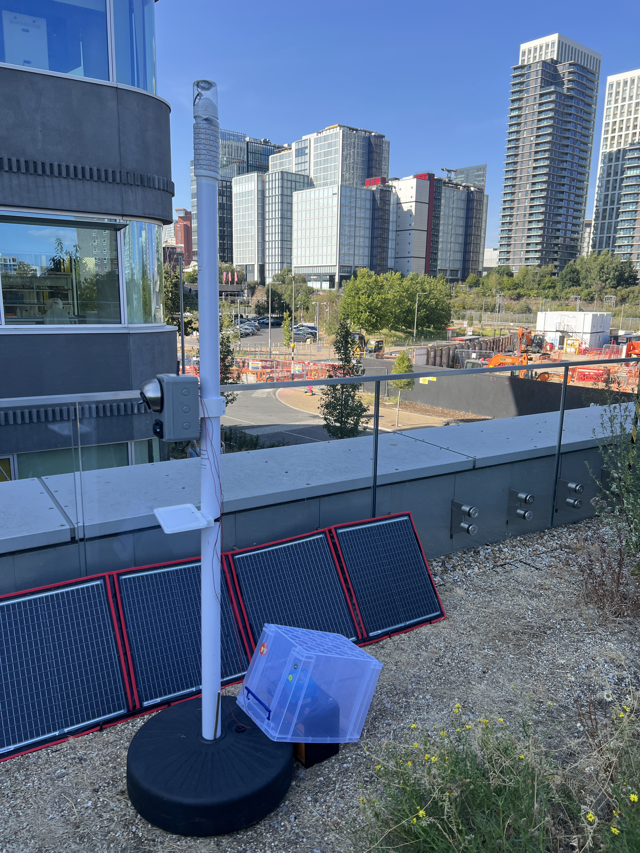
Final Prototype and Exhibition/IMG_8652.jpeg
