Madina1219/ConnectGuinea/Final Prototype and Exhibition/IMG_8725.jpeg

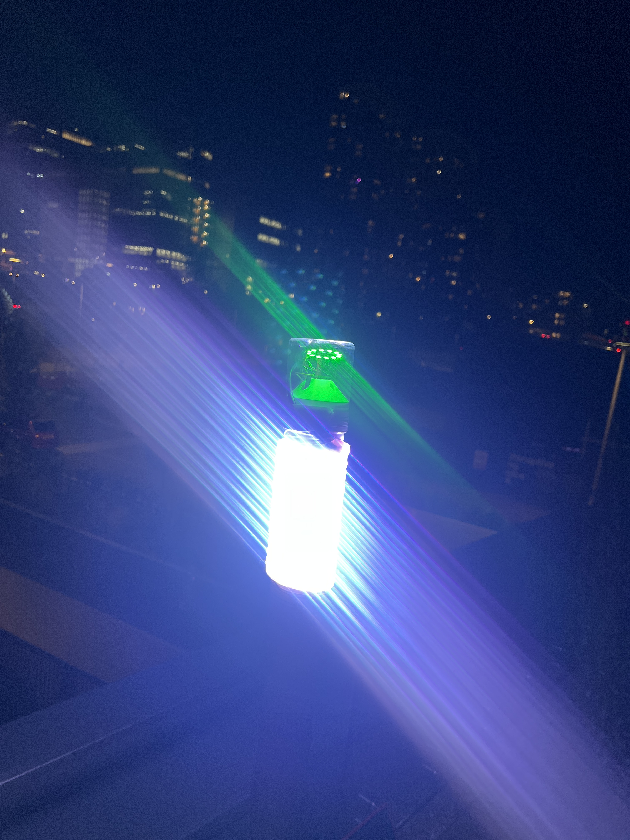
Final Prototype and Exhibition/IMG_8725.jpeg
