Madina1219/ConnectGuinea/Final Prototype and Exhibition/IMG_8726.jpeg

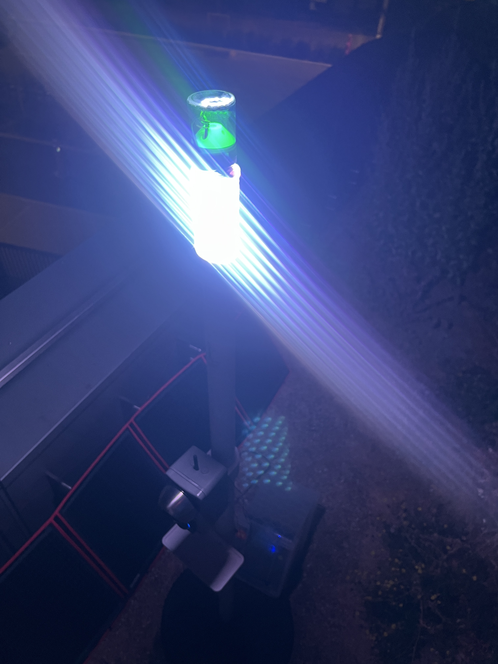
Final Prototype and Exhibition/IMG_8726.jpeg
