Madina1219/ConnectGuinea/Final Prototype and Exhibition/IMG_8734.jpeg

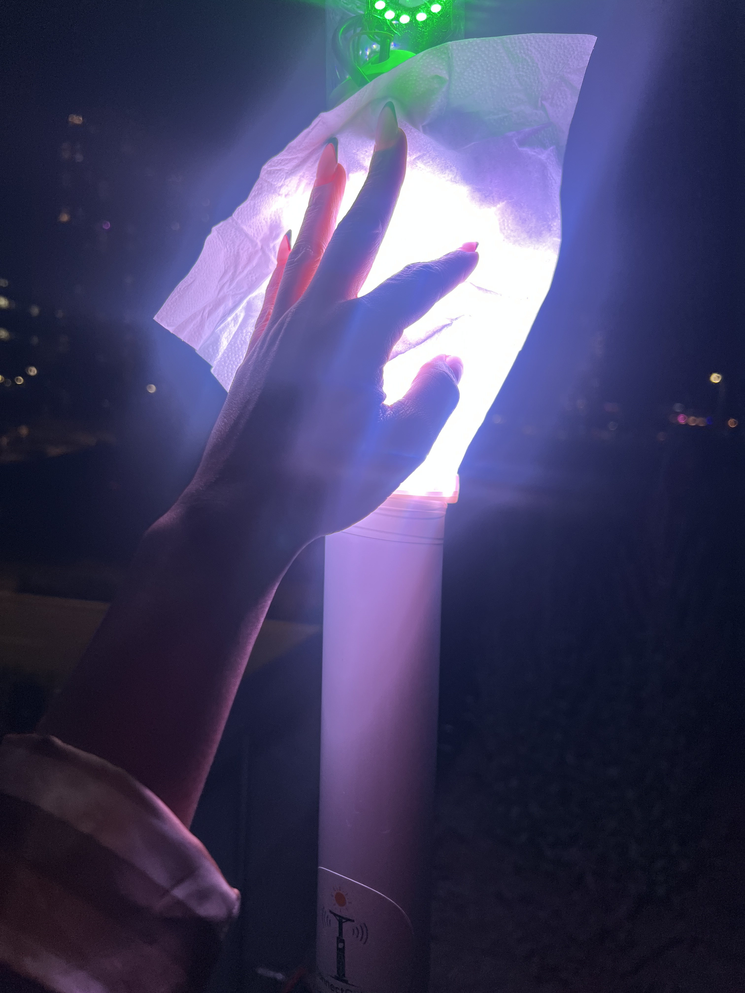
Final Prototype and Exhibition/IMG_8734.jpeg
