Madina1219/ConnectGuinea/Final Prototype and Exhibition/IMG_8735 (1).jpeg

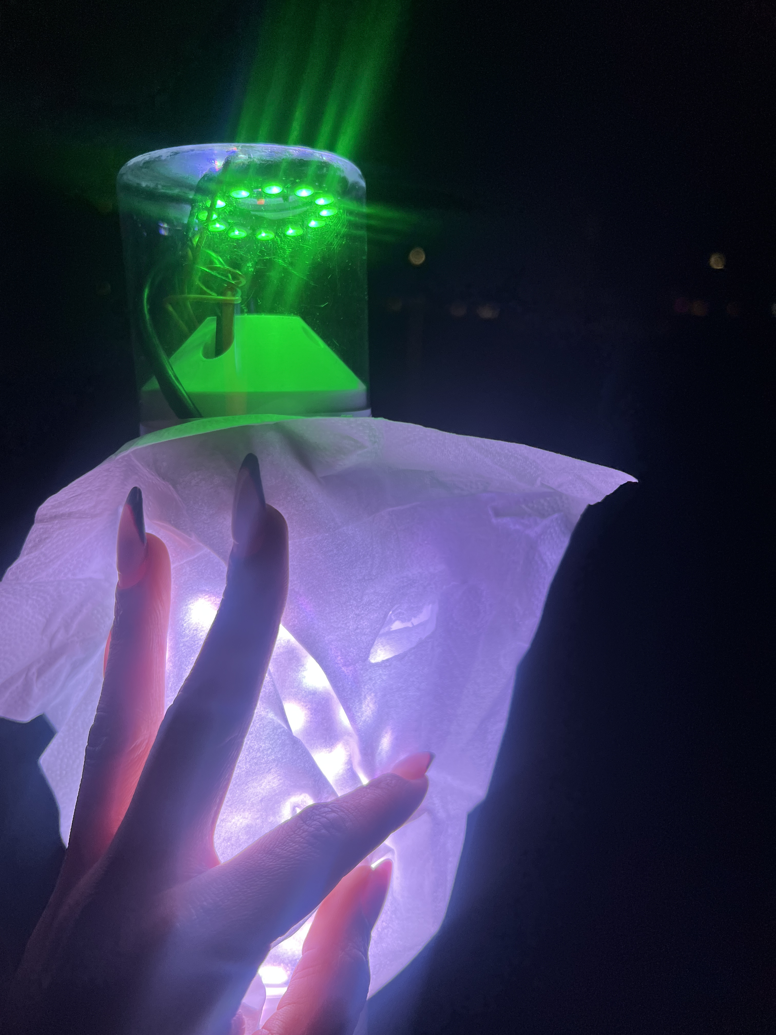
Final Prototype and Exhibition/IMG_8735 (1).jpeg
