Madina1219/ConnectGuinea/Final Prototype and Exhibition/IMG_8738.jpeg

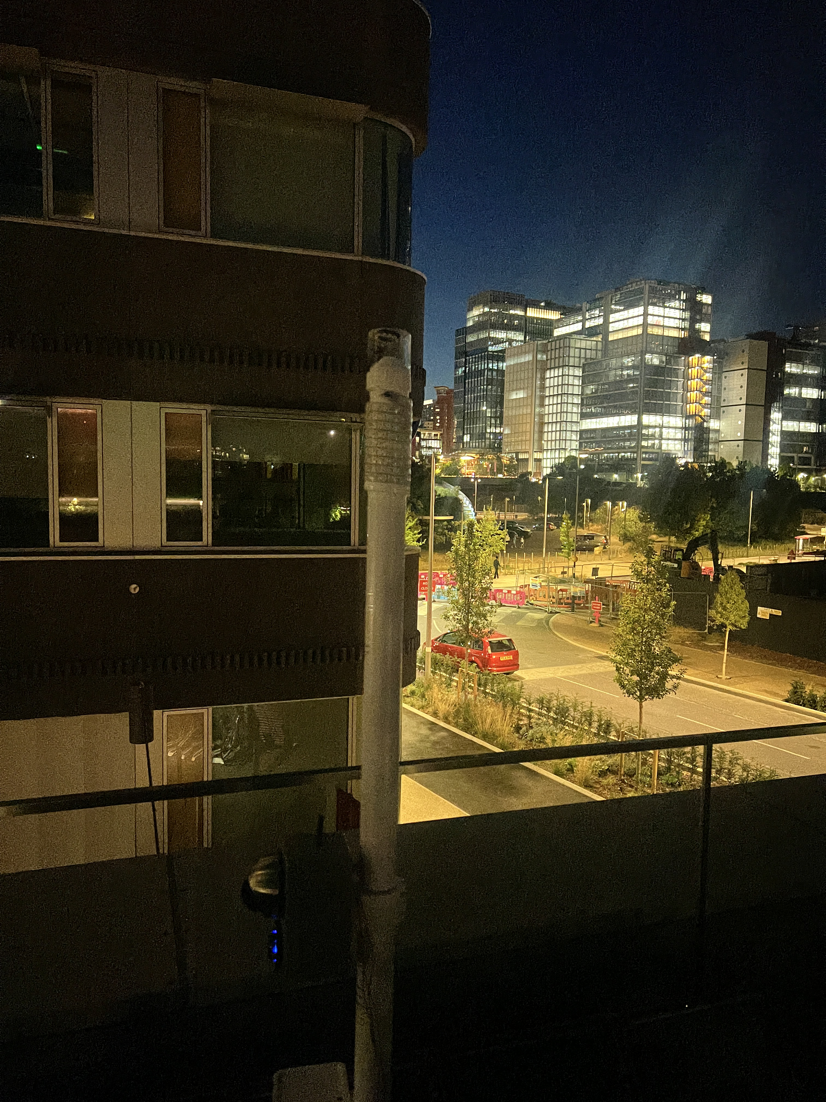
Final Prototype and Exhibition/IMG_8738.jpeg
