Madina1219/ConnectGuinea/Final Prototype and Exhibition/IMG_8869.jpeg

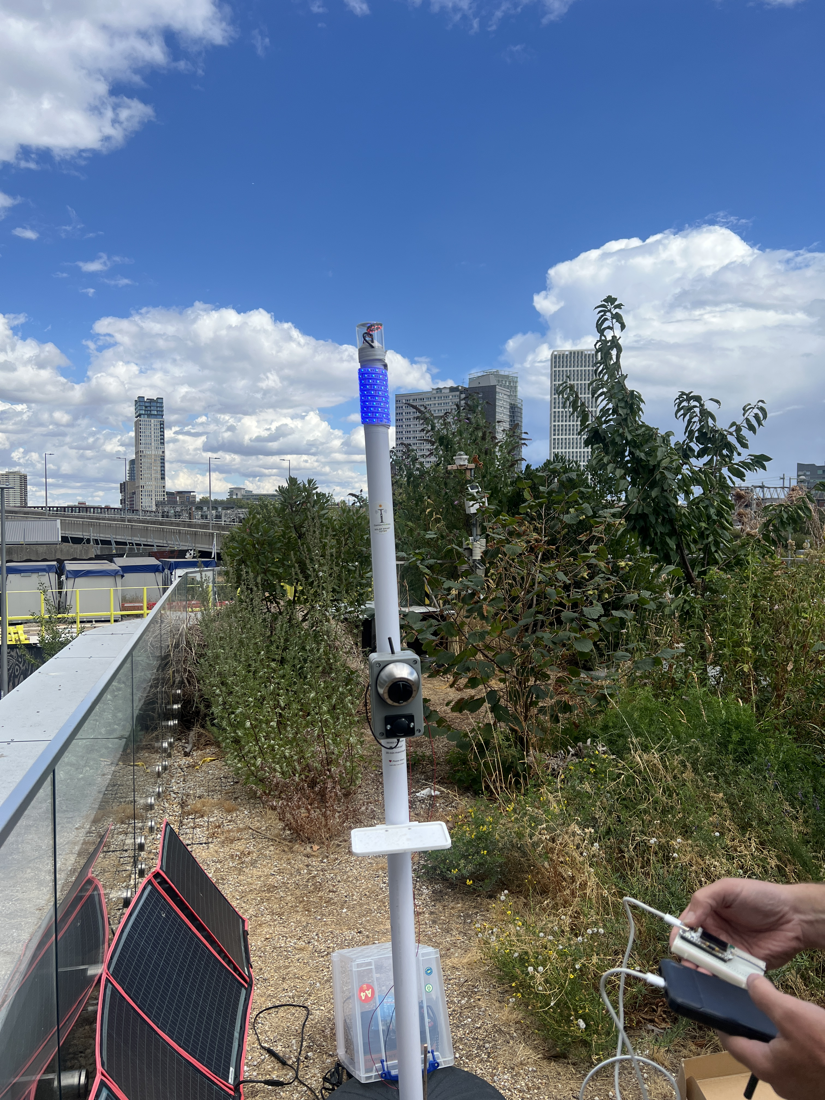
Final Prototype and Exhibition/IMG_8869.jpeg
