Madina1219/ConnectGuinea/Final Prototype and Exhibition/IMG_8873.jpeg

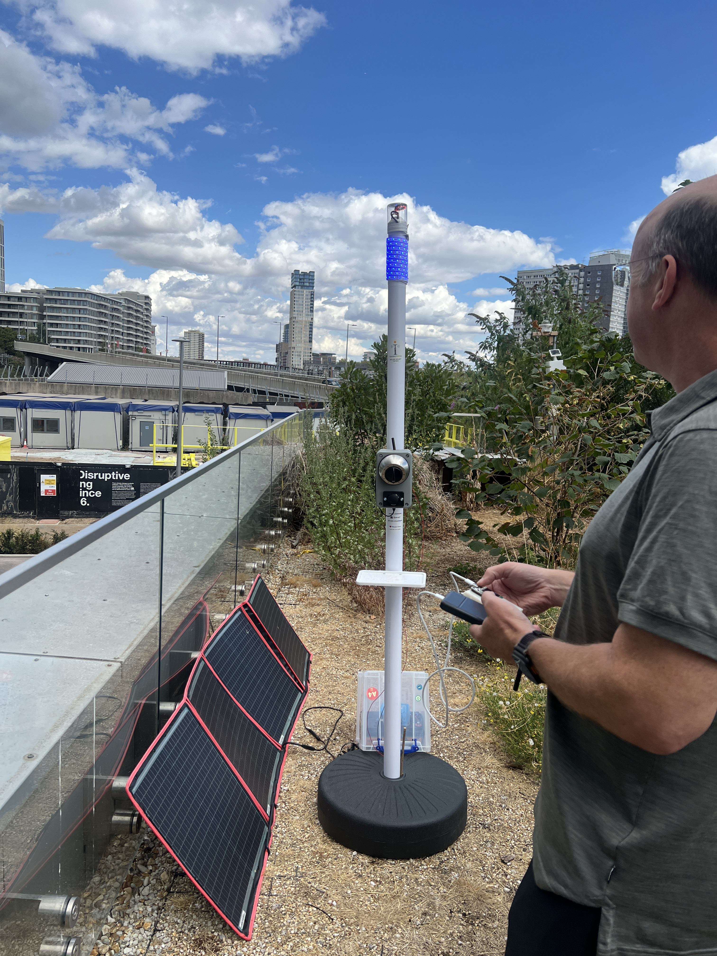
Final Prototype and Exhibition/IMG_8873.jpeg
