Madina1219/ConnectGuinea/Final Prototype and Exhibition/IMG_8874.jpeg

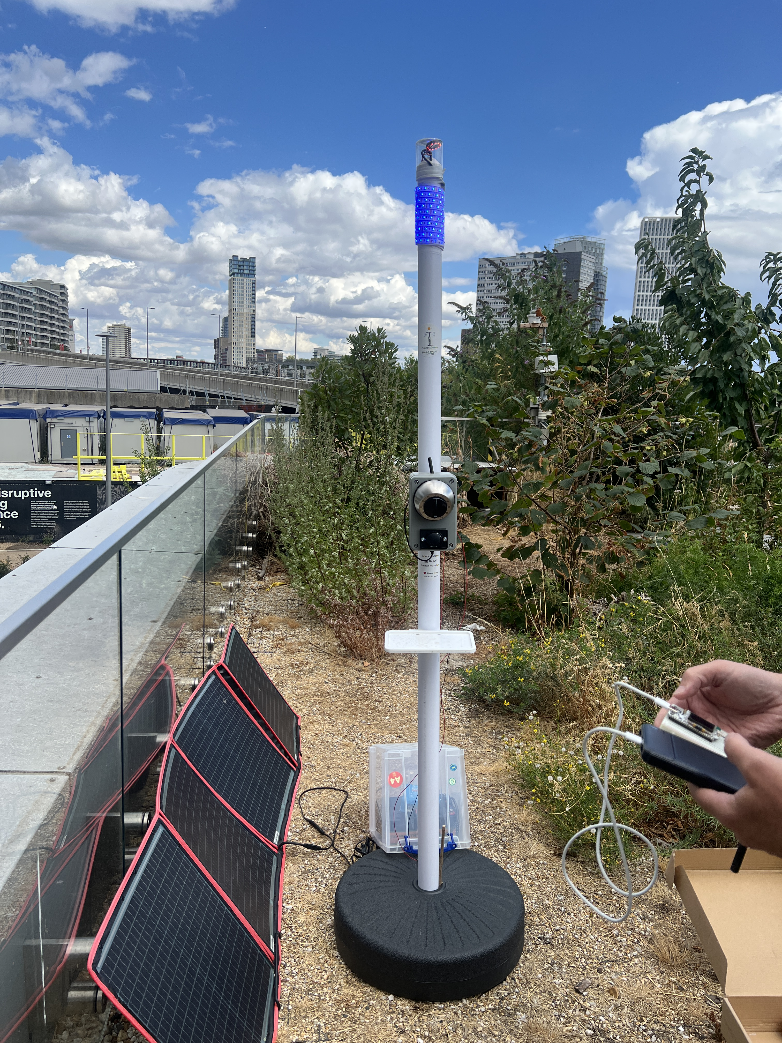
Final Prototype and Exhibition/IMG_8874.jpeg
