Madina1219/ConnectGuinea/Final Prototype and Exhibition/IMG_8876.jpeg

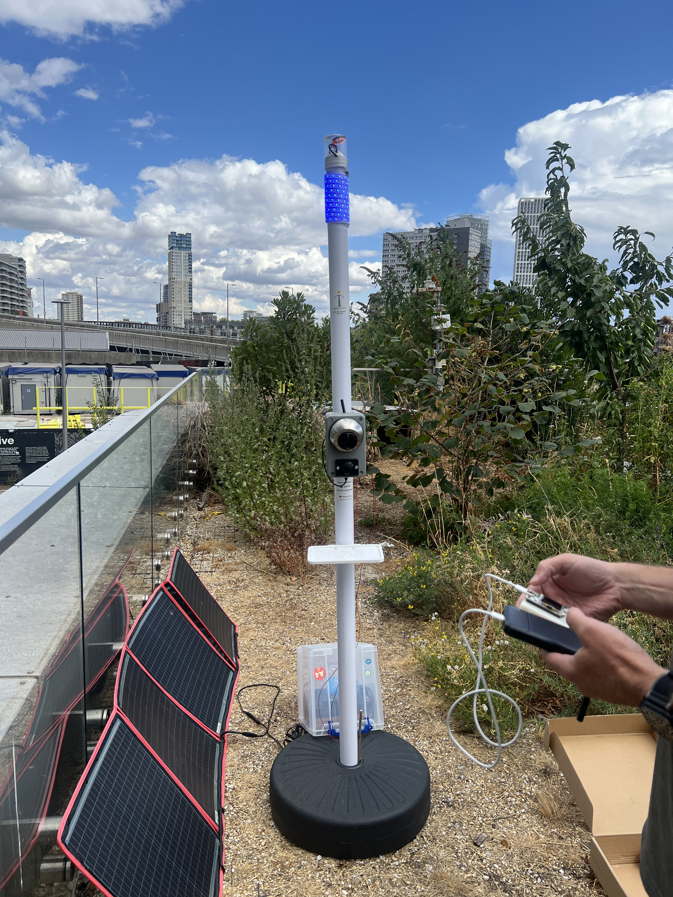
Final Prototype and Exhibition/IMG_8876.jpeg
