Madina1219/ConnectGuinea/Final Prototype and Exhibition/IMG_8891.jpeg

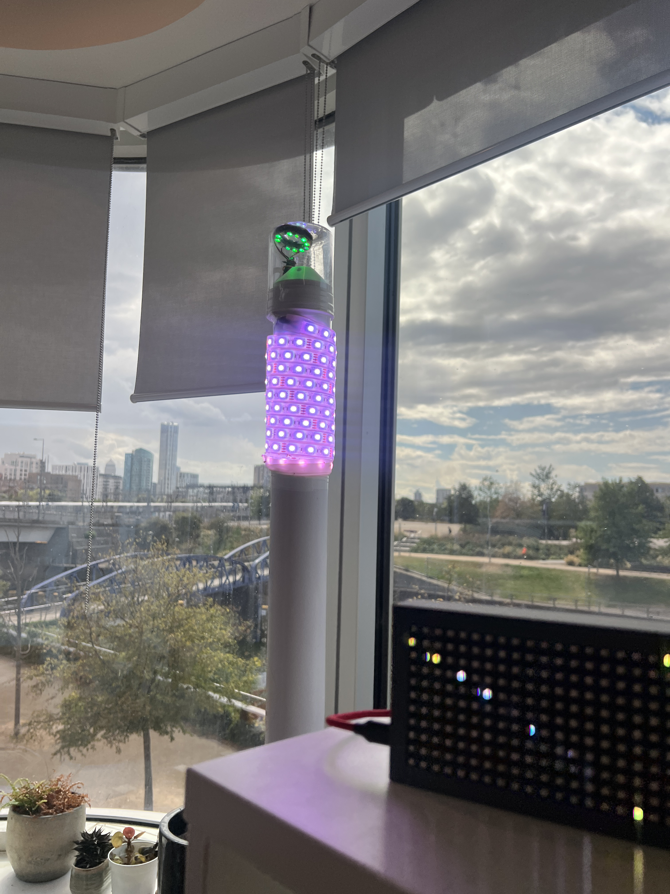
Final Prototype and Exhibition/IMG_8891.jpeg
