Madina1219/ConnectGuinea/Building Phases/IMG_7932.jpeg

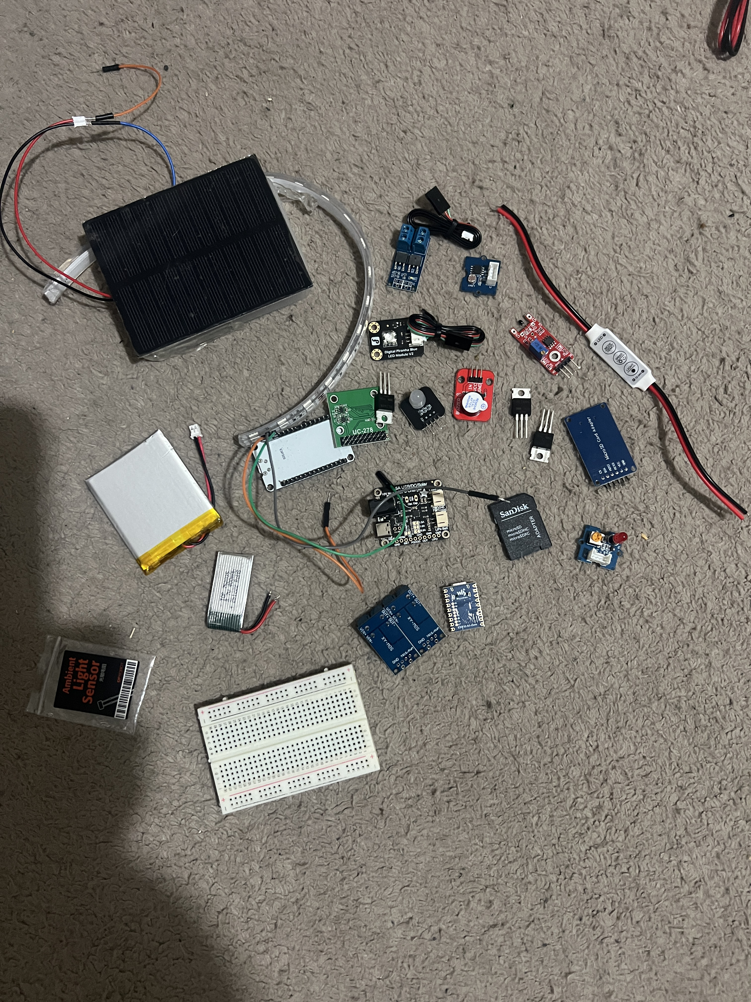
Building Phases/IMG_7932.jpeg
