Madina1219/ConnectGuinea/Building Phases/IMG_7944.jpeg

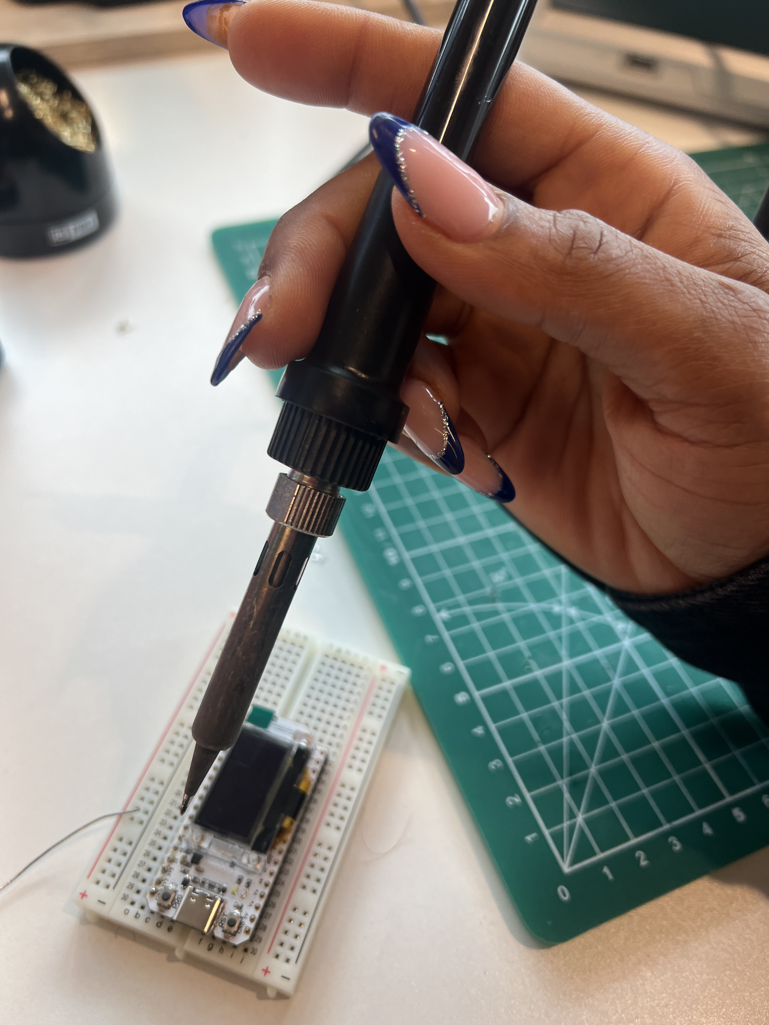
Building Phases/IMG_7944.jpeg
