Madina1219/ConnectGuinea/Building Phases/IMG_7946.jpeg

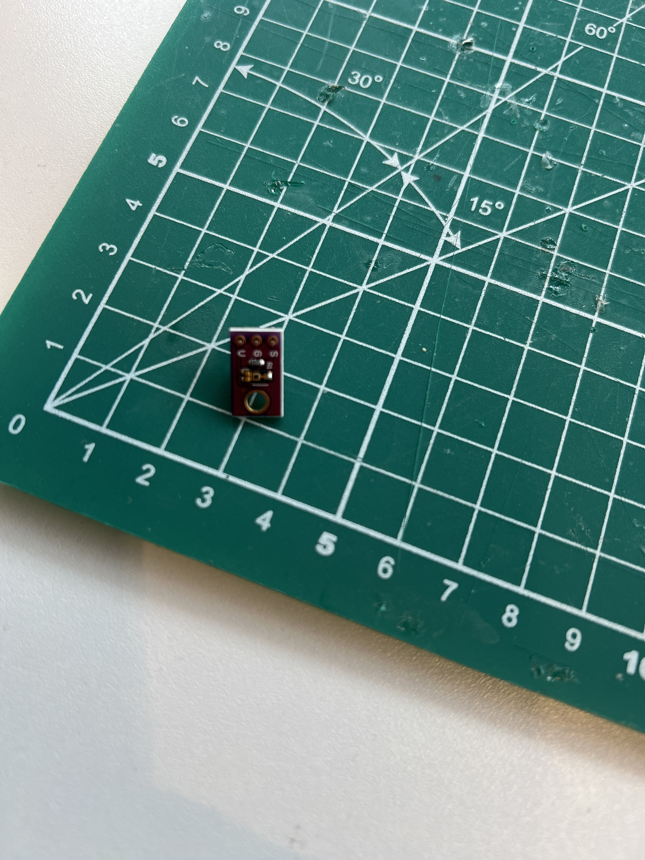
Building Phases/IMG_7946.jpeg
