Madina1219/ConnectGuinea/Building Phases/IMG_7953.jpeg

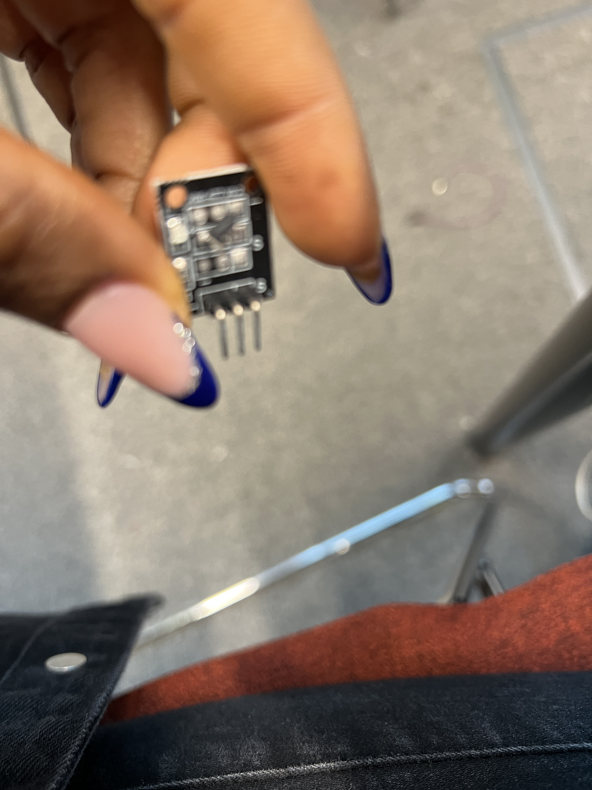
Building Phases/IMG_7953.jpeg
