Madina1219/ConnectGuinea/Building Phases/IMG_7956.jpeg

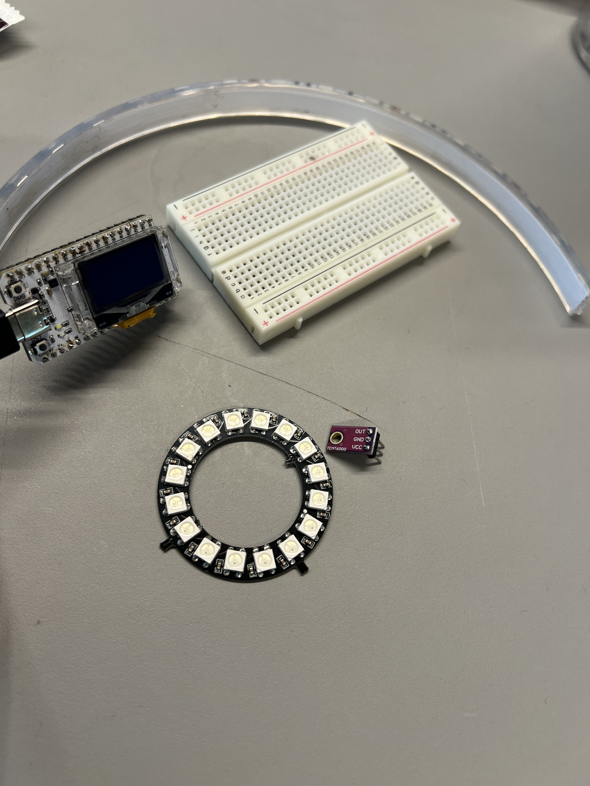
Building Phases/IMG_7956.jpeg
