Madina1219/ConnectGuinea/Building Phases/IMG_7957.jpeg

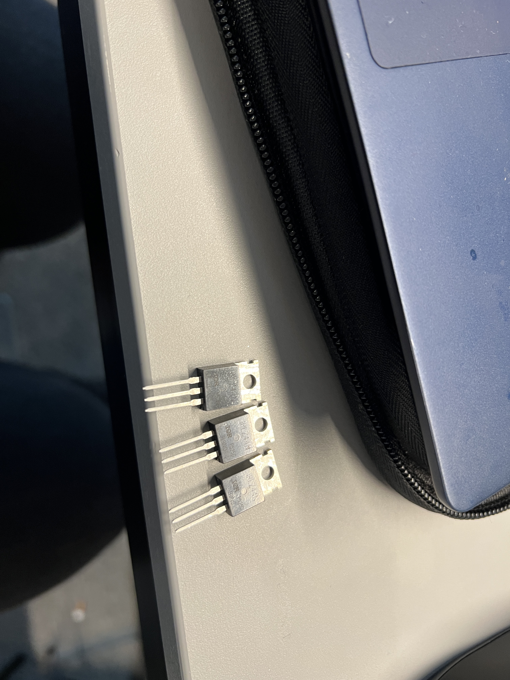
Building Phases/IMG_7957.jpeg
