Madina1219/ConnectGuinea/Building Phases/IMG_7962.jpeg

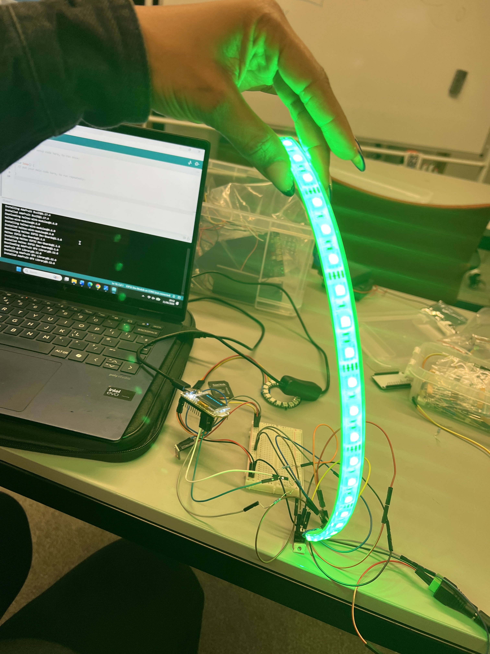
Building Phases/IMG_7962.jpeg
