Madina1219/ConnectGuinea/Building Phases/IMG_7981.jpeg

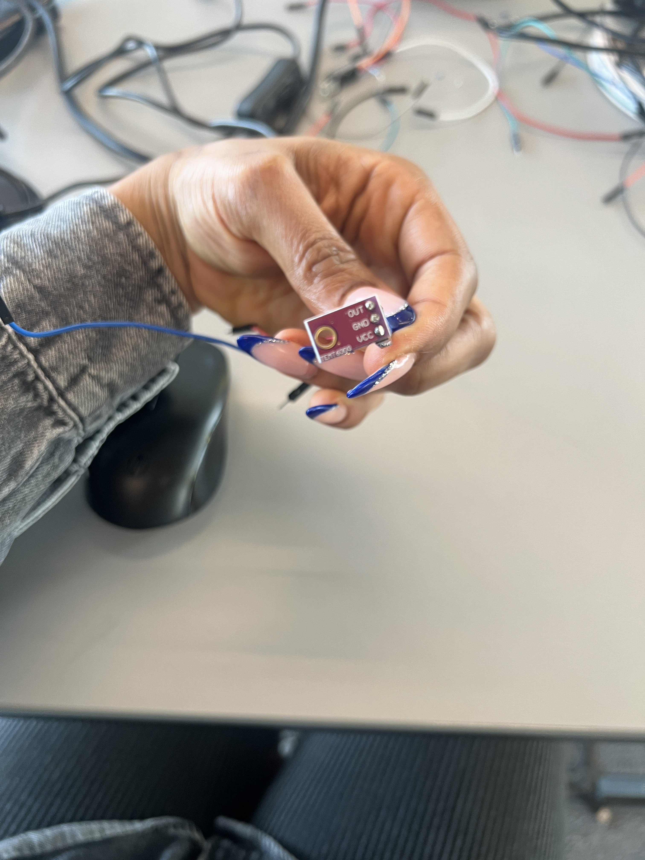
Building Phases/IMG_7981.jpeg
