Madina1219/ConnectGuinea/Building Phases/IMG_7982.jpeg

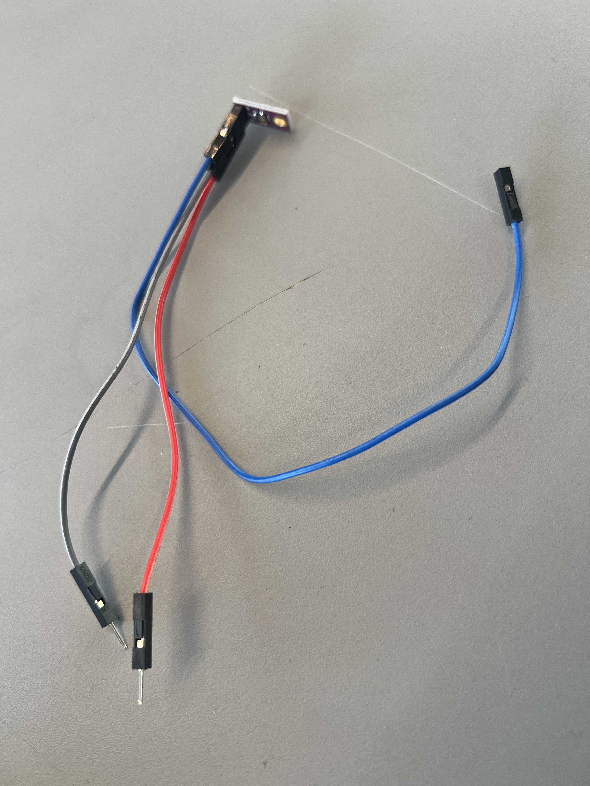
Building Phases/IMG_7982.jpeg
