Madina1219/ConnectGuinea/Building Phases/IMG_8070.jpeg

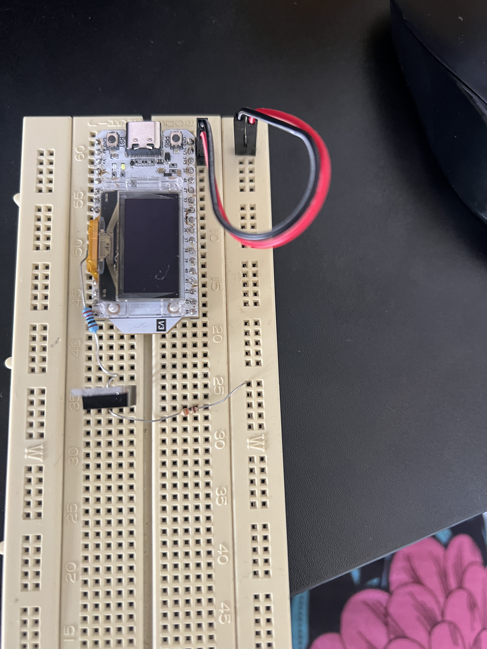
Building Phases/IMG_8070.jpeg
