Madina1219/ConnectGuinea/Building Phases/IMG_8071.jpeg

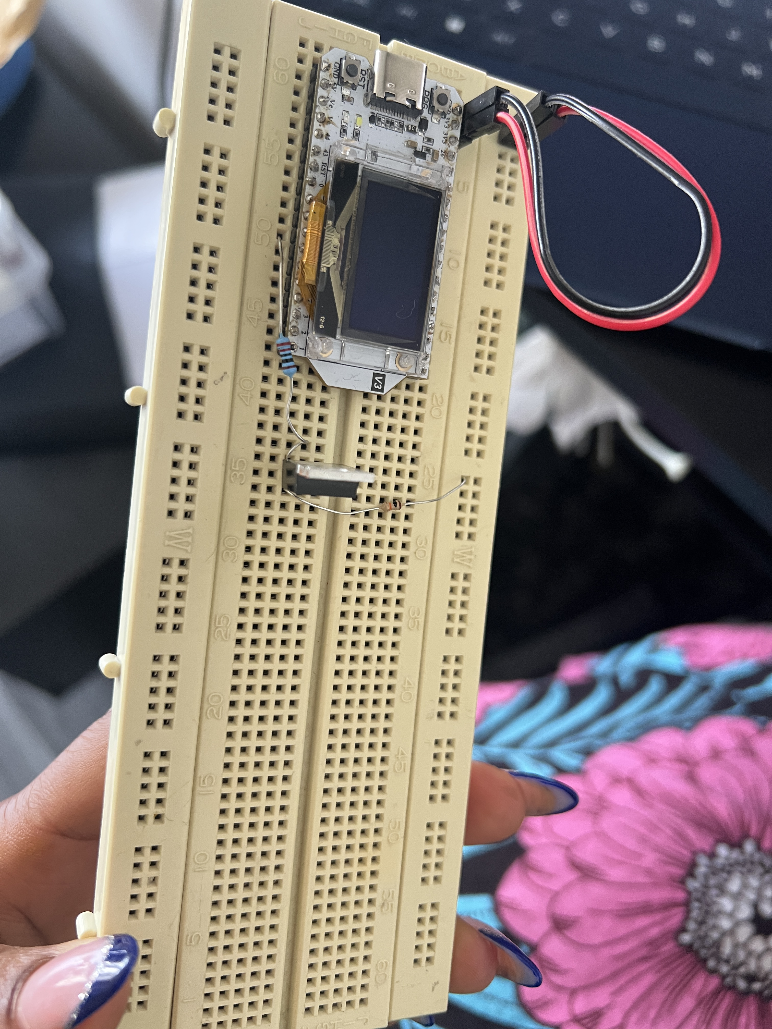
Building Phases/IMG_8071.jpeg
