Madina1219/ConnectGuinea/Building Phases/IMG_8072.jpeg

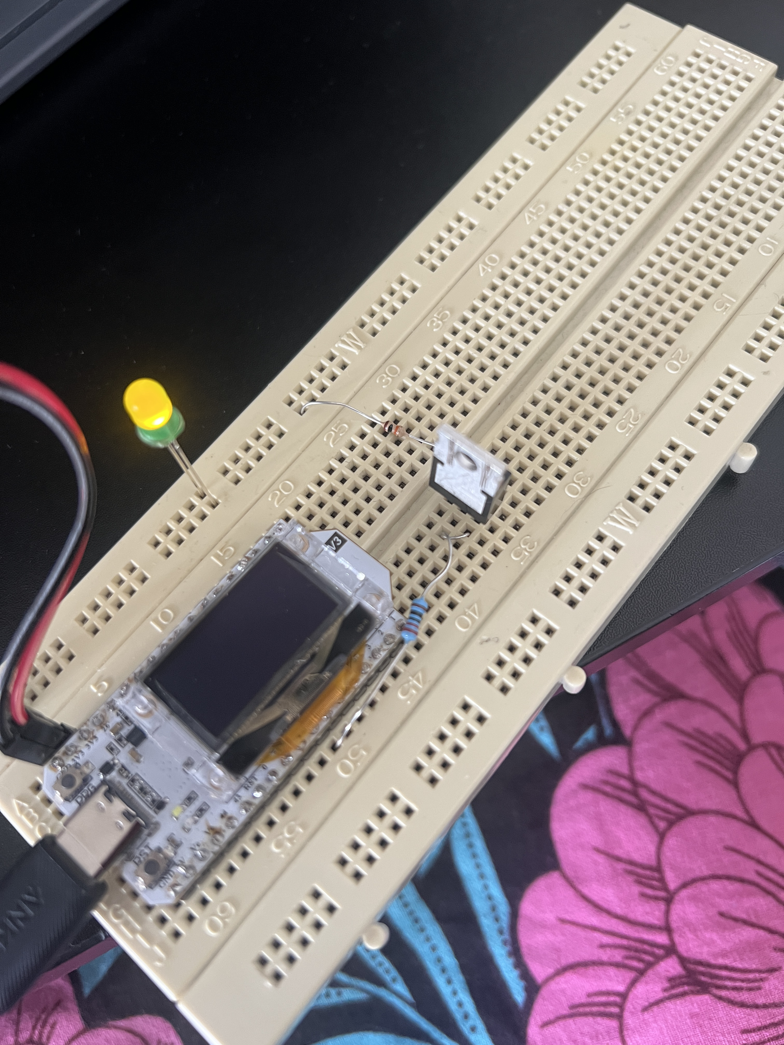
Building Phases/IMG_8072.jpeg
