Madina1219/ConnectGuinea/Building Phases/IMG_8073.jpeg

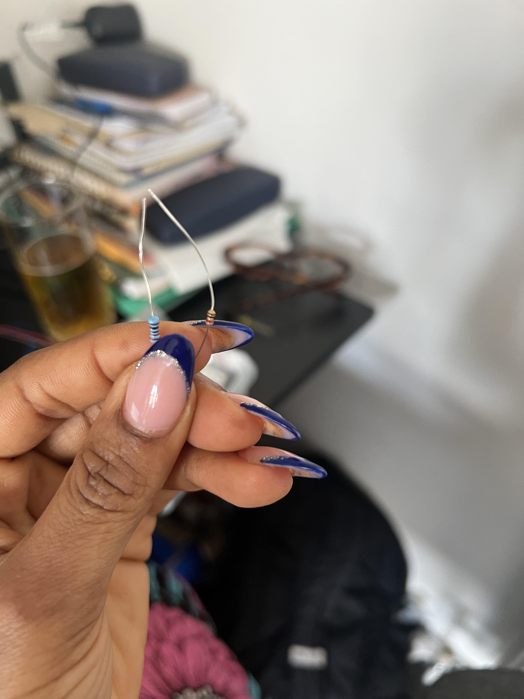
Building Phases/IMG_8073.jpeg
