Madina1219/ConnectGuinea/Building Phases/IMG_8075.jpeg

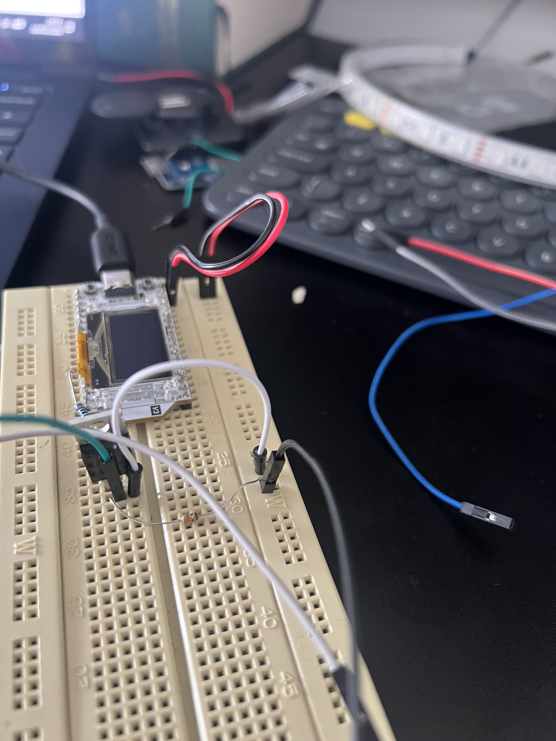
Building Phases/IMG_8075.jpeg
