Madina1219/ConnectGuinea/Building Phases/IMG_8082.jpeg

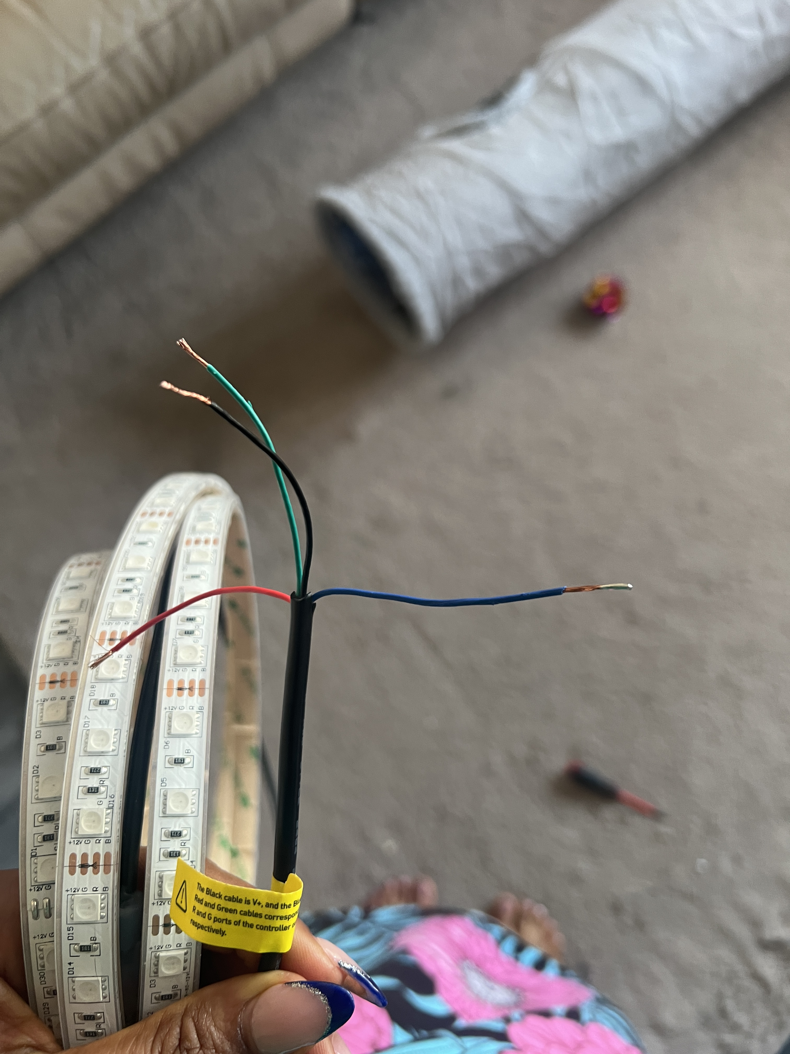
Building Phases/IMG_8082.jpeg
