Madina1219/ConnectGuinea/Building Phases/IMG_8105.jpeg

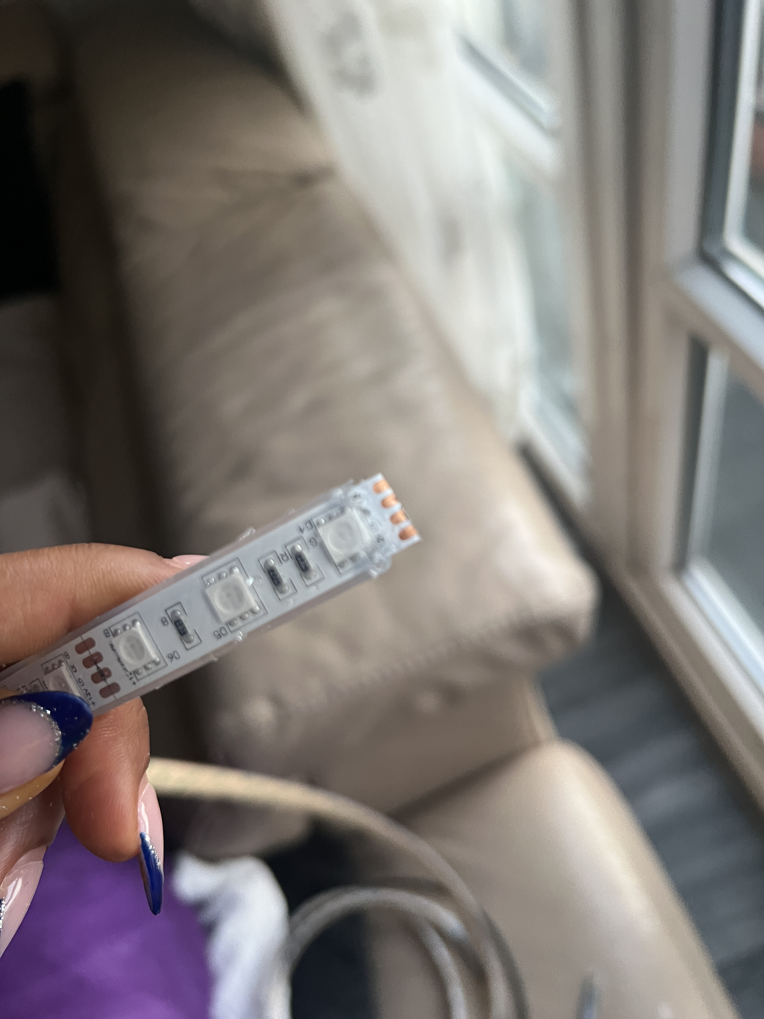
Building Phases/IMG_8105.jpeg
