Madina1219/ConnectGuinea/Building Phases/IMG_8106.jpeg

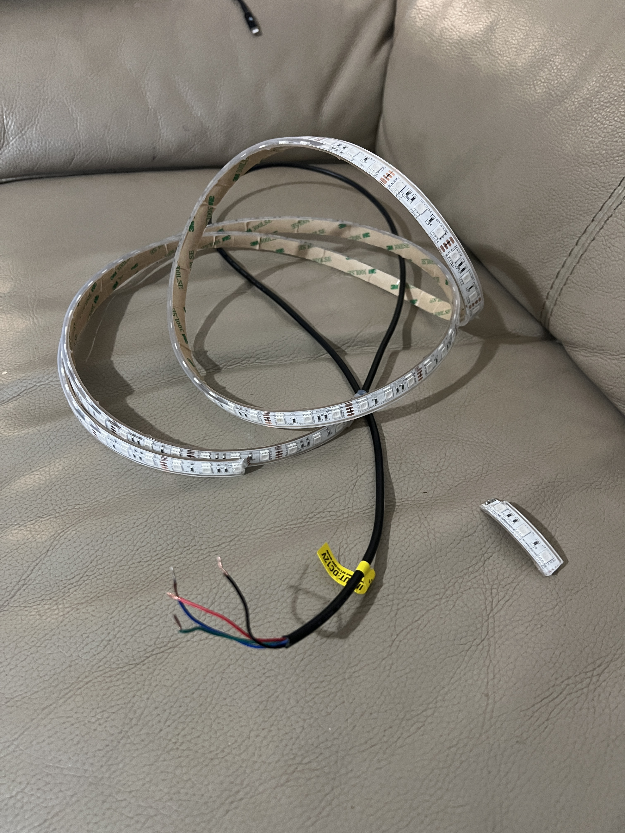
Building Phases/IMG_8106.jpeg
