Madina1219/ConnectGuinea/Building Phases/IMG_8107.jpeg

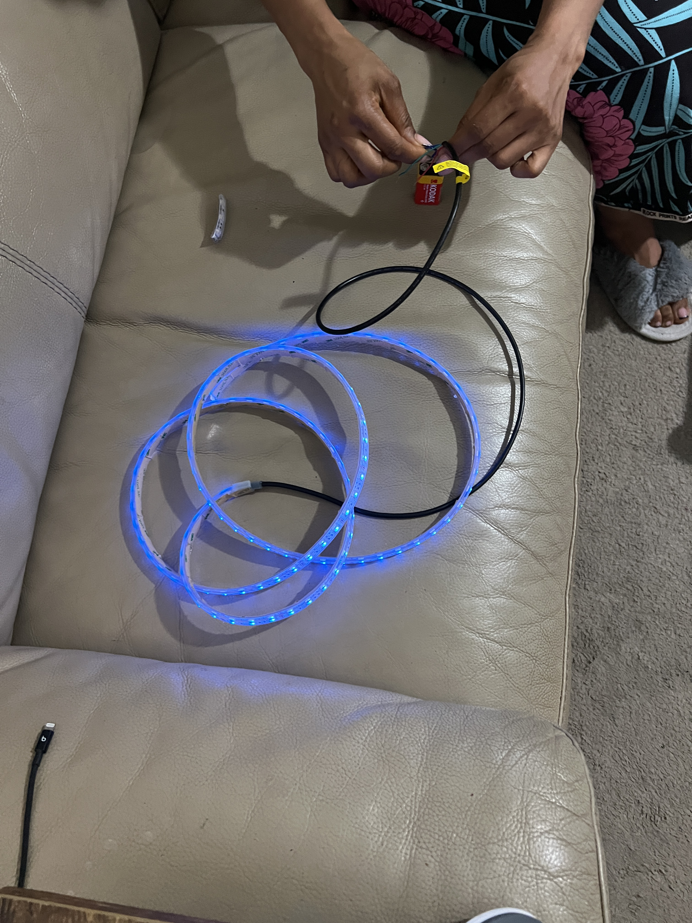
Building Phases/IMG_8107.jpeg
