Madina1219/ConnectGuinea/Building Phases/IMG_8108.jpeg

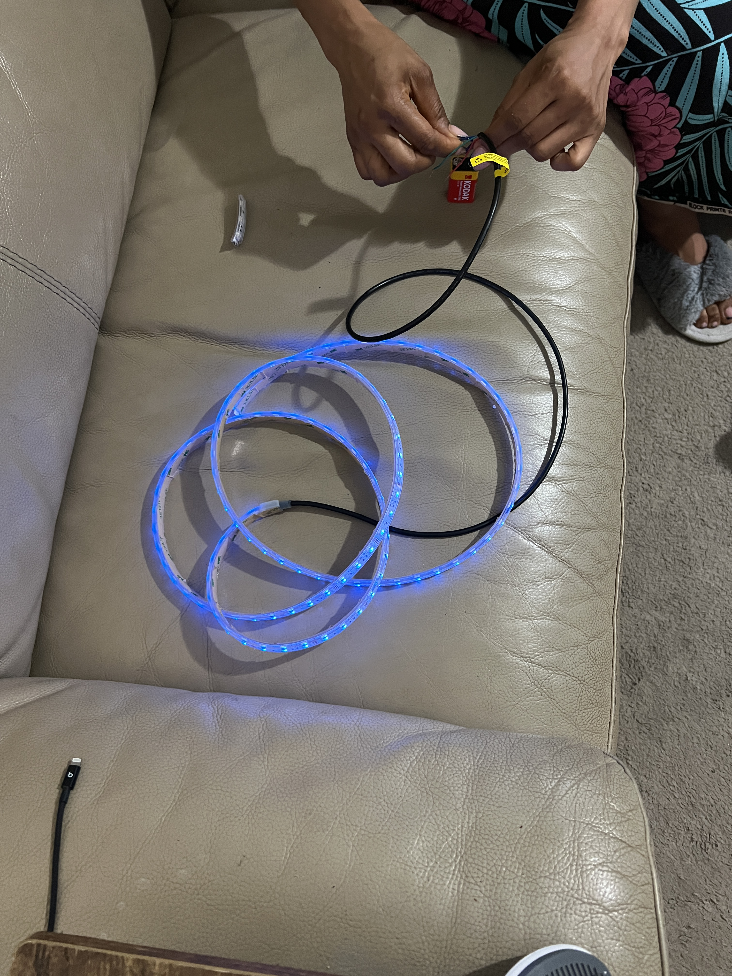
Building Phases/IMG_8108.jpeg
