Madina1219/ConnectGuinea/Building Phases/IMG_8110.jpeg

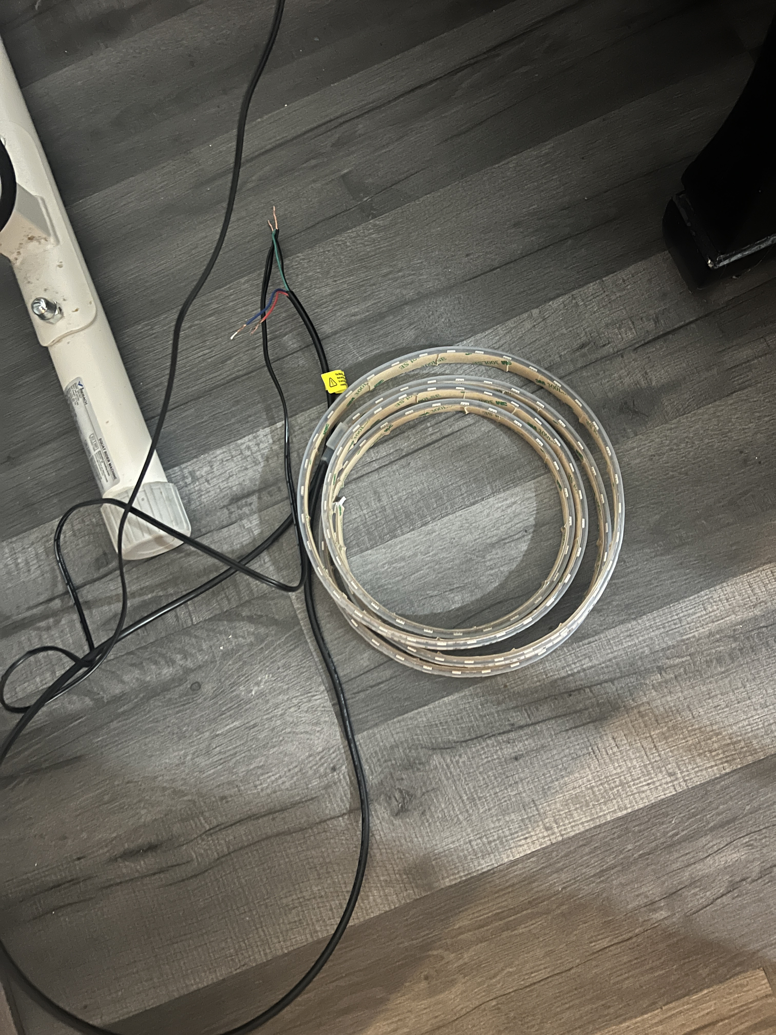
Building Phases/IMG_8110.jpeg
