Madina1219/ConnectGuinea/Building Phases/IMG_8111.jpeg

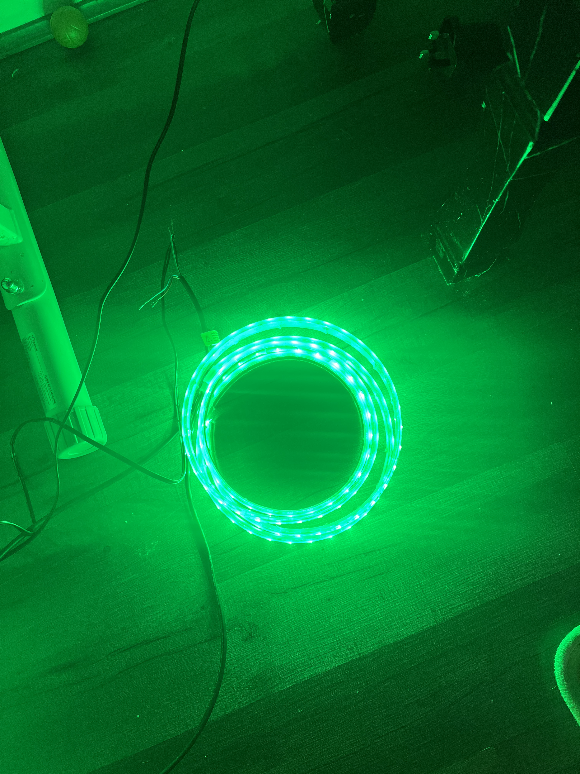
Building Phases/IMG_8111.jpeg
