Madina1219/ConnectGuinea/Building Phases/IMG_8138.jpeg

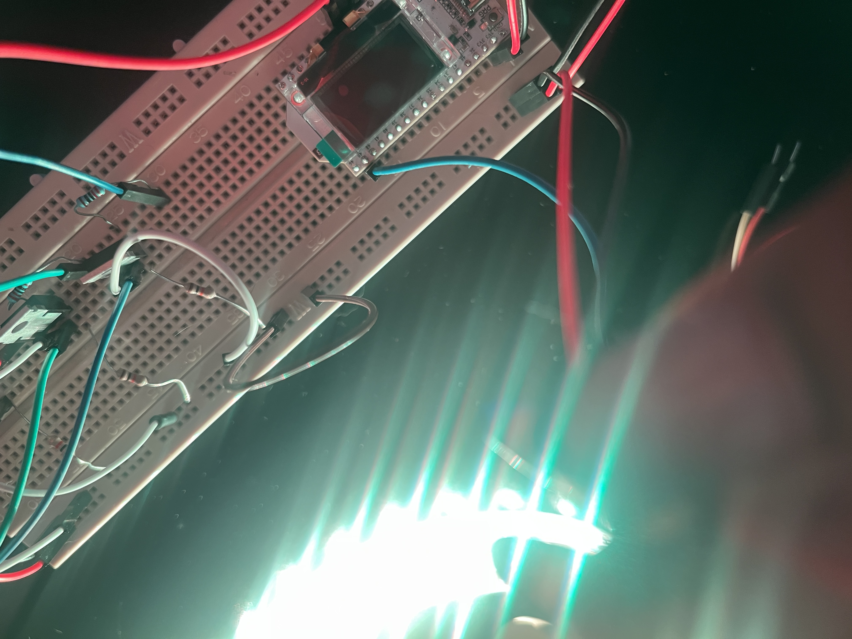
Building Phases/IMG_8138.jpeg
