Madina1219/ConnectGuinea/Building Phases/IMG_8139.jpeg

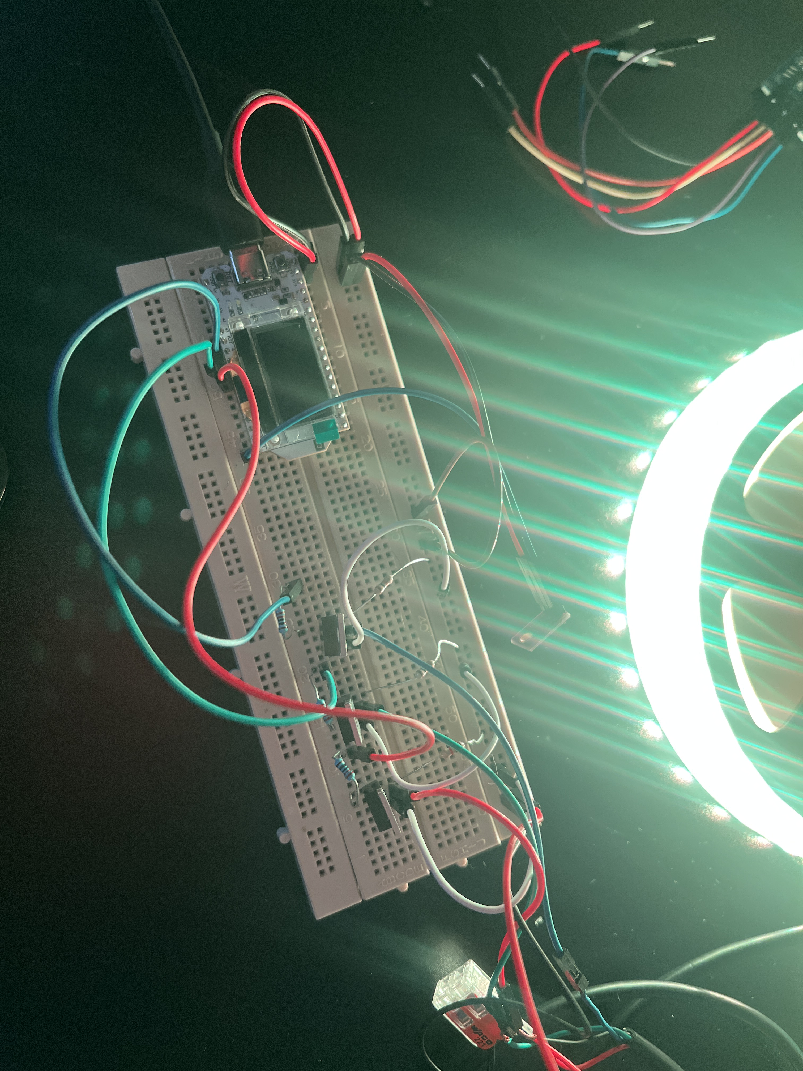
Building Phases/IMG_8139.jpeg
