Madina1219/ConnectGuinea/Building Phases/IMG_8158.jpeg

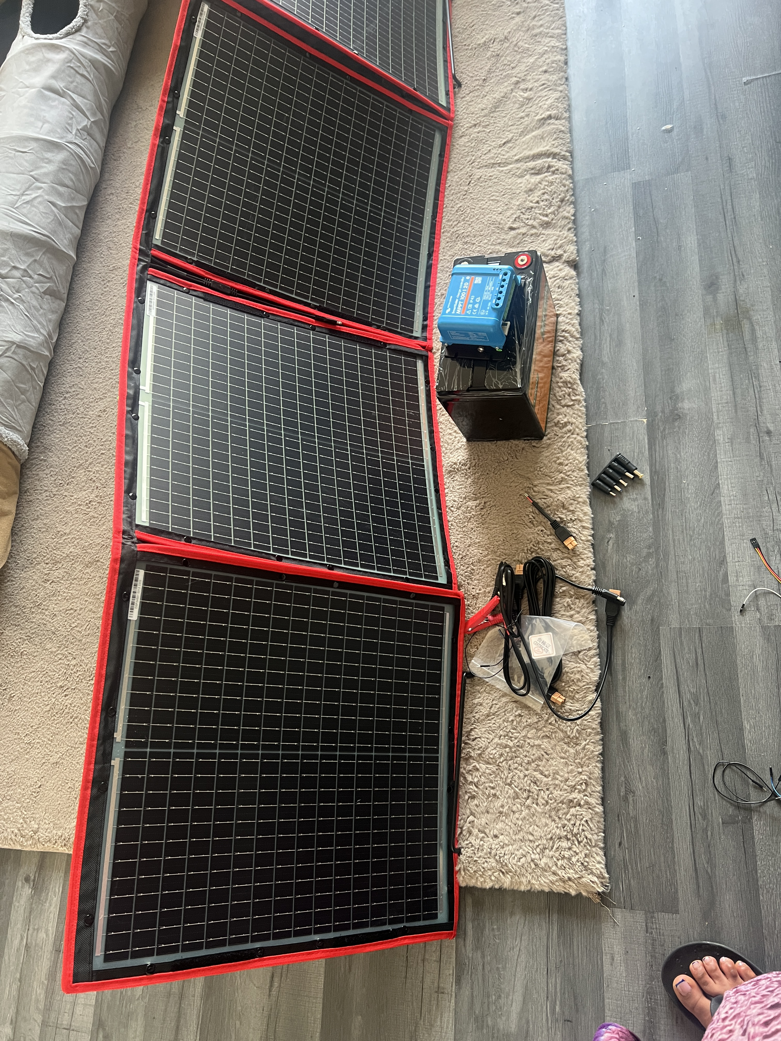
Building Phases/IMG_8158.jpeg
