Madina1219/ConnectGuinea/Building Phases/IMG_8255.jpeg

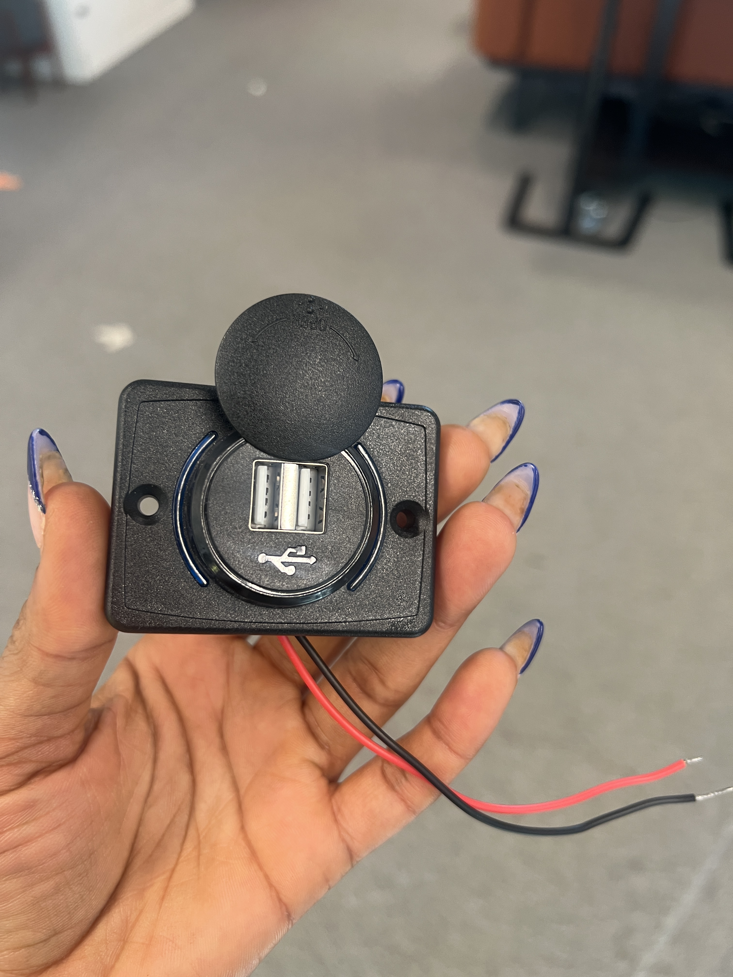
Building Phases/IMG_8255.jpeg
