Madina1219/ConnectGuinea/Building Phases/IMG_8256.jpeg

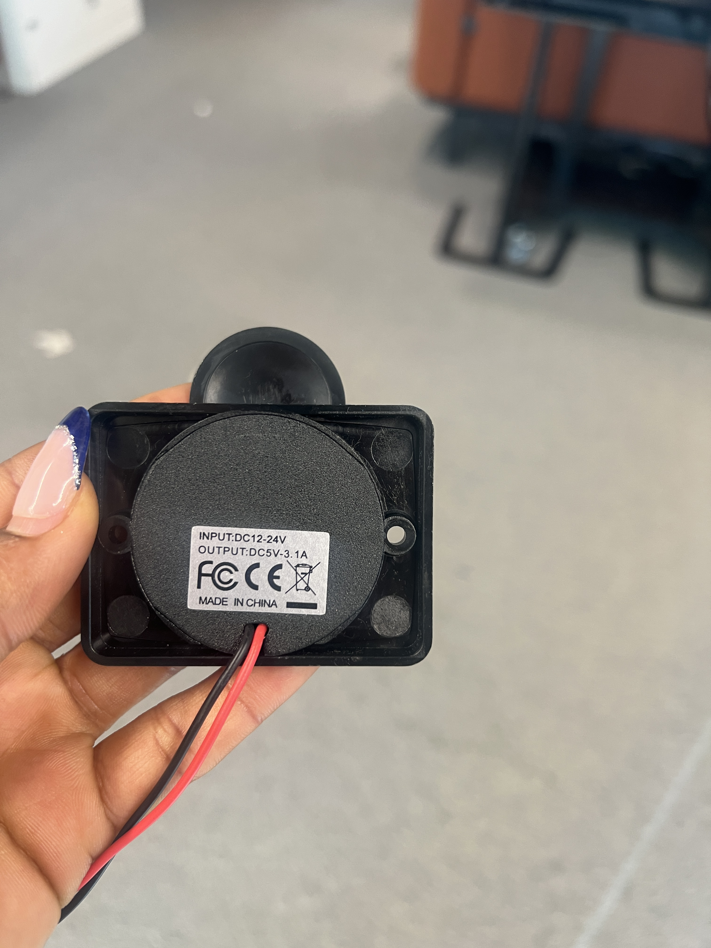
Building Phases/IMG_8256.jpeg
