Madina1219/ConnectGuinea/Building Phases/IMG_8258.jpeg

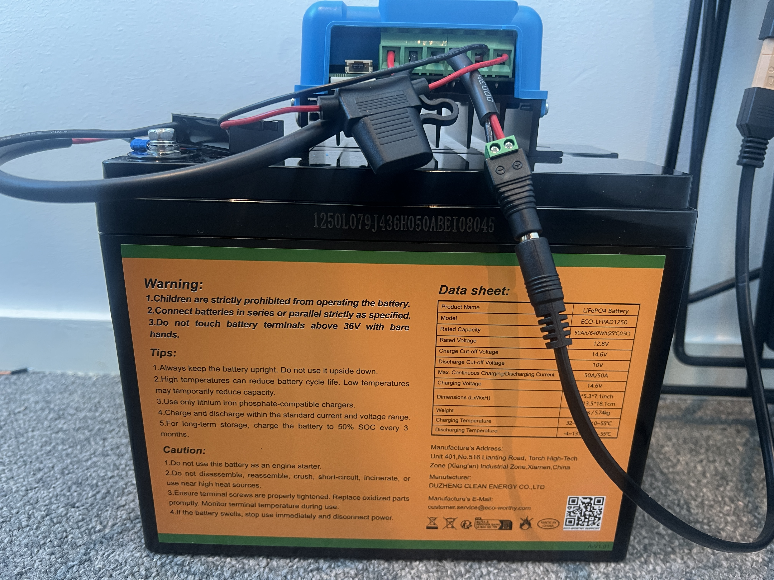
Building Phases/IMG_8258.jpeg
