Madina1219/ConnectGuinea/Building Phases/IMG_8263.jpeg

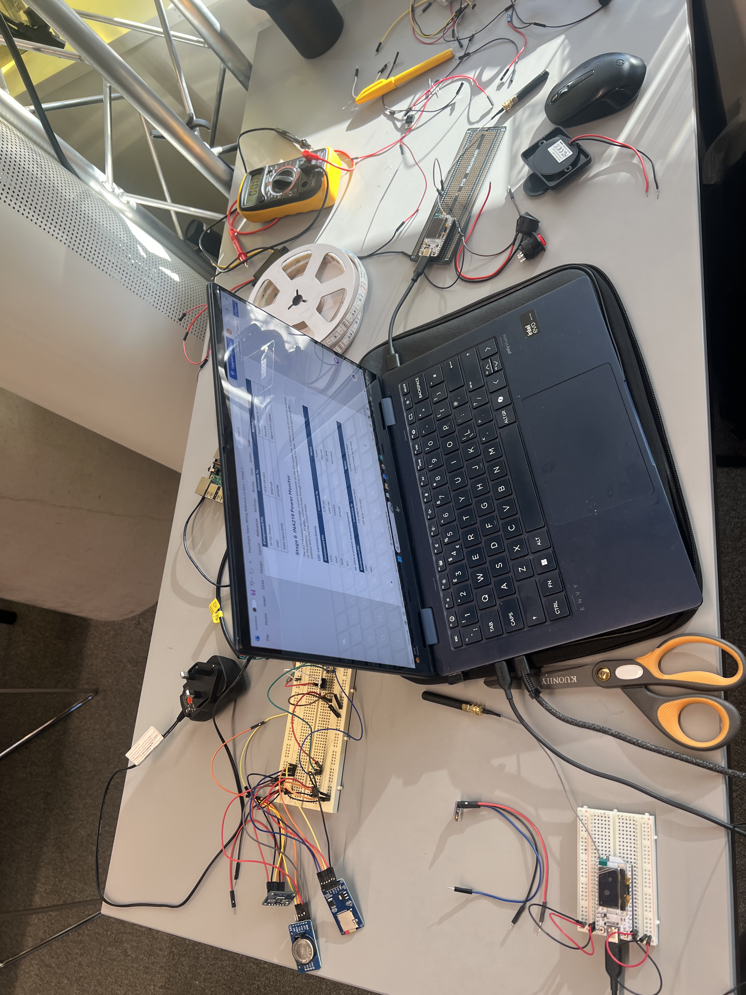
Building Phases/IMG_8263.jpeg
