Madina1219/ConnectGuinea/Building Phases/IMG_8264.jpeg

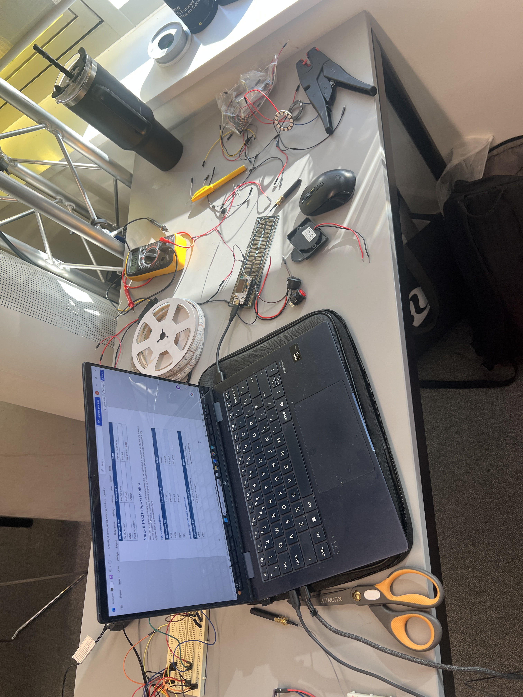
Building Phases/IMG_8264.jpeg
