Madina1219/ConnectGuinea/Building Phases/IMG_8267.jpeg

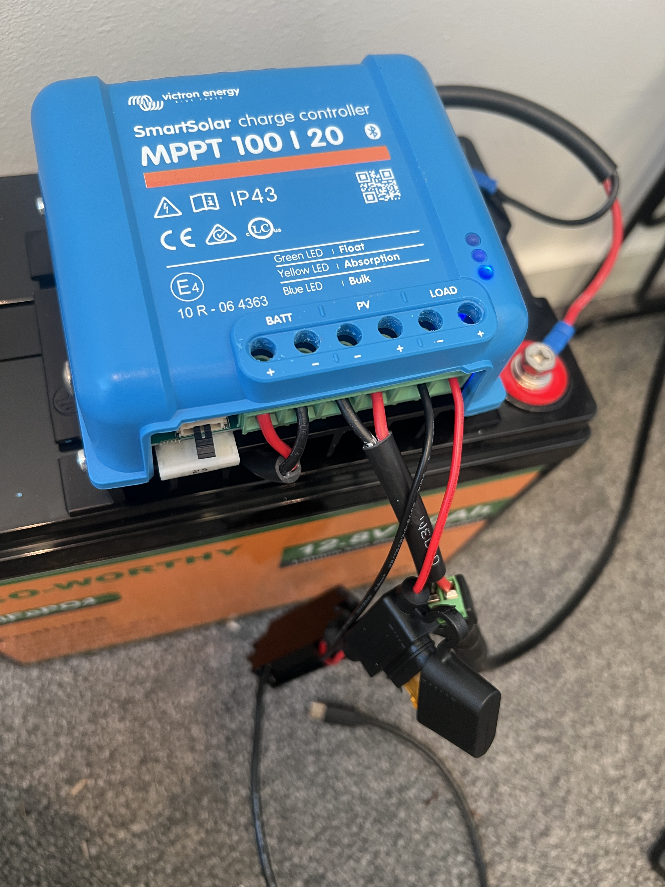
Building Phases/IMG_8267.jpeg
