Madina1219/ConnectGuinea/Building Phases/IMG_8271.jpeg

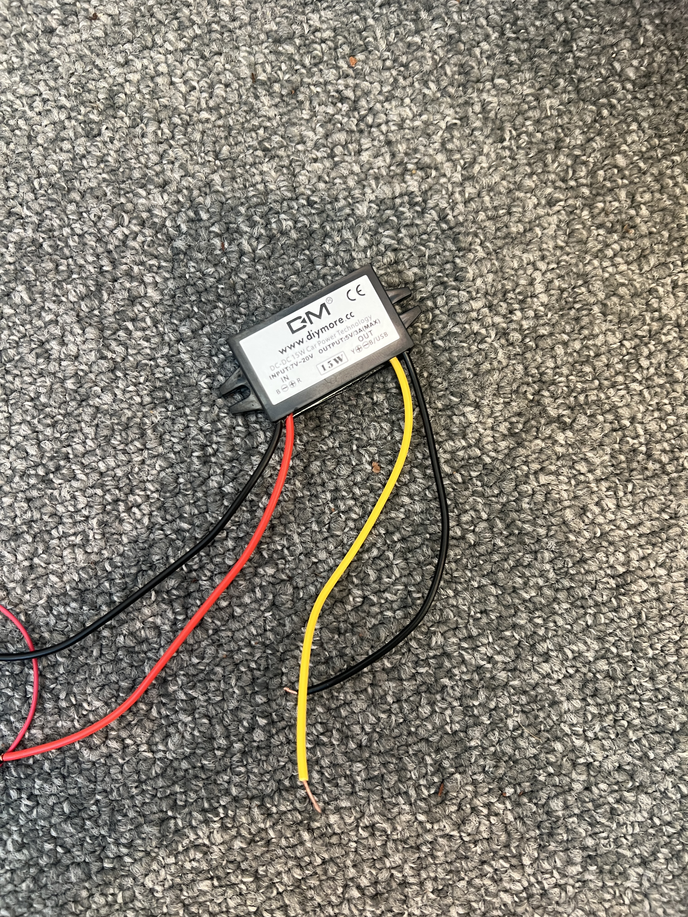
Building Phases/IMG_8271.jpeg
