Madina1219/ConnectGuinea/Building Phases/IMG_8273.jpeg

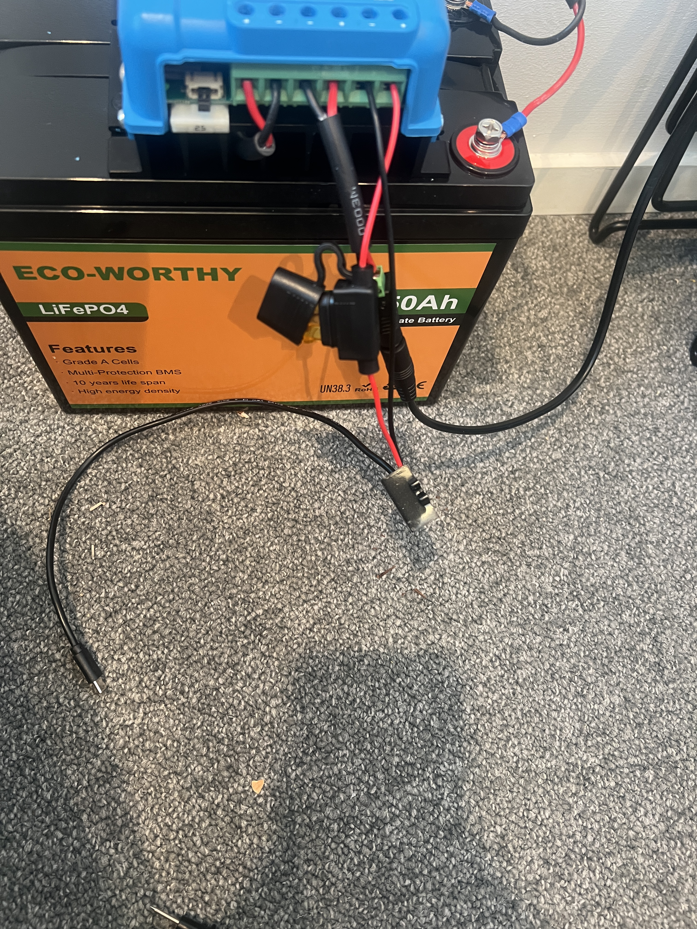
Building Phases/IMG_8273.jpeg
