Madina1219/ConnectGuinea/Building Phases/IMG_8275.jpeg

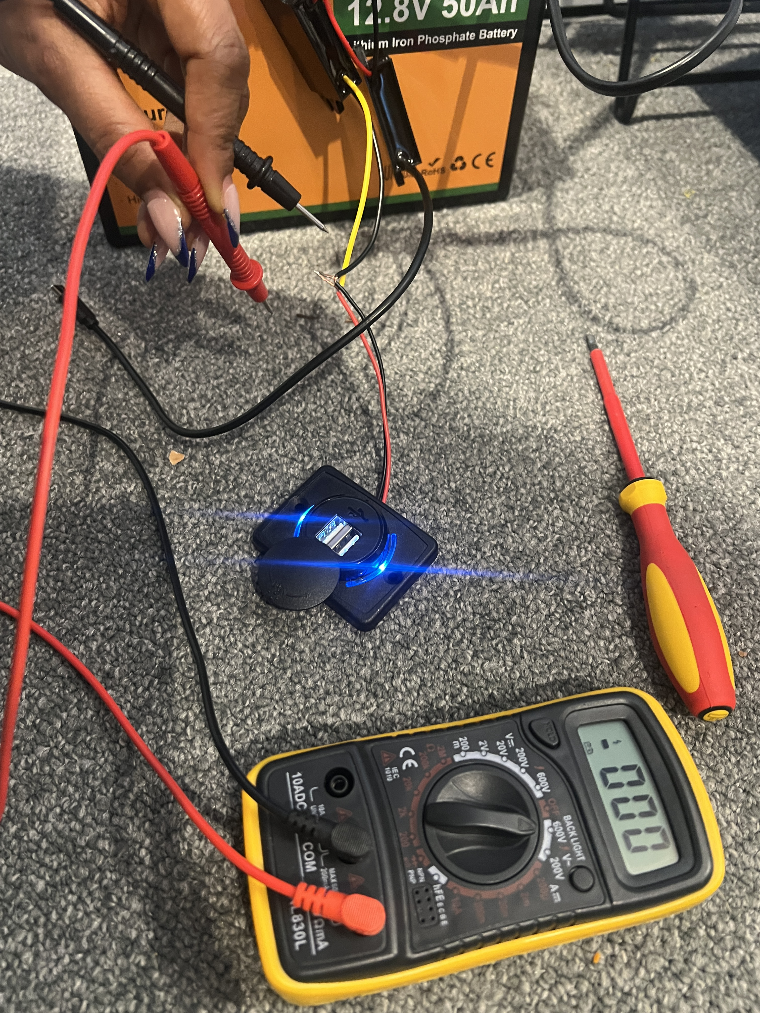
Building Phases/IMG_8275.jpeg
