Madina1219/ConnectGuinea/Building Phases/IMG_8306.jpeg

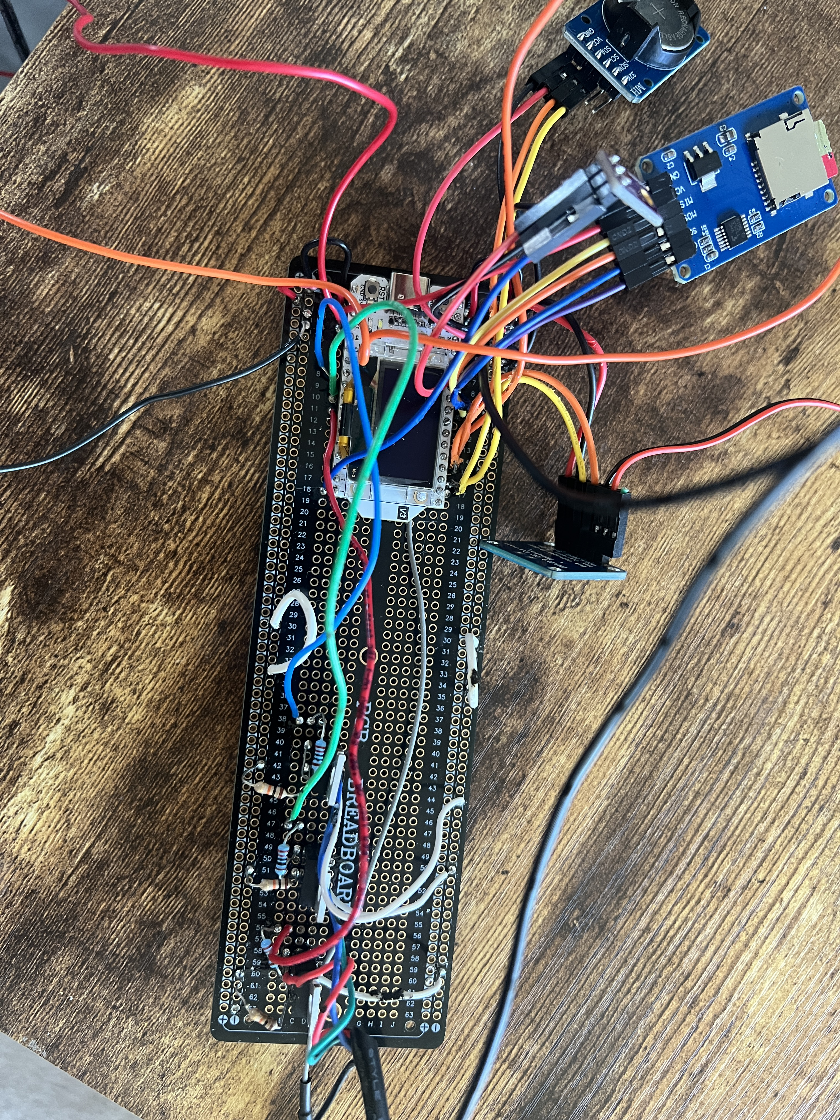
Building Phases/IMG_8306.jpeg
