Madina1219/ConnectGuinea/Building Phases/IMG_8307.jpeg

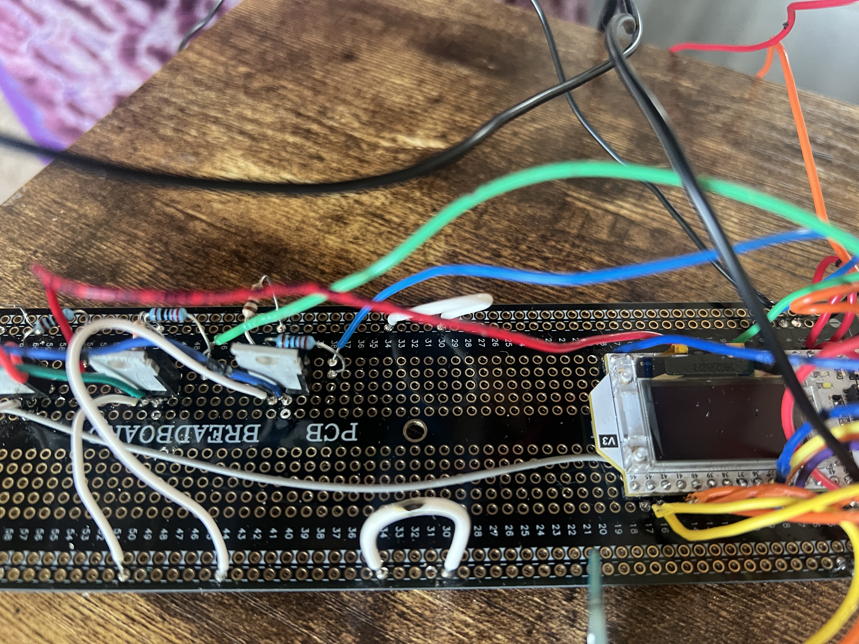
Building Phases/IMG_8307.jpeg
