Madina1219/ConnectGuinea/Building Phases/IMG_8310.jpeg

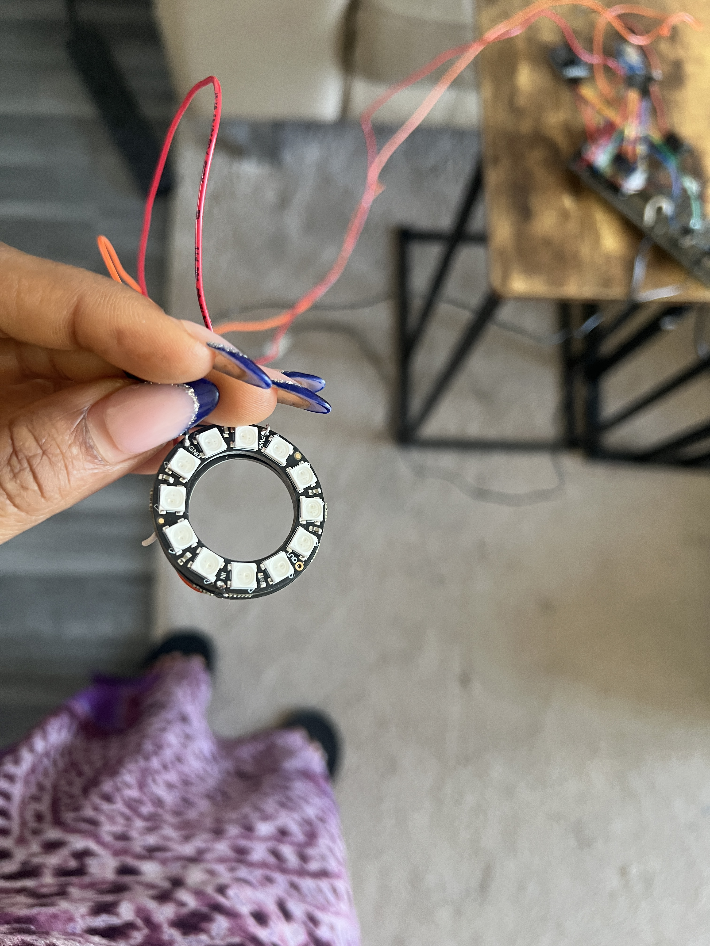
Building Phases/IMG_8310.jpeg
