Madina1219/ConnectGuinea/Building Phases/IMG_8311.jpeg

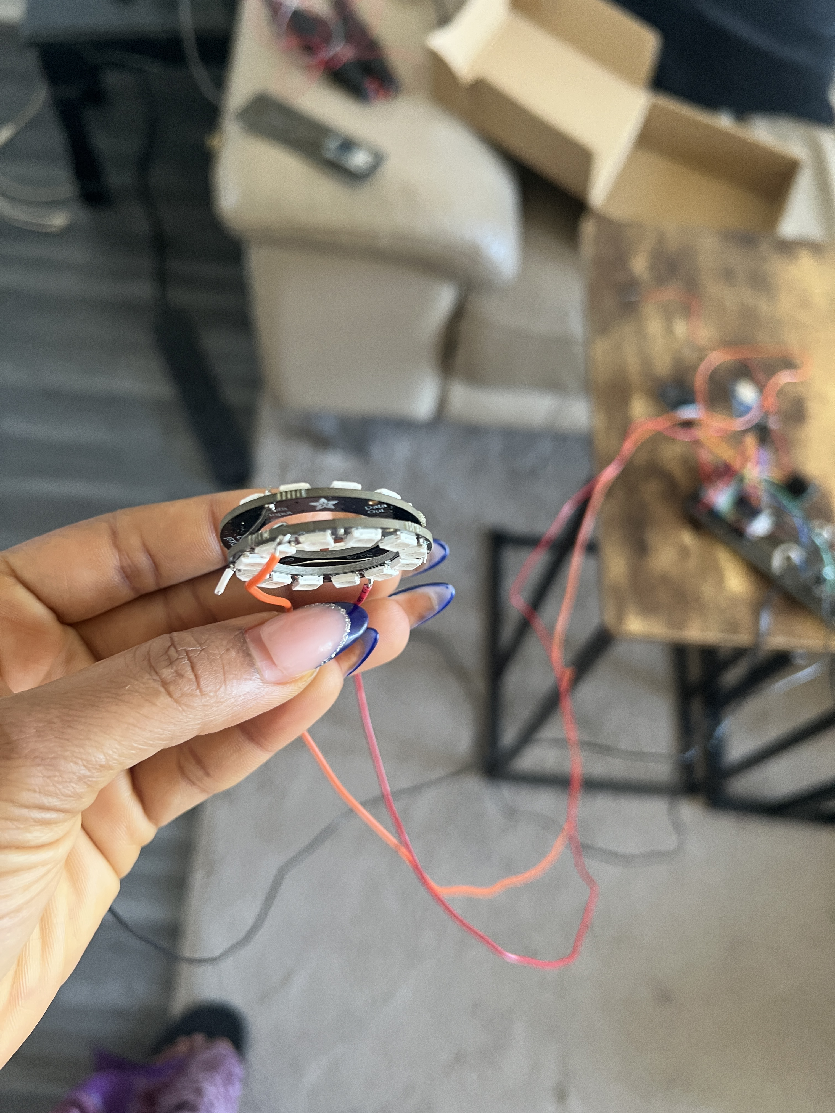
Building Phases/IMG_8311.jpeg
