Madina1219/ConnectGuinea/Building Phases/IMG_8314.jpeg

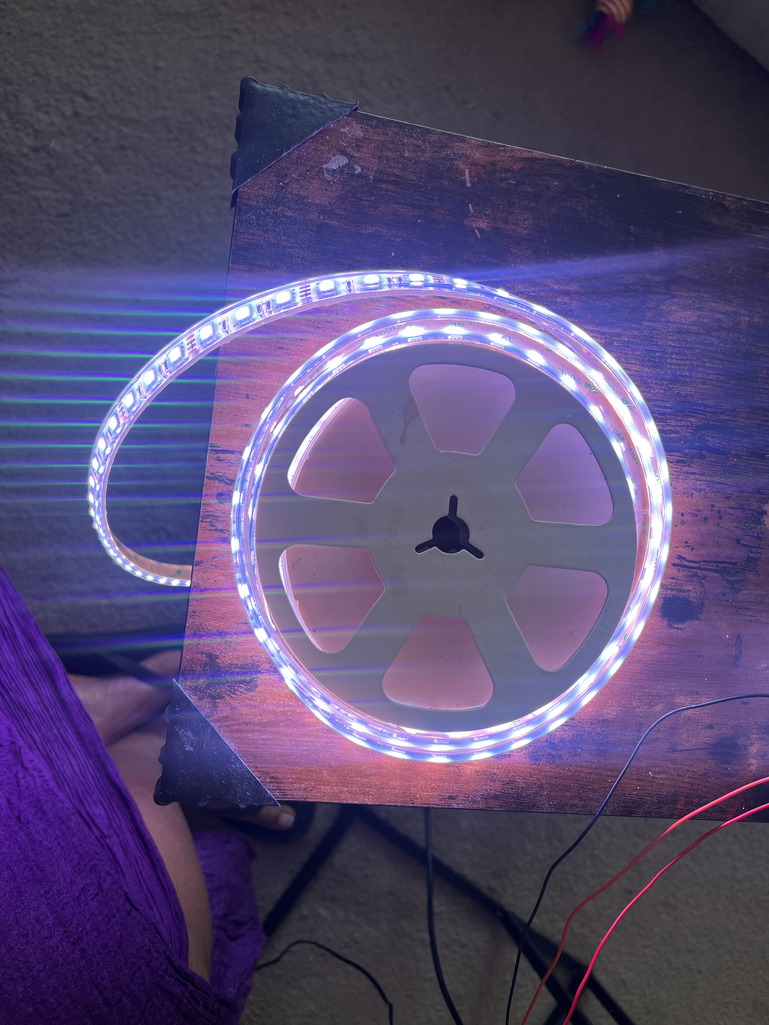
Building Phases/IMG_8314.jpeg
