Madina1219/ConnectGuinea/Building Phases/IMG_8315.jpeg

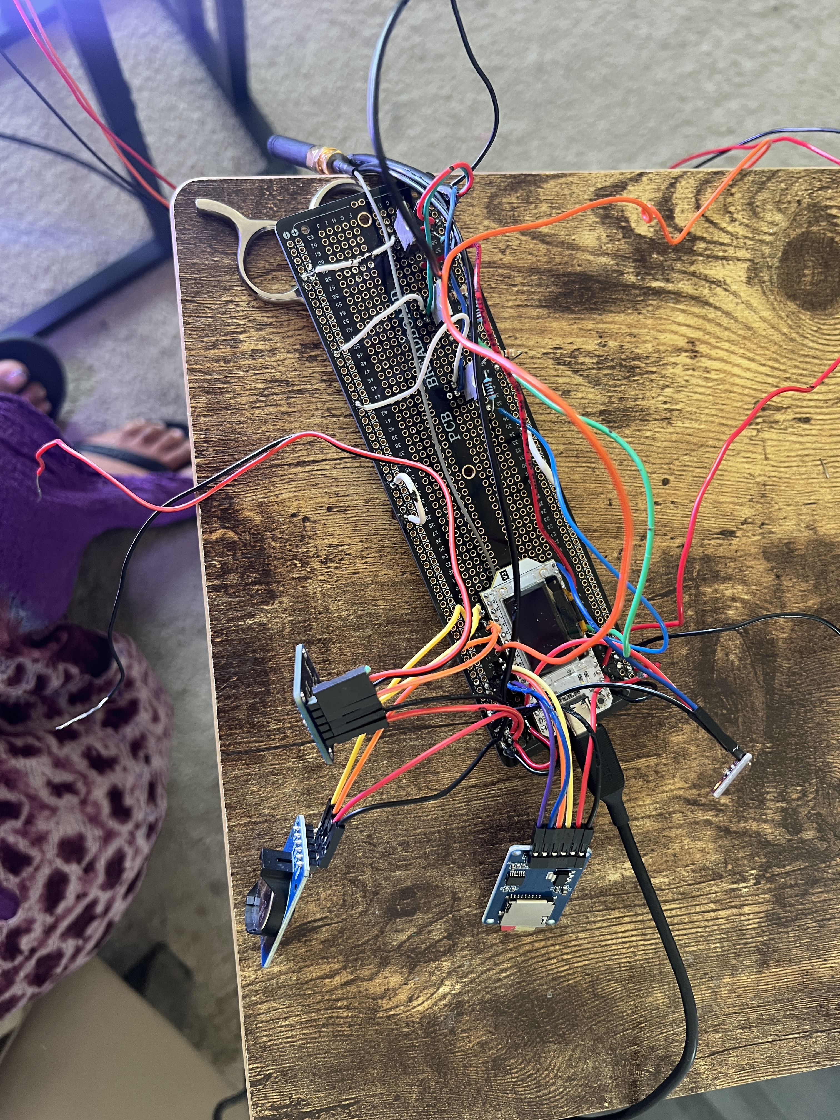
Building Phases/IMG_8315.jpeg
