Madina1219/ConnectGuinea/Building Phases/IMG_8352.jpeg

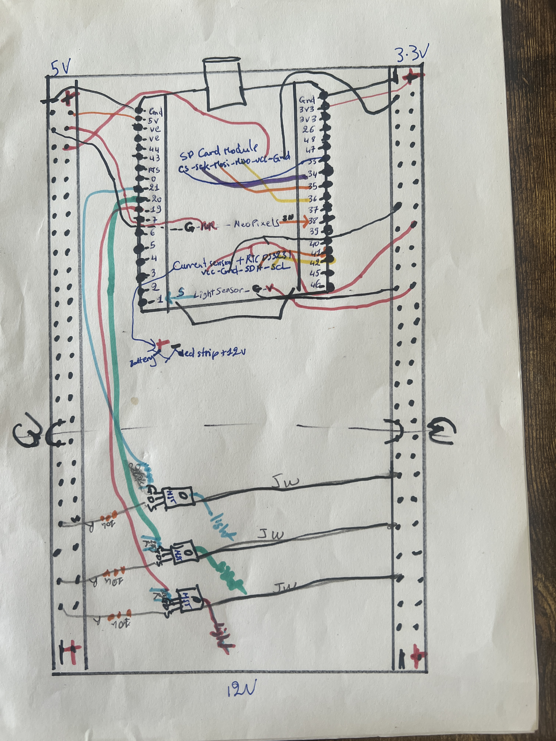
Building Phases/IMG_8352.jpeg
