Madina1219/ConnectGuinea/Building Phases/IMG_8372.jpeg

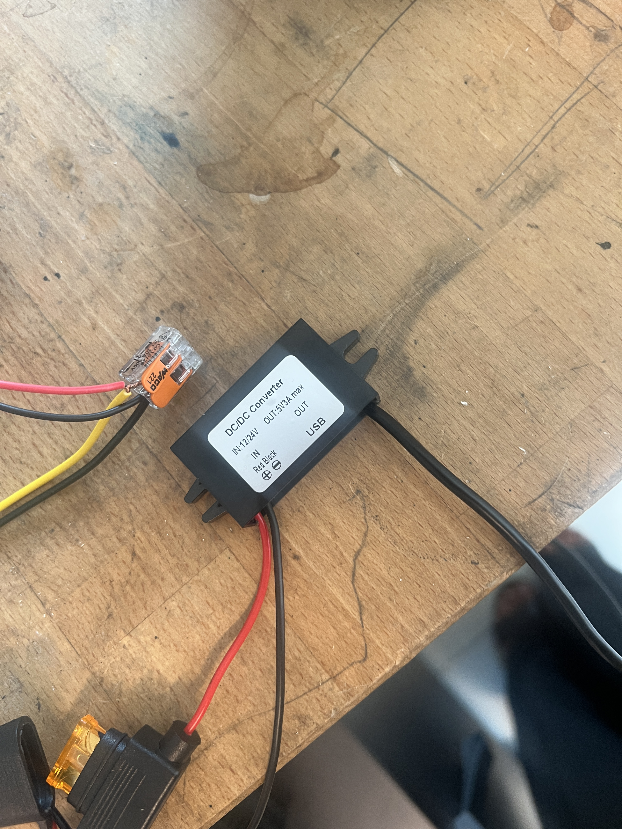
Building Phases/IMG_8372.jpeg
