Madina1219/ConnectGuinea/Building Phases/IMG_8374.jpeg

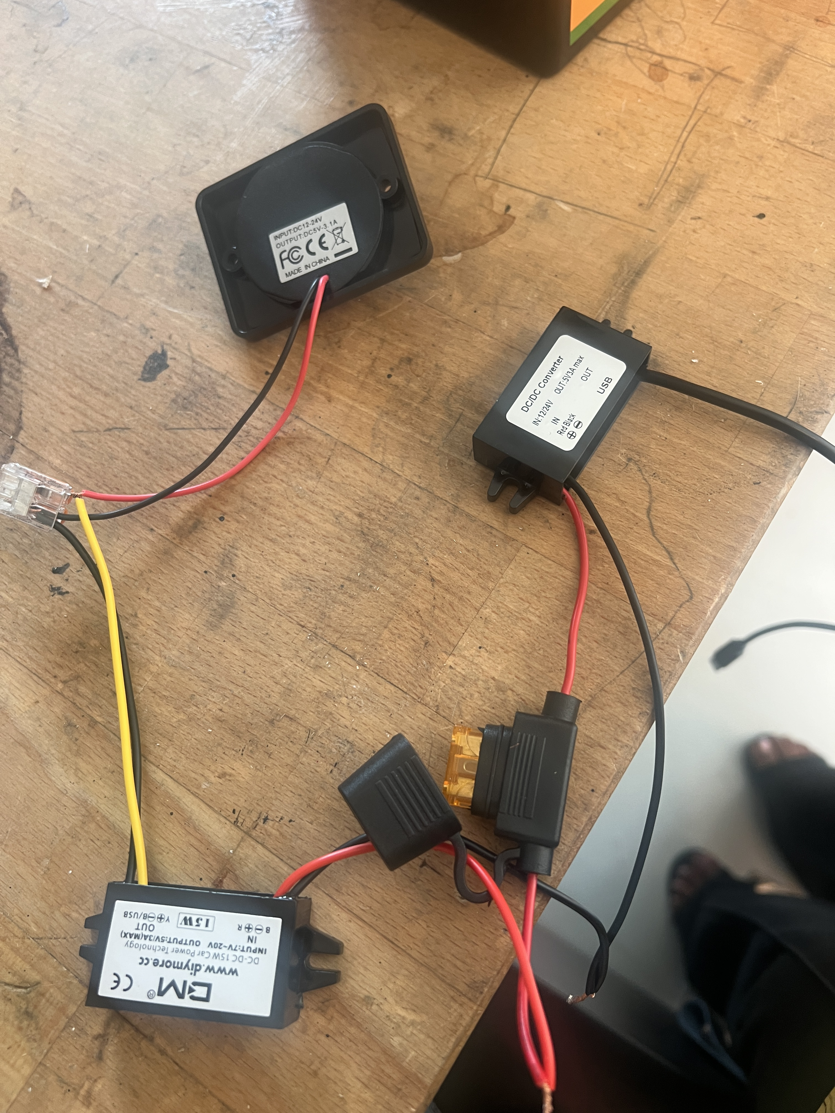
Building Phases/IMG_8374.jpeg
