Madina1219/ConnectGuinea/Building Phases/IMG_8379.jpeg

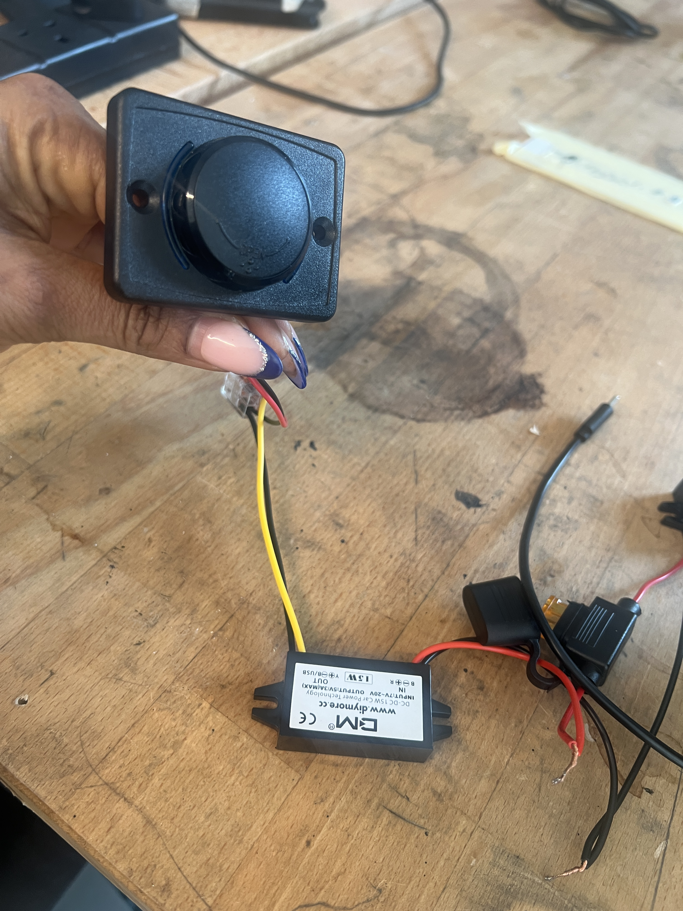
Building Phases/IMG_8379.jpeg
