Madina1219/ConnectGuinea/Building Phases/IMG_8380.jpeg

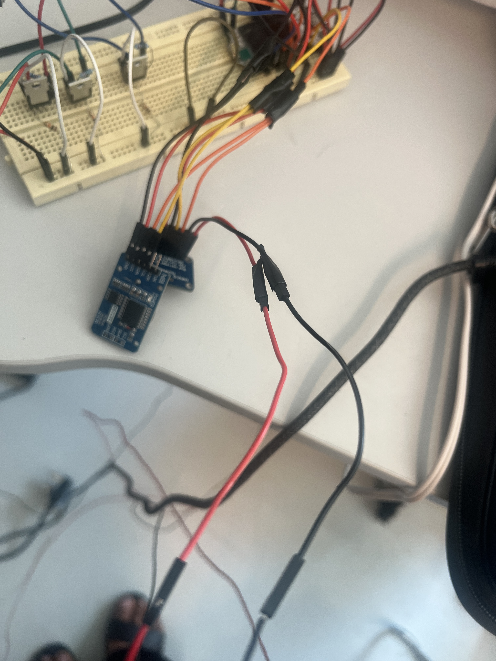
Building Phases/IMG_8380.jpeg
