Madina1219/ConnectGuinea/Building Phases/IMG_8389.jpeg

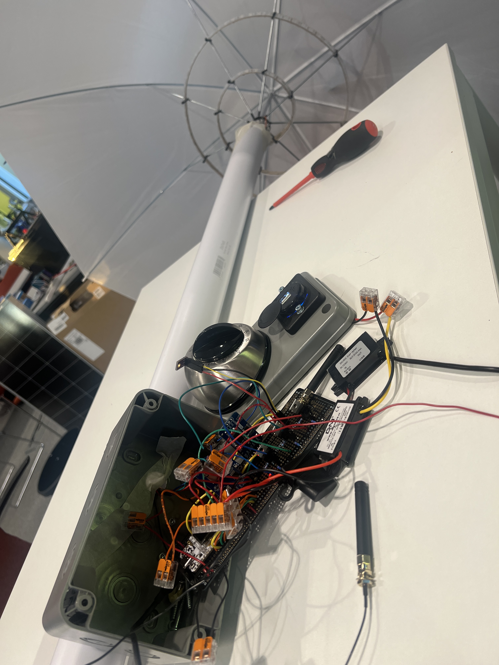
Building Phases/IMG_8389.jpeg
