Madina1219/ConnectGuinea/Building Phases/IMG_8390.jpeg

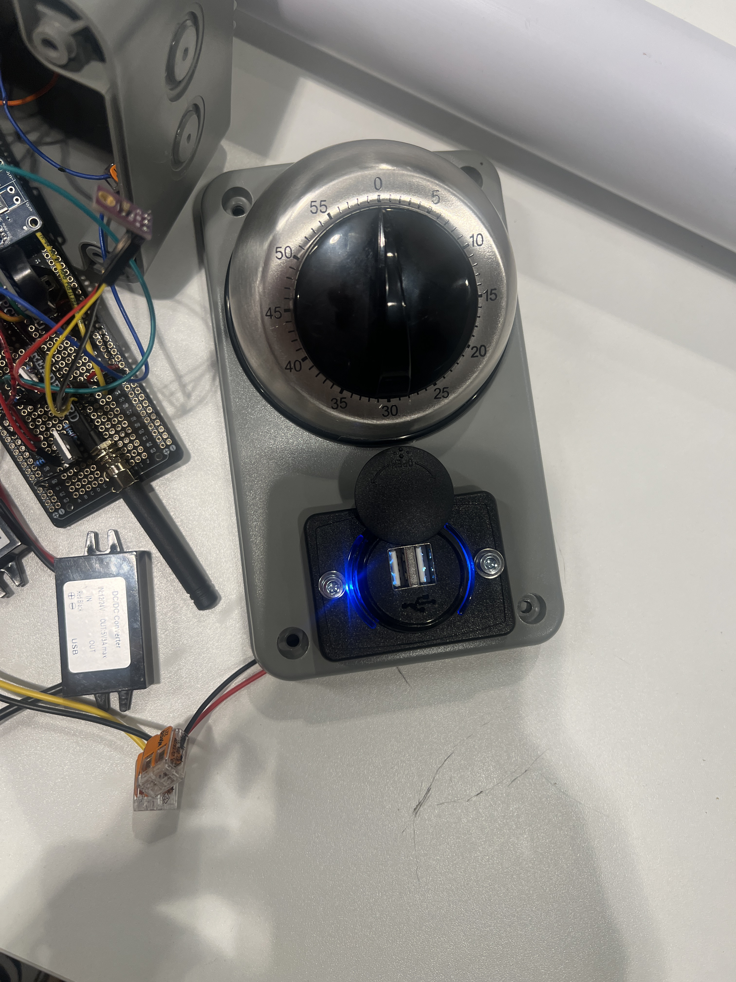
Building Phases/IMG_8390.jpeg
