Madina1219/ConnectGuinea/Totem Components/IMG_7979.jpeg

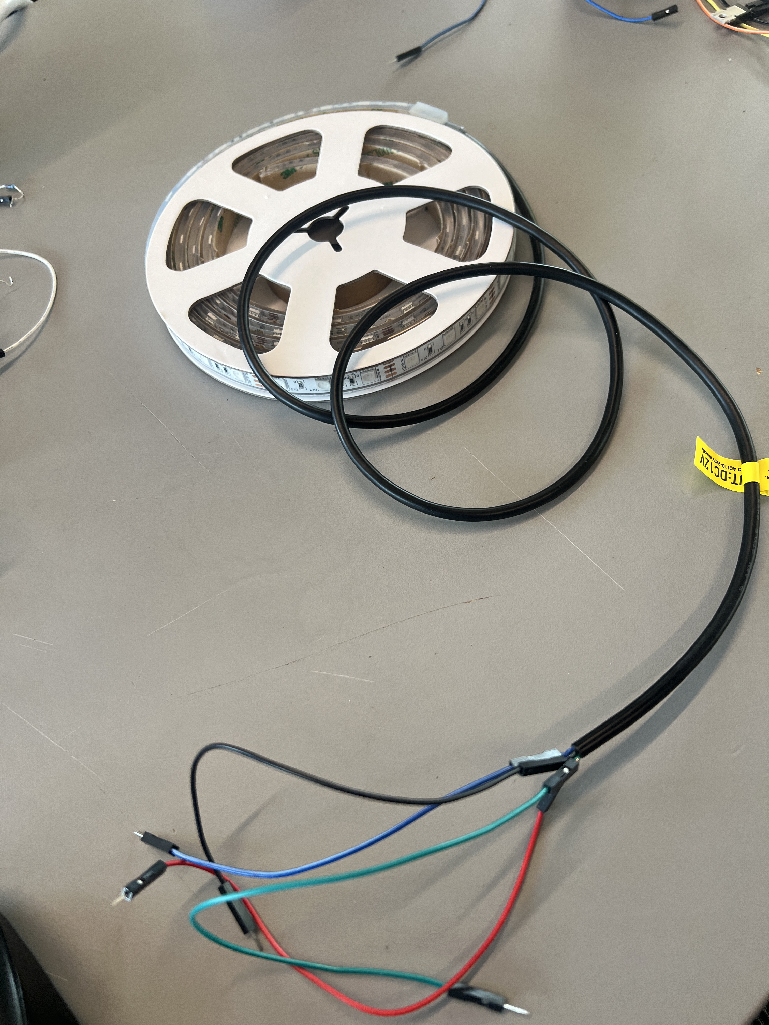
Totem Components/IMG_7979.jpeg
